duanebeck/Allegro-Lite/README.md

# Allegro-Lite
Information about Mark Drela's sailplane designs
