duanebeck/Allegro-Lite/Photos/README.md

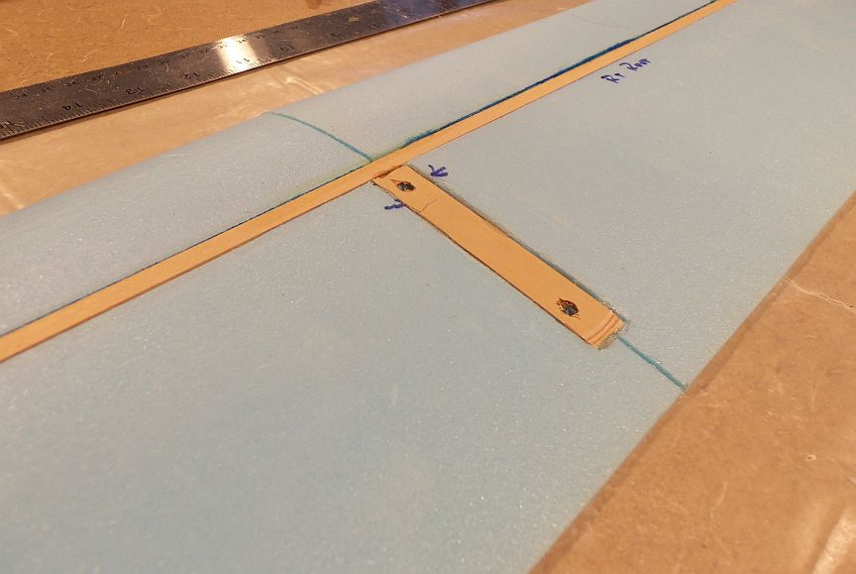
[picture p1: Photos/CENTER+HOLD+DOWN.jpg]
CENTER HOLD DOWN

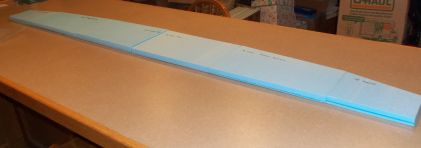
[picture p2: Photos/2MCORES.jpg]
2MCORES

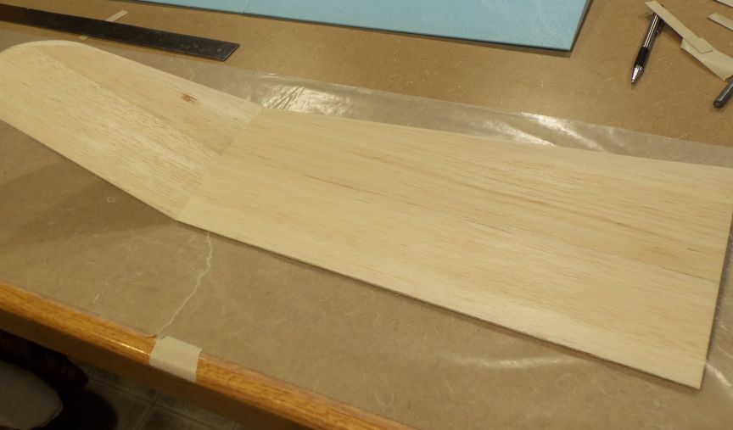
[picture p3: Photos/LEFT+MID+AND+TIP+FINISHED.jpg]
LEFT MID AND TIP FINISHED

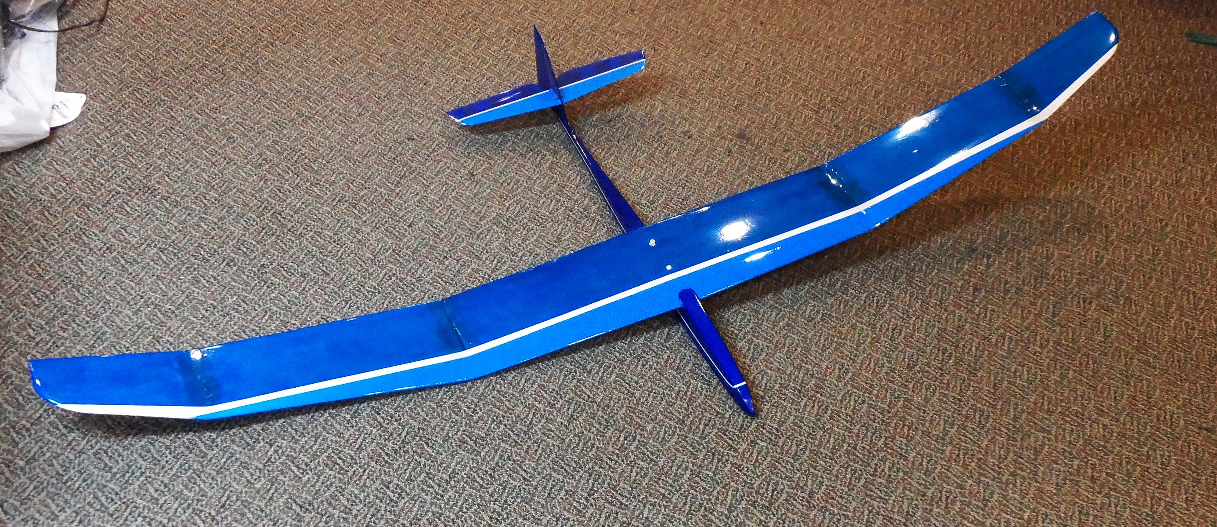
[picture p4: Photos/FINISHED+ON+AIRFRAME.jpg]
FINISHED ON AIRFRAME

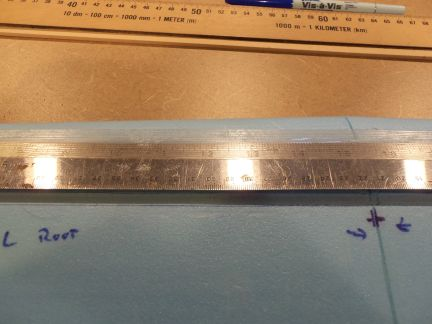
[picture p5: Photos/SPAR+SANDING+GUIDE.jpg]
SPAR SANDING GUIDE

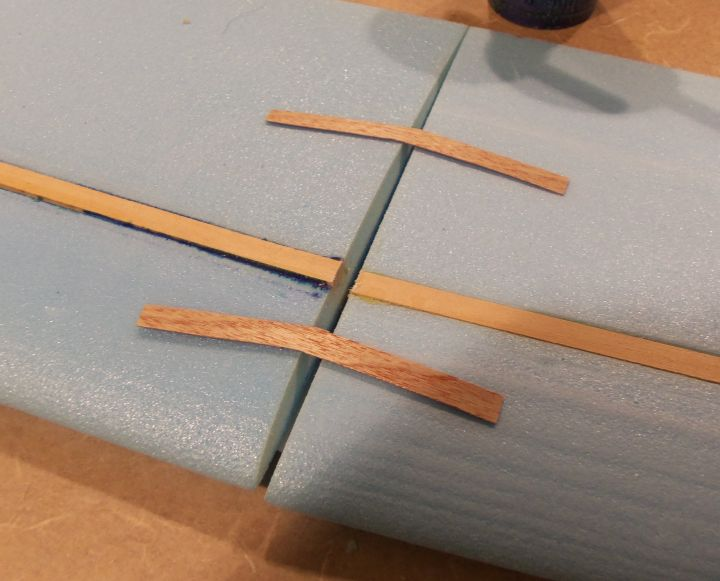
[picture p6: Photos/DIHED+BRACES.jpg]
DIHED BRACES

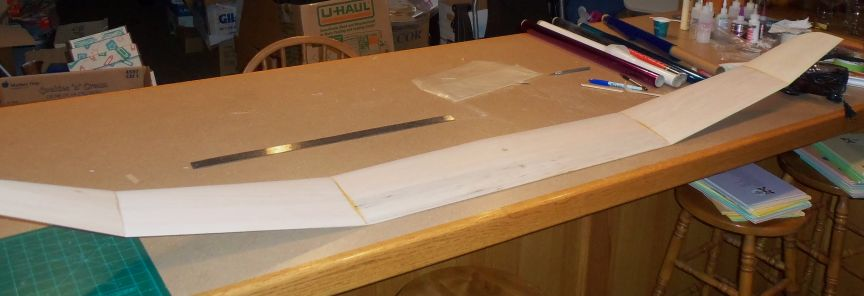
[picture p7: Photos/READY+TO+COVER.jpg]
READY TO COVER

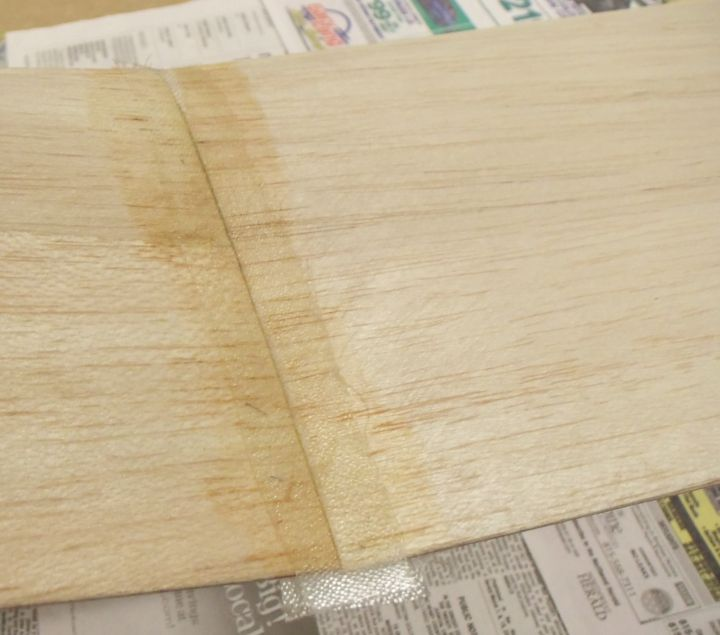
[picture p8: Photos/GLASSED+JOINT.jpg]
GLASSED JOINT

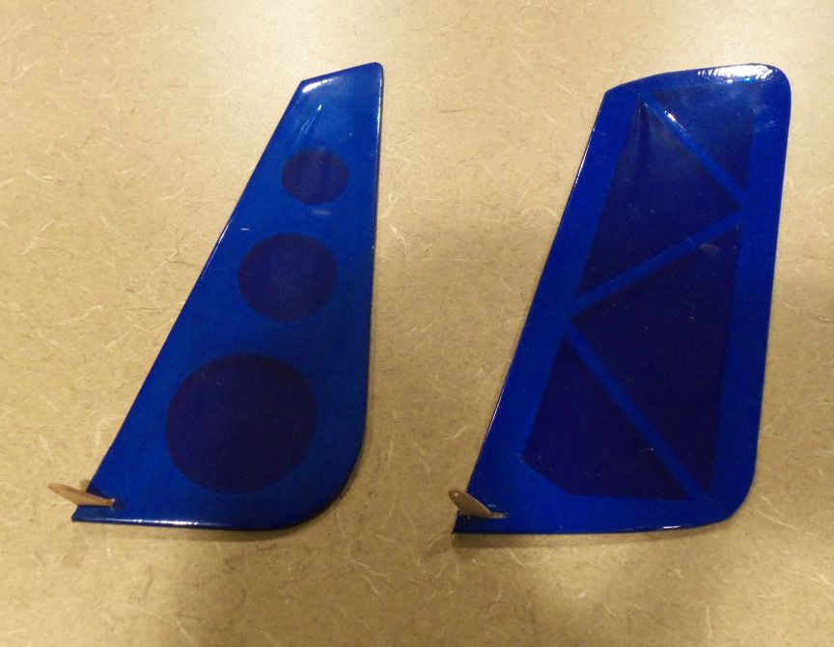
[picture p9: Photos/OLD+AND+NEW+RUDDER.jpg]
OLD AND NEW RUDDER

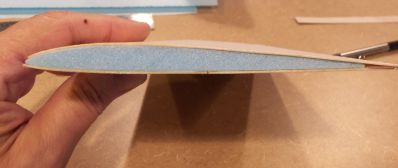
[picture p10: Photos/RT+TIP+SIDE+VIEW.jpg]
RT TIP SIDE VIEW

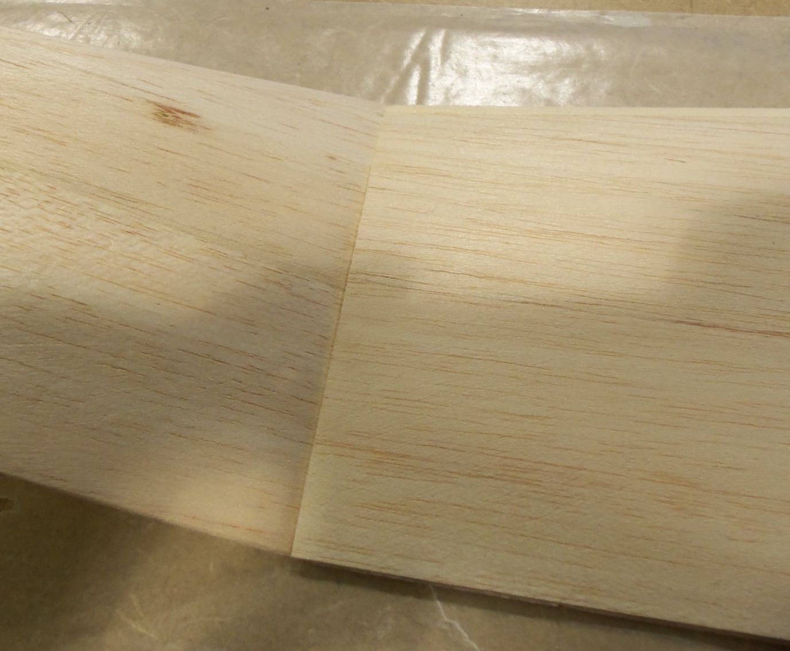
[picture p11: Photos/SANDING+DETAIL.jpg]
SANDING DETAIL

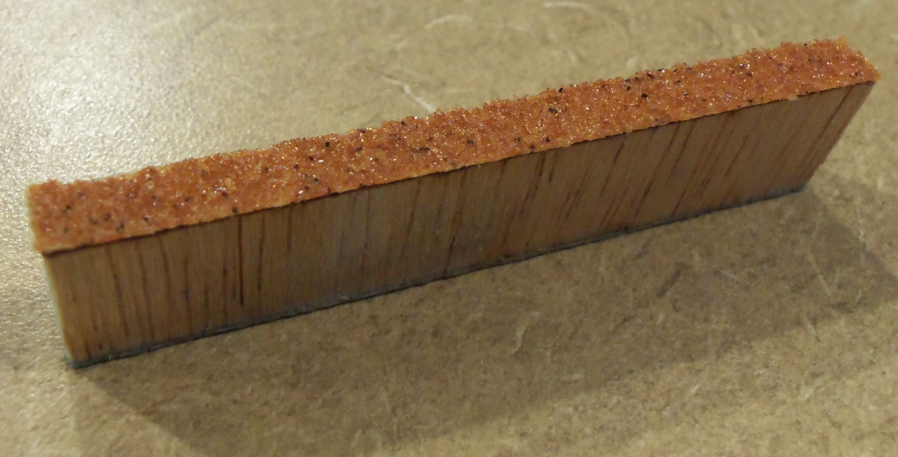
[picture p12: Photos/SLOT+SANDER.jpg]
SLOT SANDER

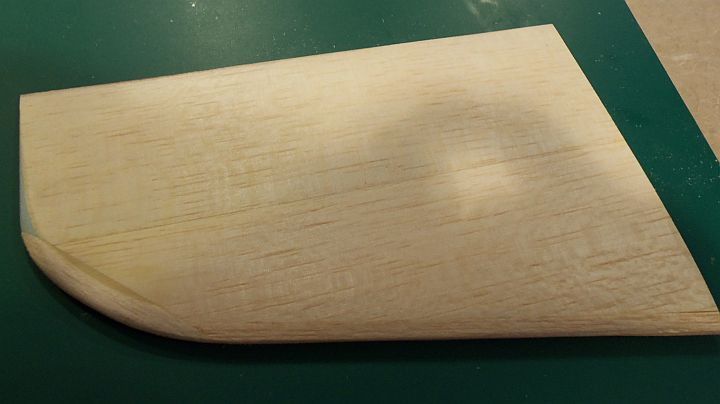
[picture p13: Photos/FINISHED+TIP.jpg]
FINISHED TIP

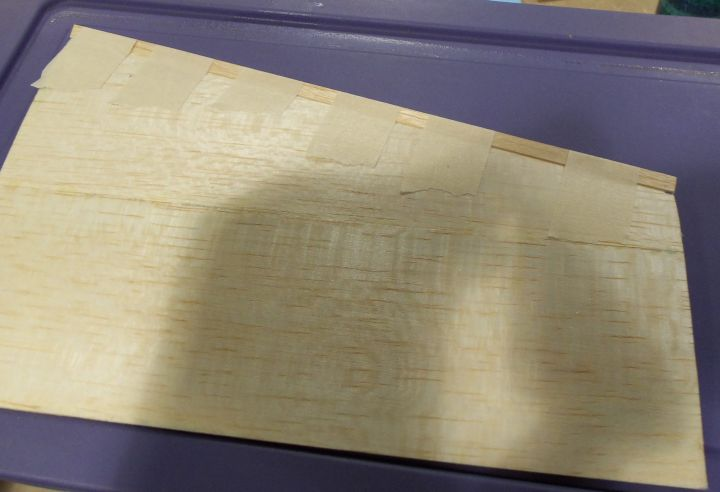
[picture p14: Photos/TIP+WITH+LE+ATTACHED.jpg]
TIP WITH LE ATTACHED

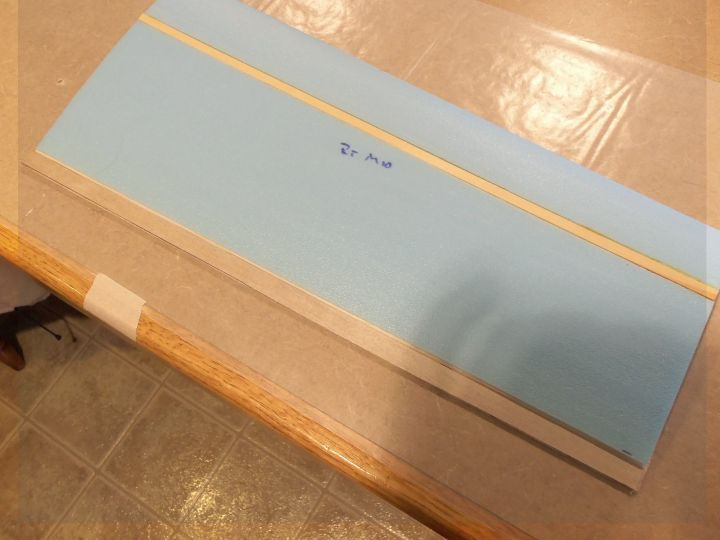
[picture p15: Photos/SPAR+AND+PLY+TE.jpg]
SPAR AND PLY TE

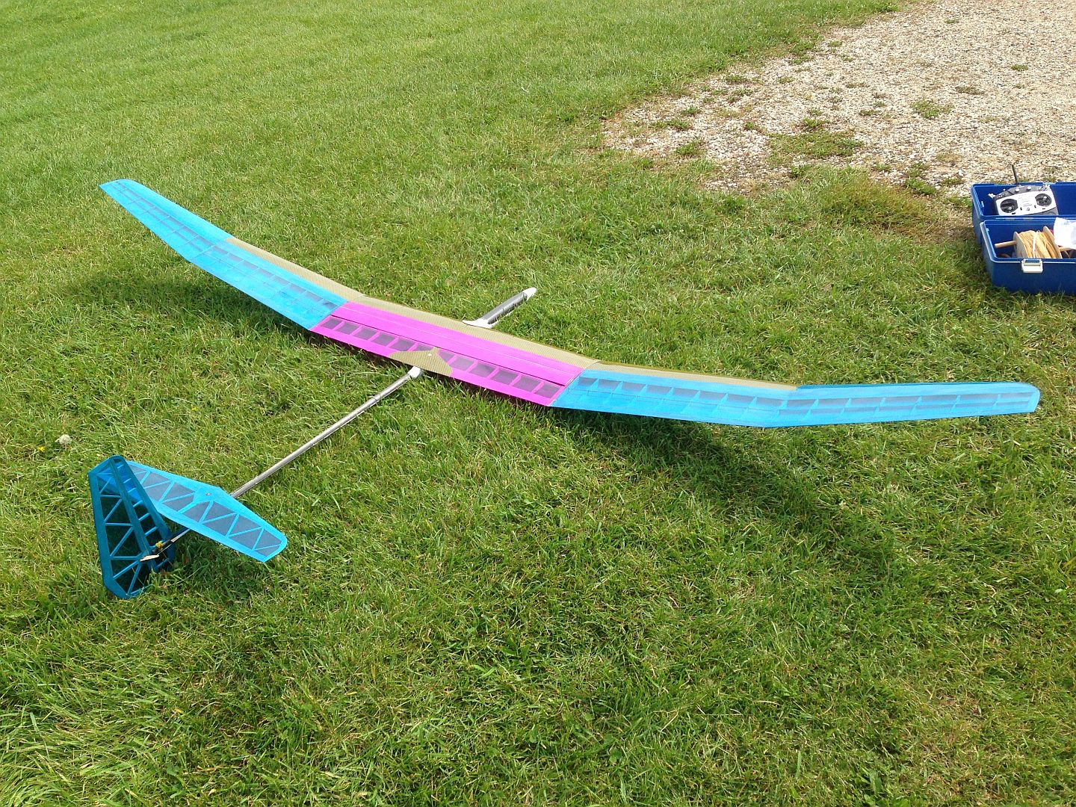
[picture p16: Photos/Bubble+Dancer.jpg]
Bubble Dancer

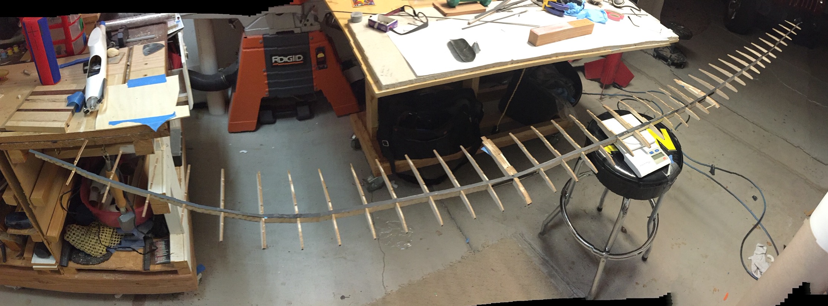
[picture p17: Photos/FullSizeRender.jpg]
FullSizeRender

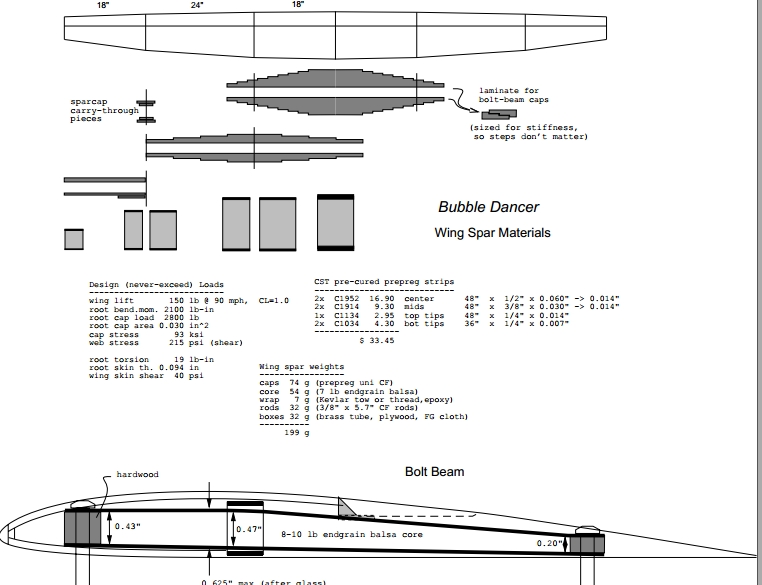
[picture p18: Photos/spars.jpg]
spars

Bubble Dancer (1)
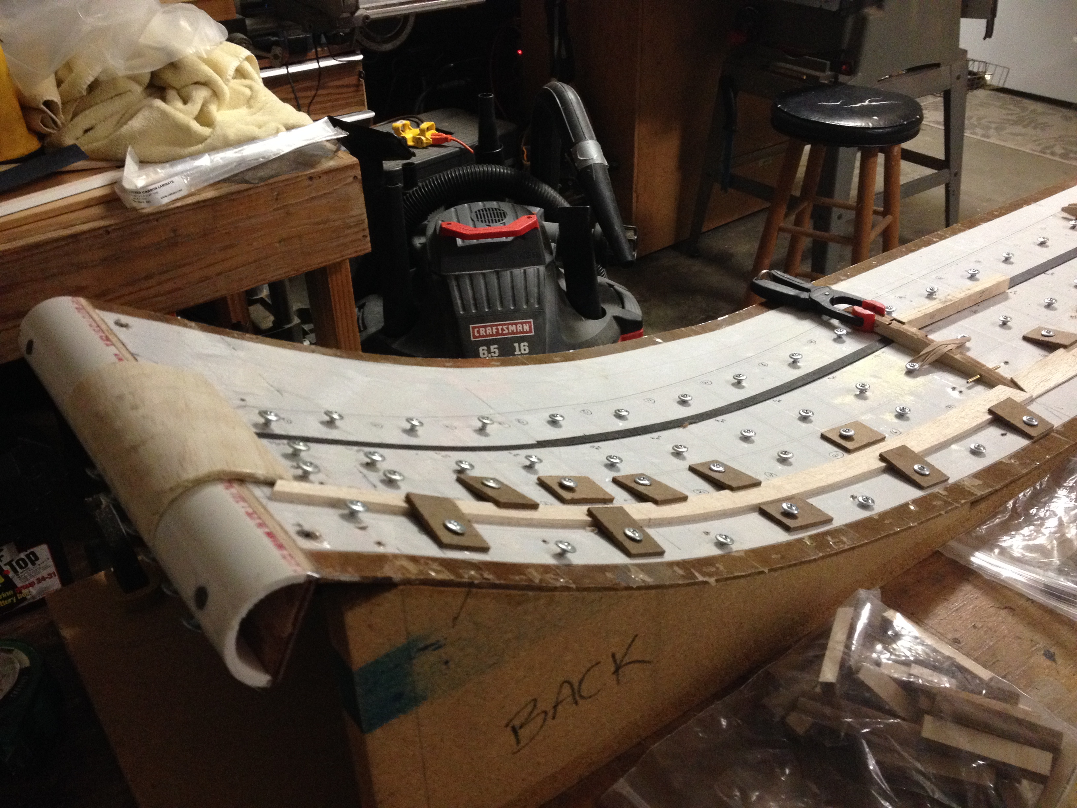
[picture p19: Photos/IMG_0997.jpg]

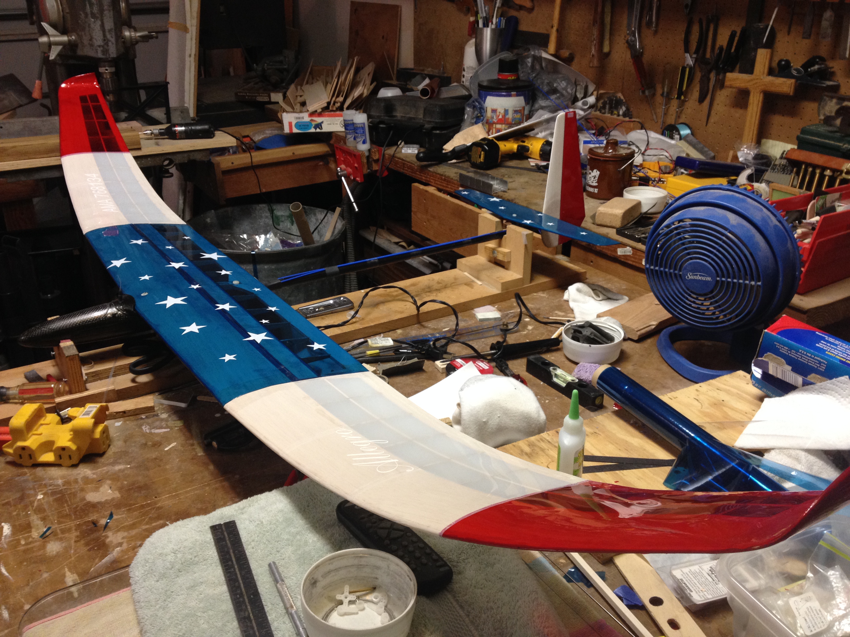
[picture p20: Photos/IMG_1051.jpg]

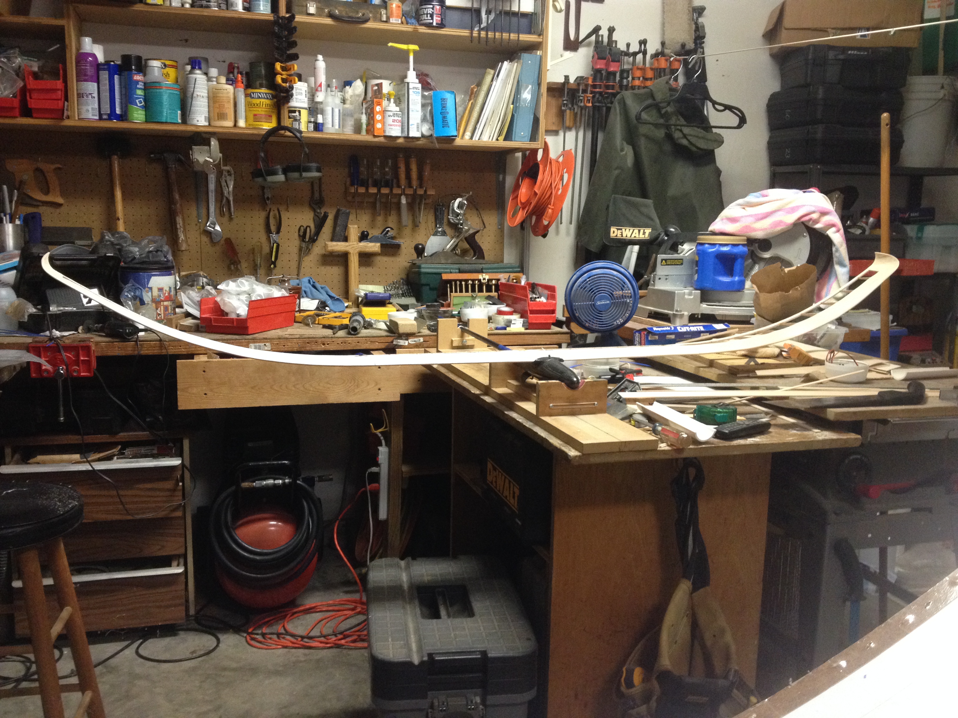
[picture p21: Photos/IMG_1042.jpg]

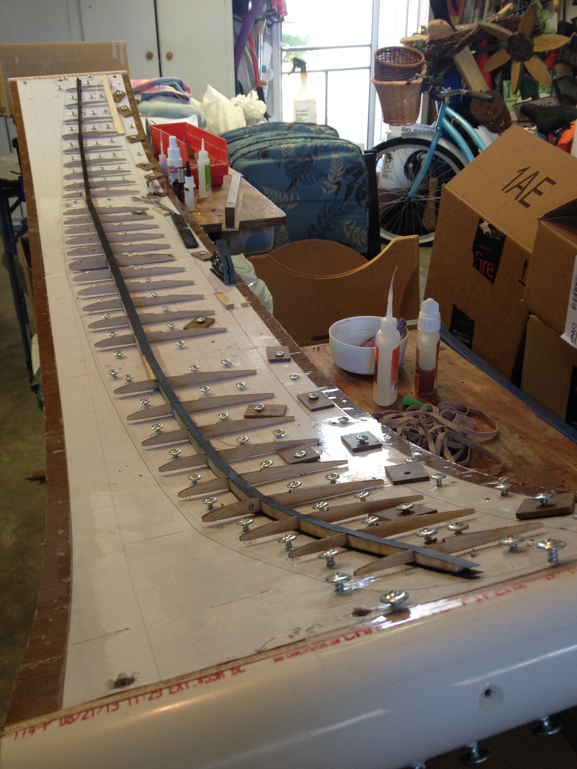
[picture p22: Photos/IMG_1009.jpg]


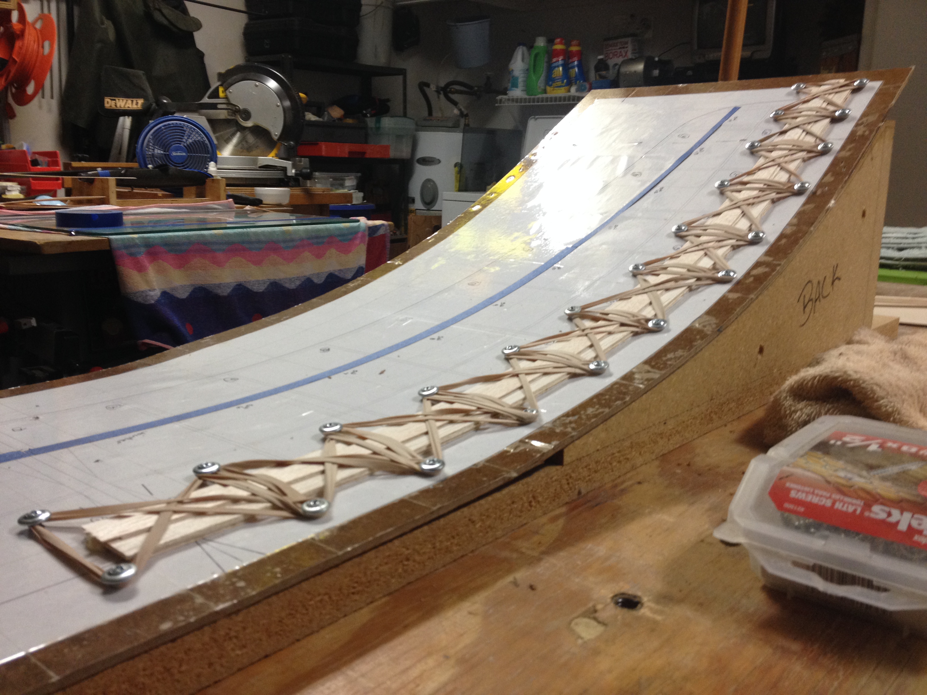
[picture p23: Photos/IMG_0994.jpg]

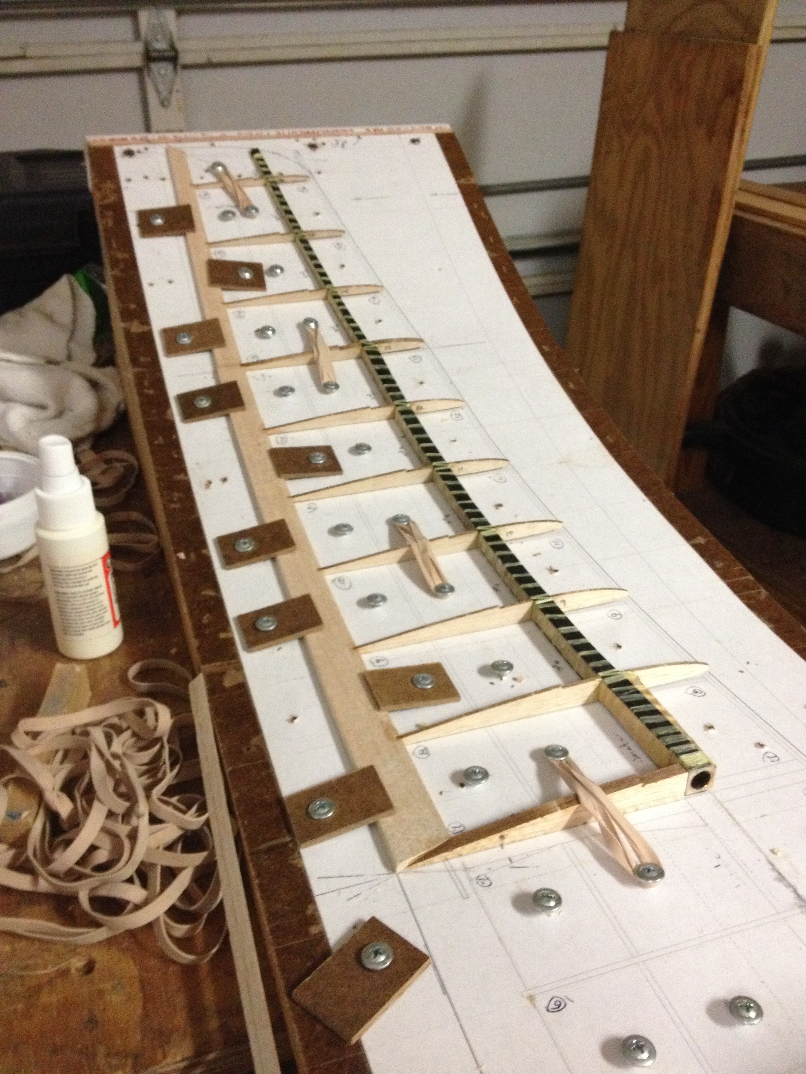
[picture p24: Photos/IMG_1021.jpg]


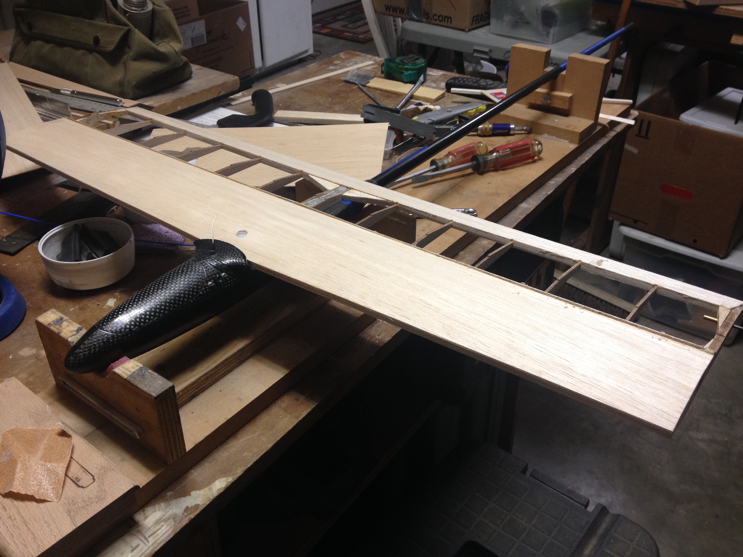
[picture p25: Photos/IMG_1037.jpg]

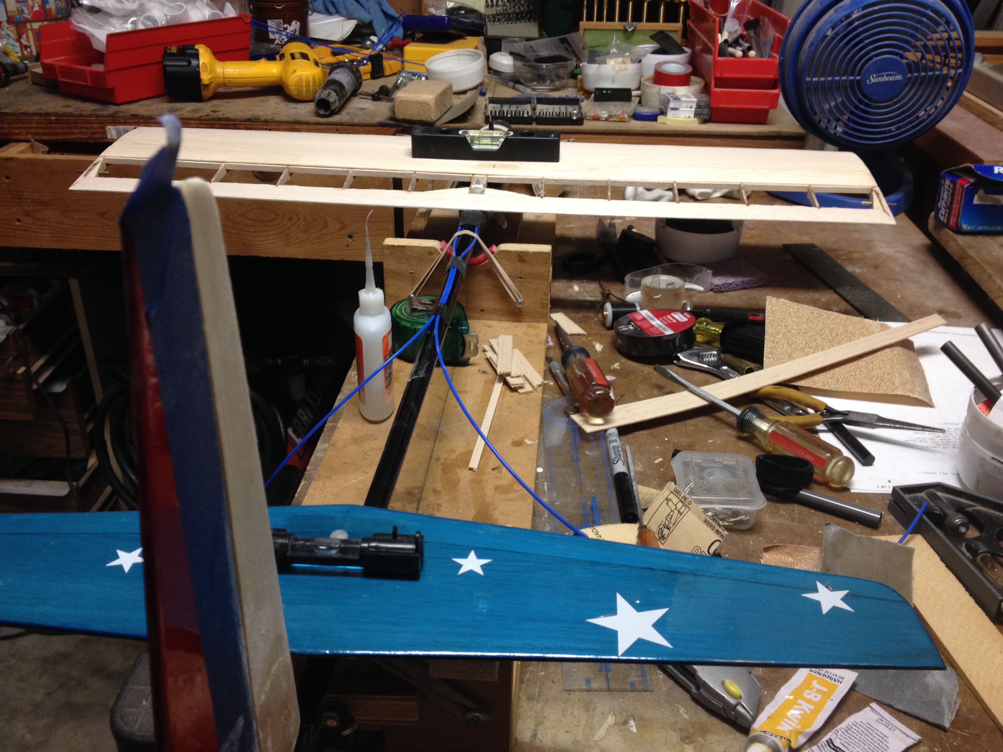
[picture p26: Photos/IMG_1045.jpg]

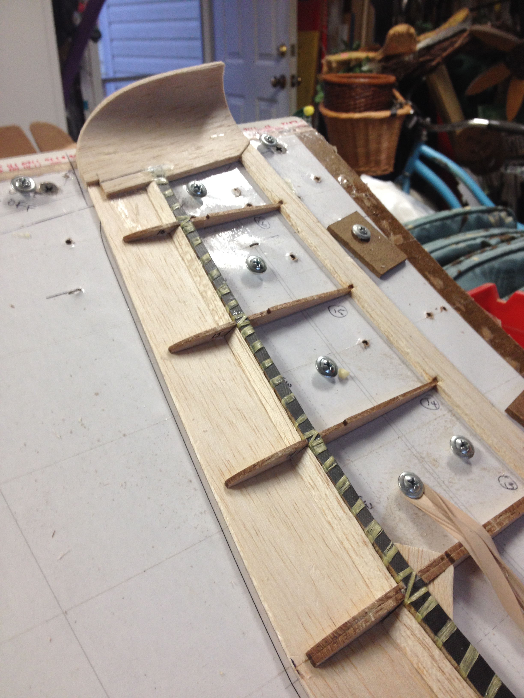
[picture p27: Photos/IMG_1035.jpg]

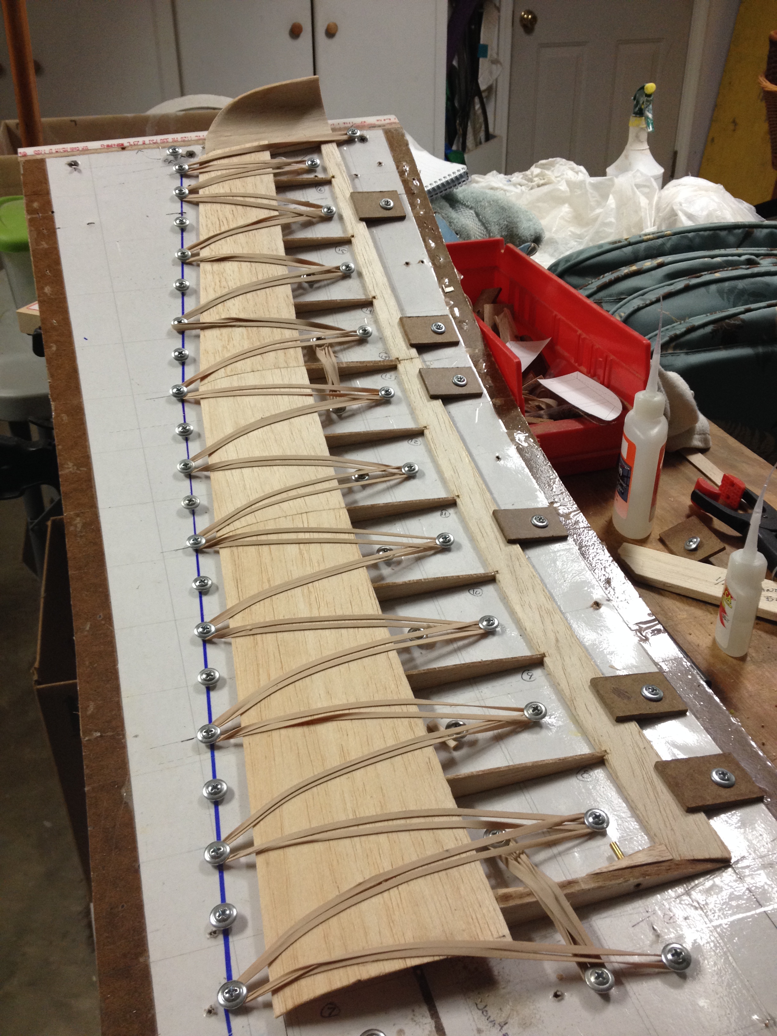
[picture p28: Photos/IMG_1036.jpg]

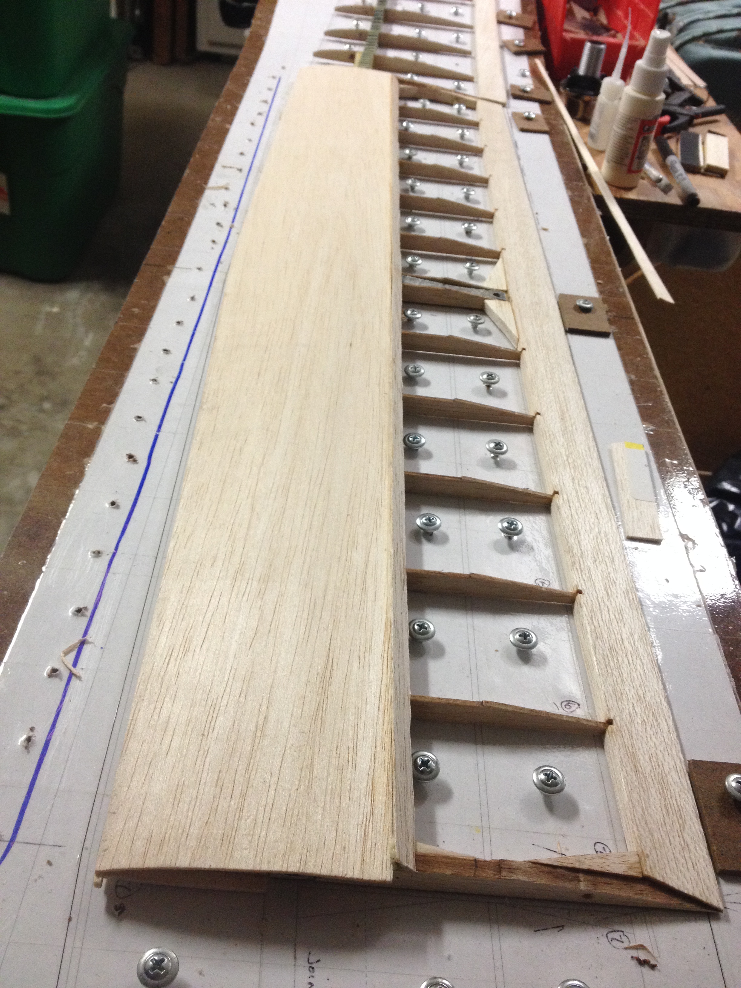
[picture p29: Photos/IMG_1018.jpg]

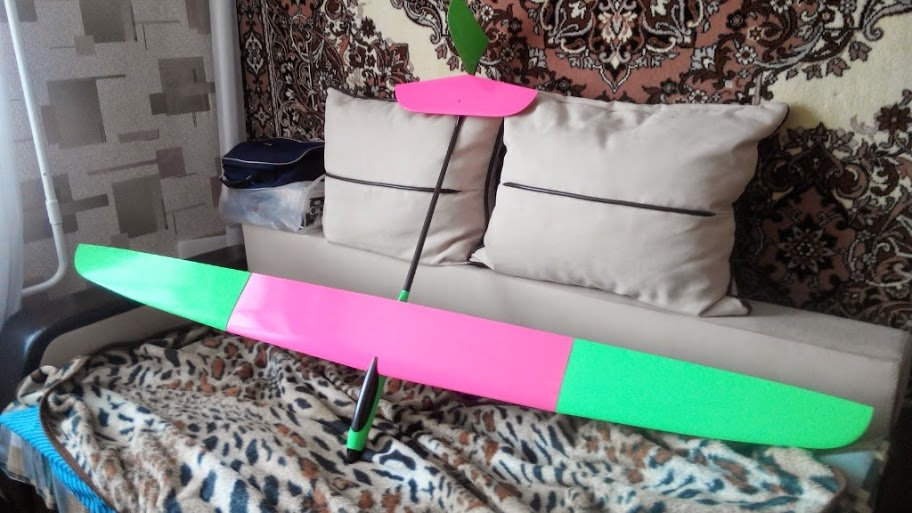
[picture p30: Photos/allegra-1.jpg]
allegra-1

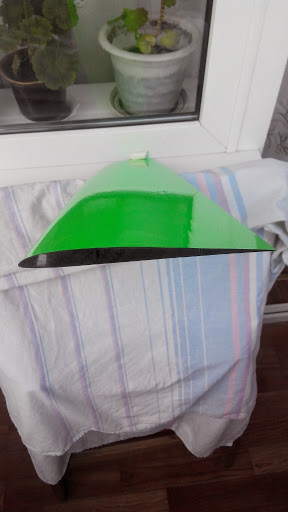
[picture p31: Photos/allegra-1+prof+ag+-41.jpg]
allegra-1 prof ag -41


DSCN2304
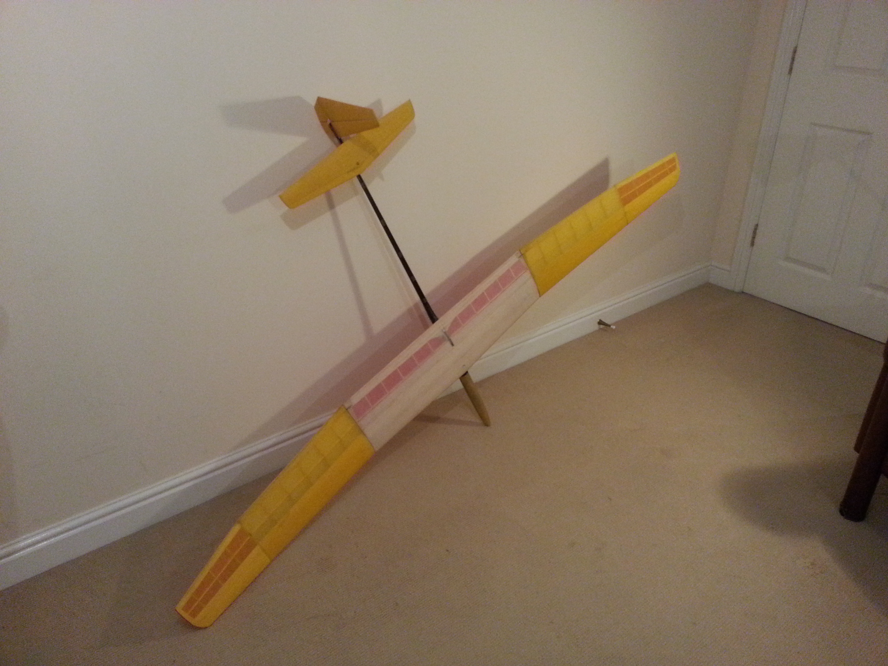
[picture p32: Photos/20140928_210820.jpg]

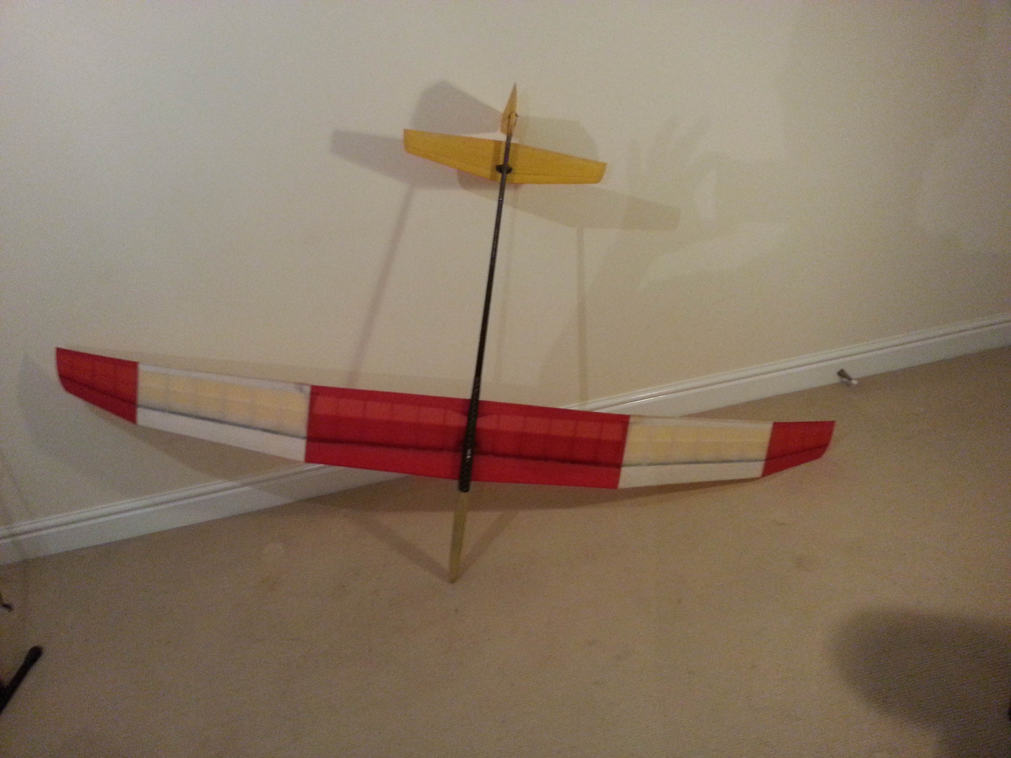
[picture p33: Photos/20140928_210901.jpg]

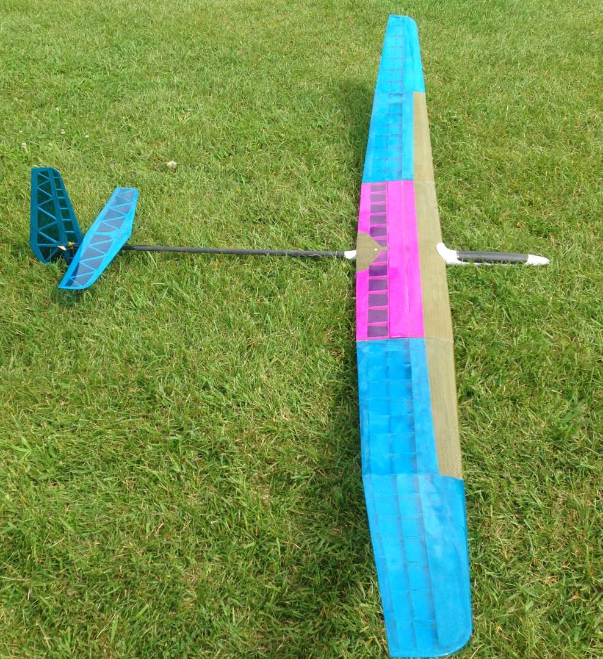
[picture p34: Photos/bd2.jpg]
bd2

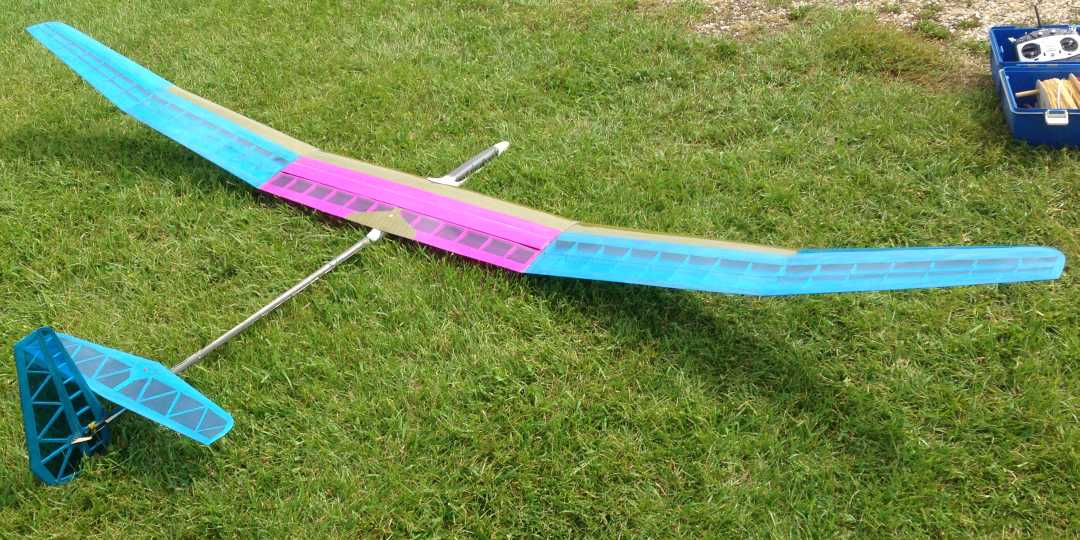
[picture p35: Photos/bd3.jpg]
bd3

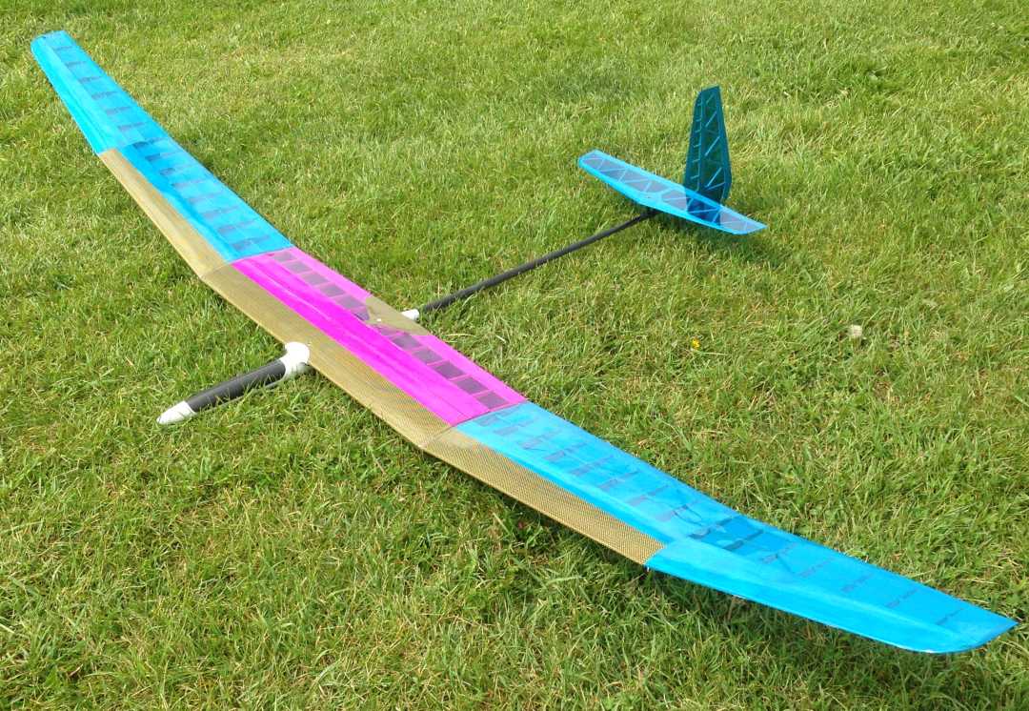
[picture p36: Photos/bd5.jpg]
bd5

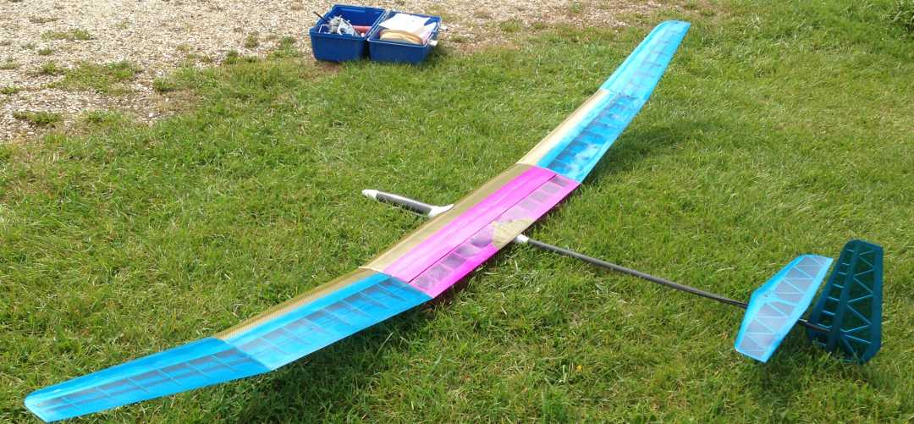
[picture p37: Photos/bd4.jpg]
bd4

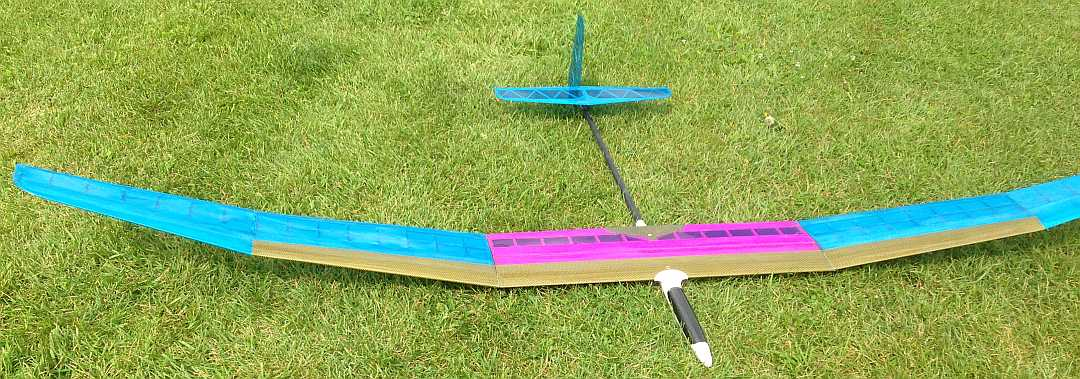
[picture p38: Photos/bd1.jpg]
bd1

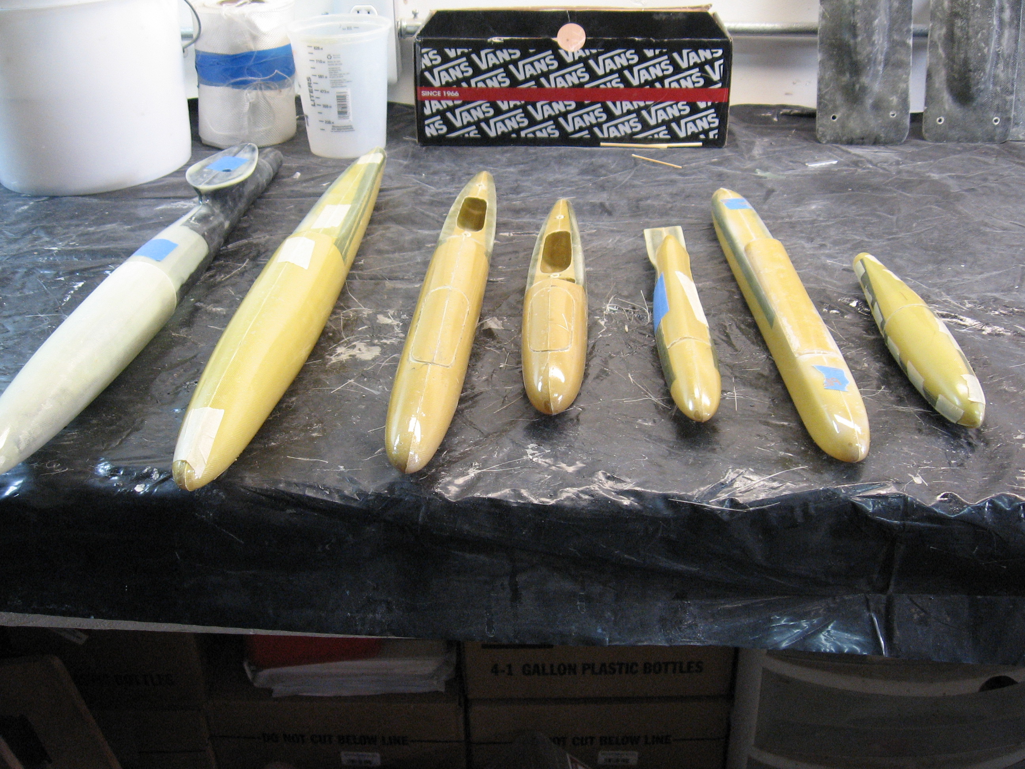
[picture p39: Photos/glider+pods+072+(2).jpg]
glider pods 072 (2)

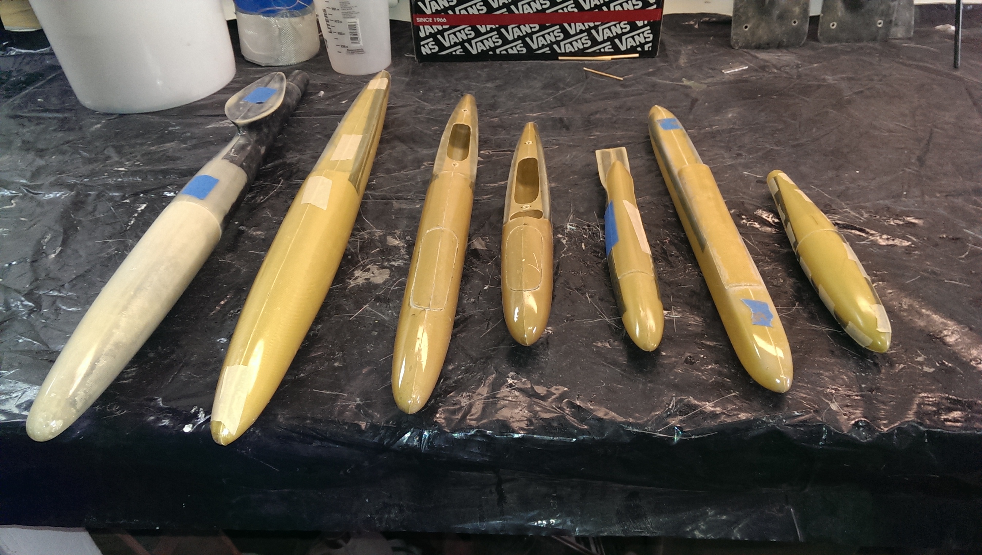
[picture p40: Photos/unknown.jpg]
unknown

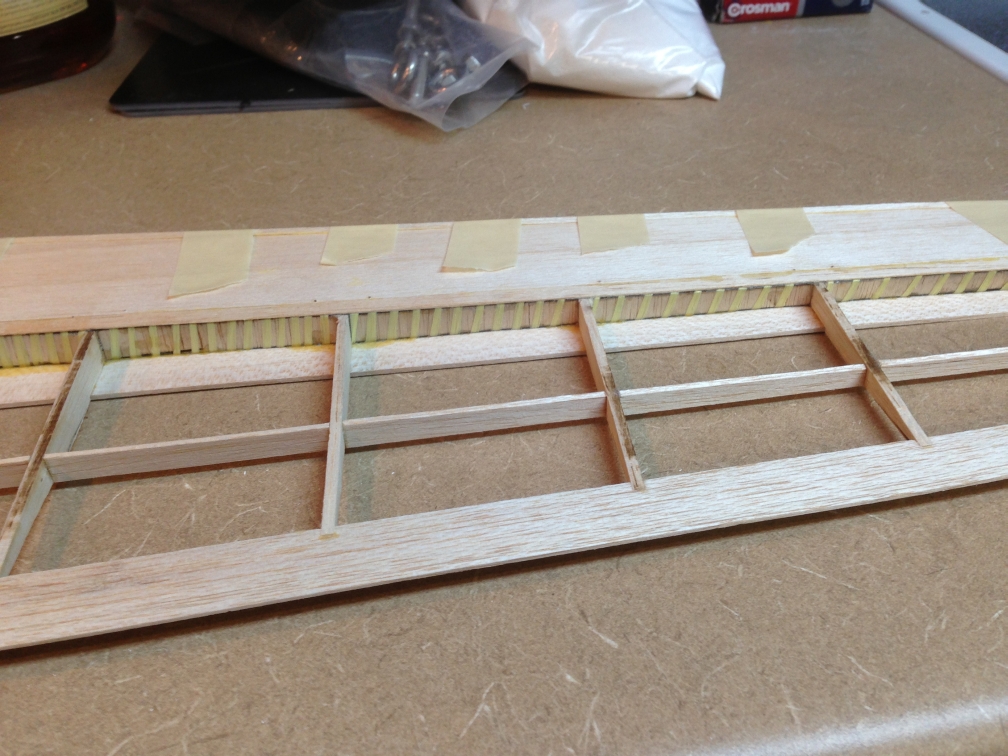
[picture p41: Photos/BD+TIP+FIN+UNDERSIDE.jpg]
BD TIP FIN UNDERSIDE

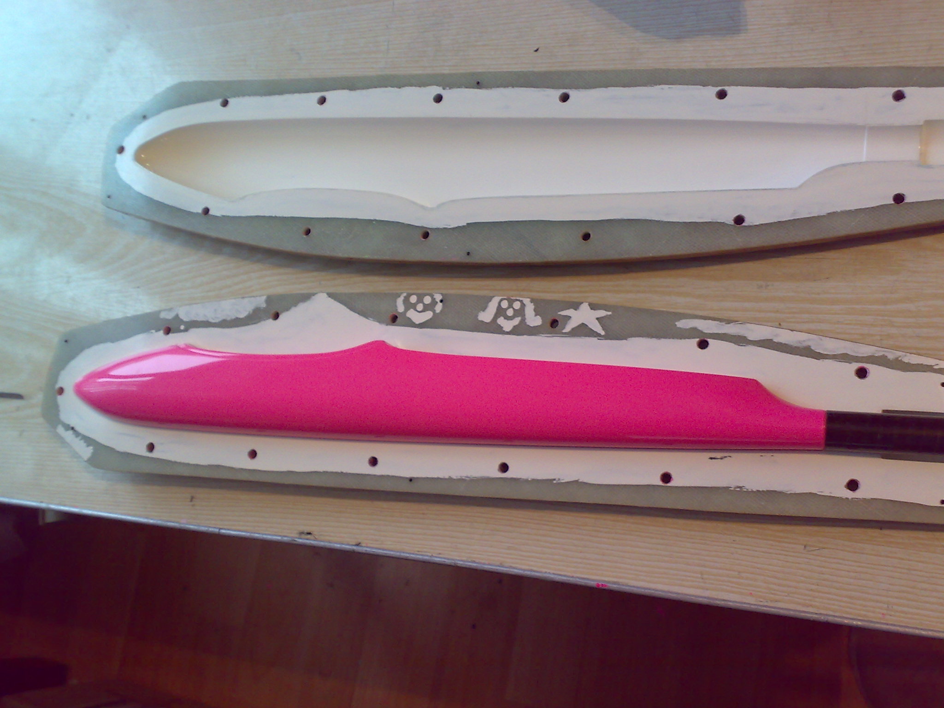
[picture p42: Photos/301220131392.jpg]

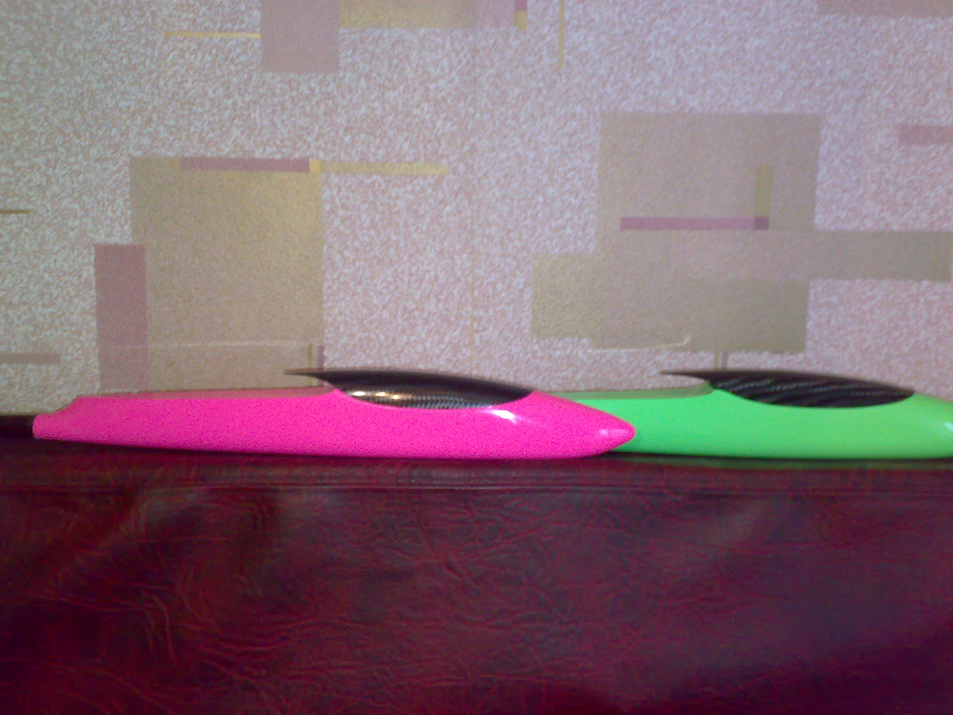
[picture p43: Photos/301220131389.jpg]

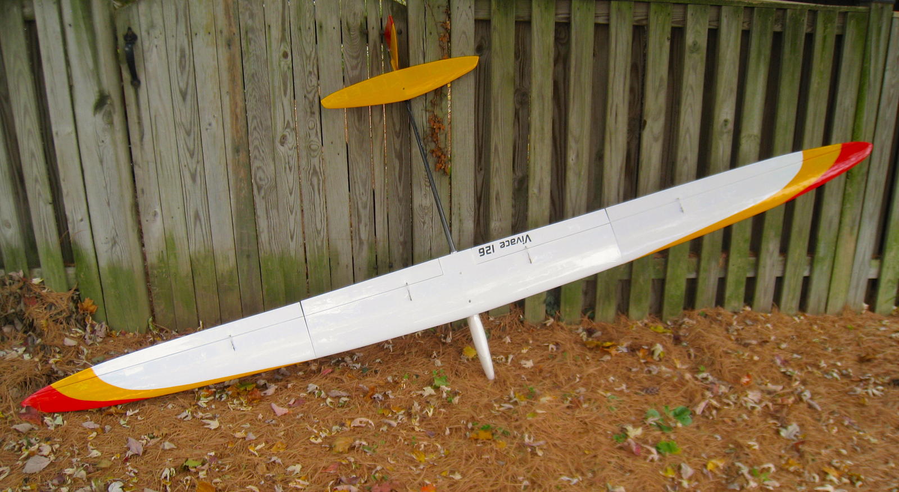
[picture p44: Photos/a6264289-44-a6261991-101-IMG_3870.jpg]
a6264289-44-a6261991-101-IMG_3870

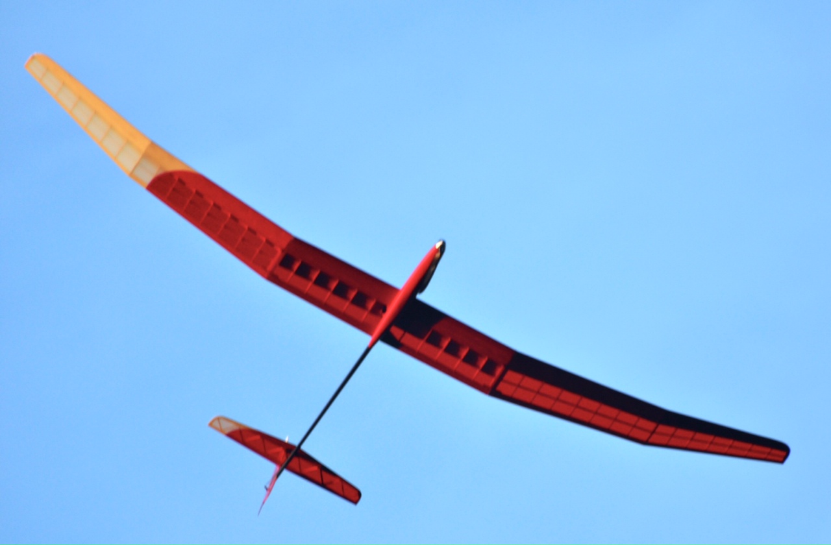
[picture p45: Photos/photo.jpg]

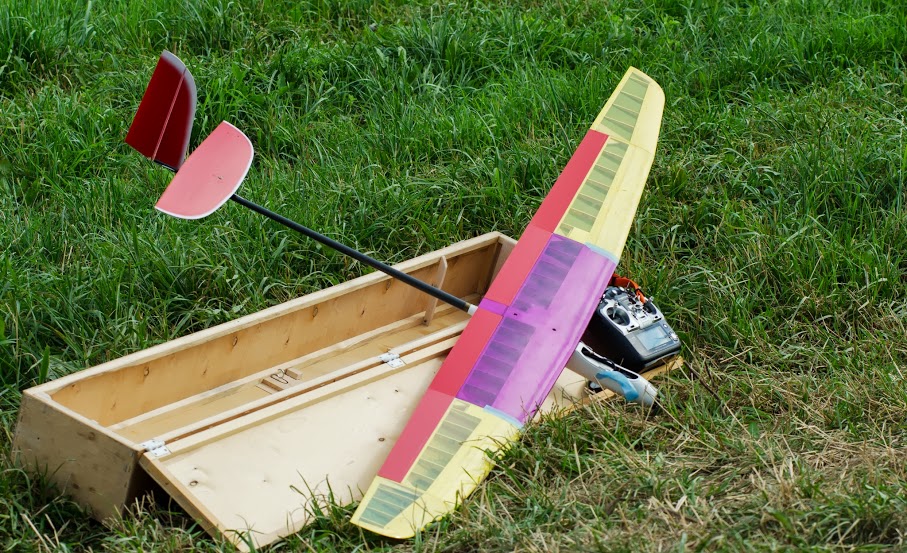
[picture p46: Photos/ART_2615.jpg]
ART_2615

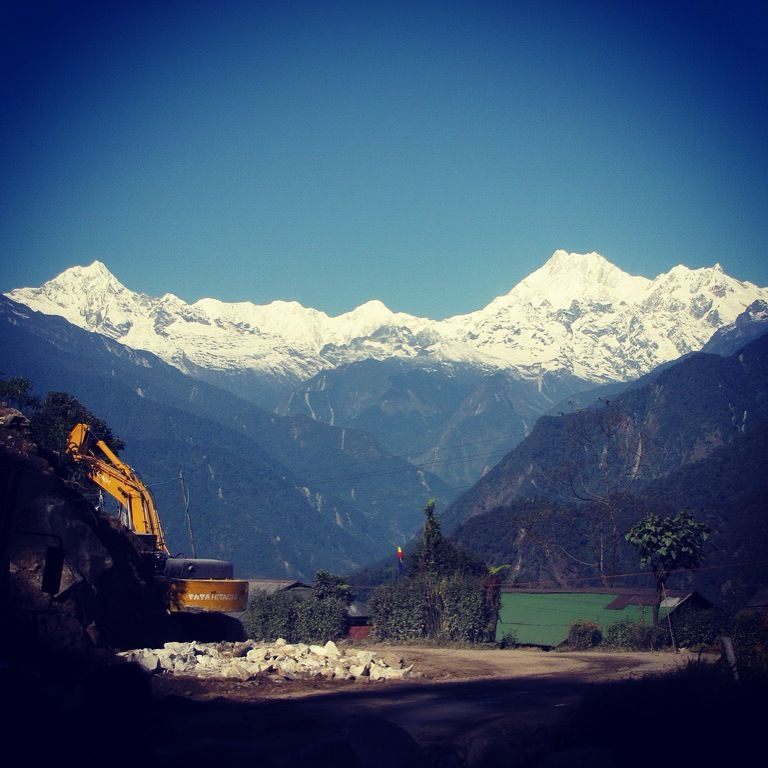
[picture p47: Photos/K3+IMG_0061.jpg]
K3 IMG_0061

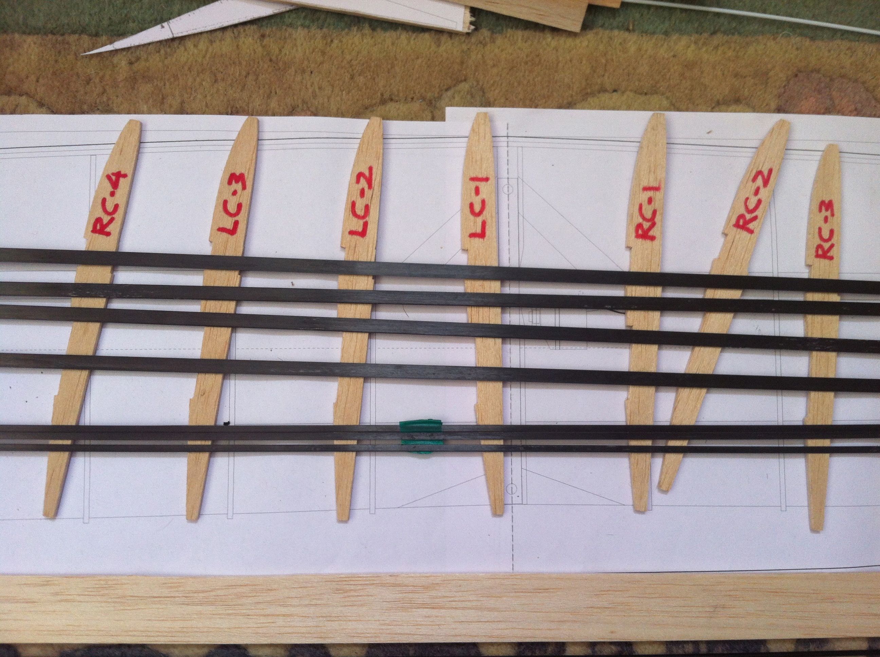
[picture p48: Photos/IMG_0073.jpg]

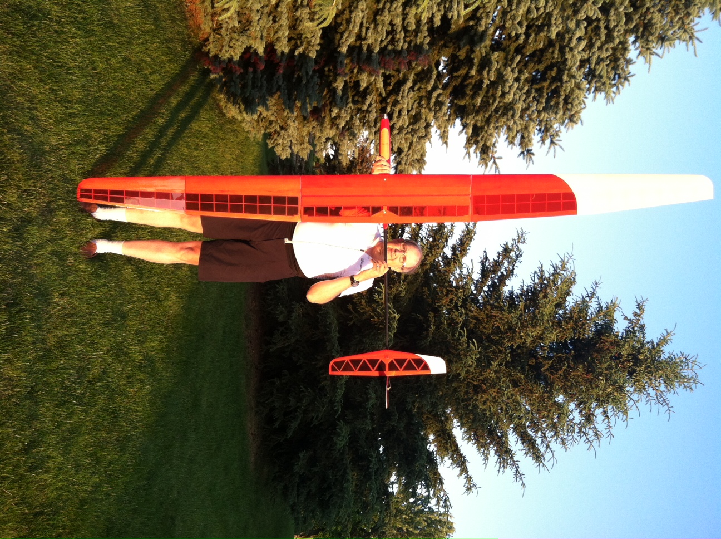
[picture p49: Photos/photo (1).jpg]
photo (1)

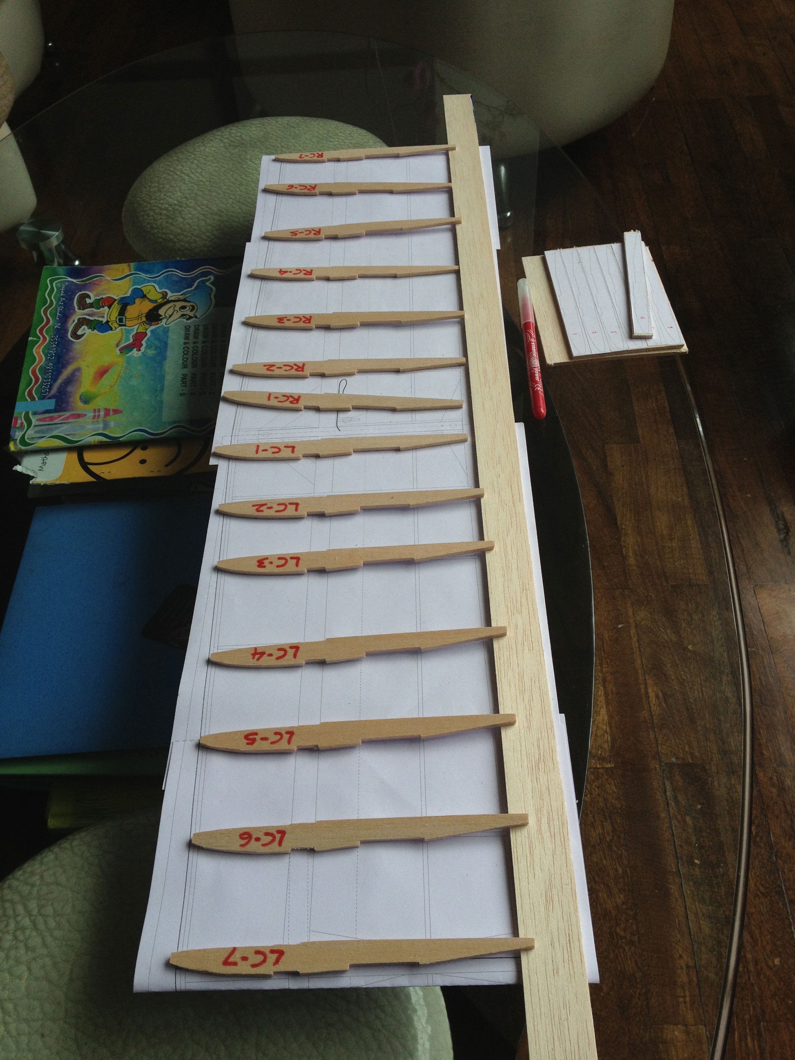
[picture p50: Photos/IMG_1146.jpg]

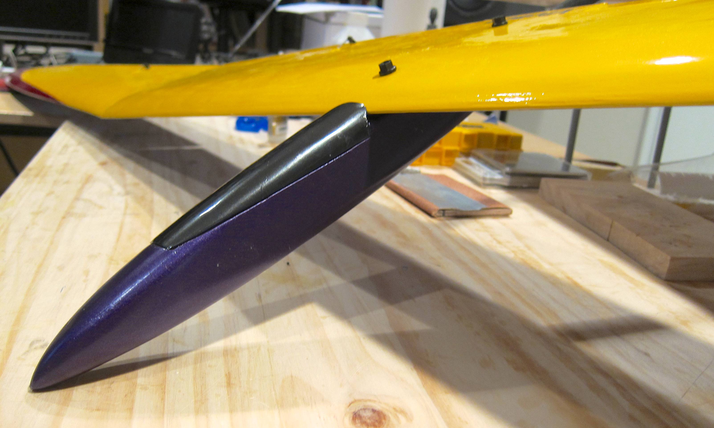
[picture p51: Photos/IMG_2610.jpg]

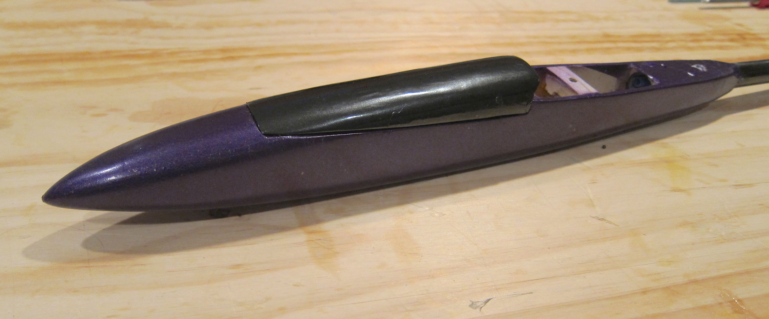
[picture p52: Photos/IMG_2616.jpg]

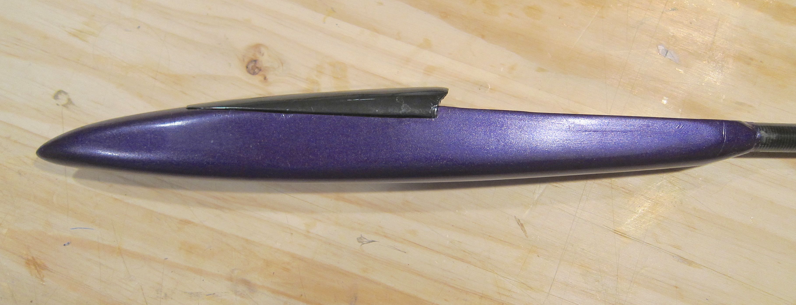
[picture p53: Photos/IMG_2617.jpg]


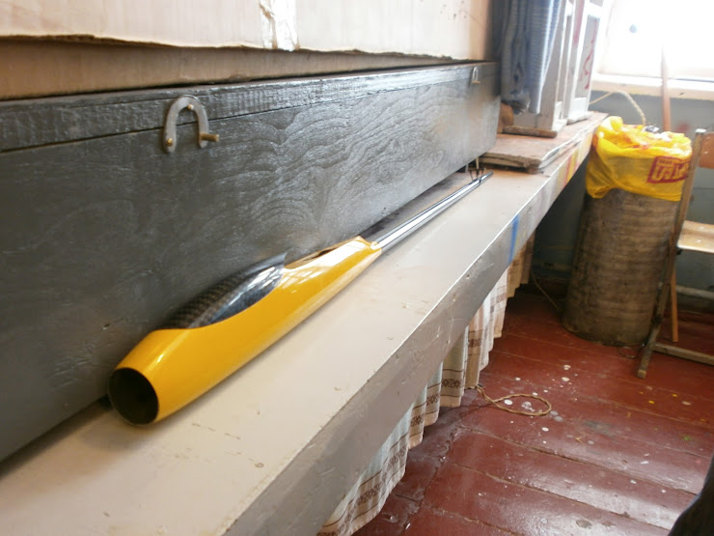
[picture p54: Photos/P2250832.jpg]
P2250832

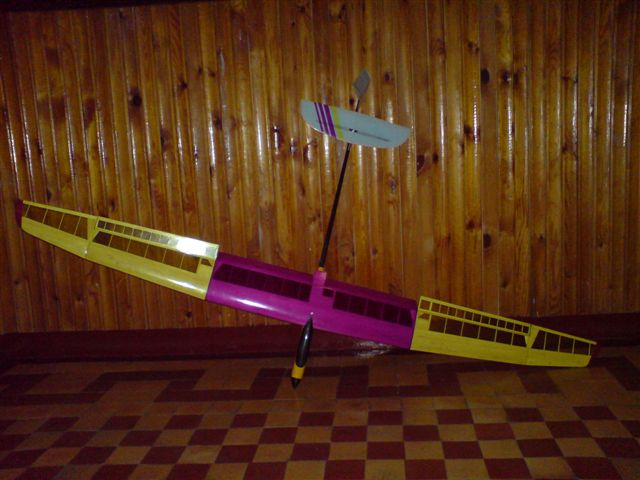
[picture p55: Photos/DSC00961.jpg]

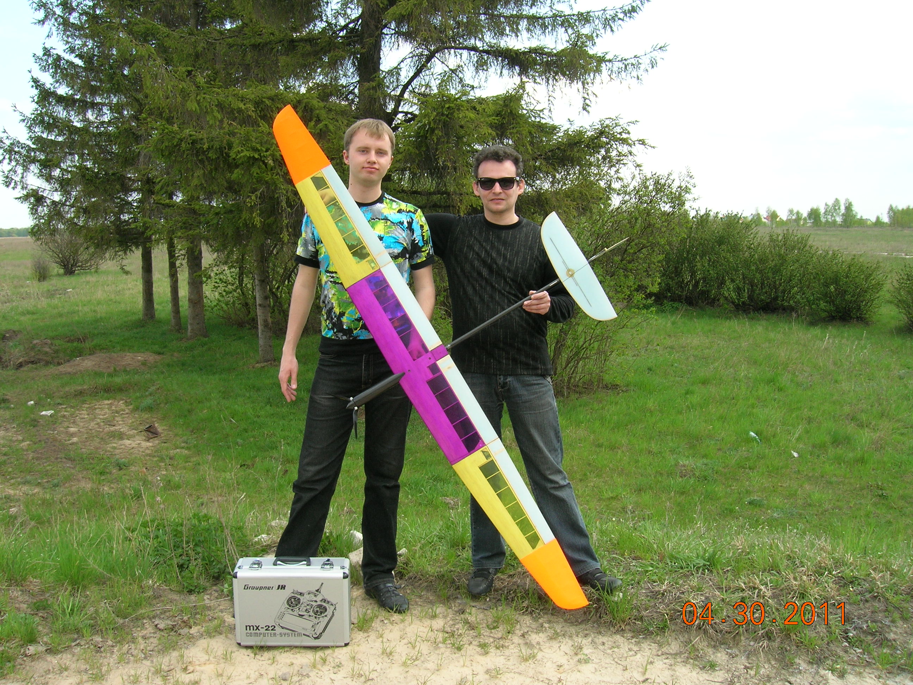
[picture p56: Photos/DSCN4541.jpg]
DSCN4541

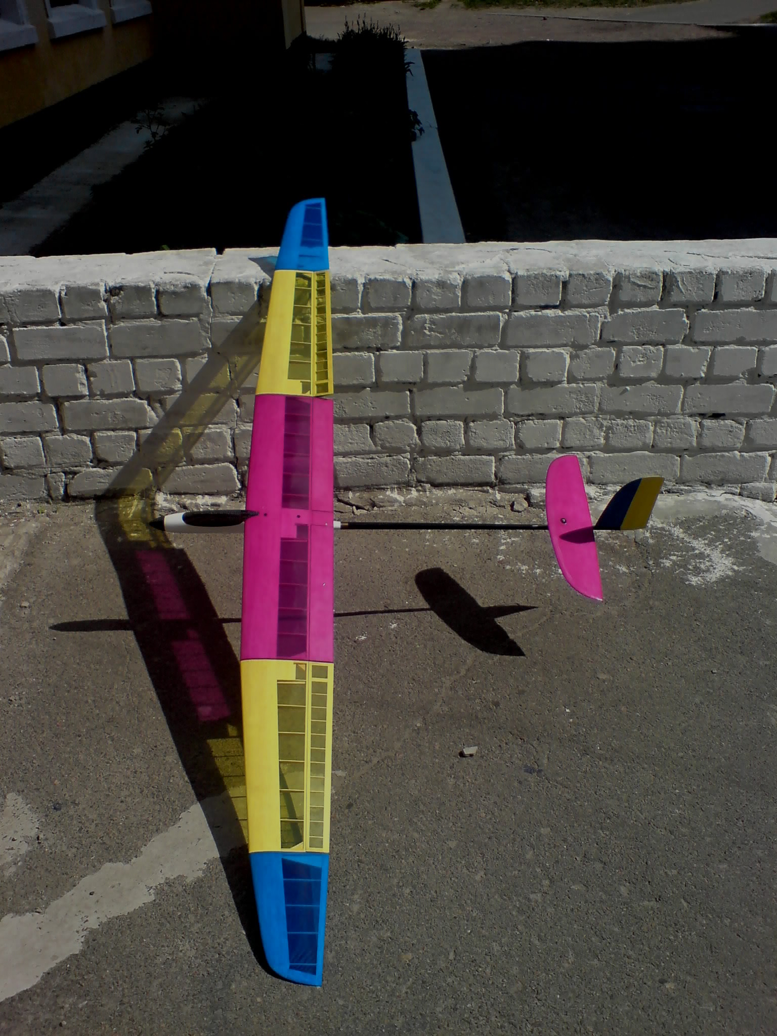
[picture p57: Photos/DSC00795-001.jpg]

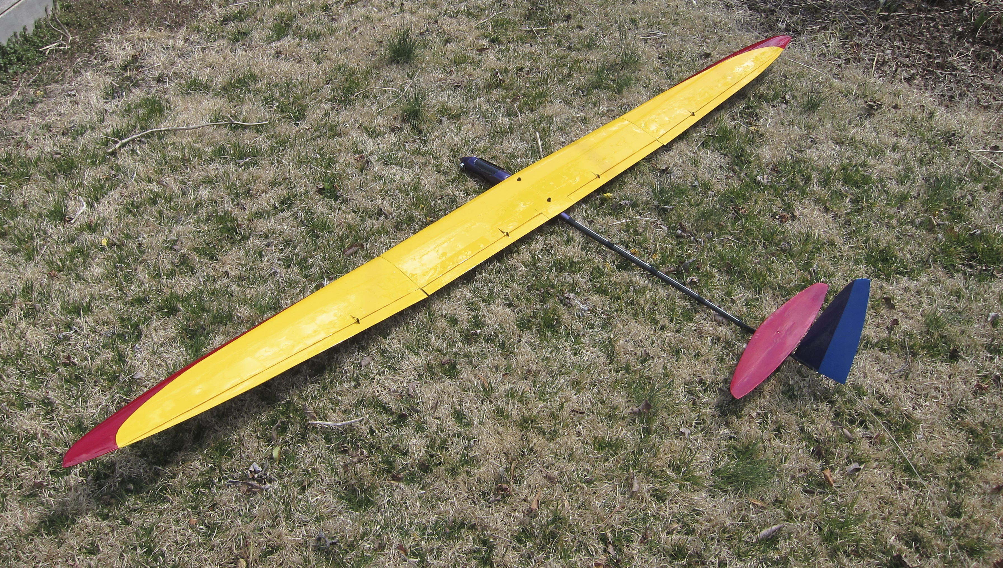
[picture p58: Photos/IMG_2414.jpg]

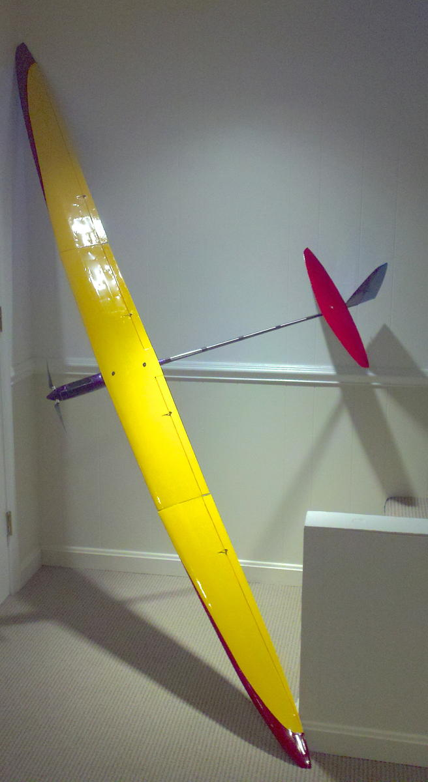
[picture p59: Photos/a5650586-134-2013-03-27_17-54-45_563.jpg]
a5650586-134-2013-03-27_17-54-45_563

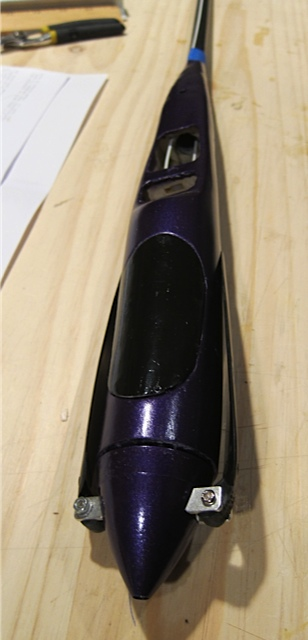
[picture p60: Photos/IMG_2396.jpg]

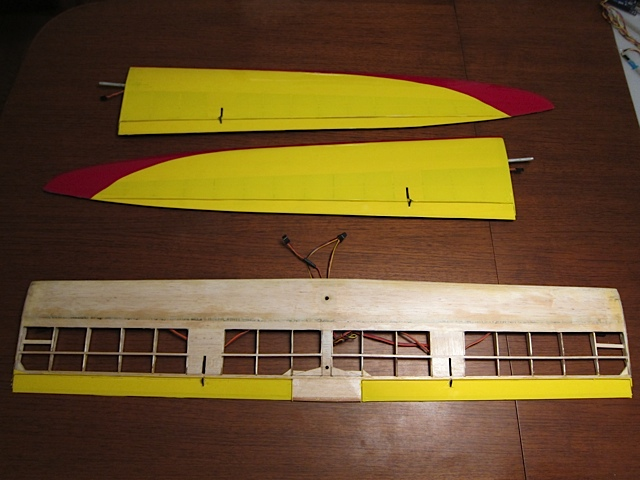
[picture p61: Photos/IMG_2400.jpg]

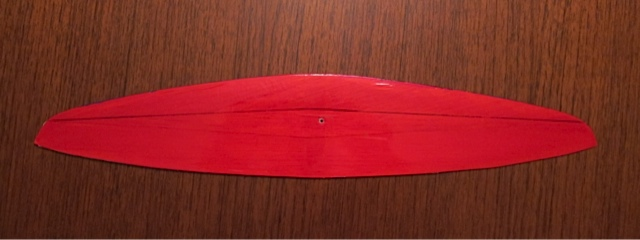
[picture p62: Photos/IMG_2399.jpg]

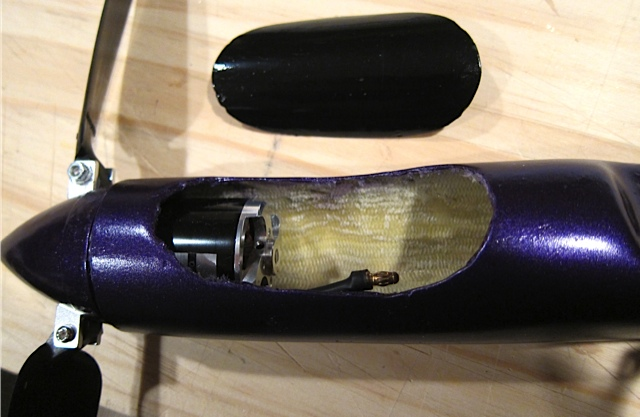
[picture p63: Photos/IMG_2393.jpg]

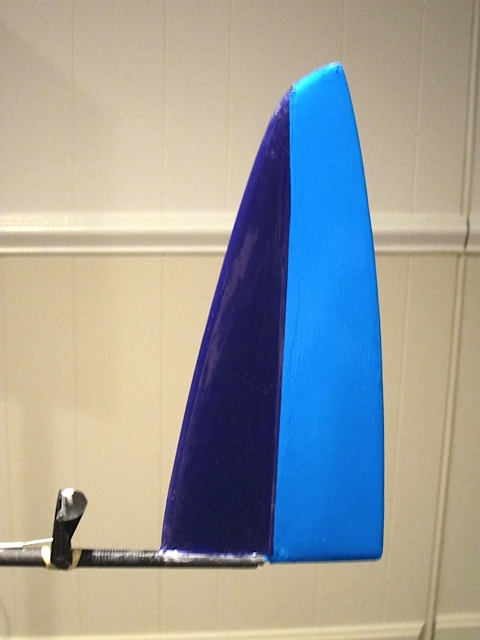
[picture p64: Photos/IMG_2398.jpg]

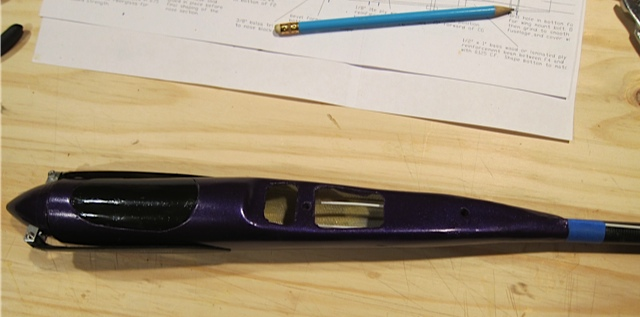
[picture p65: Photos/IMG_2394.jpg]

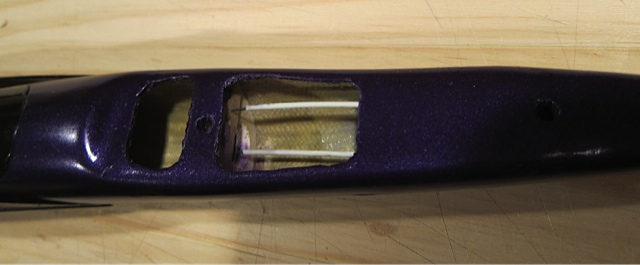
[picture p66: Photos/IMG_2395.jpg]

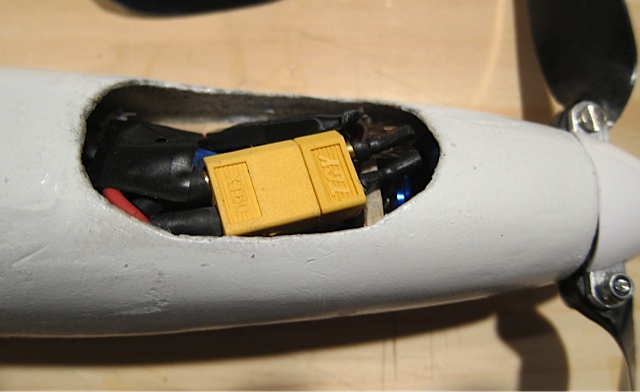
[picture p67: Photos/IMG_2388.jpg]

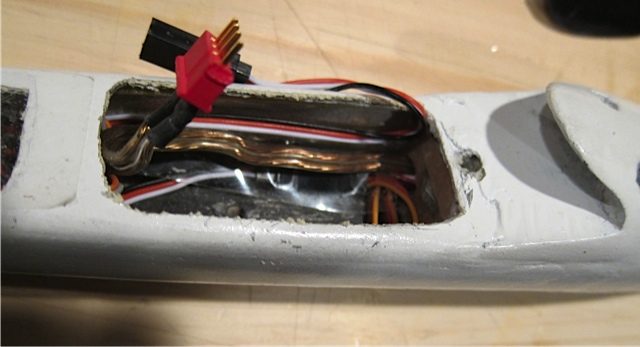
[picture p68: Photos/IMG_2389.jpg]

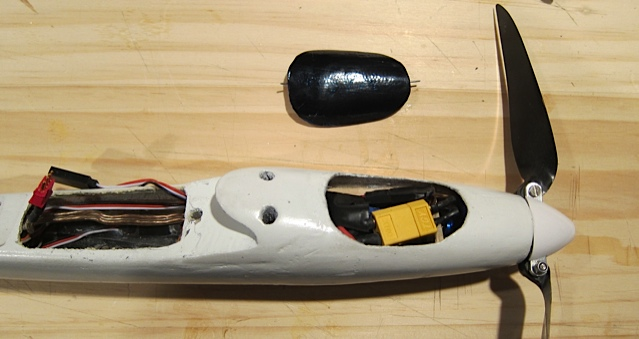
[picture p69: Photos/IMG_2387.jpg]

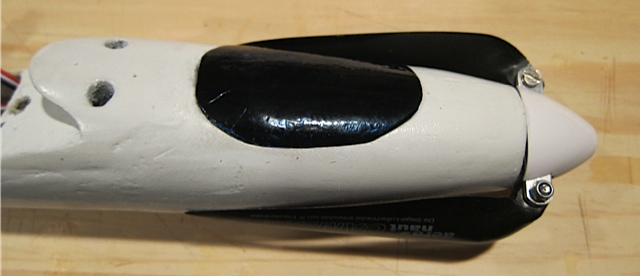
[picture p70: Photos/IMG_2390.jpg]

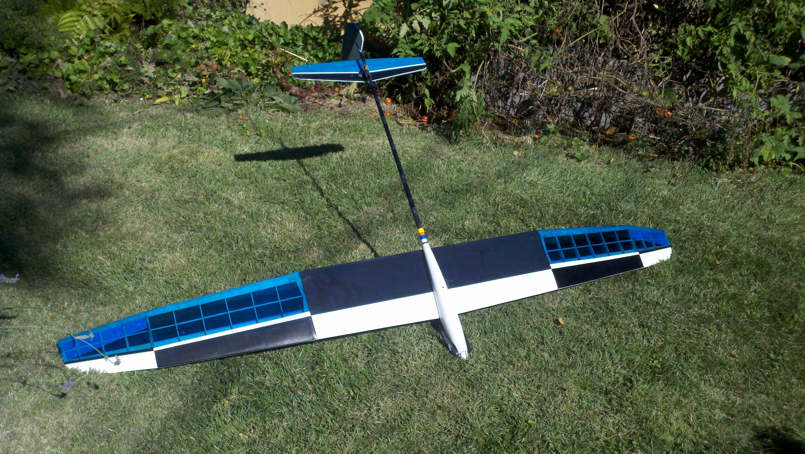
[picture p71: Photos/AL+electric+4.jpg]
AL electric 4

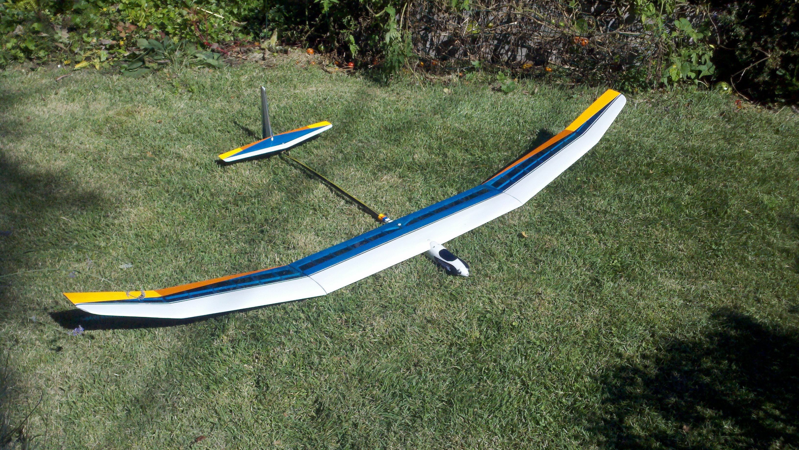
[picture p72: Photos/AL+electric+3.jpg]
AL electric 3

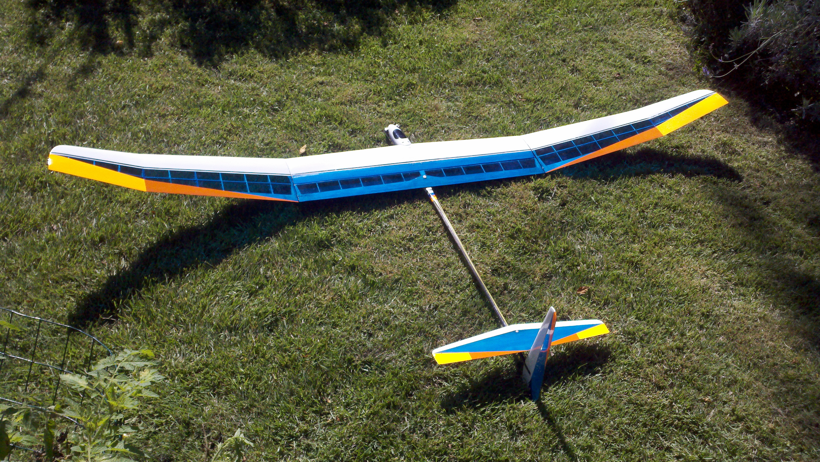
[picture p73: Photos/2012-10-21_12-23-47_495.jpg]

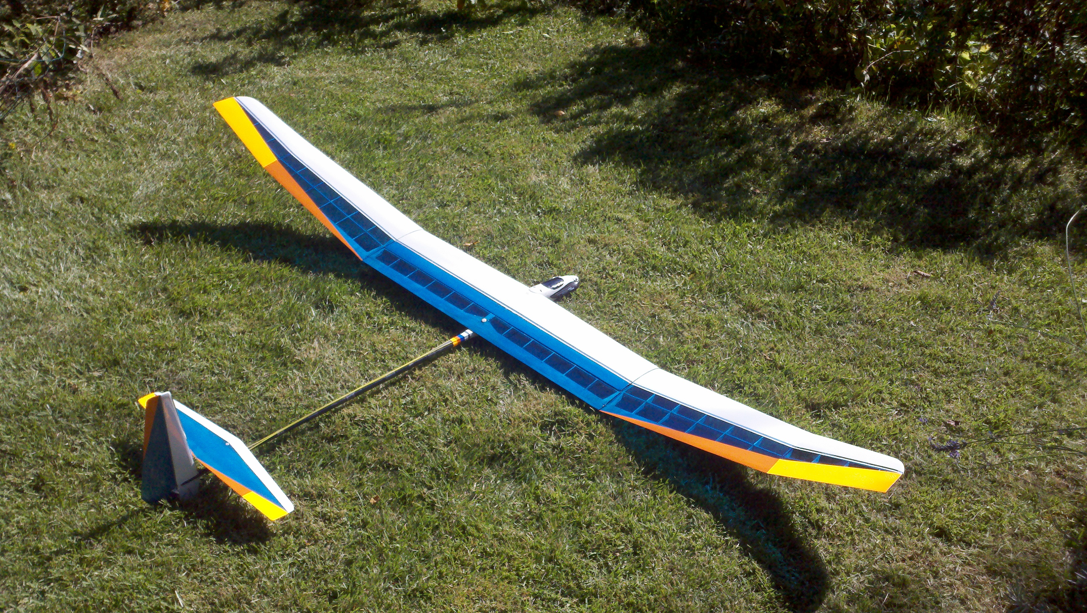
[picture p74: Photos/2012-10-21_12-23-11_956.jpg]

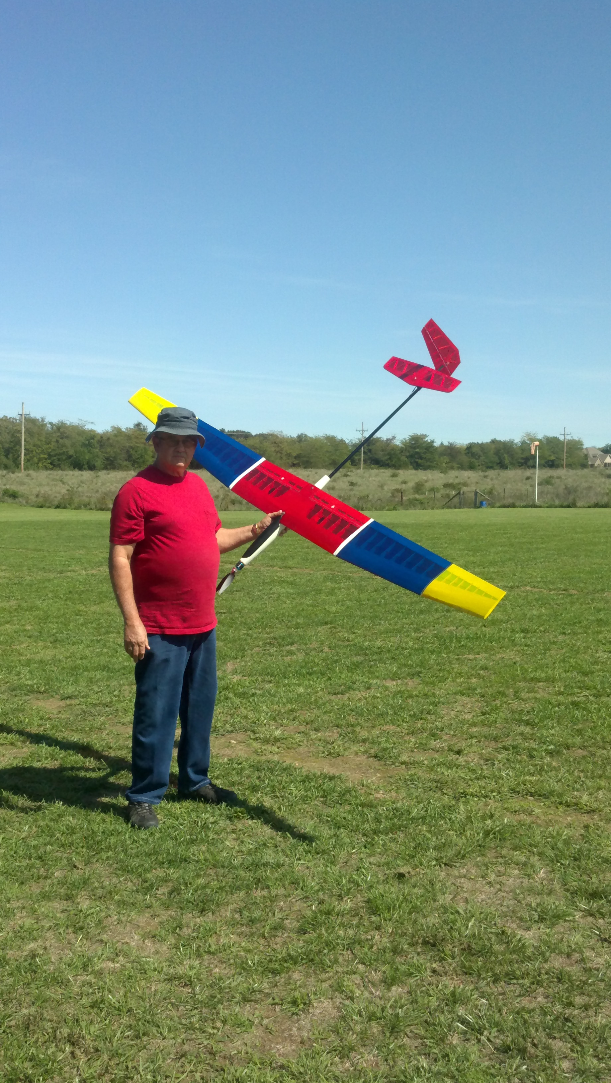
[picture p75: Photos/2012-09-23_12-49-36_630.jpg]

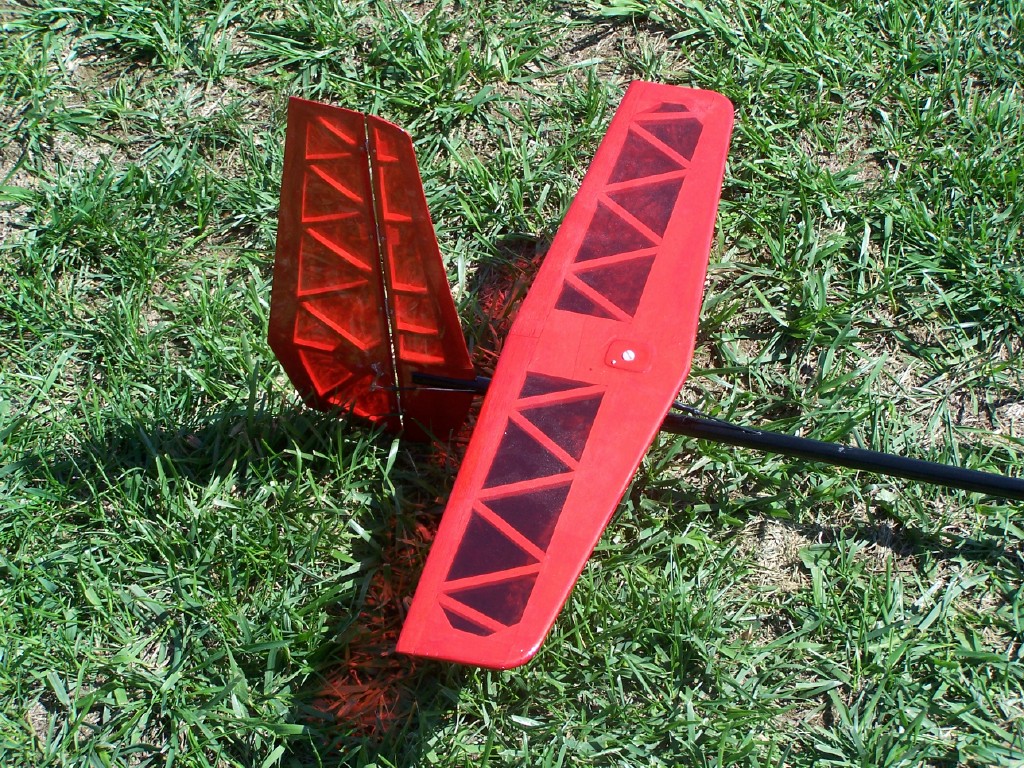
[picture p76: Photos/bubble+dancer+4.jpg]
bubble dancer 4

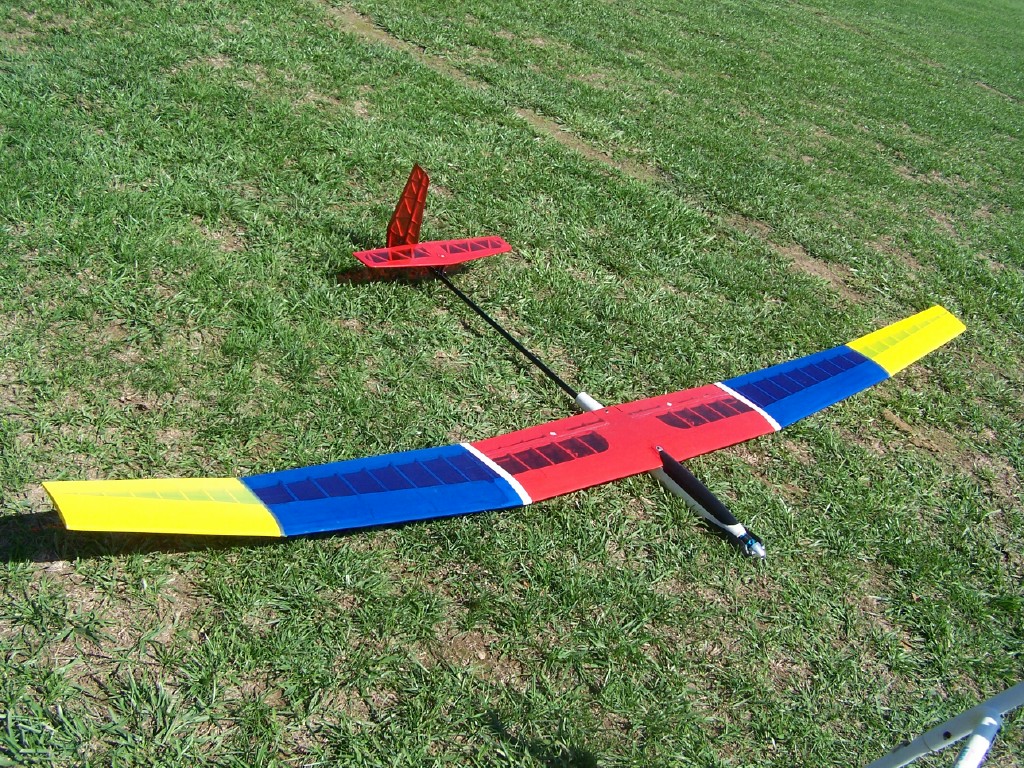
[picture p77: Photos/bubble+dancer+3.jpg]
bubble dancer 3

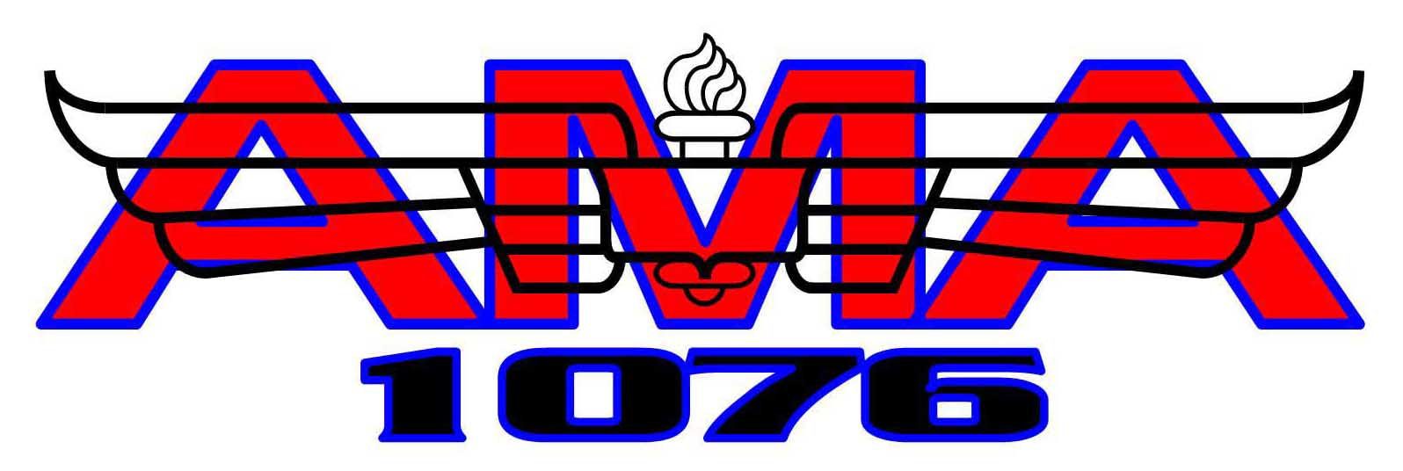
[picture p78: Photos/AMA_red_logo_lo-res.jpg]
AMA_red_logo_lo-res

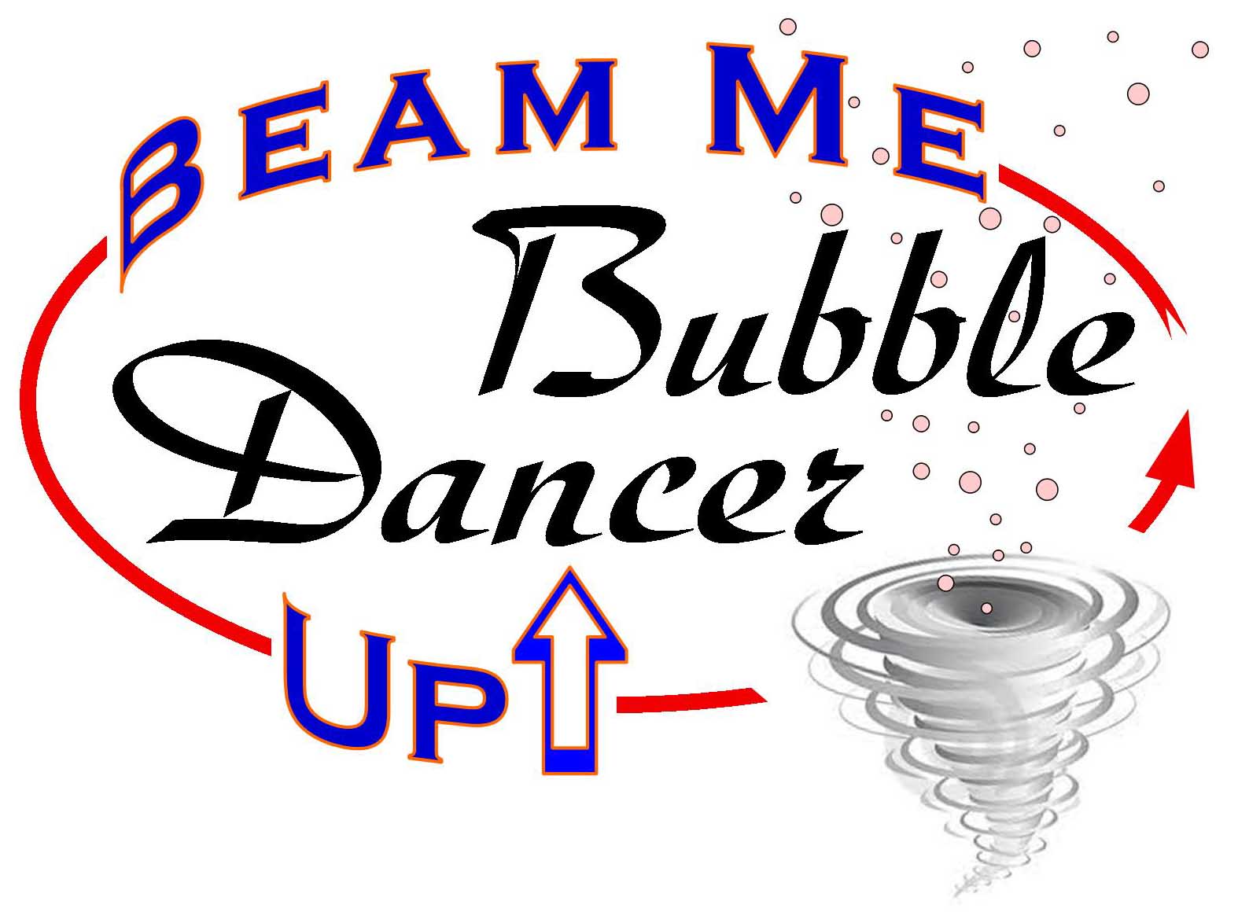
[picture p79: Photos/BD_Logo6_lo-res.jpg]
BD_Logo6_lo-res

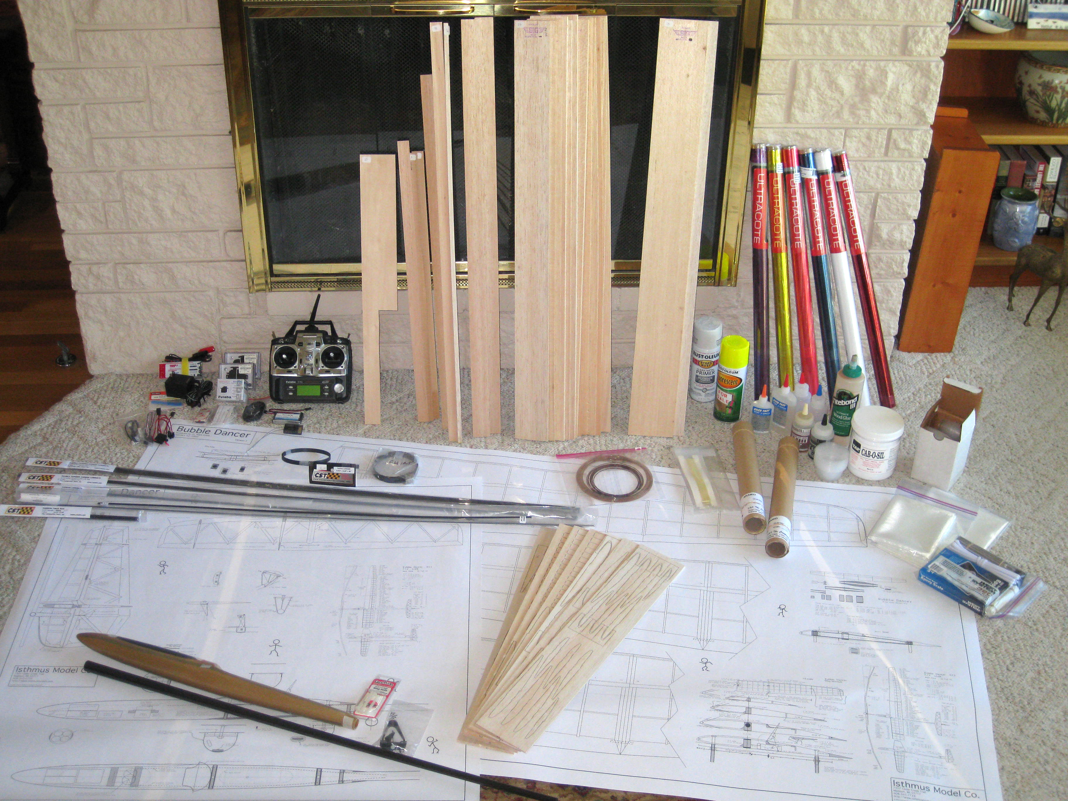
[picture p80: Photos/The_Kit_02.jpg]
The_Kit_02

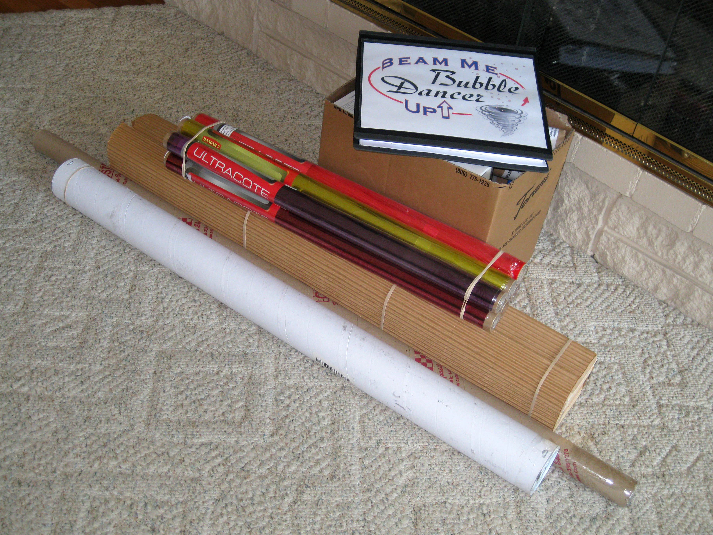
[picture p81: Photos/The_Pile_01.jpg]
The_Pile_01

The_Pile_03
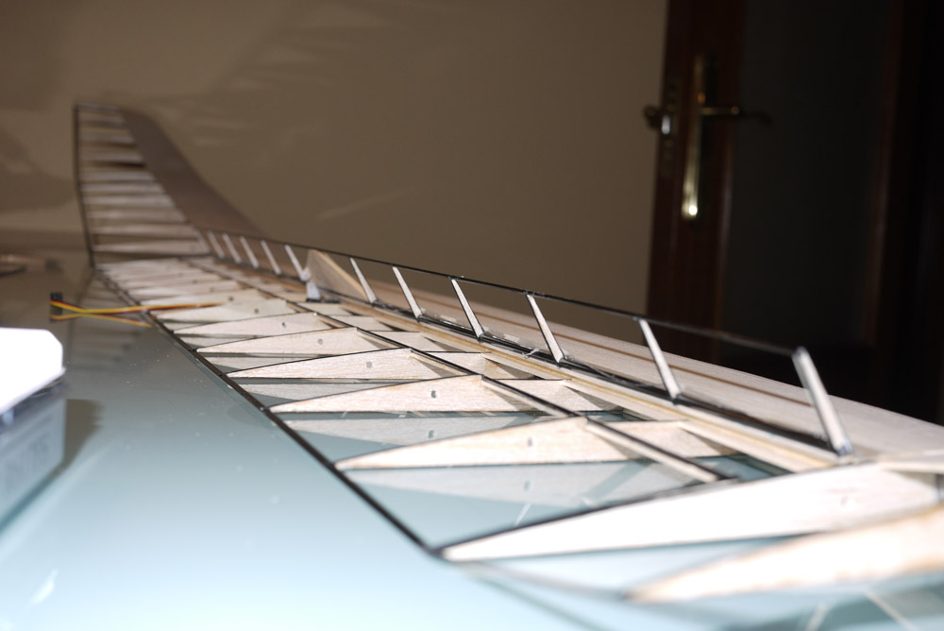
[picture p82: Photos/06.jpg]

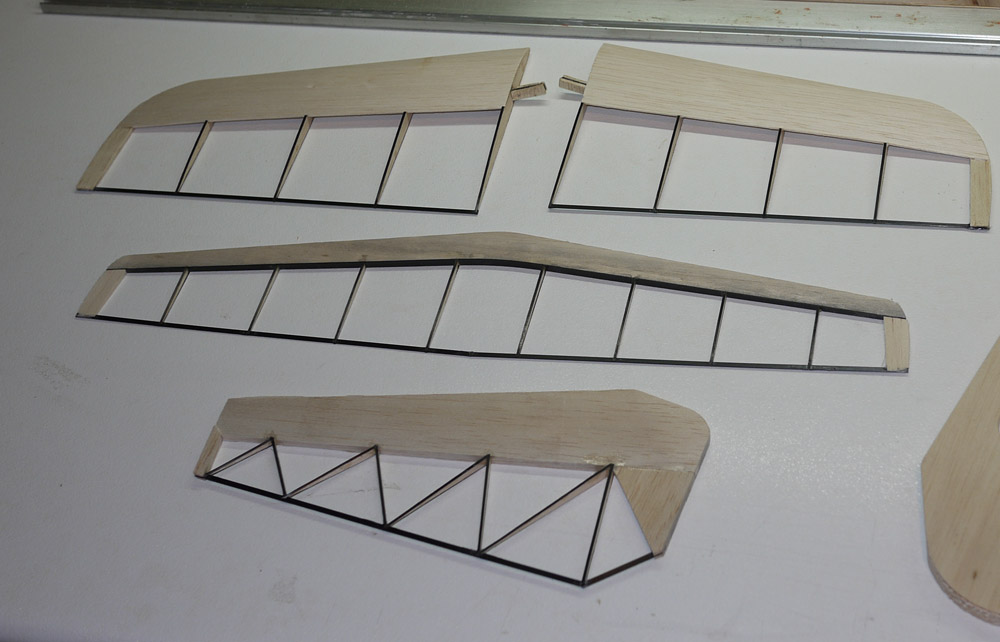
[picture p83: Photos/02.jpg]

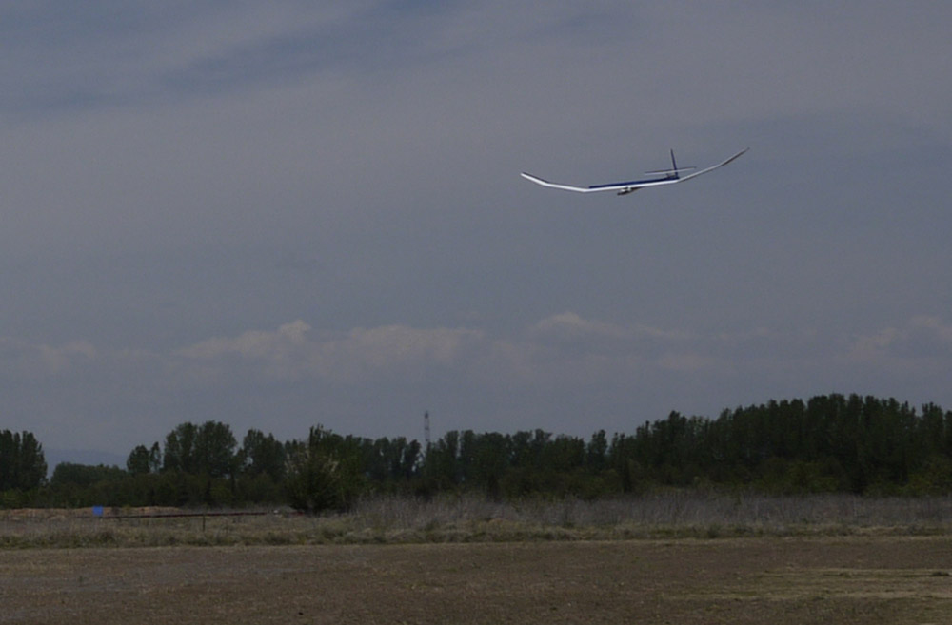
[picture p84: Photos/14.jpg]

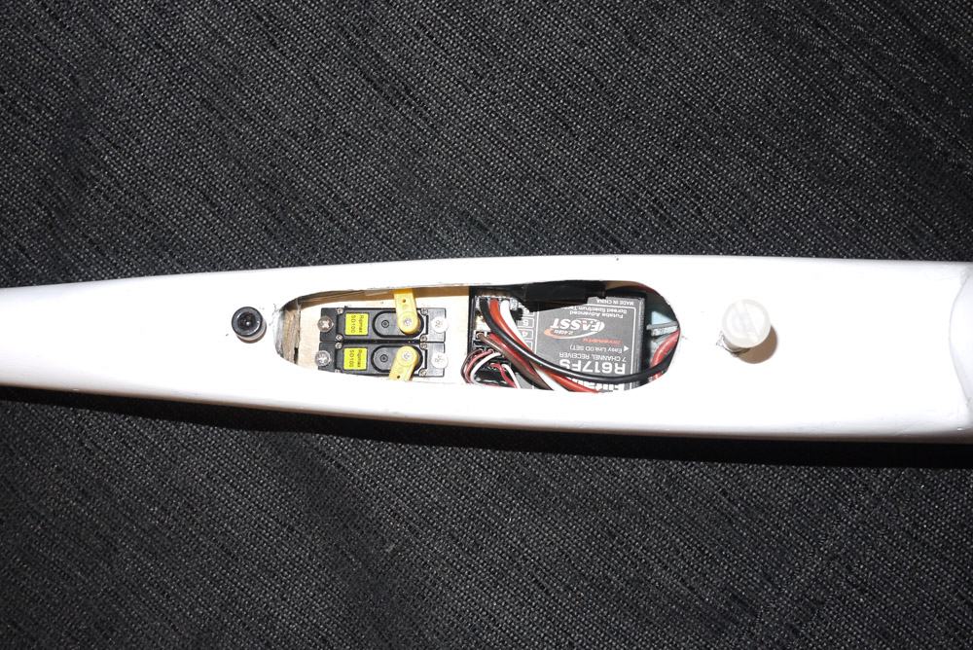
[picture p85: Photos/103.jpg]

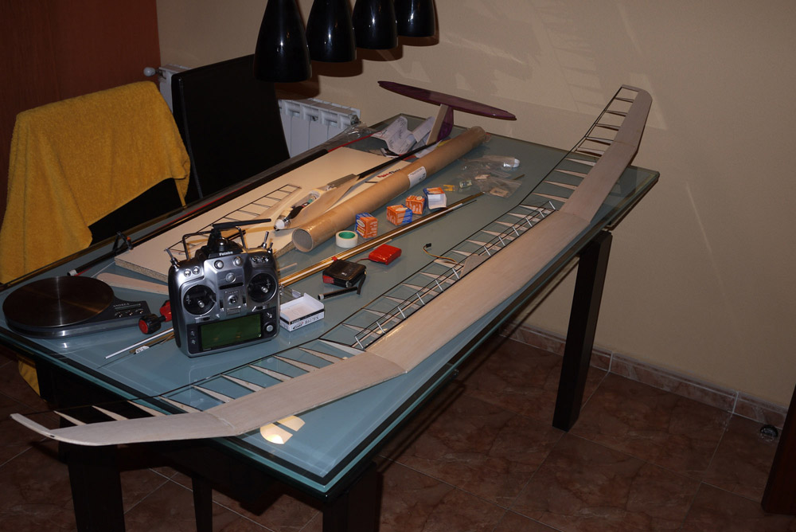
[picture p86: Photos/05.jpg]

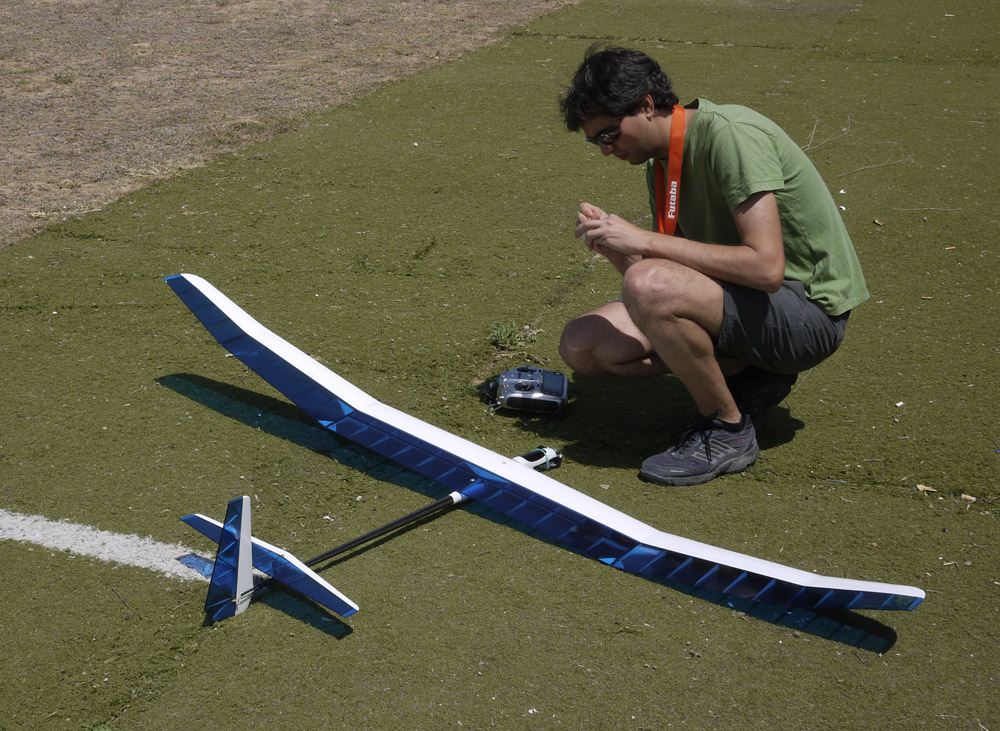
[picture p87: Photos/12.jpg]

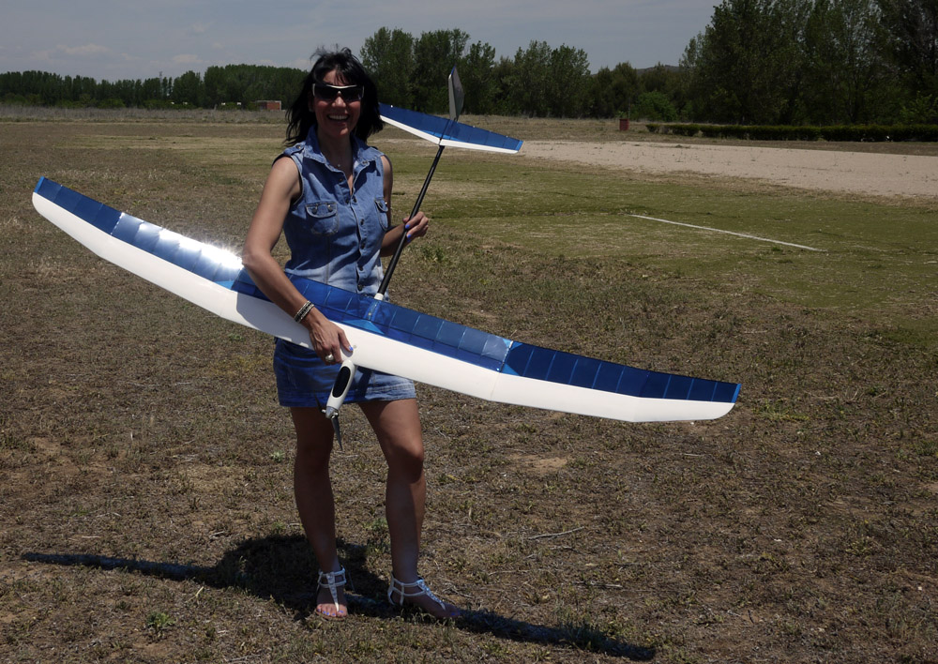
[picture p88: Photos/13.jpg]

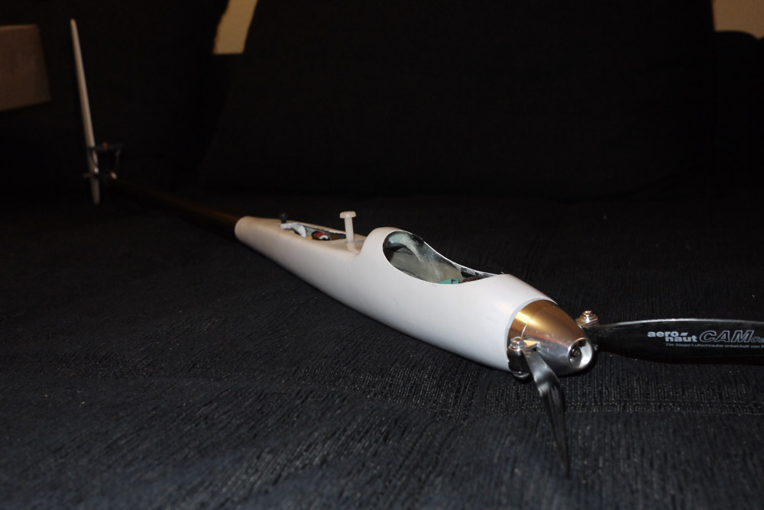
[picture p89: Photos/101.jpg]

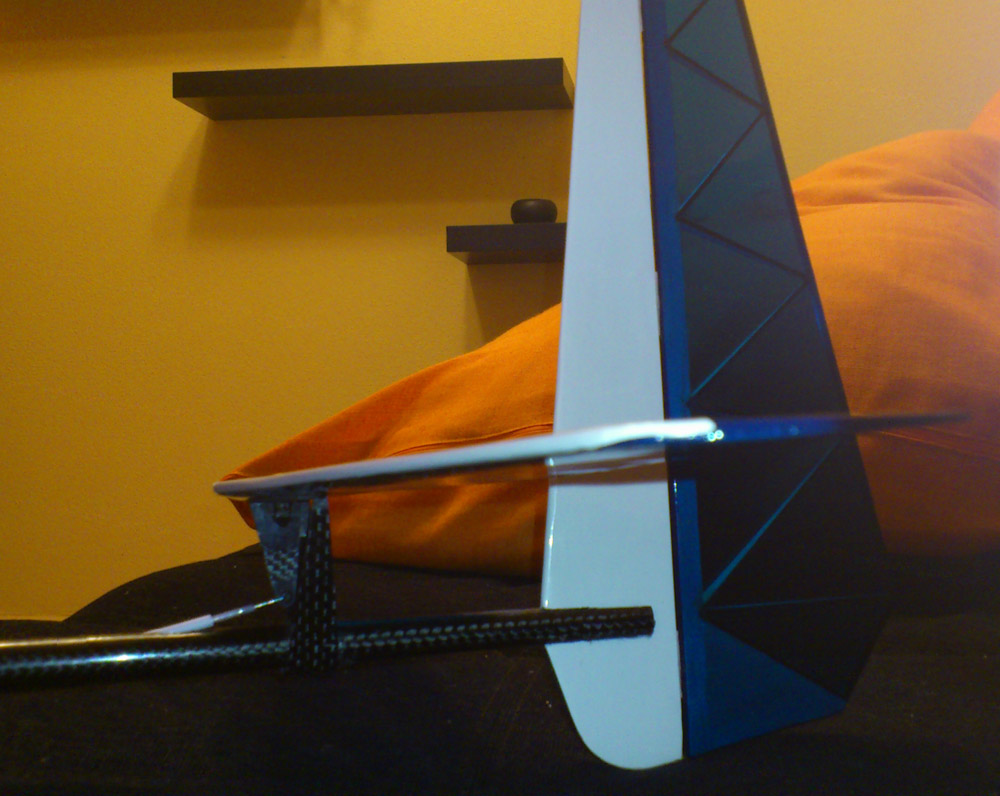
[picture p90: Photos/11.jpg]

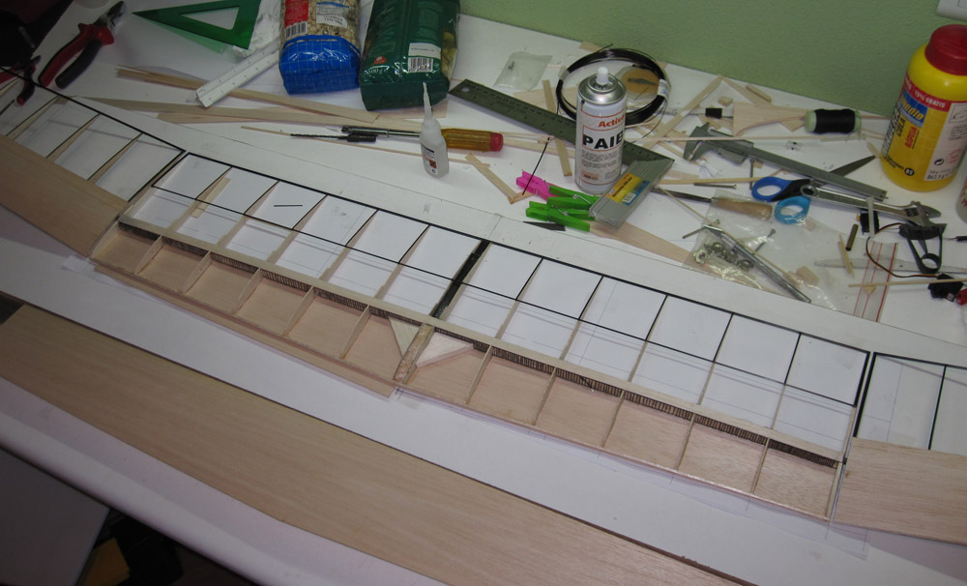
[picture p91: Photos/03.jpg]

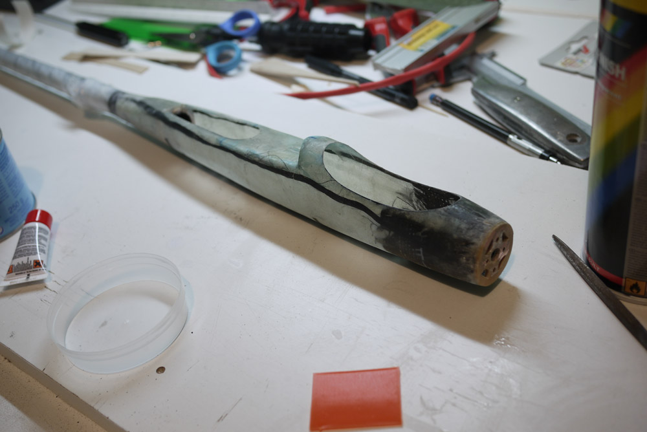
[picture p92: Photos/10.jpg]

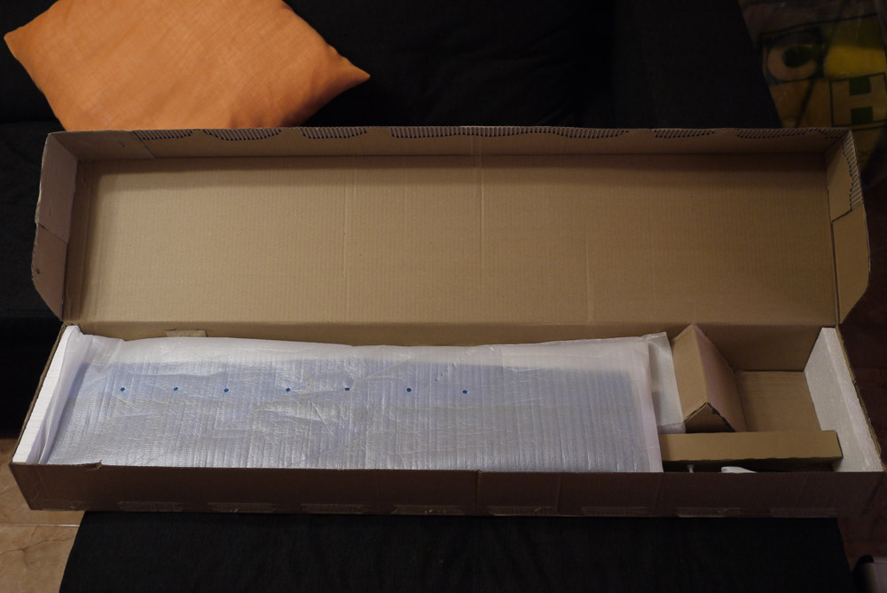
[picture p93: Photos/105.jpg]

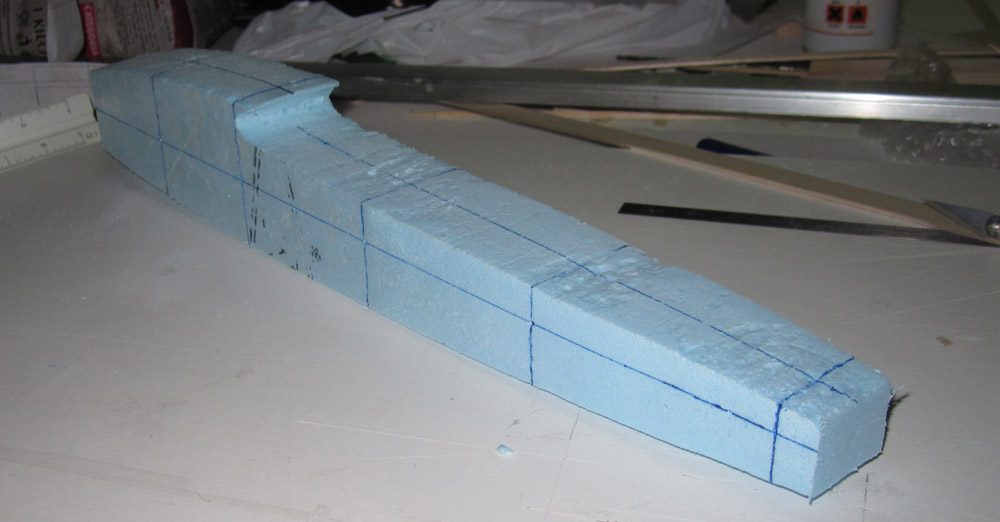
[picture p94: Photos/07.jpg]

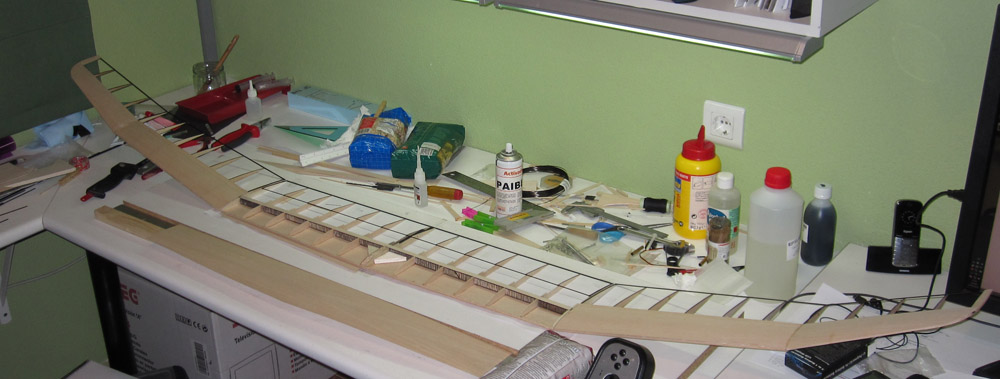
[picture p95: Photos/04.jpg]

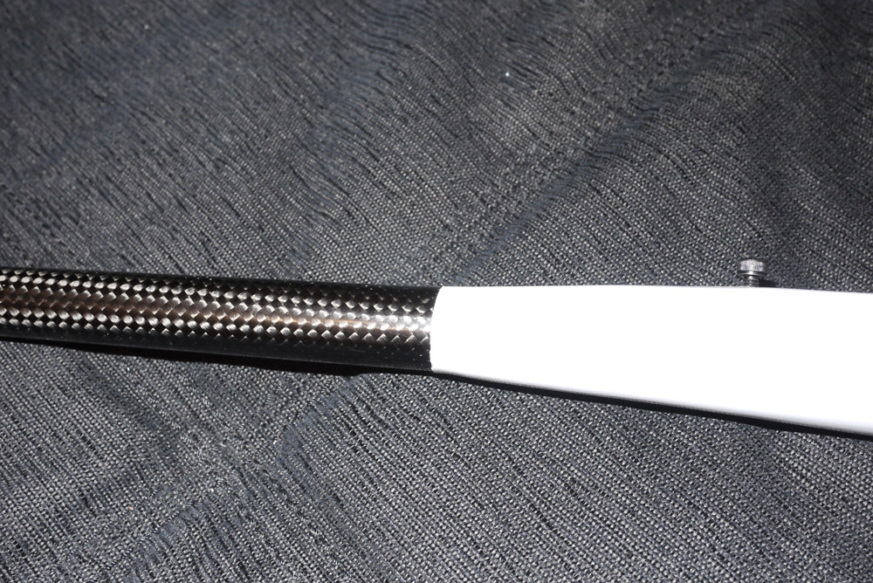
[picture p96: Photos/104.jpg]

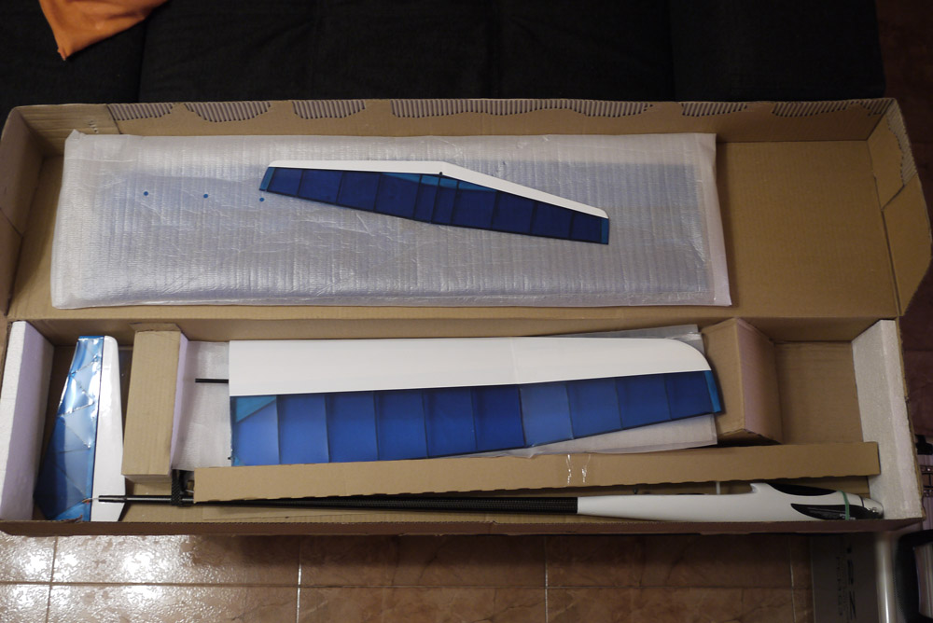
[picture p97: Photos/106.jpg]

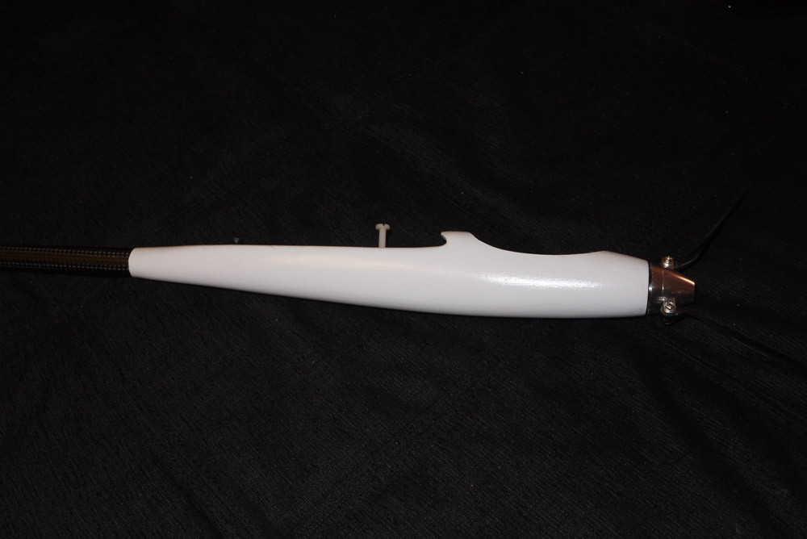
[picture p98: Photos/102.jpg]

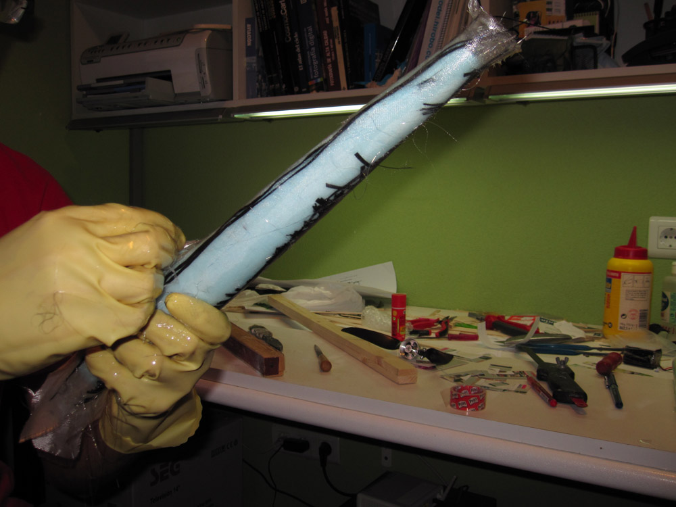
[picture p99: Photos/09.jpg]

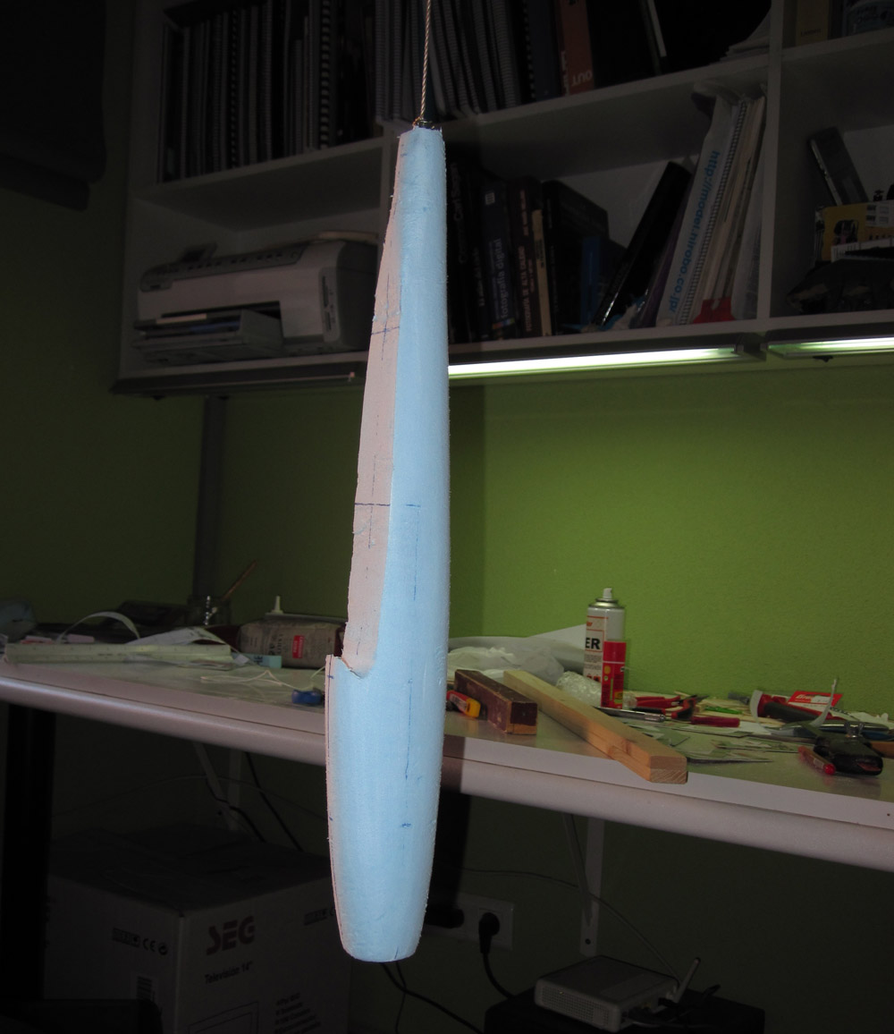
[picture p100: Photos/08.jpg]

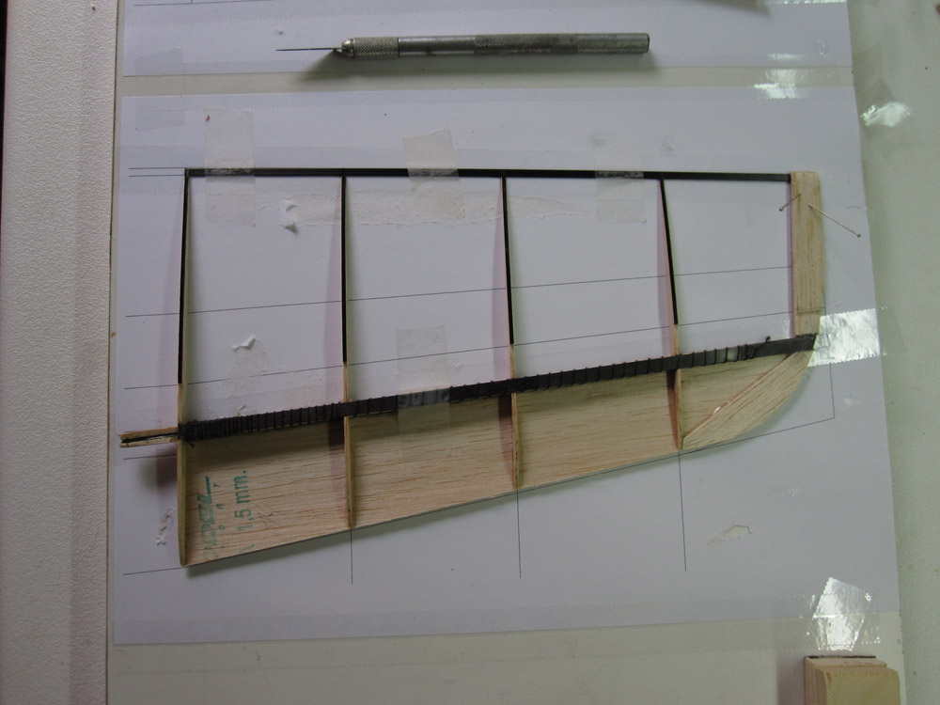
[picture p101: Photos/01.jpg]

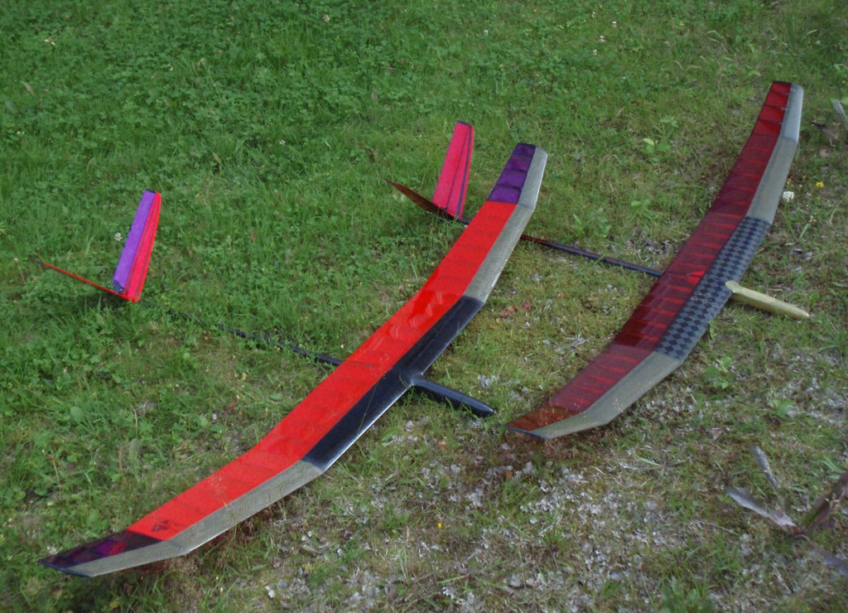
[picture p102: Photos/Allegrot-web.jpg]
Allegrot-web

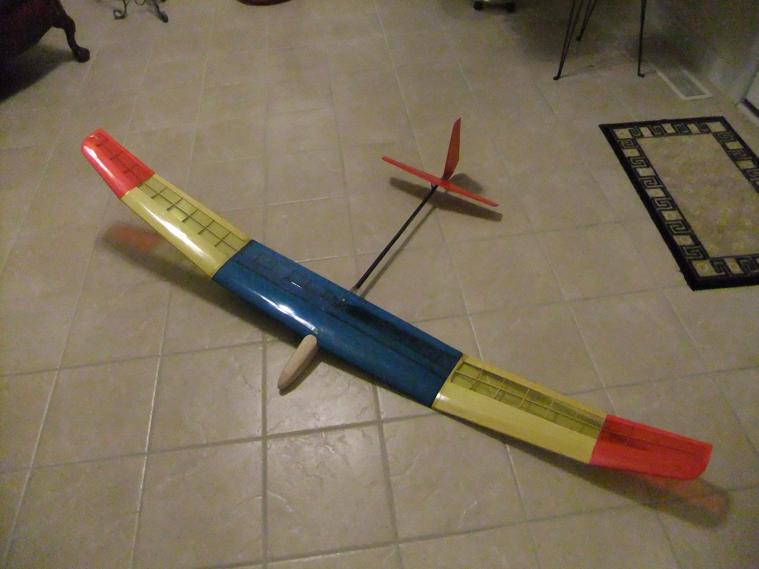
[picture p103: Photos/DSCF0277.jpg]
DSCF0277








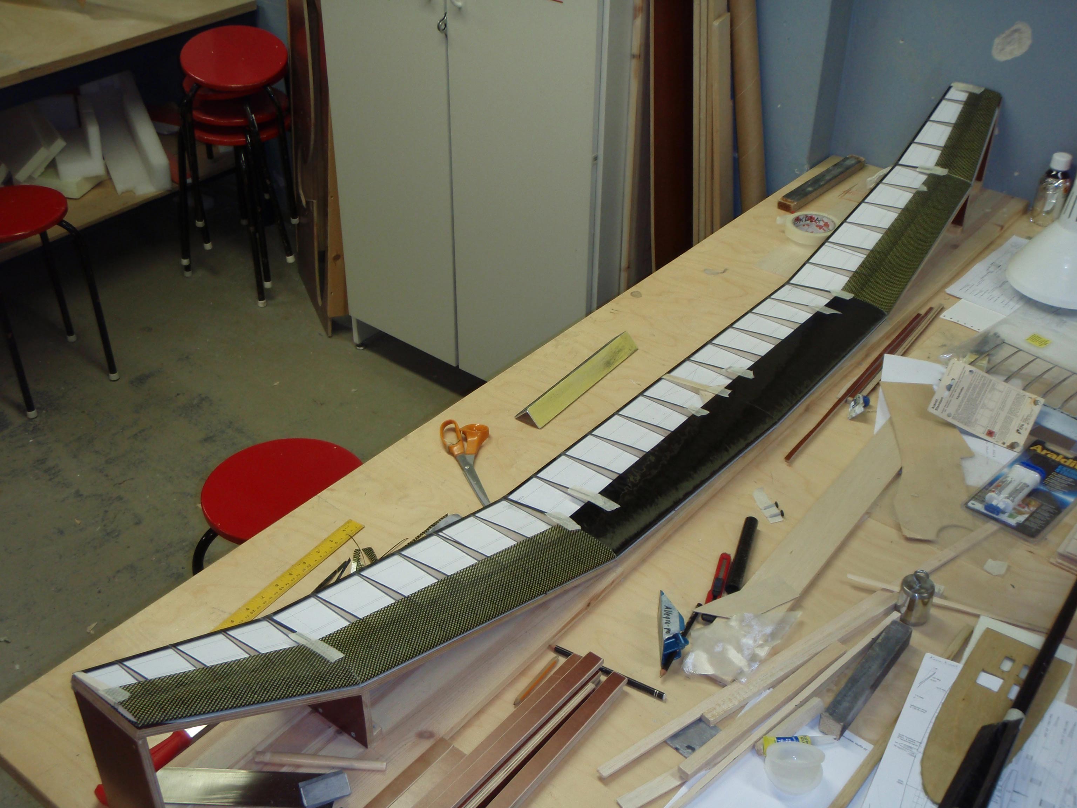
[picture p104: Photos/Dryfitting_cells.jpg]
Dryfitting_cells

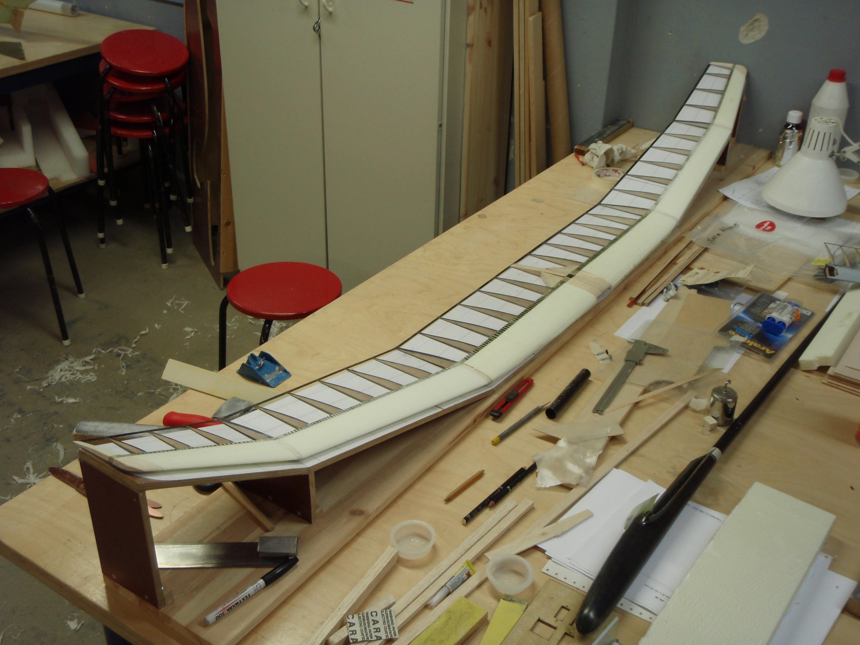
[picture p105: Photos/D-box_foam.jpg]
D-box_foam

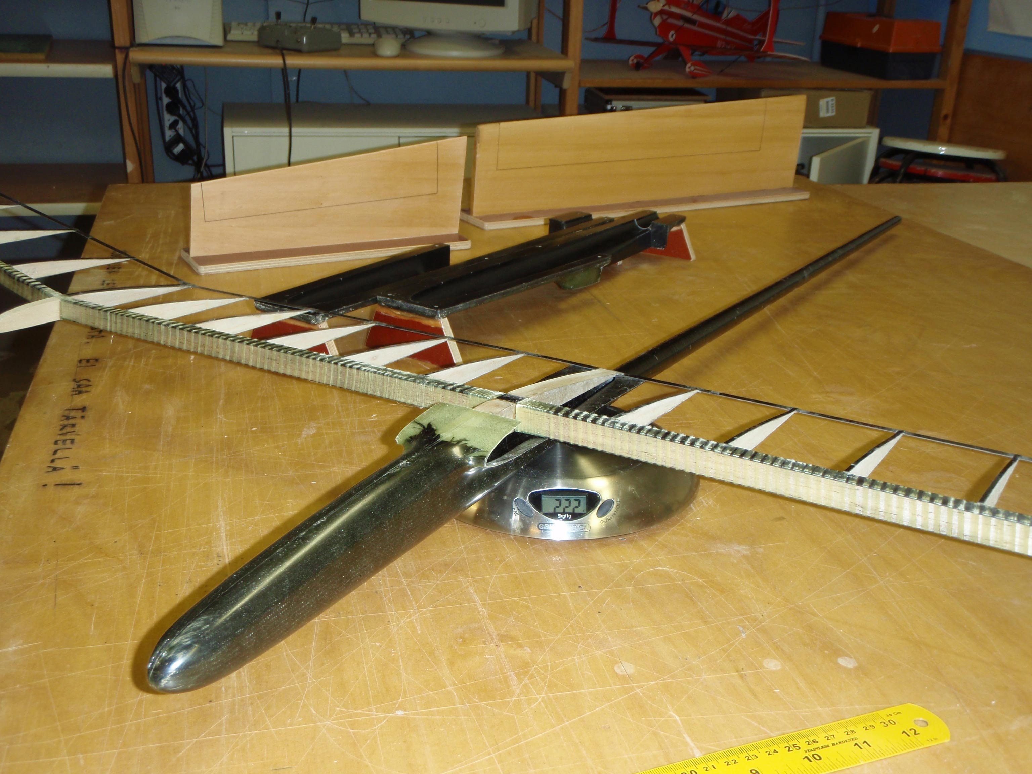
[picture p106: Photos/Skeleton.jpg]
Skeleton

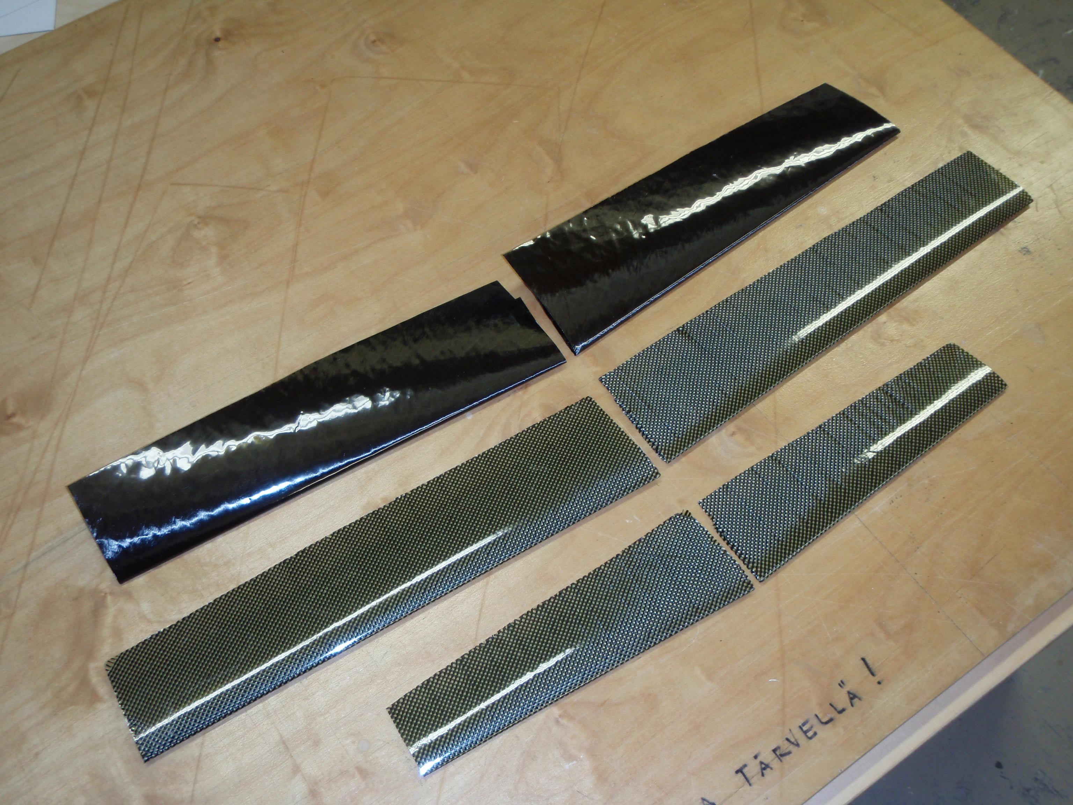
[picture p107: Photos/Shells.jpg]
Shells

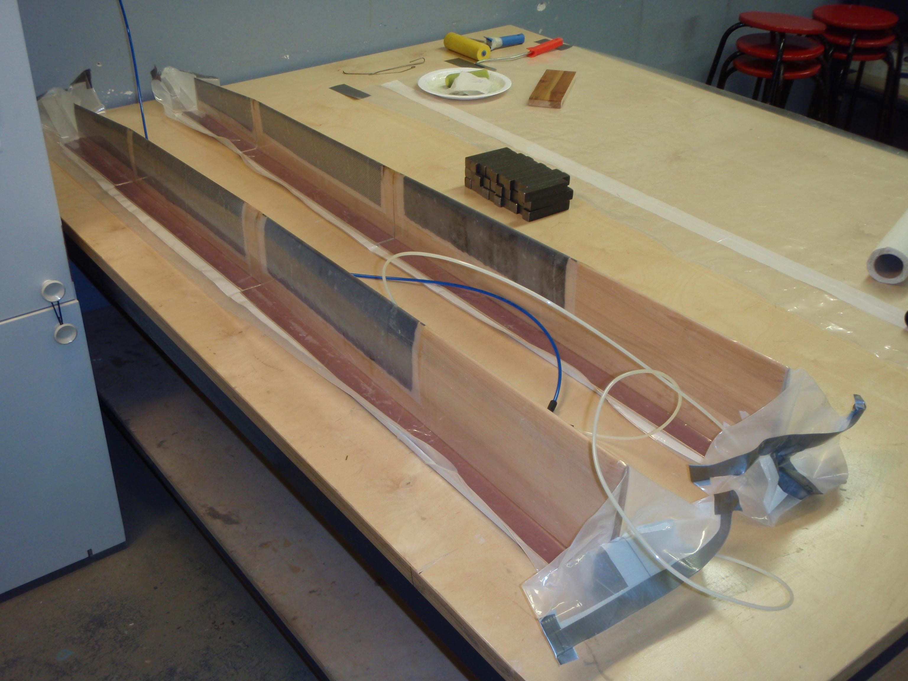
[picture p108: Photos/D-box_shells.jpg]
D-box_shells

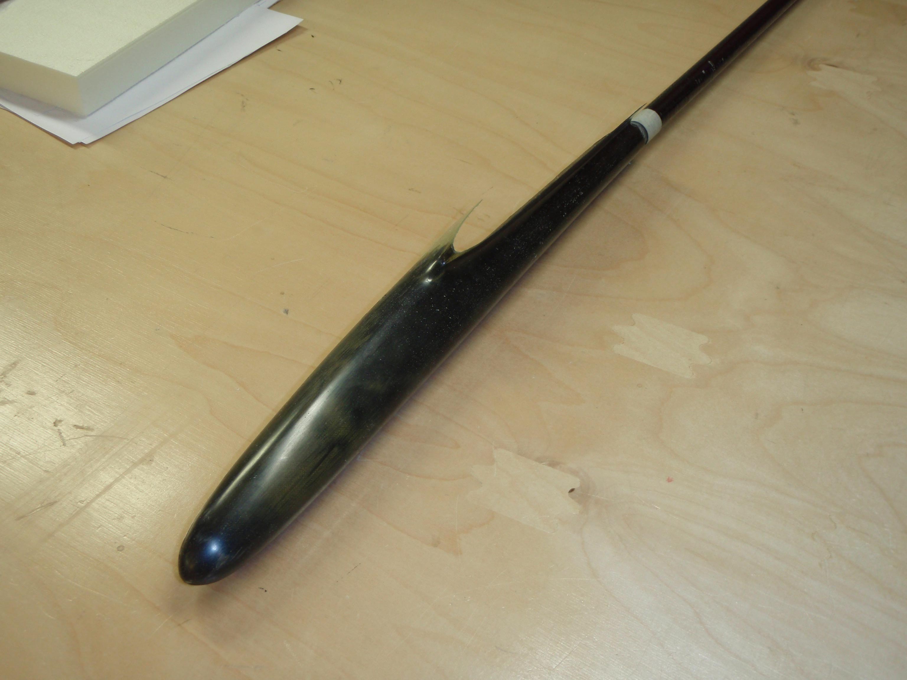
[picture p109: Photos/Pod&boom.jpg]
Pod&boom

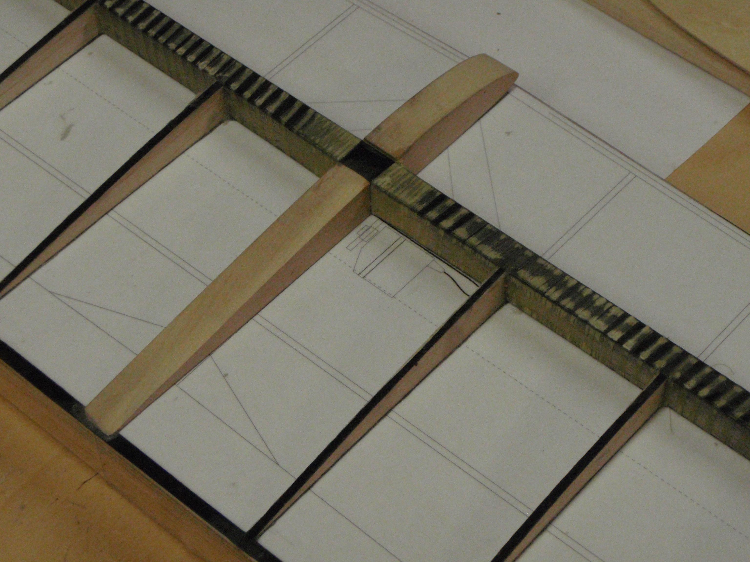
[picture p110: Photos/Spar&ribs.jpg]
Spar&ribs

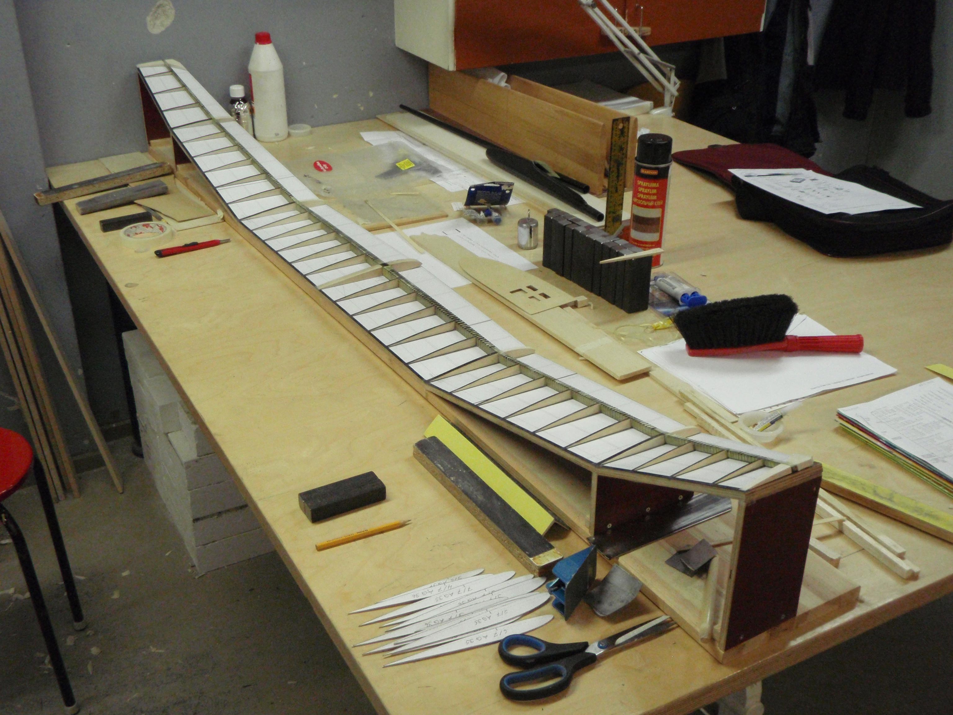
[picture p111: Photos/Wing_jig.jpg]
Wing_jig

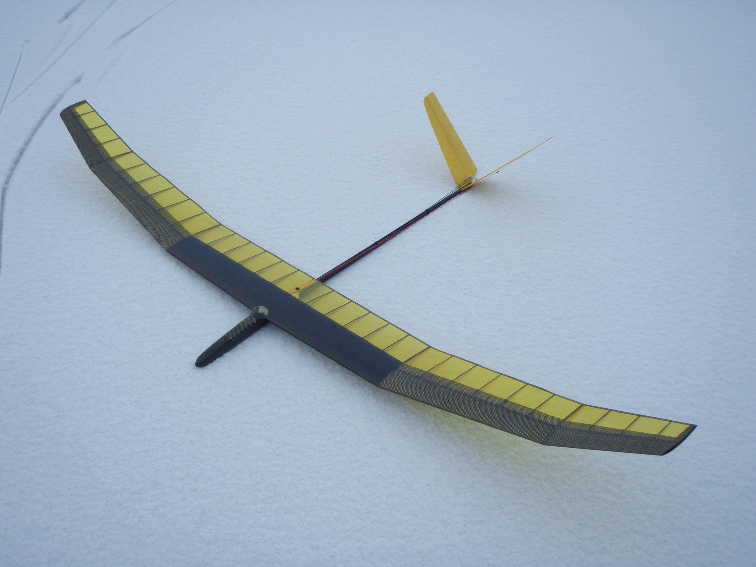
[picture p112: Photos/Allegro_Lite_Comp_V.jpg]
Allegro_Lite_Comp_V









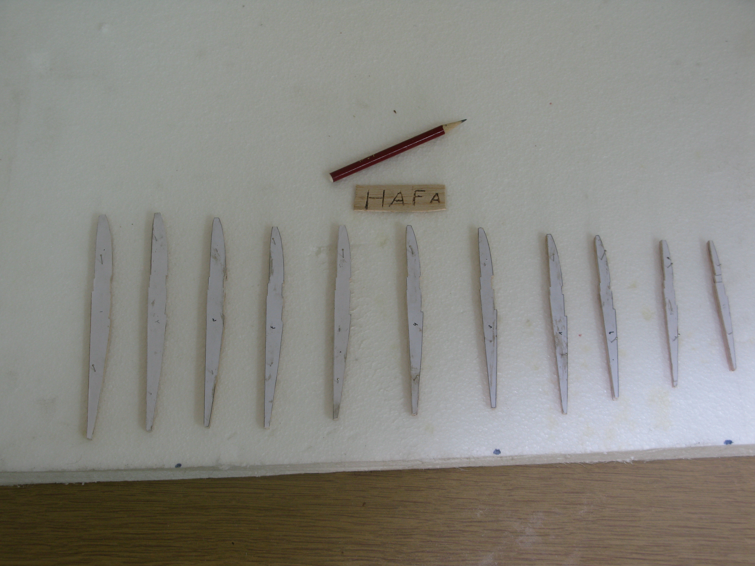
[picture p113: Photos/IMG_4427.jpg]


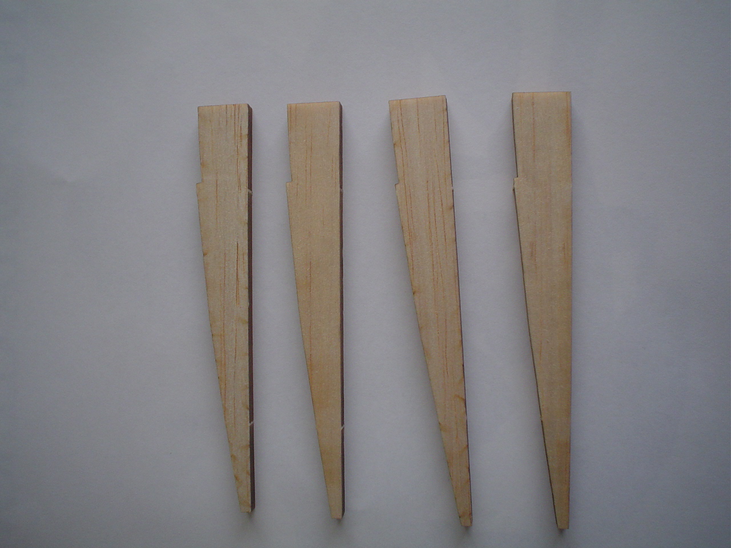
[picture p114: Photos/bill+rib.jpg]
bill rib

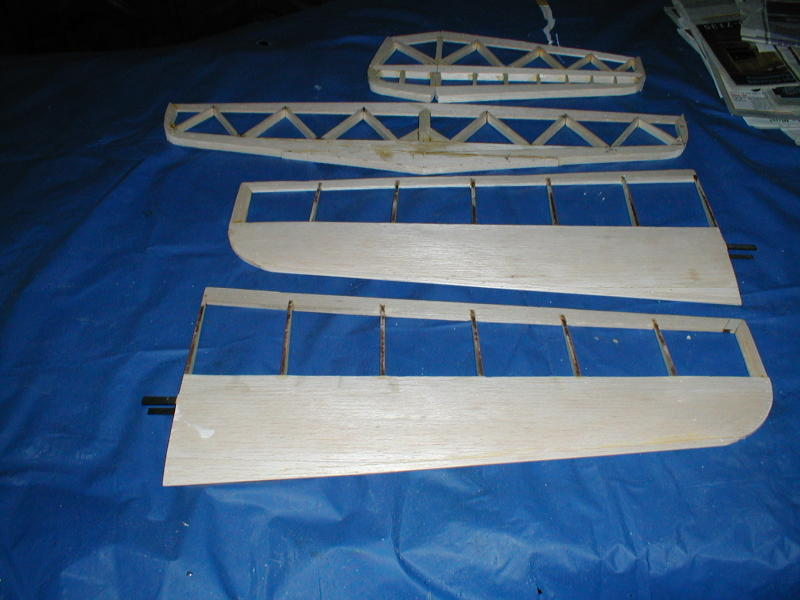
[picture p115: Photos/BD completed wingtips & tails.jpg]
BD completed wingtips & tails

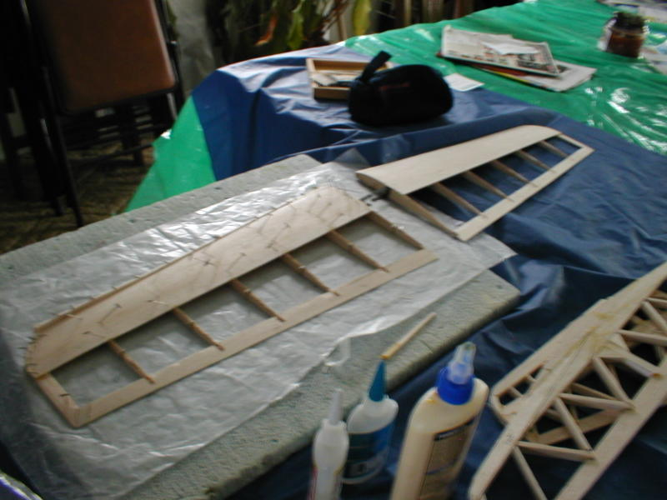
[picture p116: Photos/B D completed wingtips.jpg]
B D completed wingtips

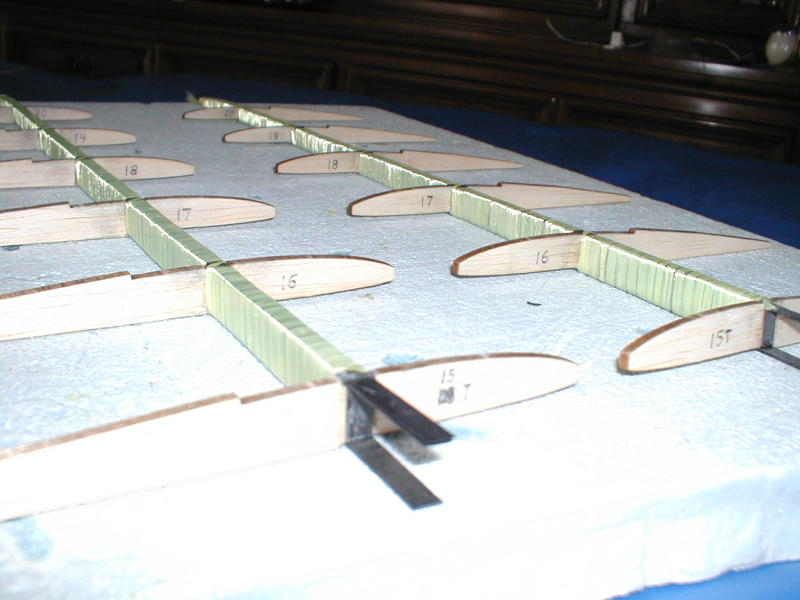
[picture p117: Photos/B D wingtip spar wrap.jpg]
B D wingtip spar wrap # 2

B D wingtip spar wrap
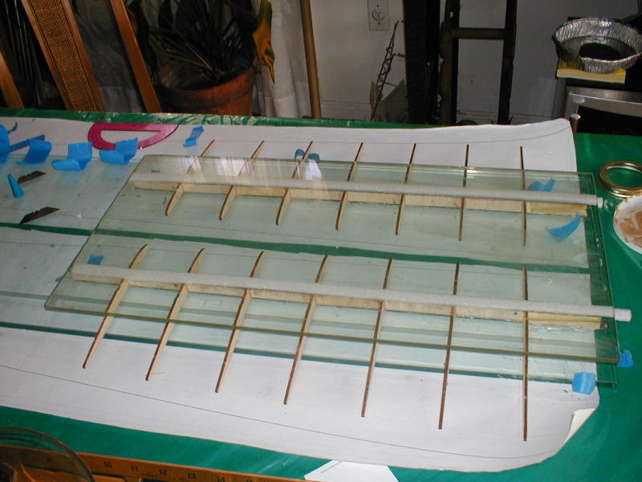
[picture p118: Photos/B D mid panels under glass.jpg]
B D mid panels under glass

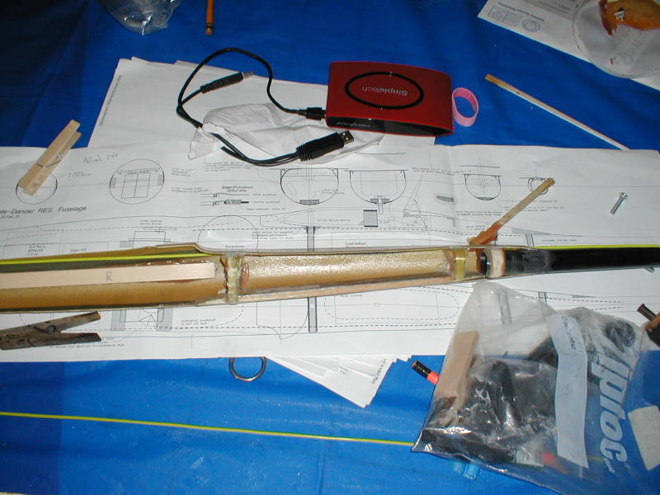
[picture p119: Photos/B D fuse assembly.jpg]
B D fuse assembly

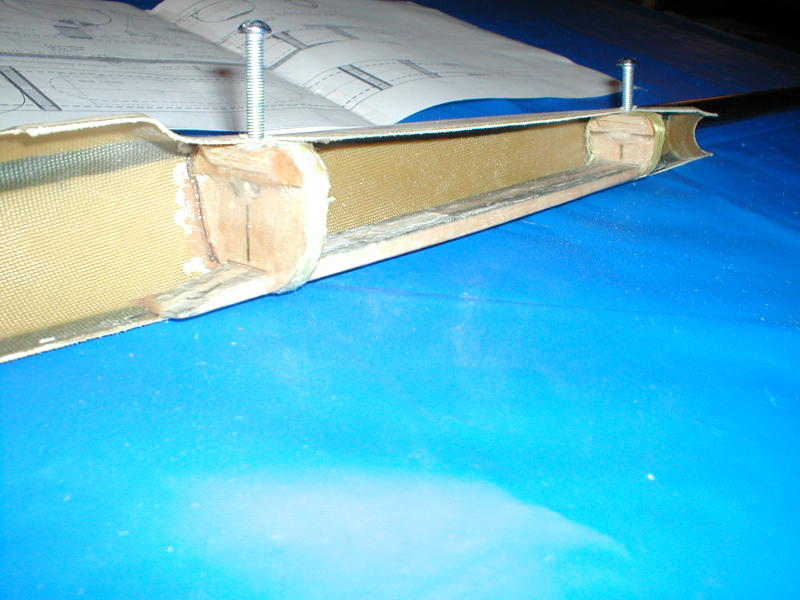
[picture p120: Photos/B D fuse construction.jpg]
B D fuse construction

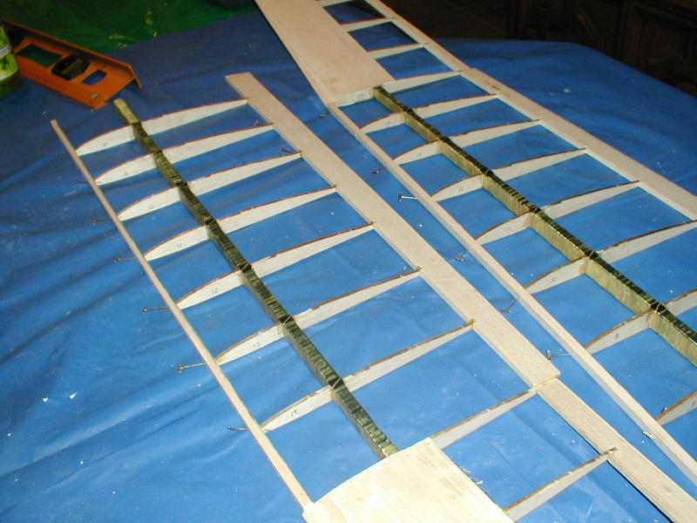
[picture p121: Photos/B D mid panels.jpg]
B D mid panels

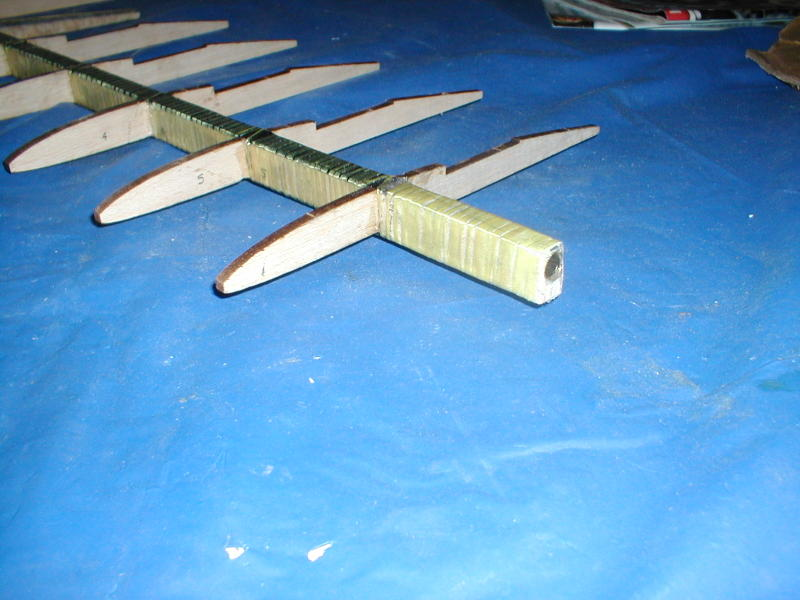
[picture p122: Photos/B D center panel spar wrap.jpg]
B D center panel spar wrap

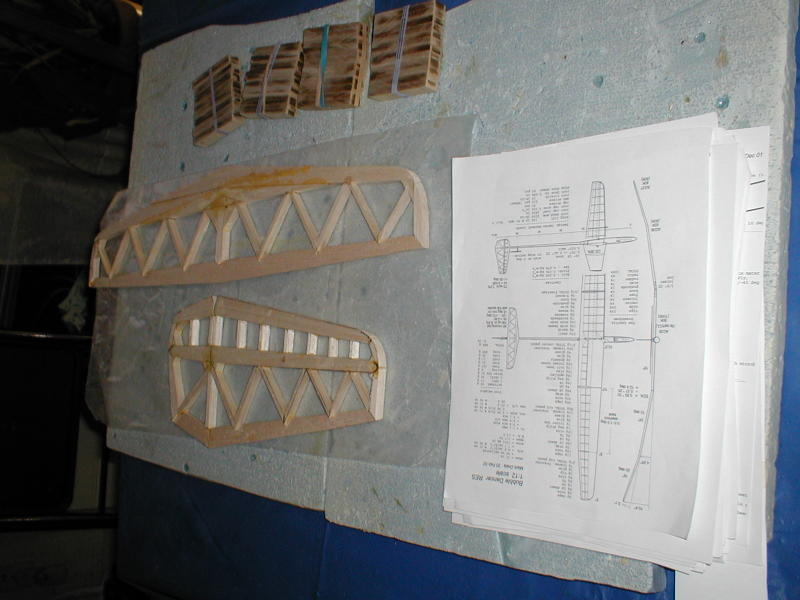
[picture p123: Photos/Bubble Dancer Tail Jan 08 002.jpg]
Bubble Dancer Tail Jan 08 002

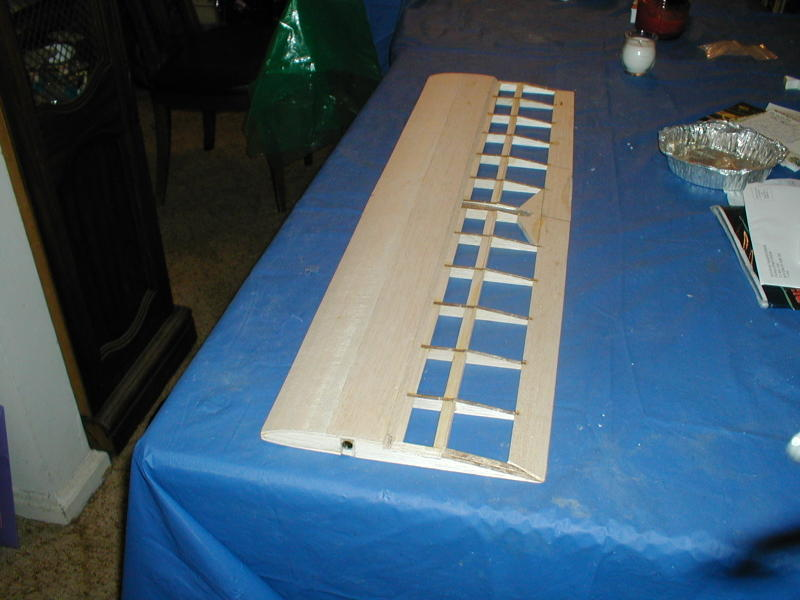
[picture p124: Photos/B D wing center panel nearly finished.jpg]
B D wing center panel nearly finished

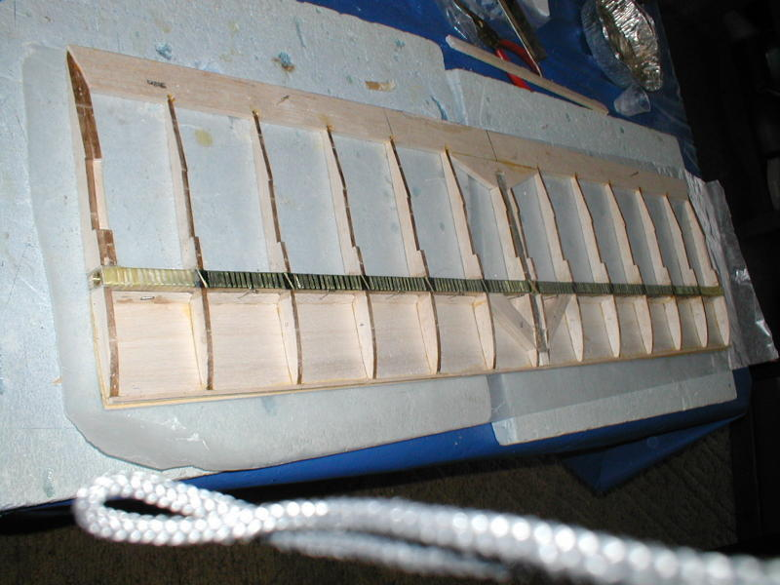
[picture p125: Photos/B D wing center panel.jpg]
B D wing center panel

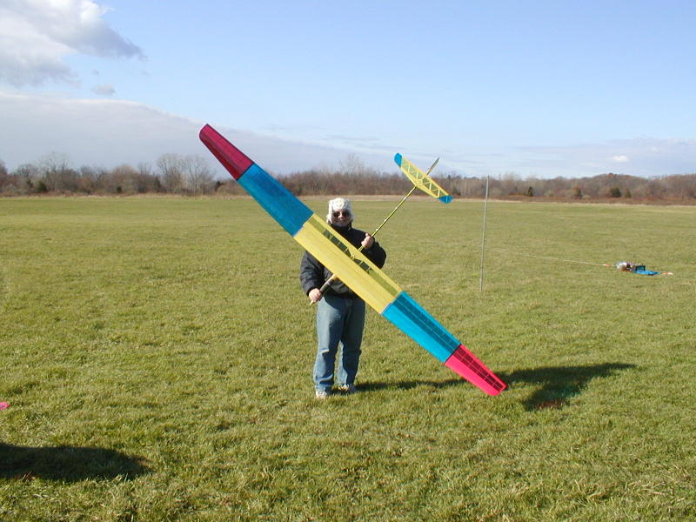
[picture p126: Photos/B D first day out 11 08.jpg]
B D first day out 11 08

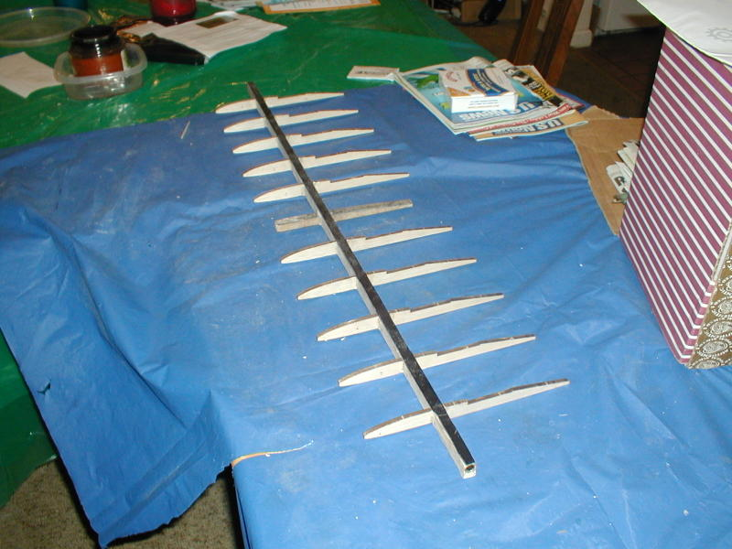
[picture p127: Photos/B D Mid & Center Panels 4 08 011.jpg]
B D Mid & Center Panels 4 08 011

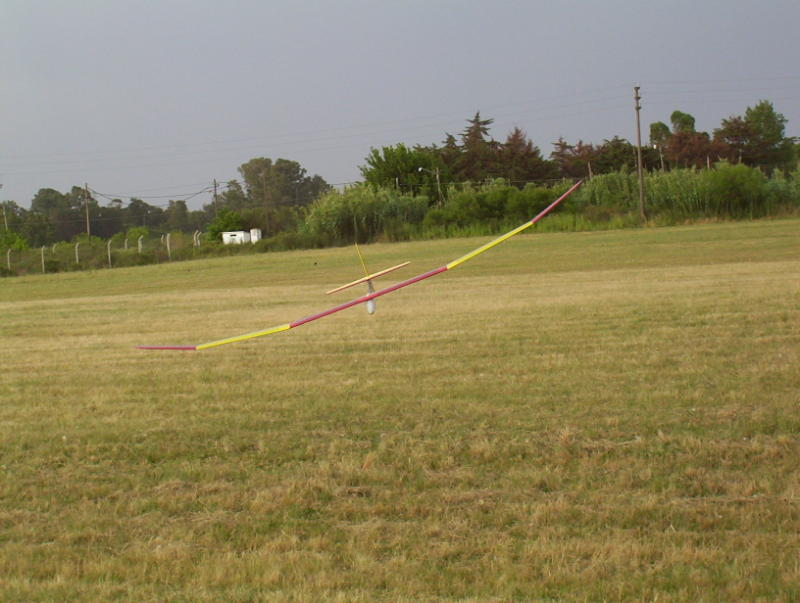
[picture p128: Photos/100_5777.jpg]

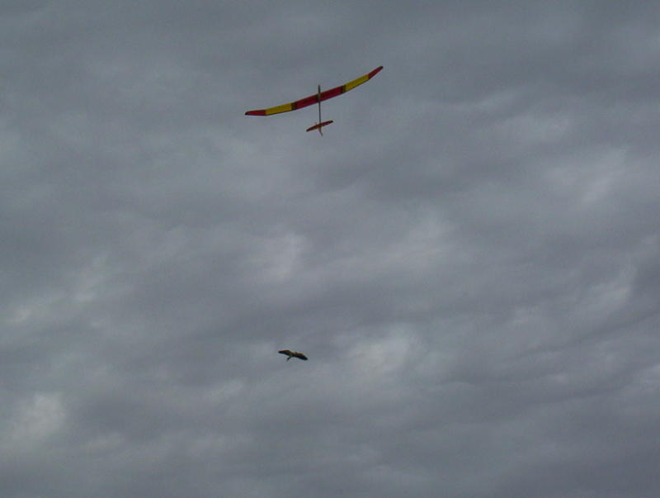
[picture p129: Photos/volando con compania.jpg]
volando con compania

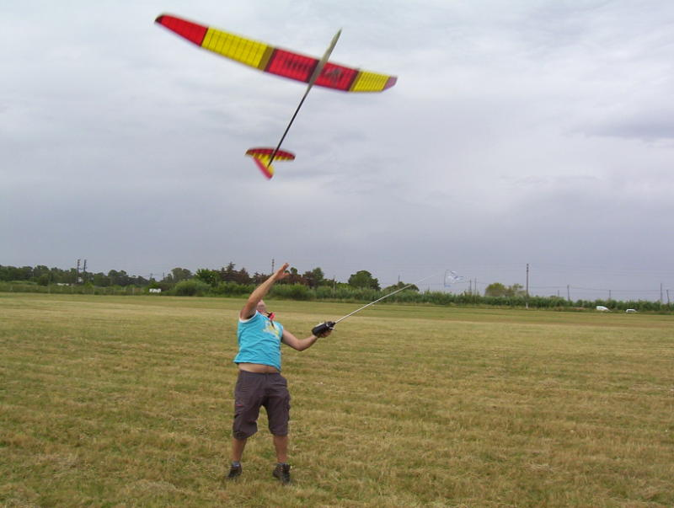
[picture p130: Photos/uno de los muchos lanzamientos.jpg]
uno de los muchos lanzamientos

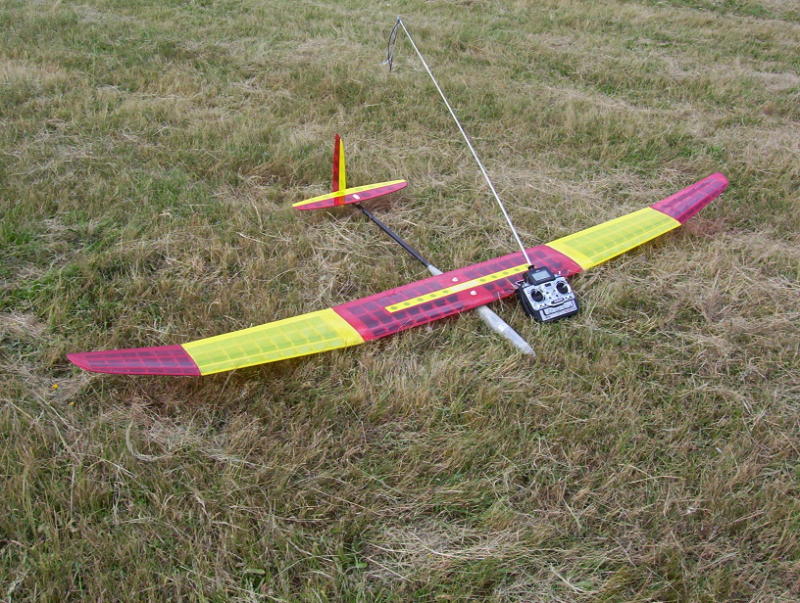
[picture p131: Photos/modelo y radio.jpg]
modelo y radio

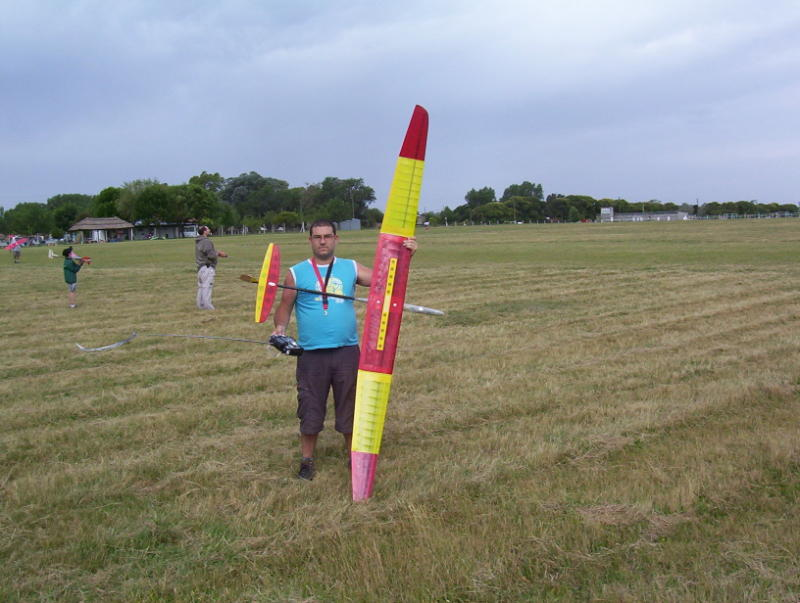
[picture p132: Photos/costructor y modelo.jpg]
costructor y modelo

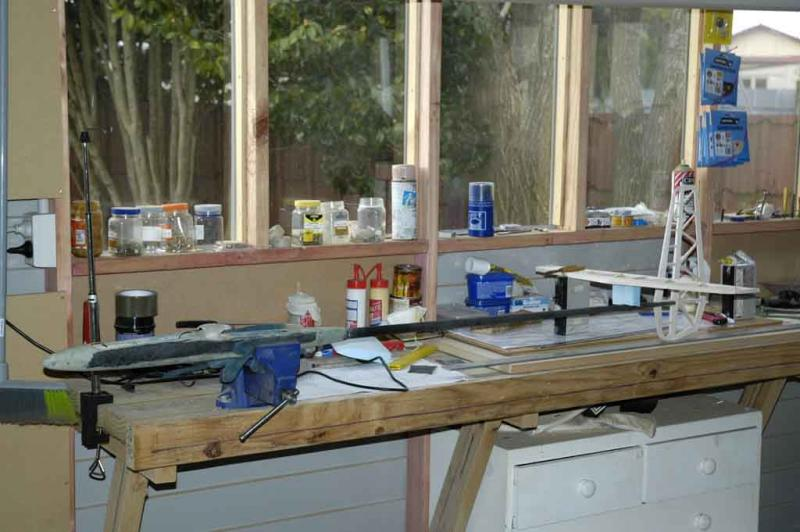
[picture p133: Photos/fuse completed.jpg]
fuse completed

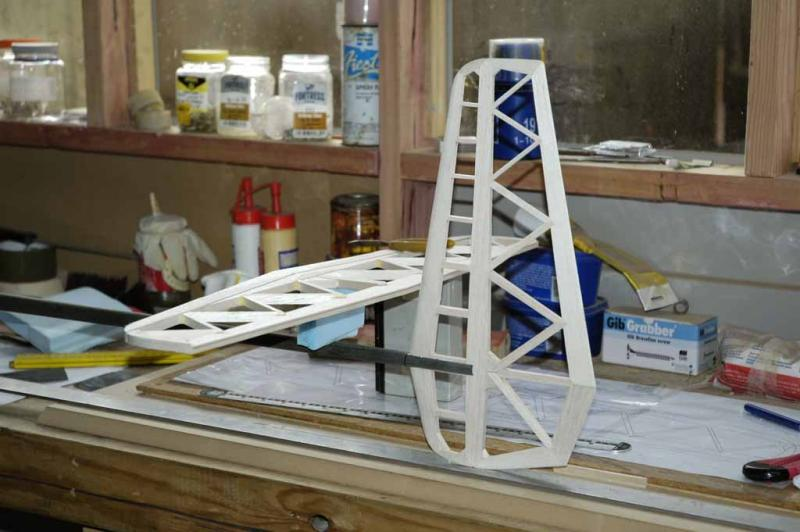
[picture p134: Photos/tail 2.jpg]
tail 2

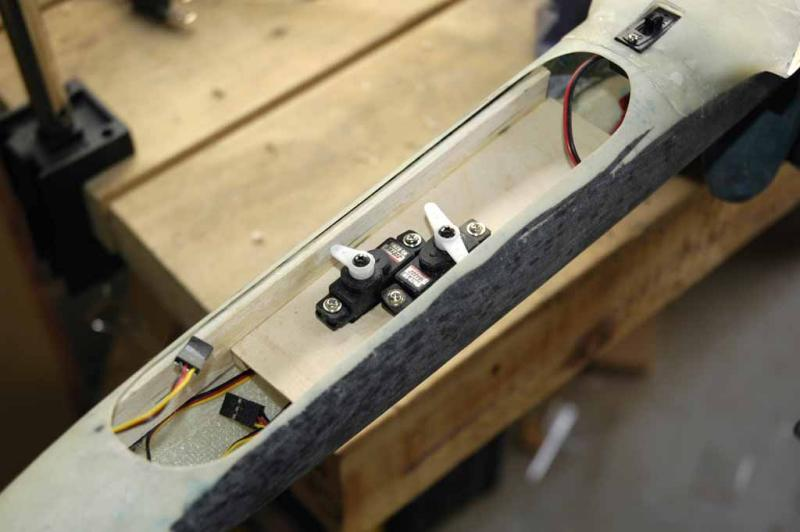
[picture p135: Photos/basic installation.jpg]
basic installation

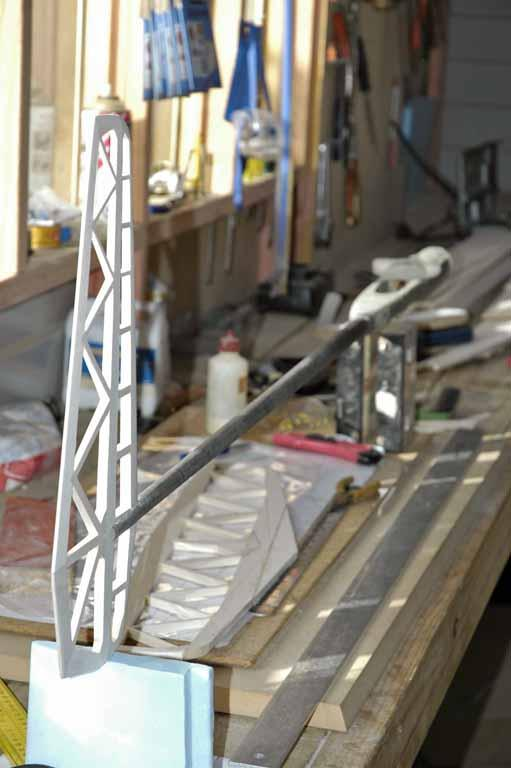
[picture p136: Photos/tail.jpg]
tail

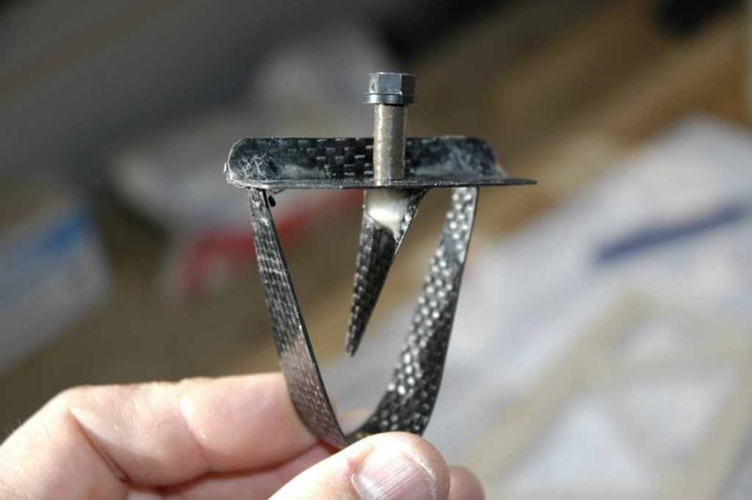
[picture p137: Photos/the completed V strut.jpg]
the completed V strut

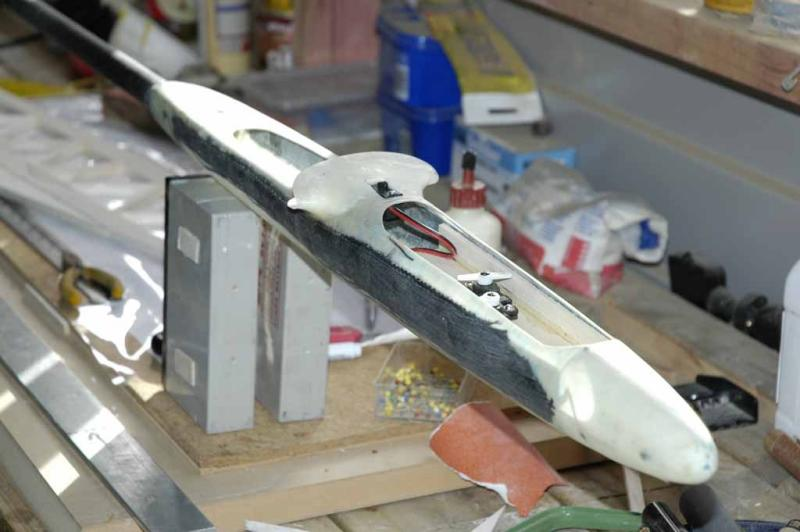
[picture p138: Photos/BD glass pod.jpg]
BD glass pod

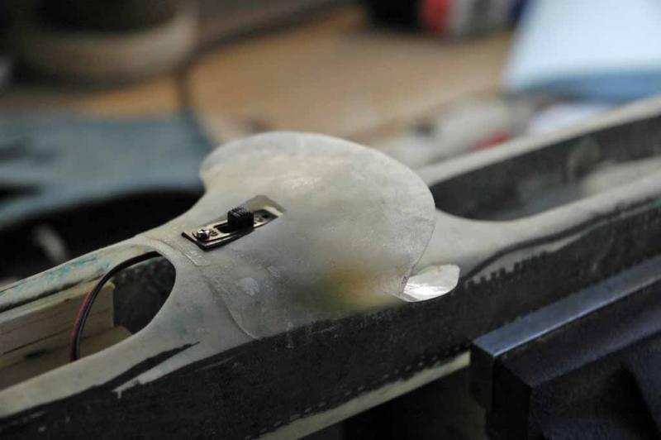
[picture p139: Photos/BD LE faring.jpg]
BD LE faring

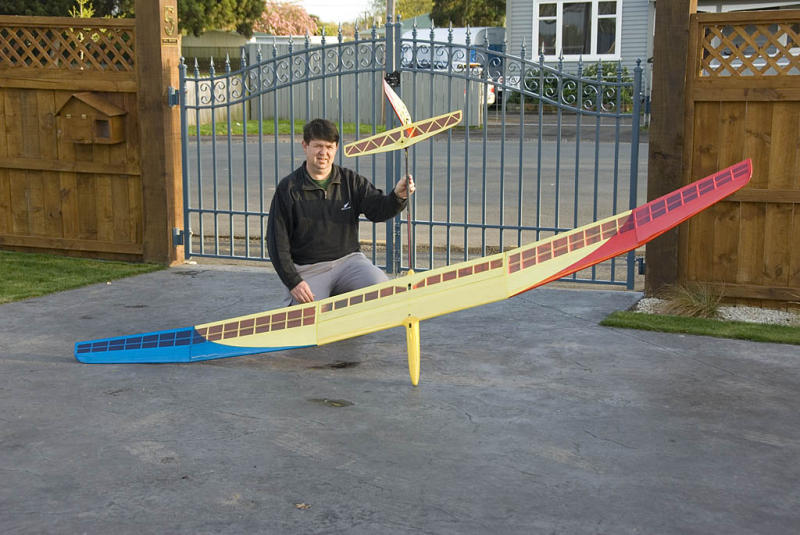
[picture p140: Photos/Bubble Dancer 3.jpg]
Bubble Dancer 3

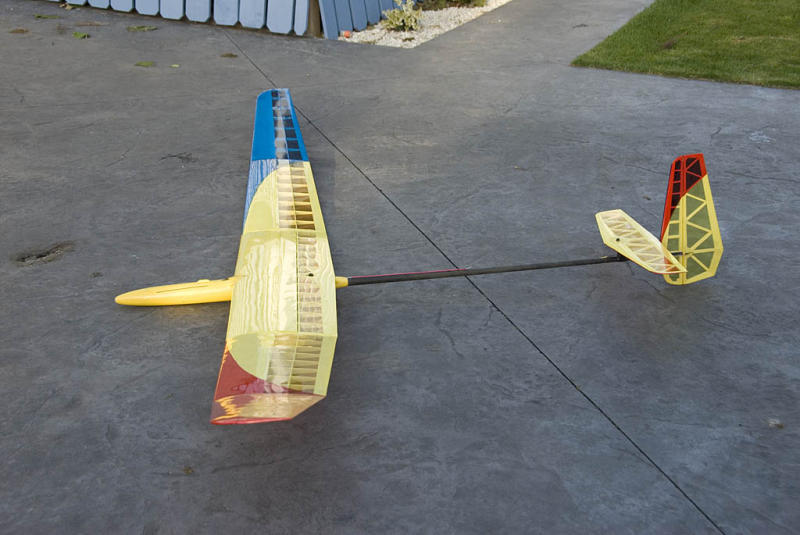
[picture p141: Photos/Bubble Dancer 2.jpg]
Bubble Dancer 2

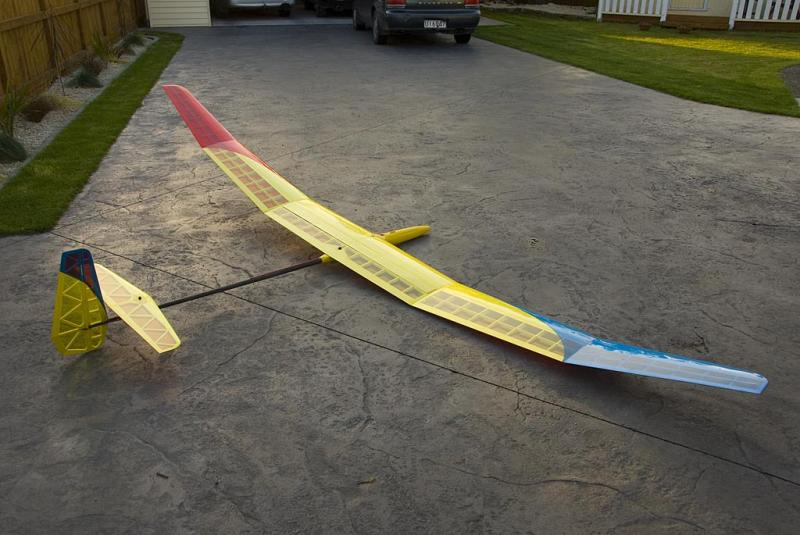
[picture p142: Photos/Bubble Dancer 1.jpg]
Bubble Dancer 1

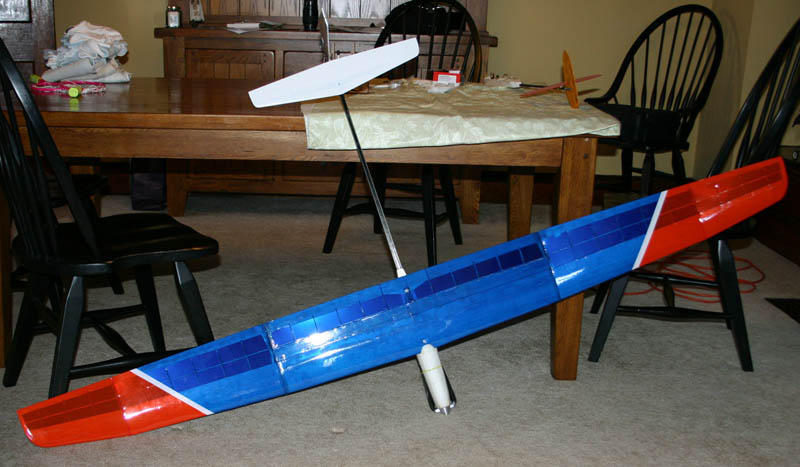
[picture p143: Photos/Allegro E-Lite.jpg]
Allegro E-Lite

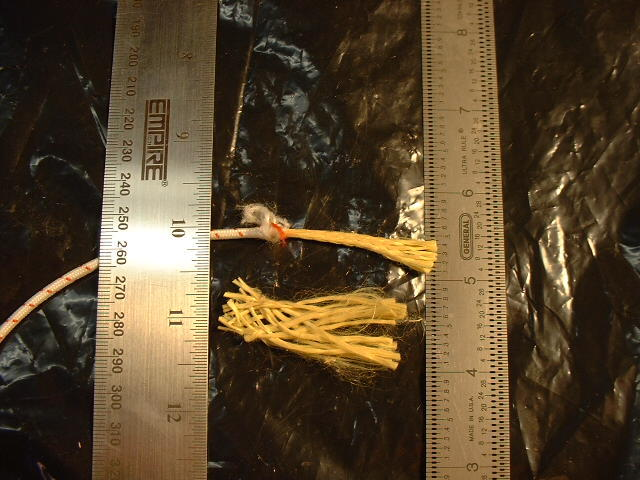
[picture p144: Photos/Kevlar 3-16in line striped down 004.jpg]
Kevlar 3-16in line striped down 004

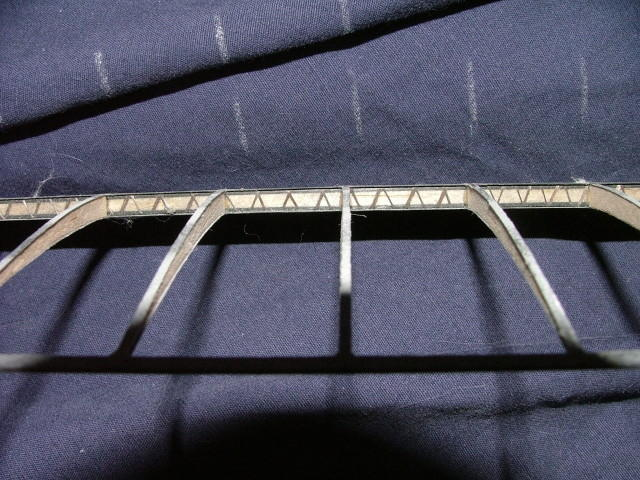
[picture p145: Photos/alto 018.jpg]
alto 018

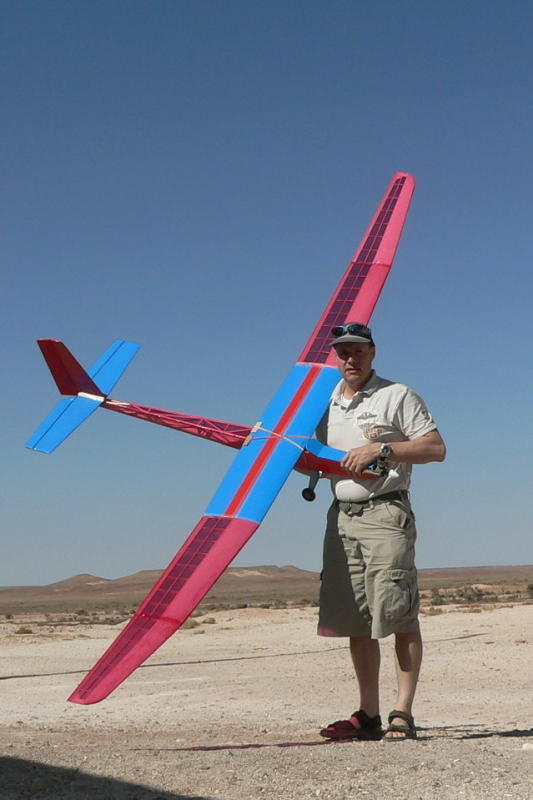
[picture p146: Photos/P1080160.jpg]
P1080160

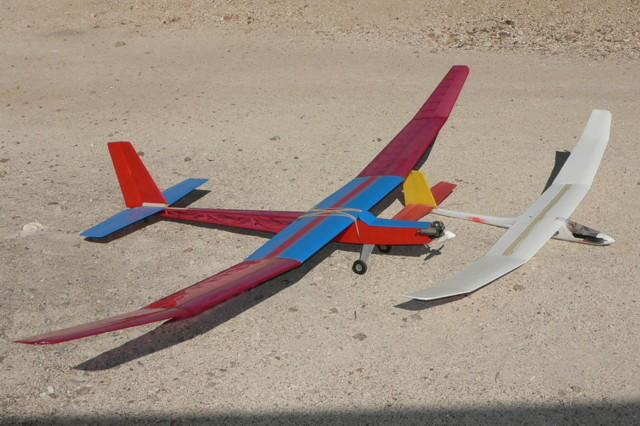
[picture p147: Photos/Alegro lite and Bubble dancer.jpg]
Alegro lite and Bubble dancer

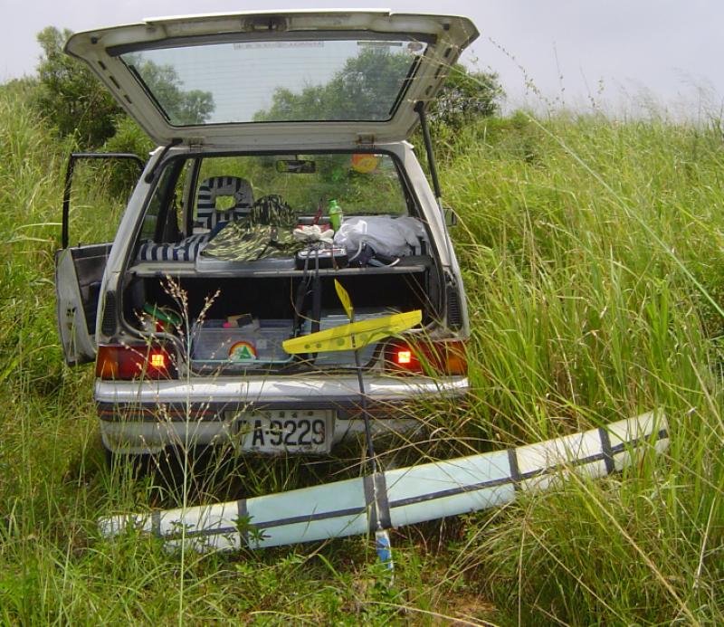
[picture p148: Photos/On the slope.jpg]
On the slope

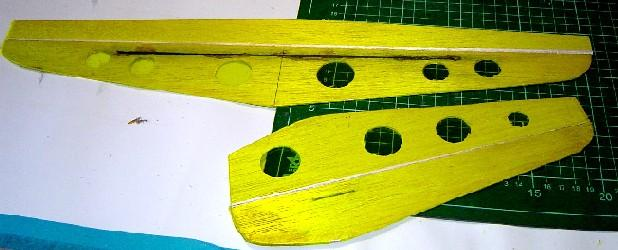
[picture p149: Photos/Tail & Elev.jpg]
Tail & Elev

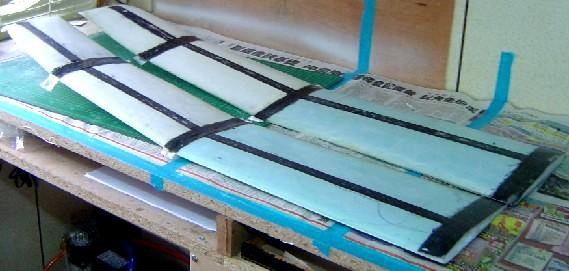
[picture p150: Photos/Wing after Vac.jpg]
Wing after Vac

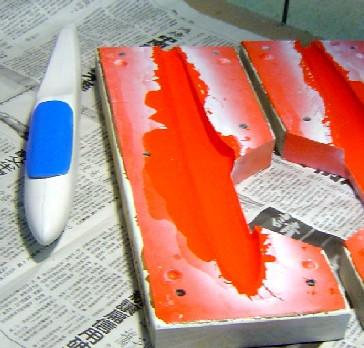
[picture p151: Photos/Fuse mold.jpg]
Fuse mold

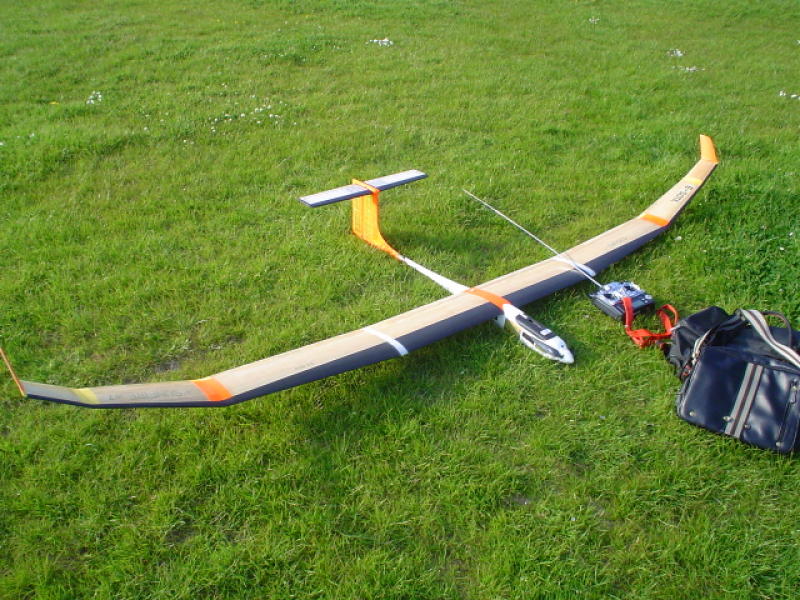
[picture p152: Photos/E-Sona.jpg]
E-Sona

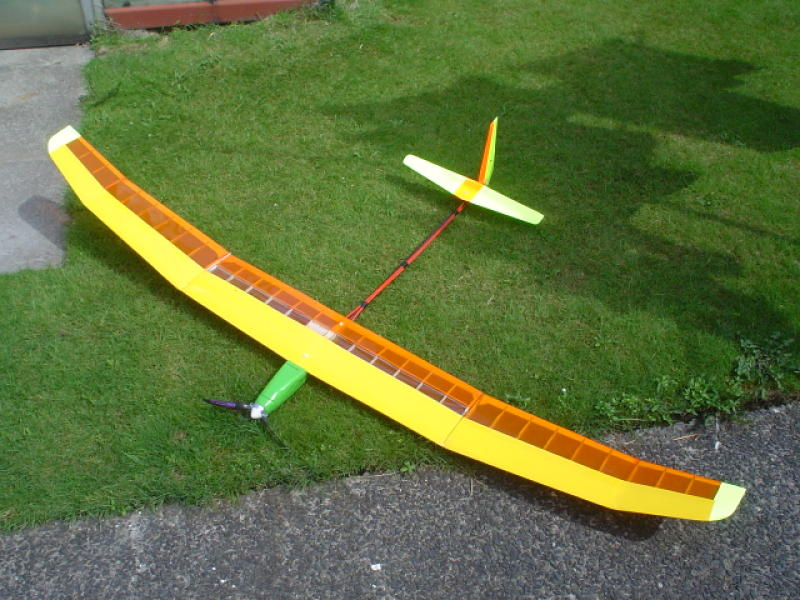
[picture p153: Photos/E-allegro.jpg]
E-allegro

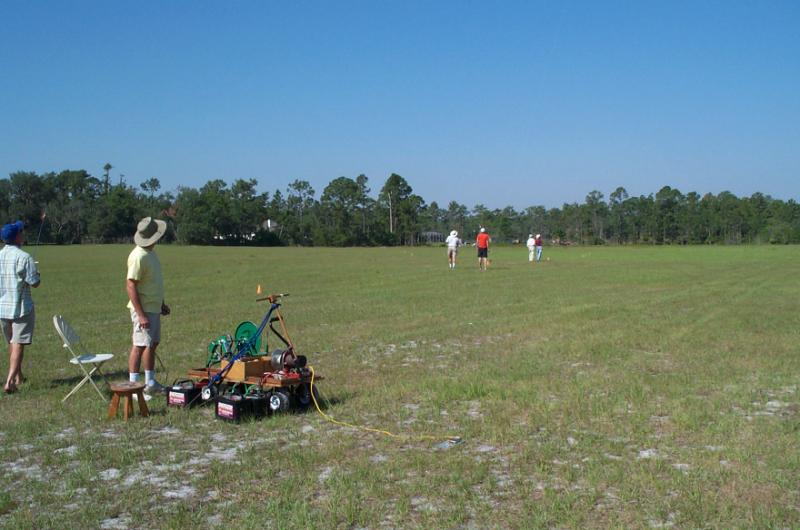
[picture p154: Photos/Gentle Lady Plus 2006 009.jpg]
Gentle Lady Plus 2006 009

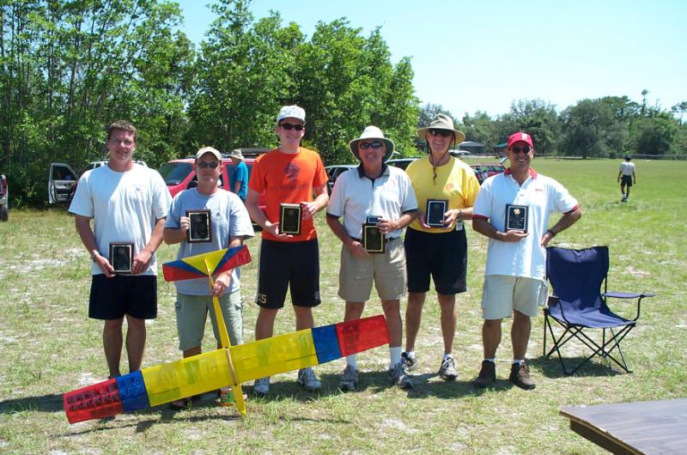
[picture p155: Photos/Gentle Lady Plus 2006 023.jpg]
Gentle Lady Plus 2006 023

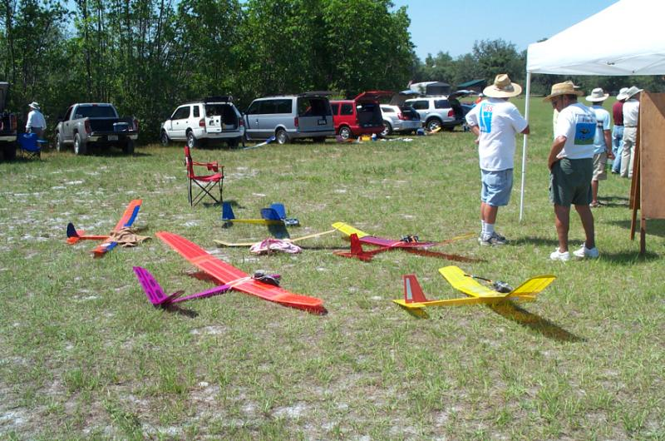
[picture p156: Photos/Gentle Lady Plus 2006 021.jpg]
Gentle Lady Plus 2006 021

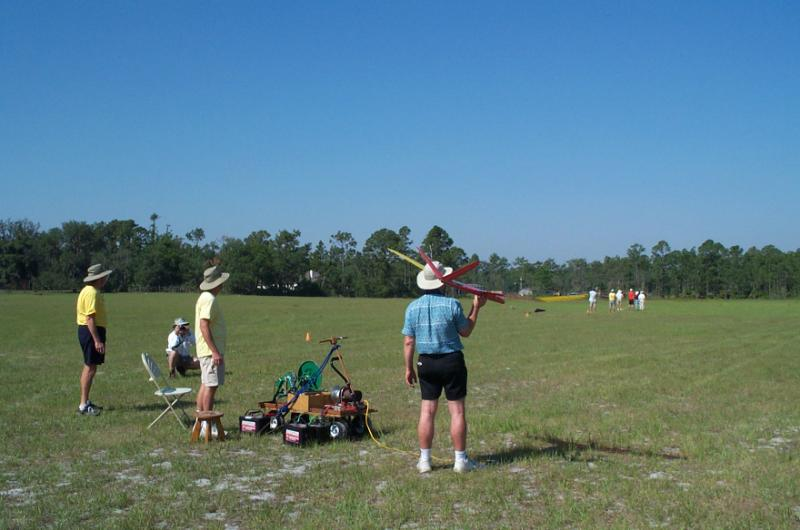
[picture p157: Photos/Gentle Lady Plus 2006 011.jpg]
Gentle Lady Plus 2006 011

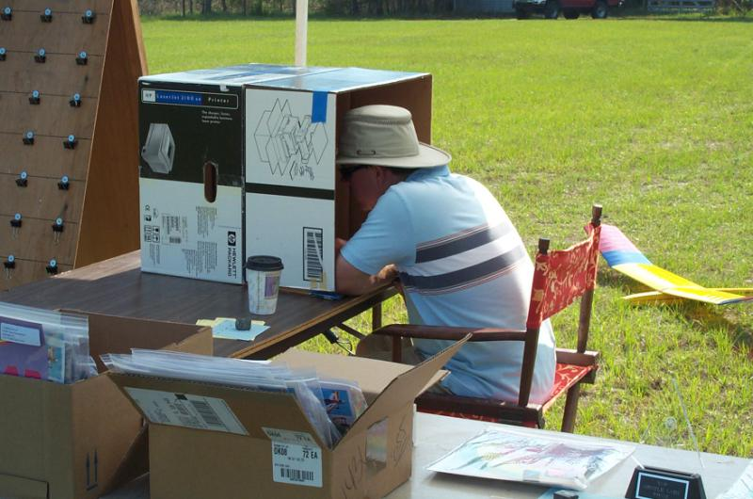
[picture p158: Photos/Score keeper in the box.jpg]
Score keeper in the box

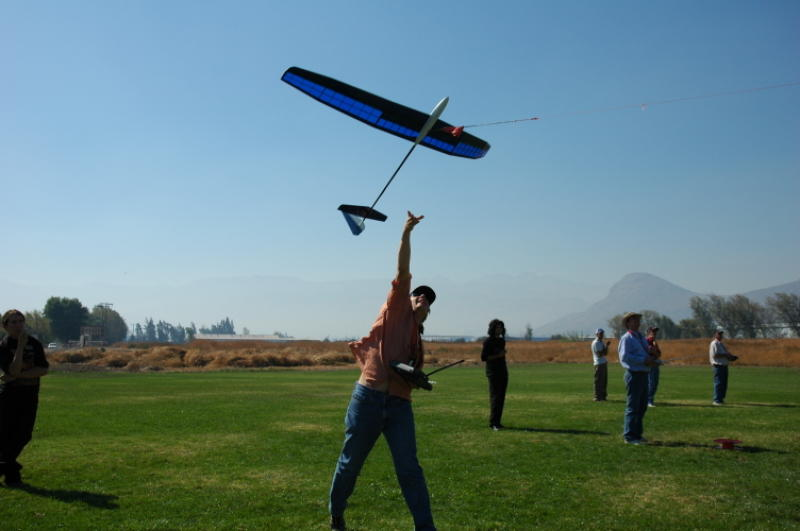
[picture p159: Photos/Me and my Allegro.jpg]
Me and my Allegro

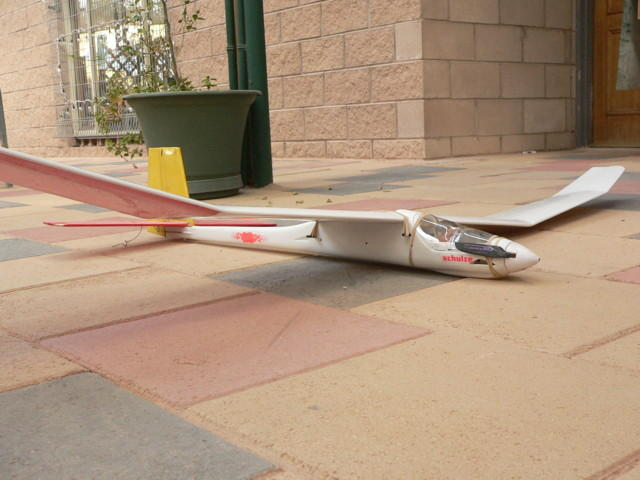
[picture p160: Photos/P1050283.jpg]
P1050283

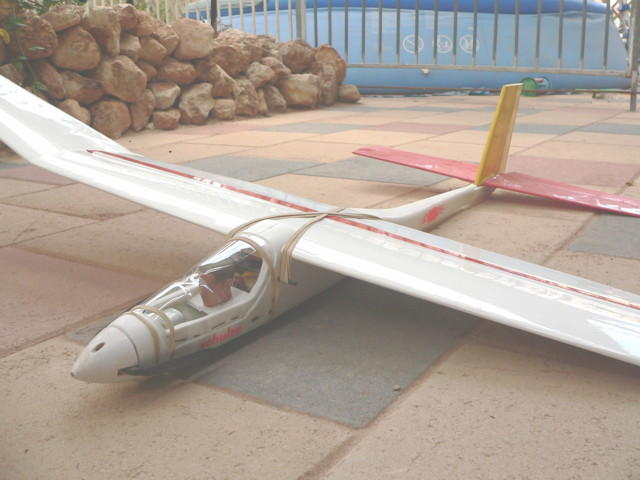
[picture p161: Photos/P1050287.jpg]
P1050287

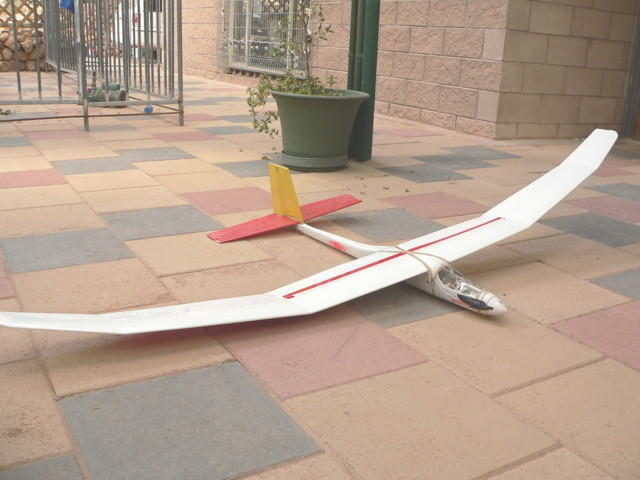
[picture p162: Photos/Allegro.jpg]
Allegro

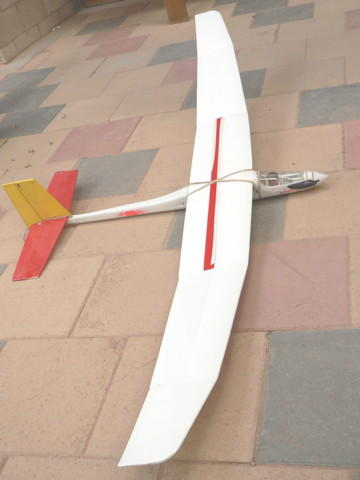
[picture p163: Photos/P1050284.jpg]
P1050284

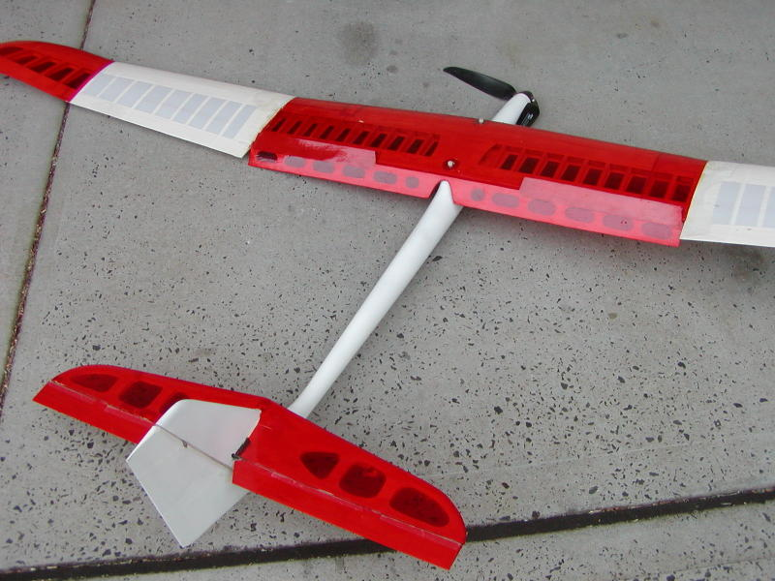
[picture p164: Photos/Mandrella Flap.jpg]
Mandrella Flap

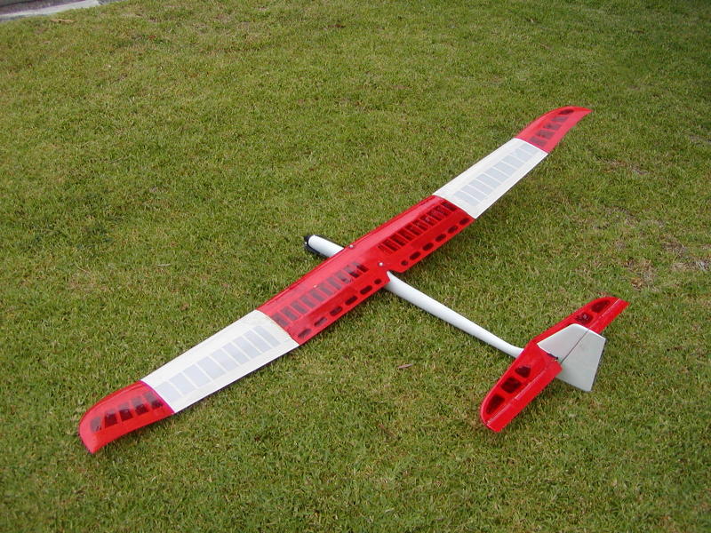
[picture p165: Photos/Mandrella2.jpg]
Mandrella2

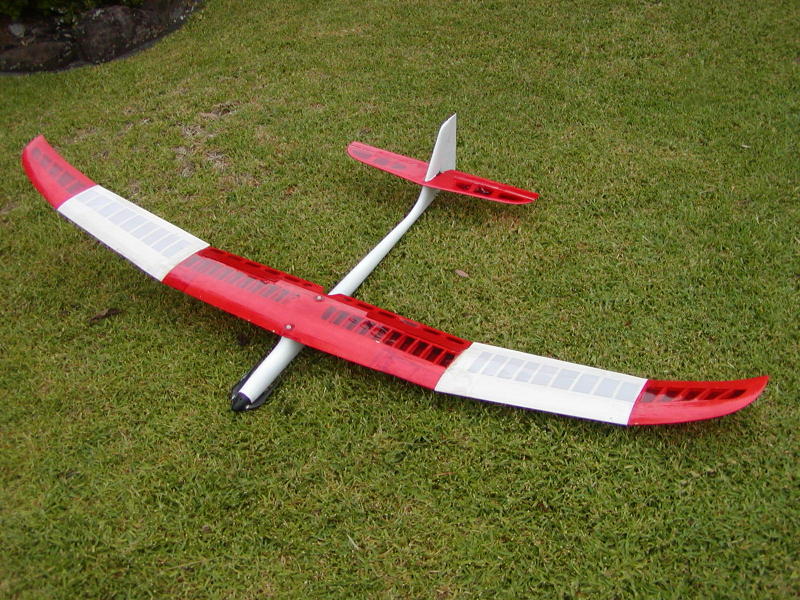
[picture p166: Photos/Mandrella1.jpg]
Mandrella1

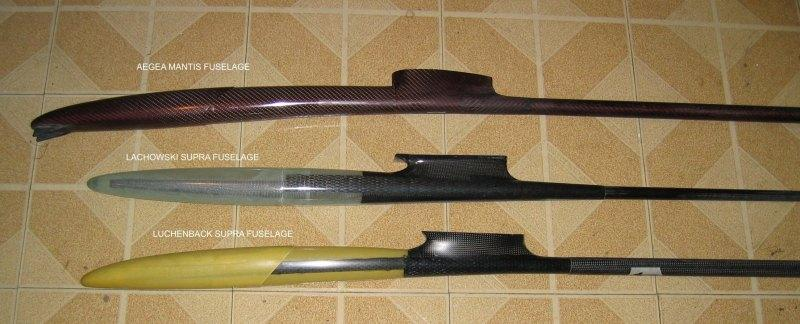
[picture p167: Photos/Fuselages.jpg]
Fuselages

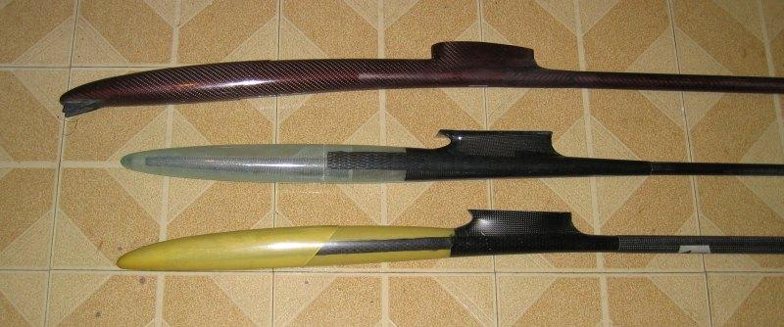
[picture p168: Photos/pod shapes.jpg]
pod shapes

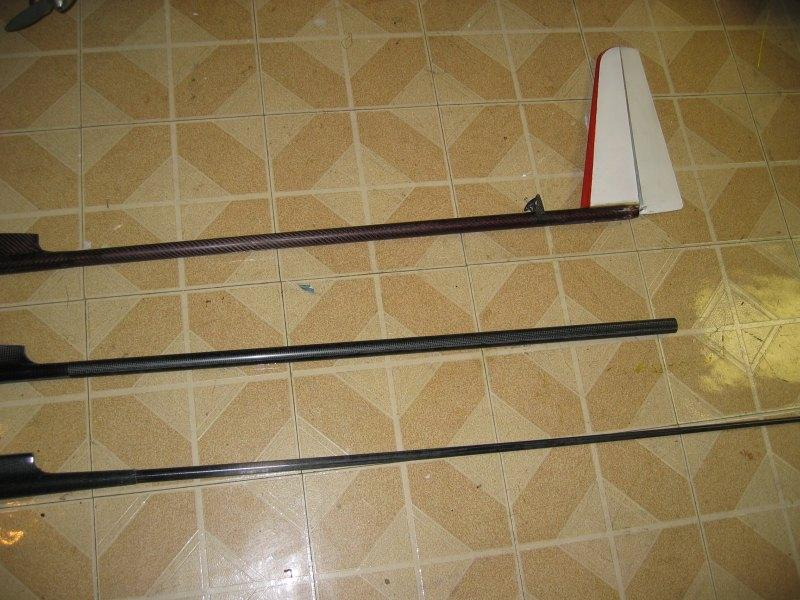
[picture p169: Photos/Tail booms.jpg]
Tail booms

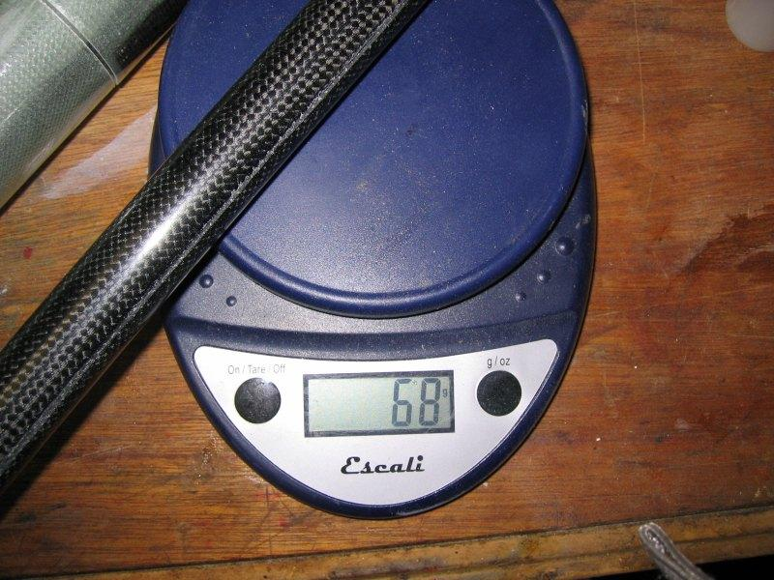
[picture p170: Photos/Terry's boom.jpg]
Terry's boom

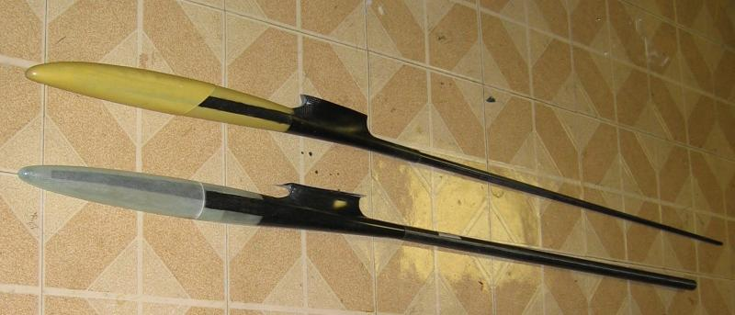
[picture p171: Photos/Fuselage mixmatch.jpg]
Fuselage mixmatch

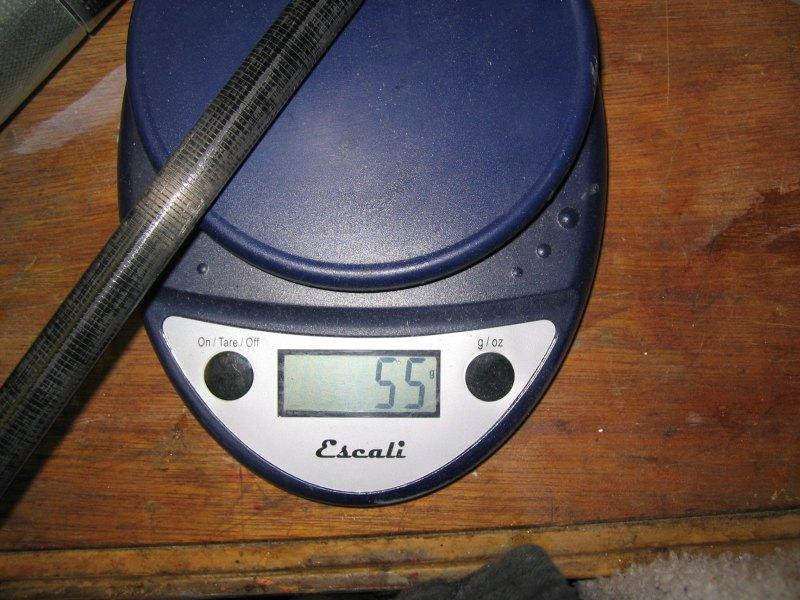
[picture p172: Photos/Rick's Bubble-Dancer Boom.jpg]
Rick's Bubble-Dancer Boom

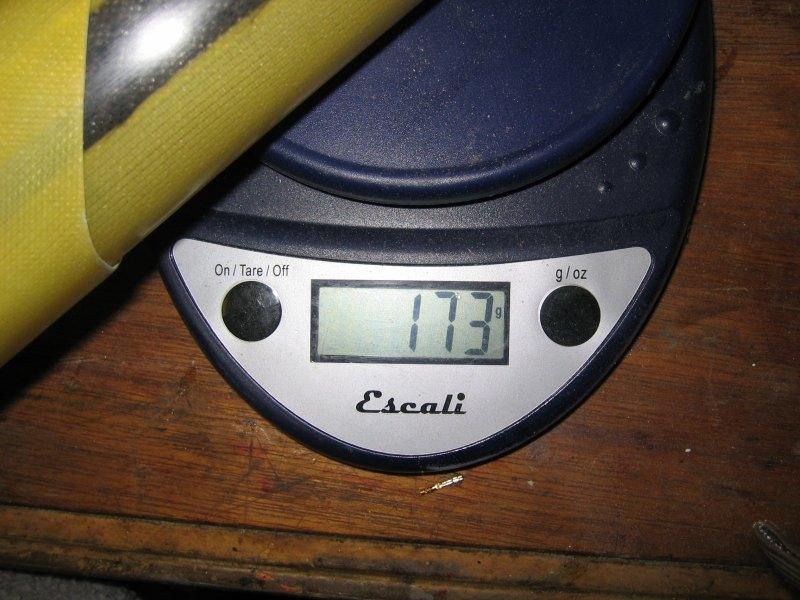
[picture p173: Photos/Terry's pod.jpg]
Terry's pod

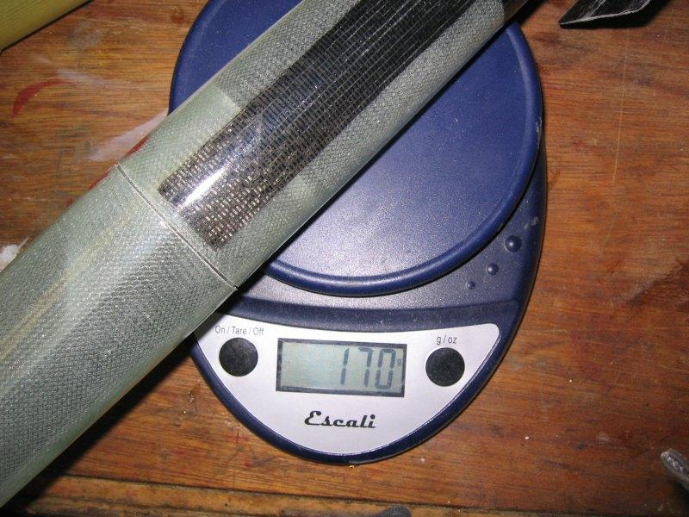
[picture p174: Photos/Mike's Pod.jpg]
Mike's Pod

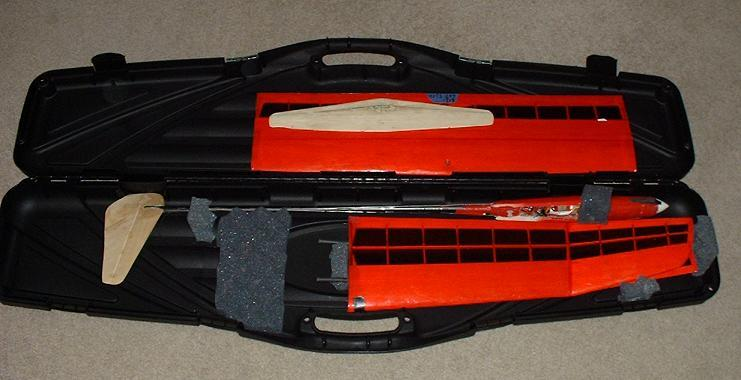
[picture p175: Photos/Rifle Case 1.jpg]
Rifle Case 1

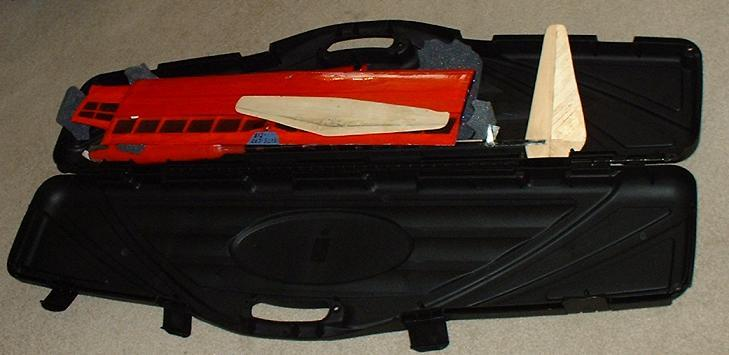
[picture p176: Photos/Rifle Case 2.jpg]
Rifle Case 2

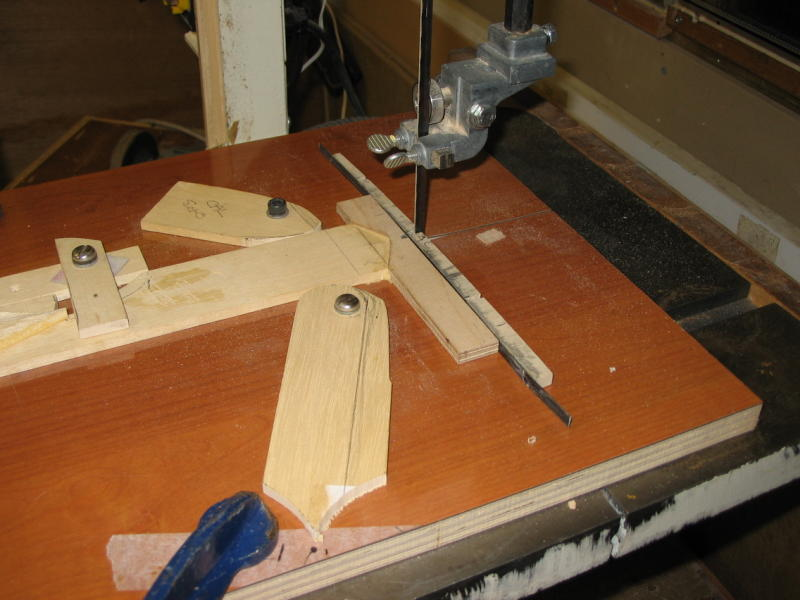
[picture p177: Photos/spar slotting jig.jpg]
spar slotting jig

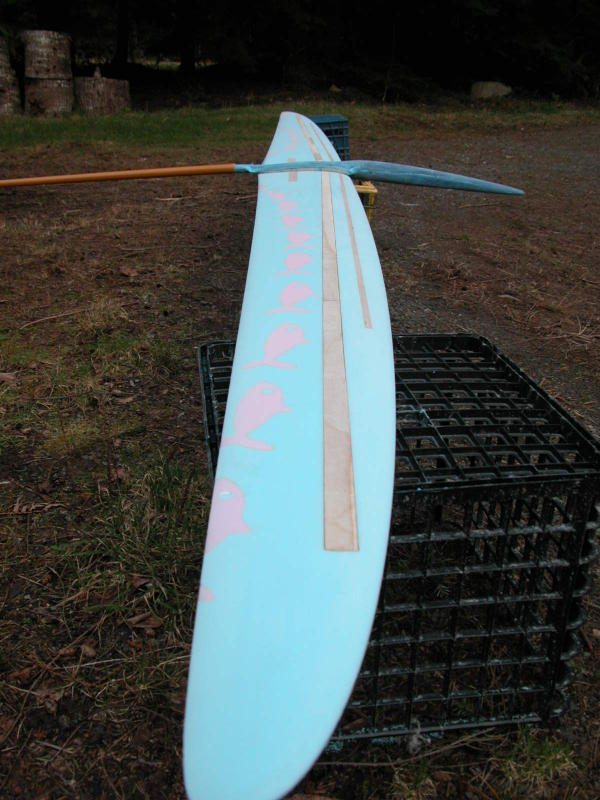
[picture p178: Photos/Quick component check.jpg]
Quick component check

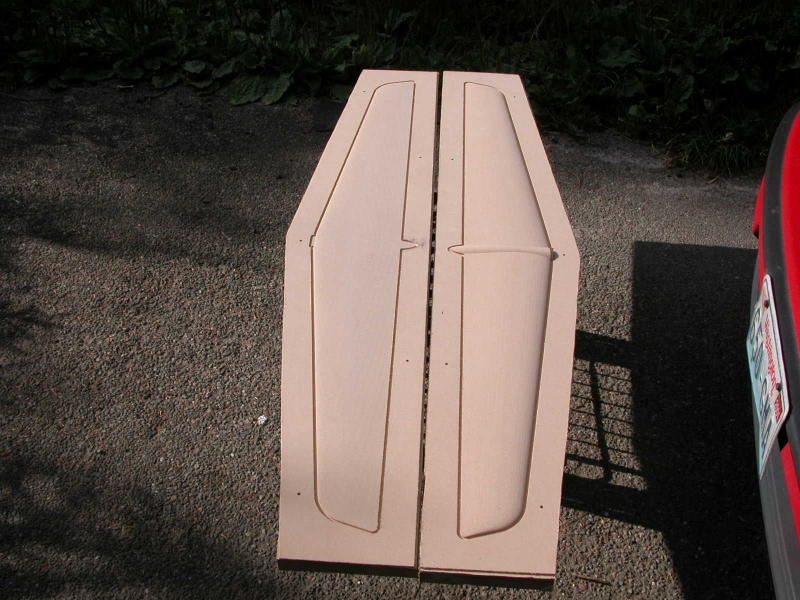
[picture p179: Photos/Plugs for high speed electric racer.jpg]
Plugs for high speed electric racer

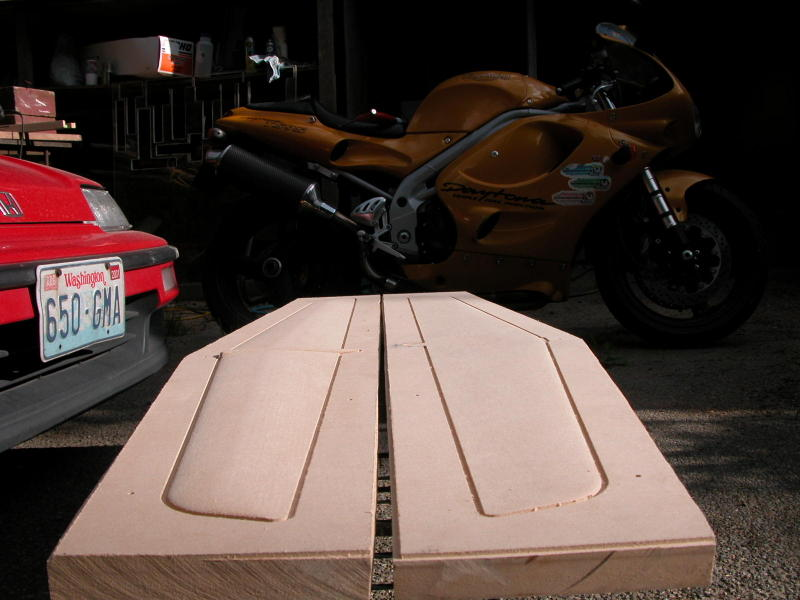
[picture p180: Photos/Exotic part line.jpg]
Exotic part line

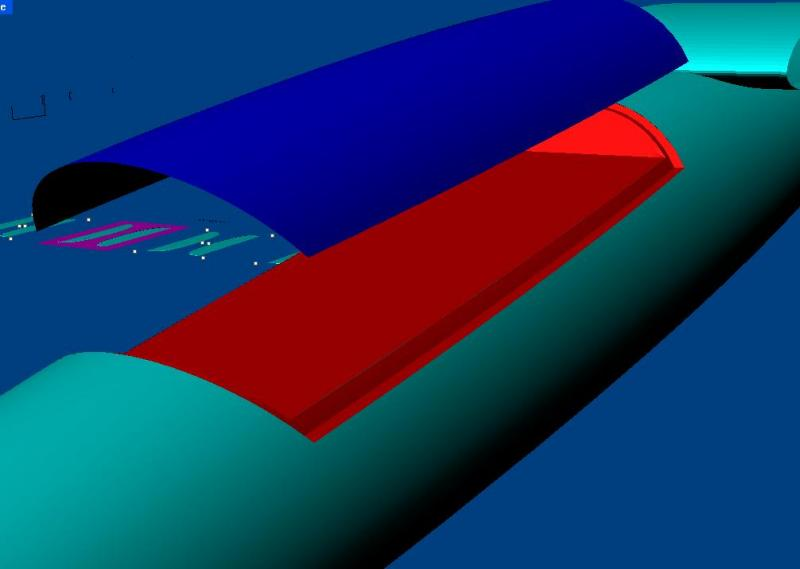
[picture p181: Photos/Canopy Rest.jpg]
Canopy Rest

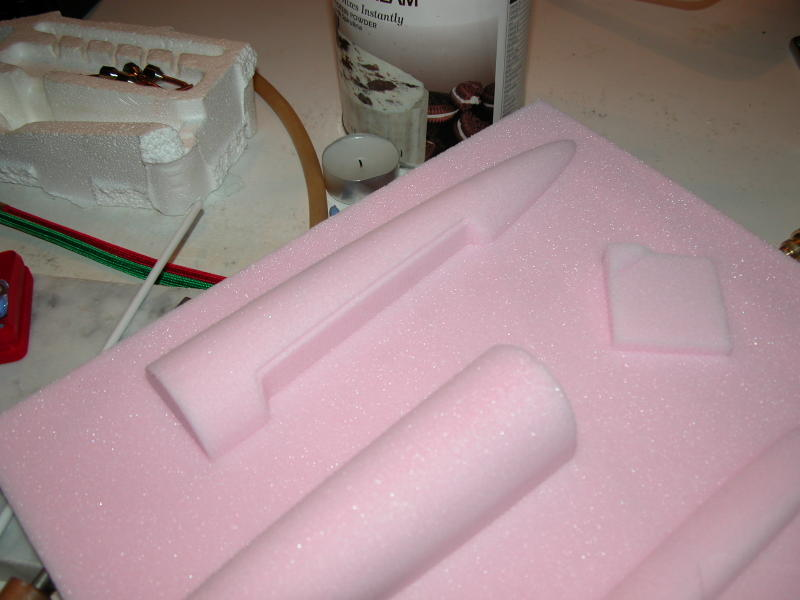
[picture p182: Photos/Pre-carve proof piece.jpg]
Pre-carve proof piece

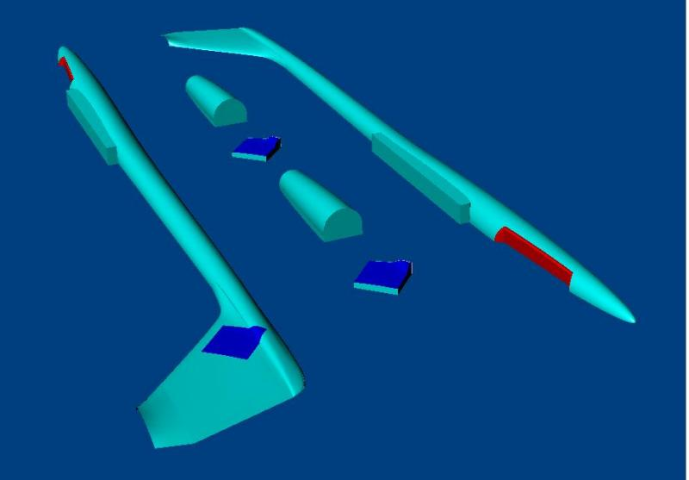
[picture p183: Photos/Ready to carve.jpg]
Ready to carve

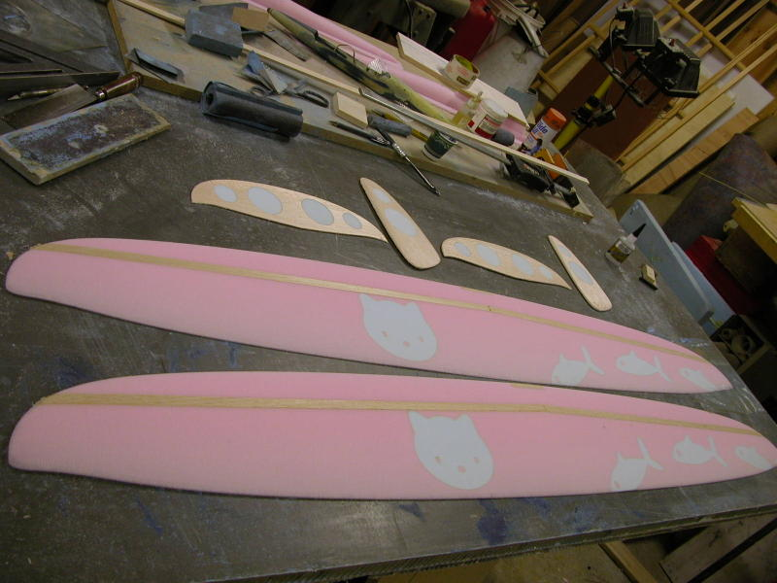
[picture p184: Photos/SunToucher HLG.jpg]
SunToucher HLG

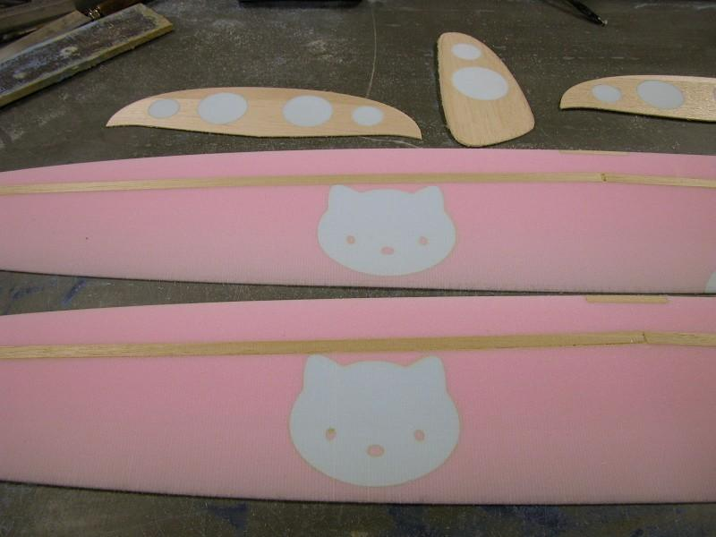
[picture p185: Photos/SunToucher HLG wing Detail.jpg]
SunToucher HLG wing Detail

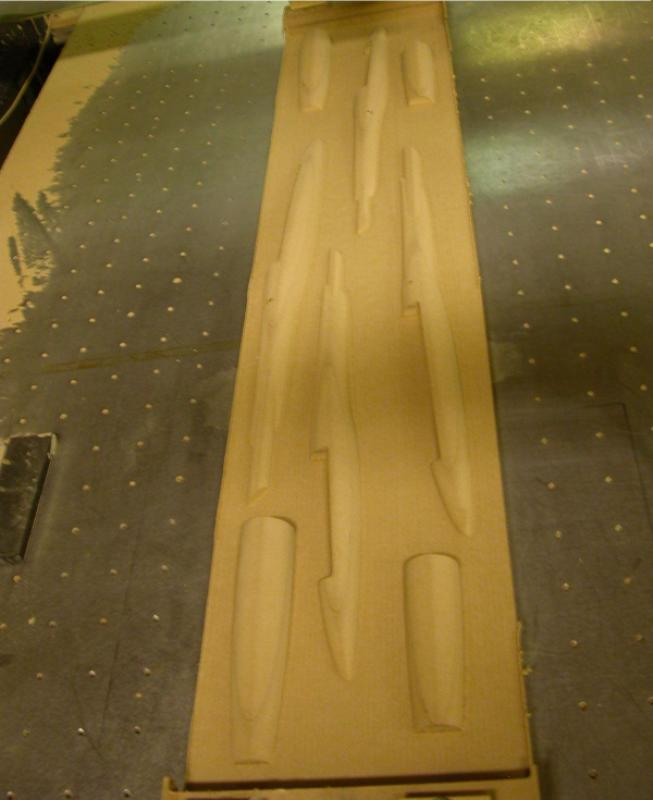
[picture p186: Photos/MDF Pod Molds.jpg]
MDF Pod Molds

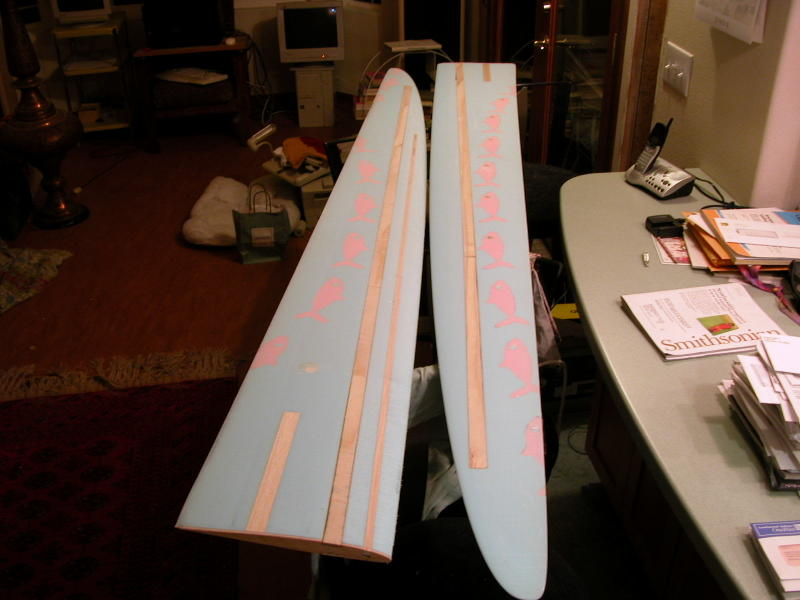
[picture p187: Photos/Grand Imperial wings.jpg]
Grand Imperial wings

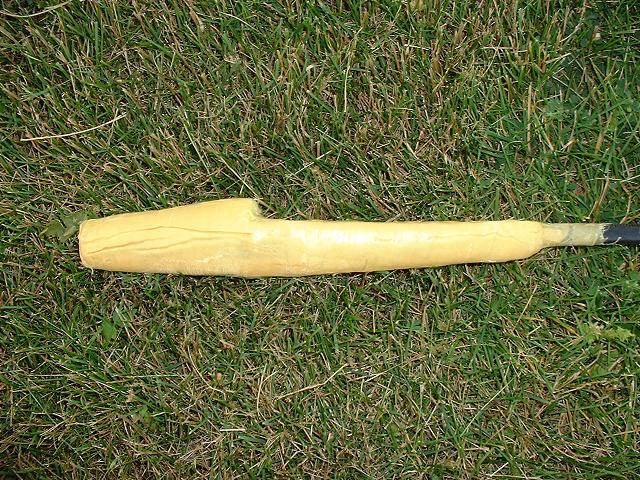
[picture p188: Photos/AllegroPod post layup.jpg]
AllegroPod post layup

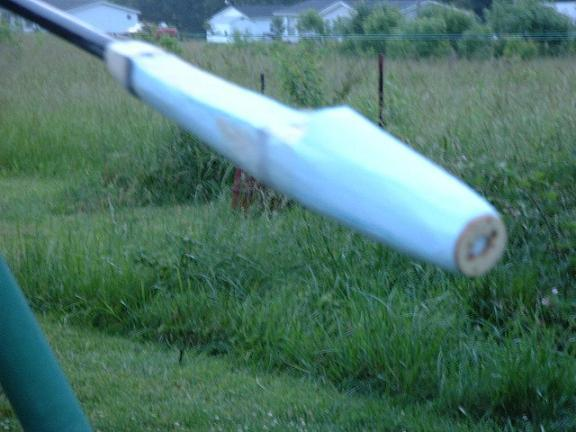
[picture p189: Photos/Allegro Pod ready for layup.jpg]
Allegro Pod ready for layup

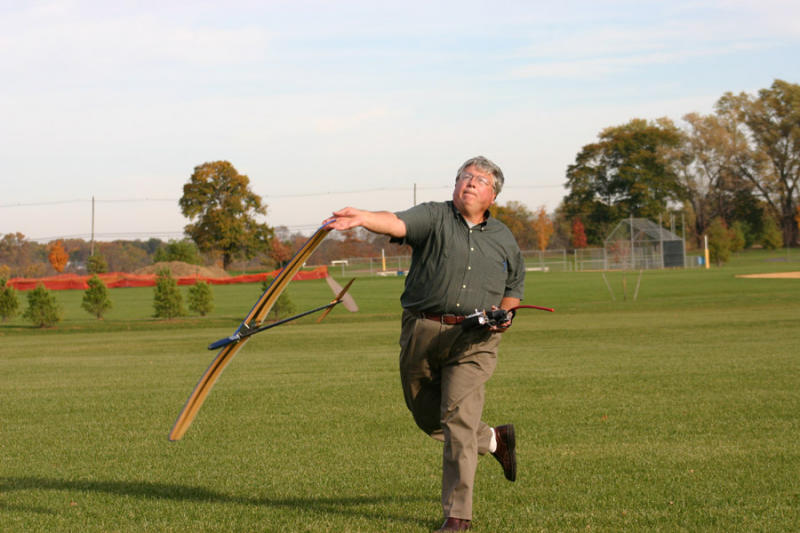
[picture p190: Photos/Flex.jpg]
Flex

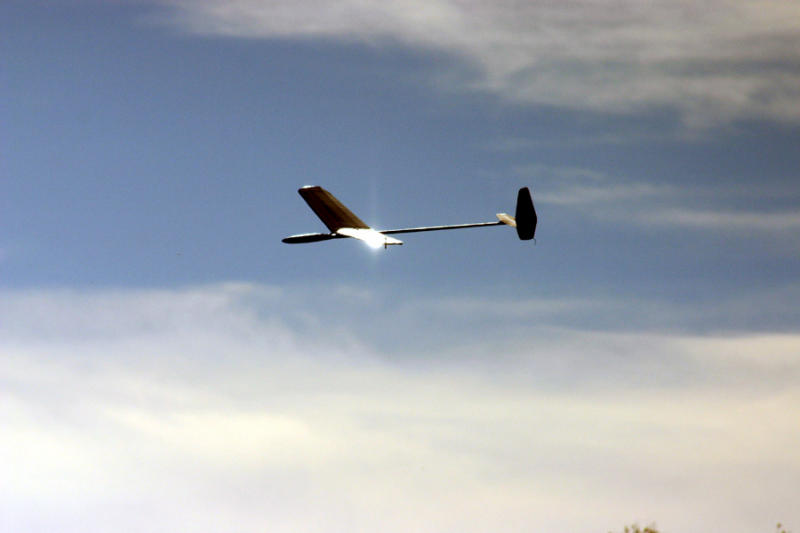
[picture p191: Photos/shine.jpg]
shine

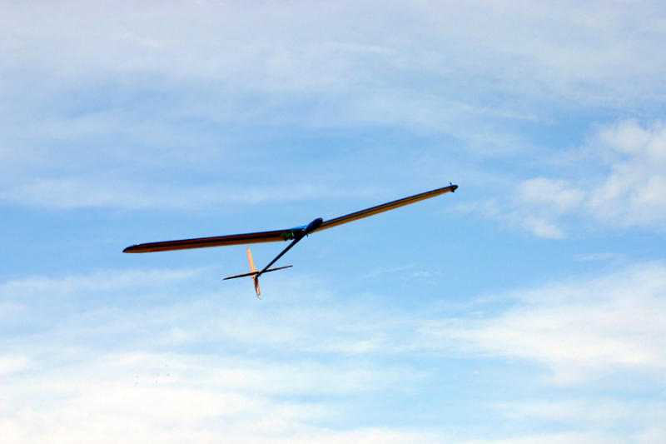
[picture p192: Photos/Flight3.jpg]
Flight3

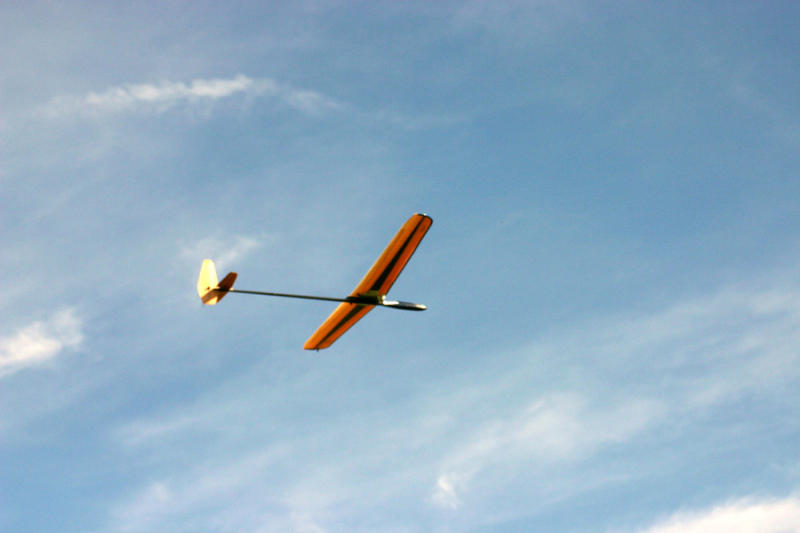
[picture p193: Photos/Flight2.jpg]
Flight2

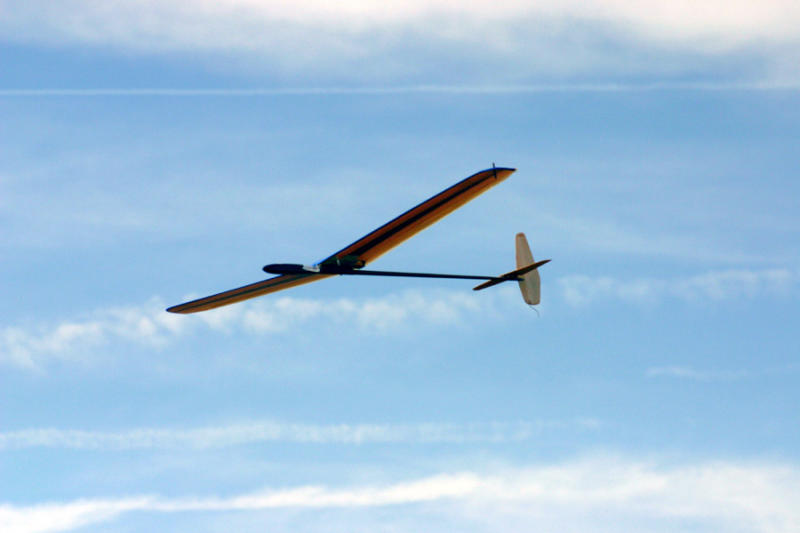
[picture p194: Photos/flight.jpg]
flight

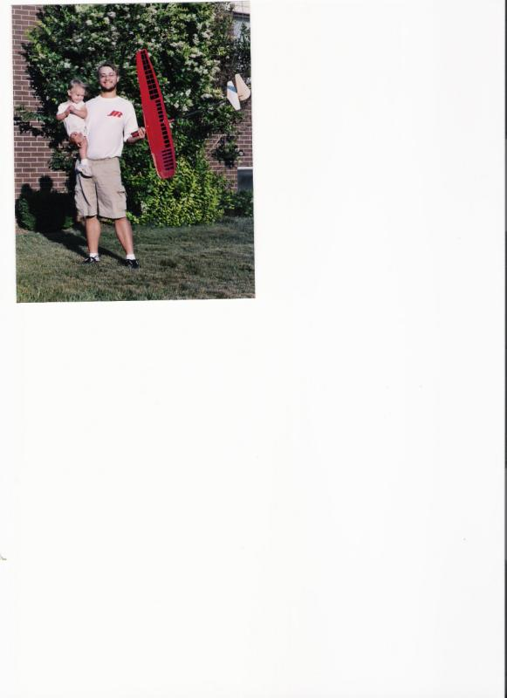
[picture p195: Photos/My daughter wanted in this pic.jpg]
My daughter wanted in this pic

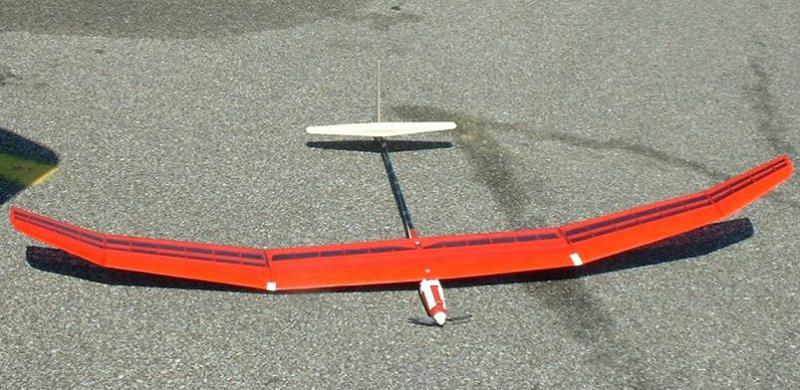
[picture p196: Photos/eAllegro4.small.jpg]
eAllegro4.small

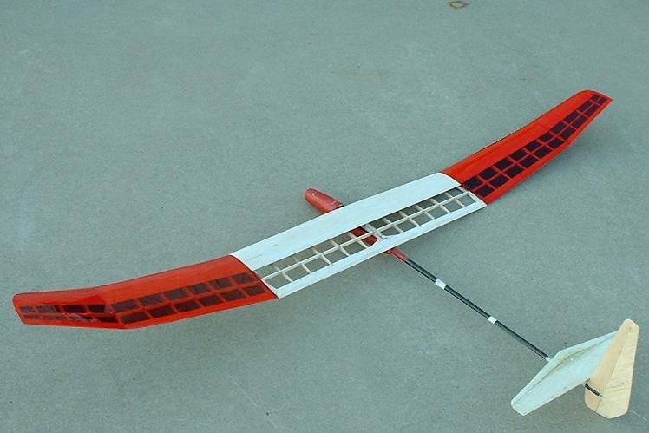
[picture p197: Photos/Allegro Mock up8.jpg]
Allegro Mock up8

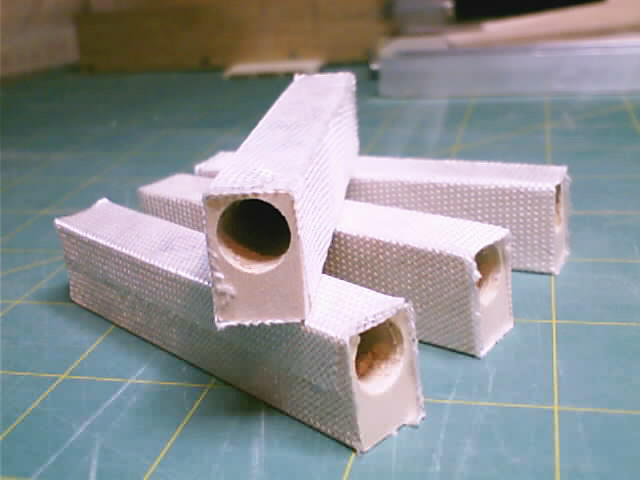
[picture p198: Photos/wing joiner blocks.jpg]
wing joiner blocks

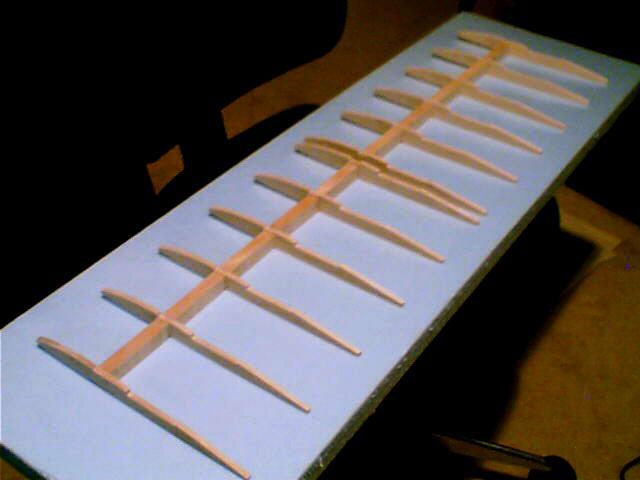
[picture p199: Photos/center panel mock up.jpg]
center panel mock up

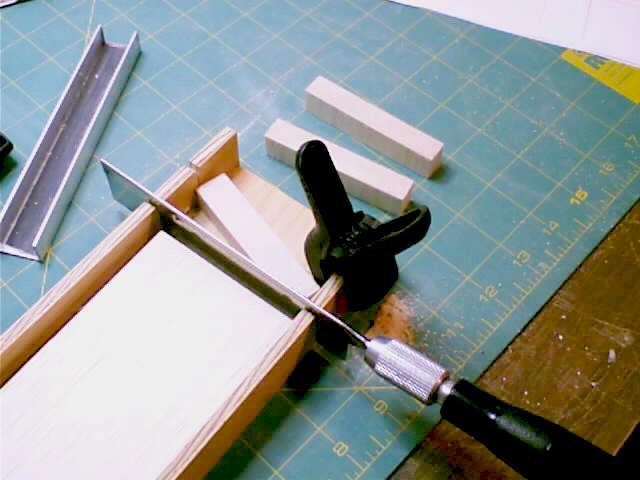
[picture p200: Photos/miter box for web cutting.jpg]
miter box for web cutting

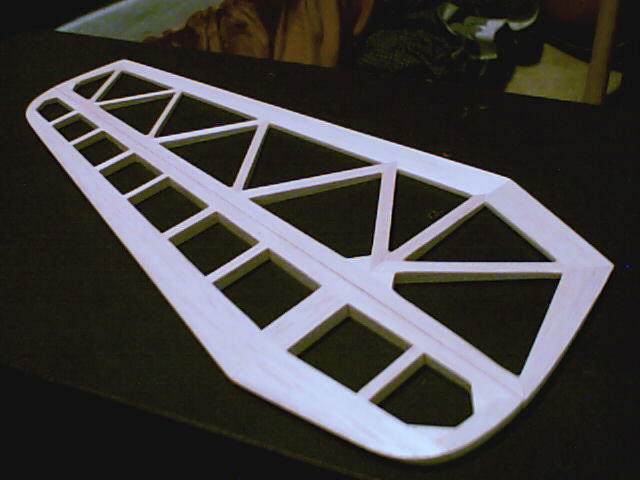
[picture p201: Photos/rudder.jpg]
rudder

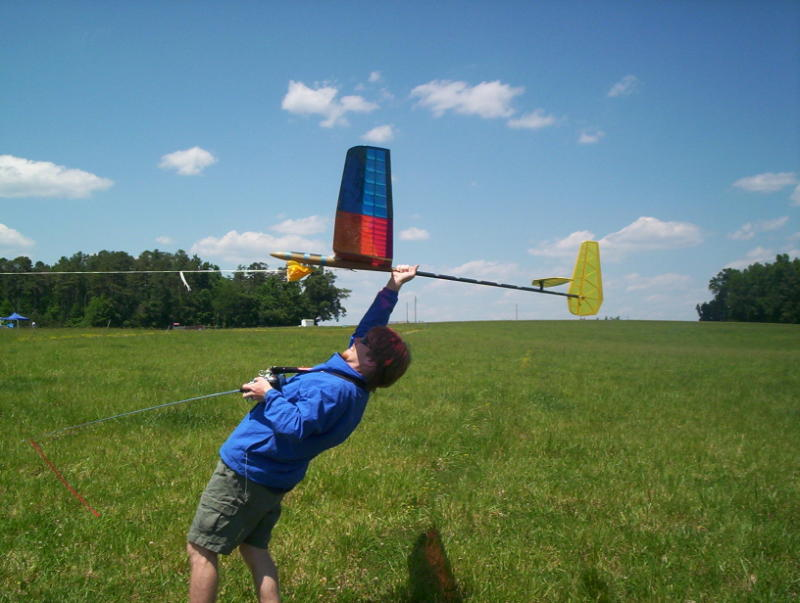
[picture p202: Photos/Dan's BD -- About to launch.jpg]
Dan's BD -- About to launch

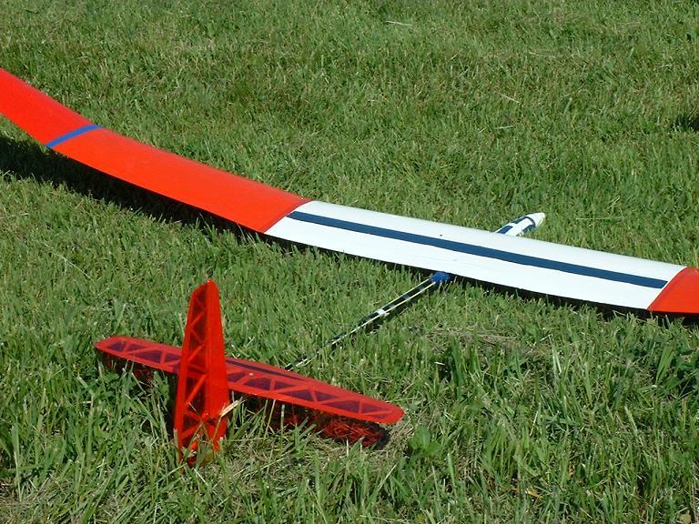
[picture p203: Photos/BubbleDancer1.small.jpg]
BubbleDancer1.small

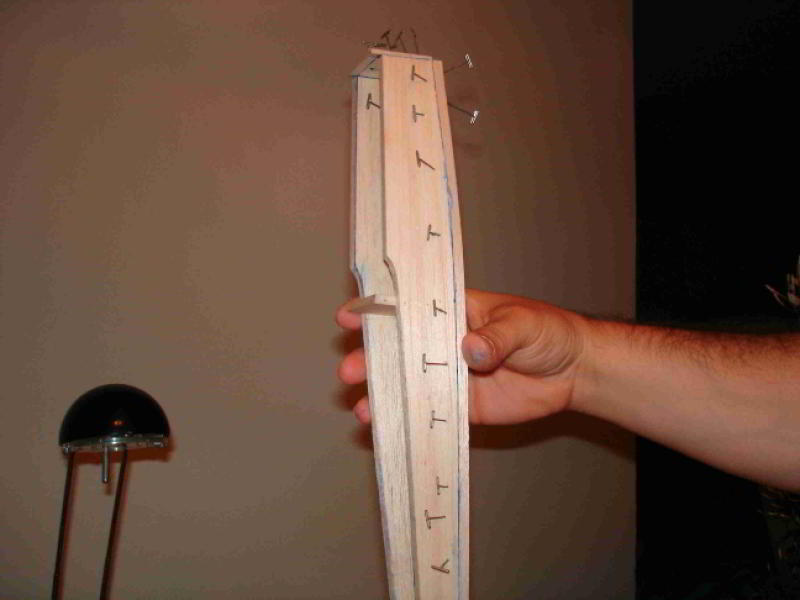
[picture p204: Photos/Fuse Bottom & Sides Joined.jpg]
Fuse Bottom & Sides Joined

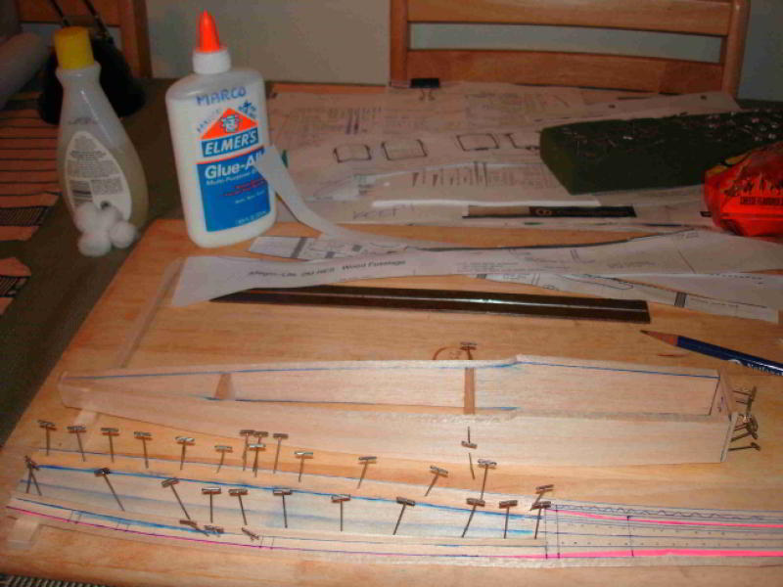
[picture p205: Photos/Fuselage Build2.jpg]
Fuselage Build2

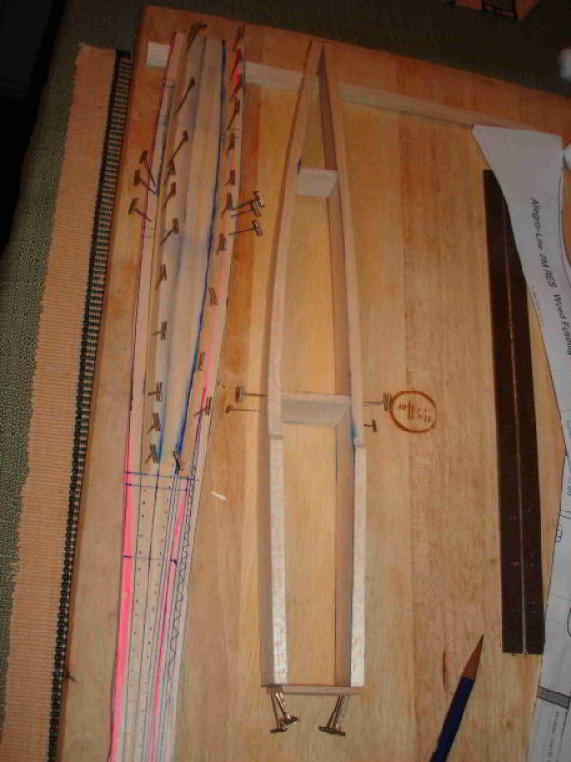
[picture p206: Photos/Fuselage Build1.jpg]
Fuselage Build1

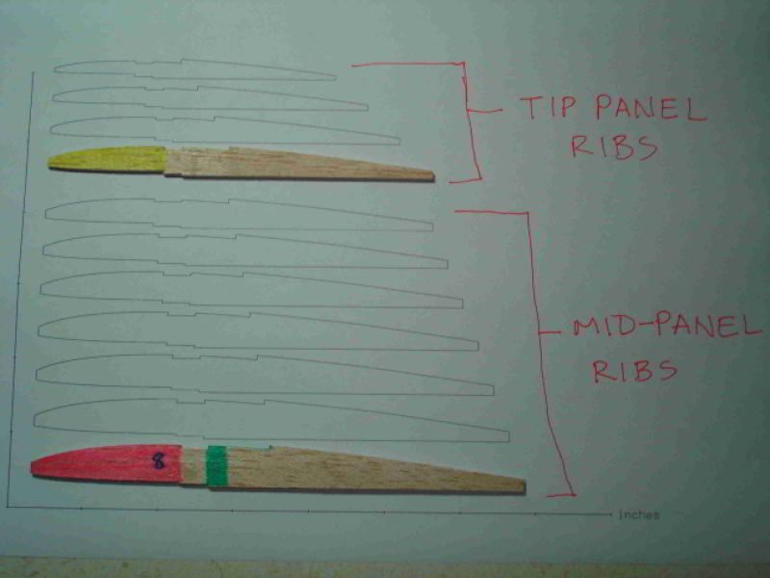
[picture p207: Photos/AllegroRibs7.jpg]
AllegroRibs7

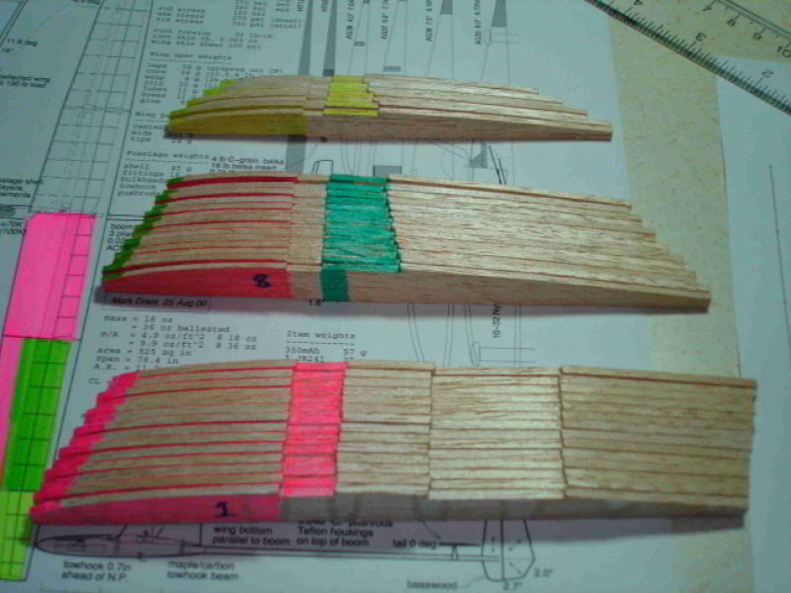
[picture p208: Photos/AllegroRibs5.jpg]
AllegroRibs5

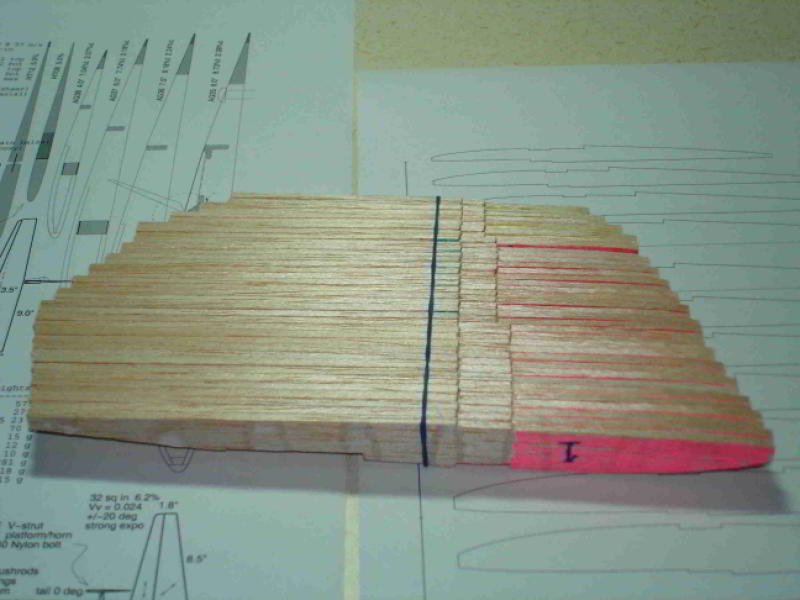
[picture p209: Photos/Rib Stack - Upside Down.jpg]
Rib Stack - Upside Down

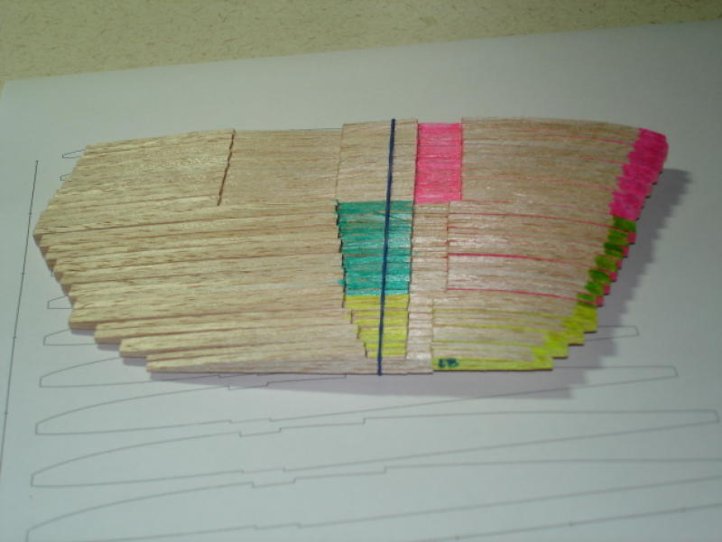
[picture p210: Photos/Tip Panel View of All Ribs.jpg]
Tip Panel View of All Ribs

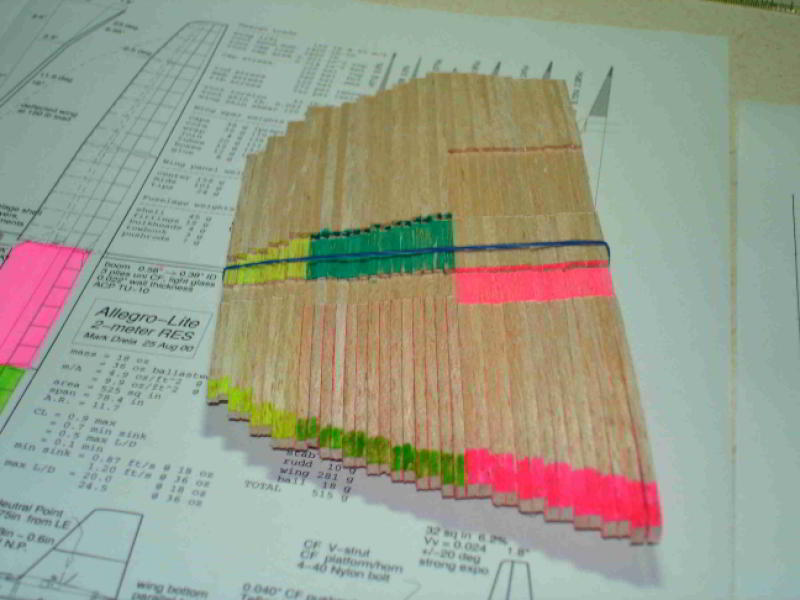
[picture p211: Photos/All Ribs - Leading Edge View.jpg]
All Ribs - Leading Edge View

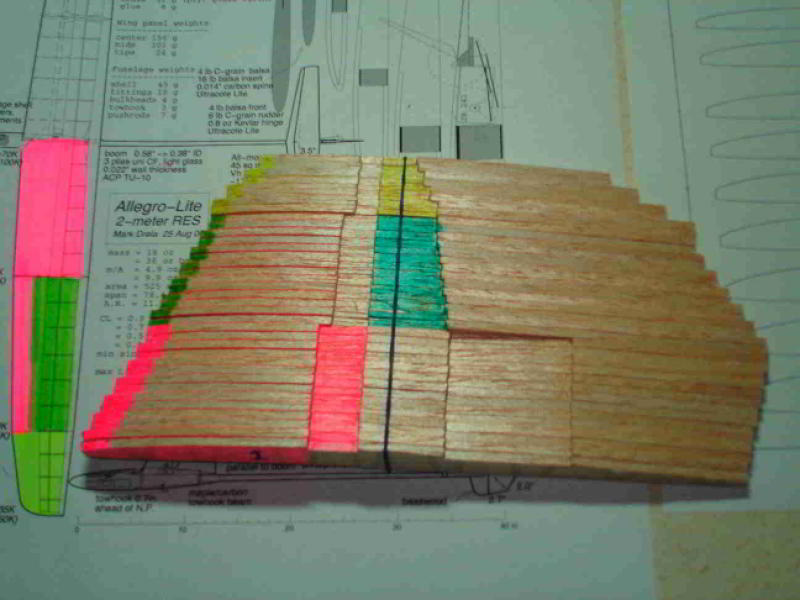
[picture p212: Photos/Stack of All Ribs.jpg]
Stack of All Ribs

n_a - 2019-11-24T231514.068
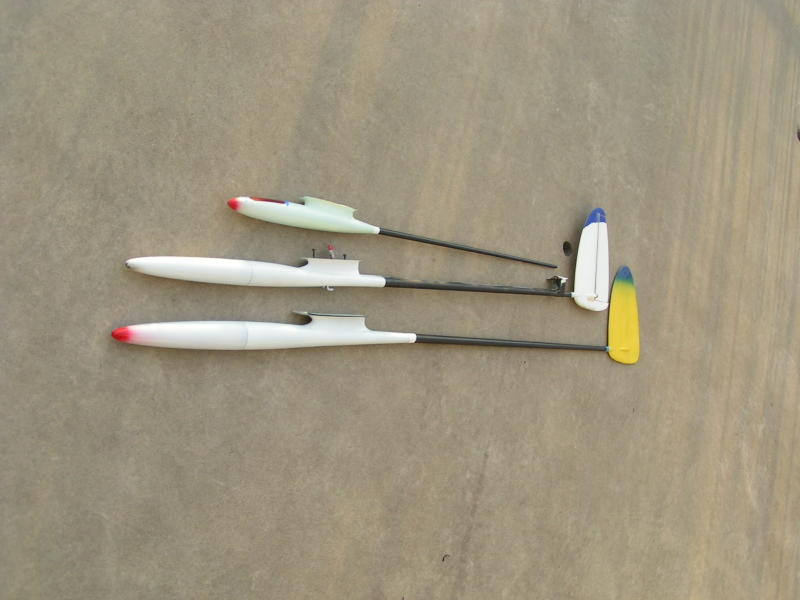
[picture p213: Photos/Mikes Fuselages.jpg]
Mikes Fuselages

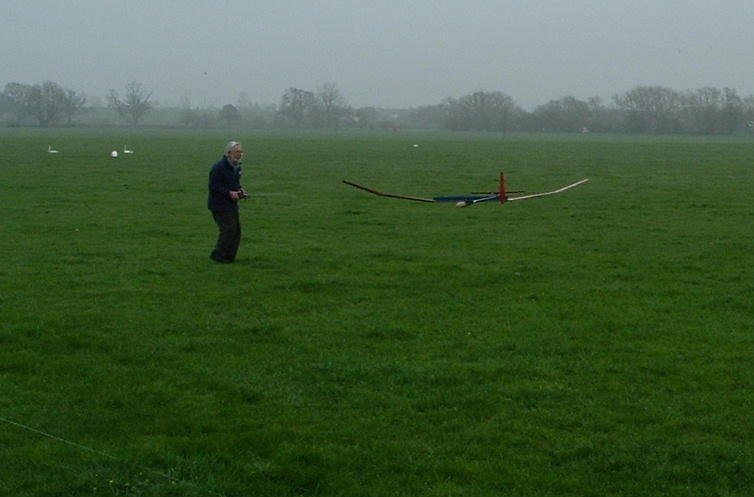
[picture p214: Photos/Malcolm White Fish Meadow UK.jpg]
Malcolm White Fish Meadow UK

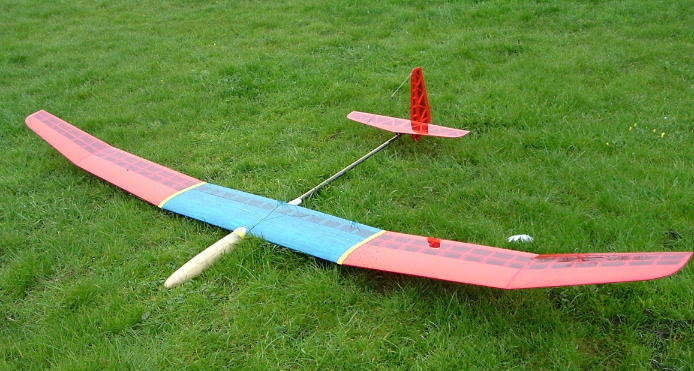
[picture p215: Photos/Malcolm White Malvern uk.jpg]
Malcolm White Malvern uk

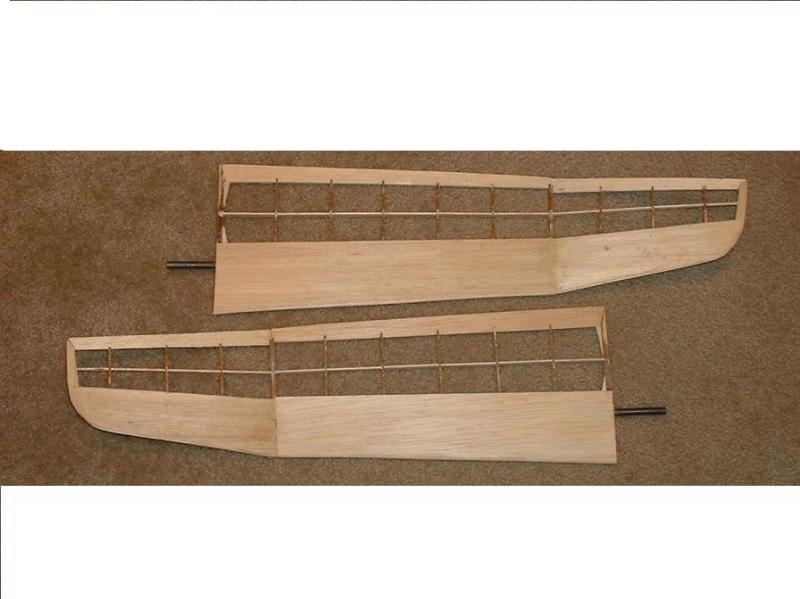
[picture p216: Photos/needs some sanding.jpg]
needs some sanding

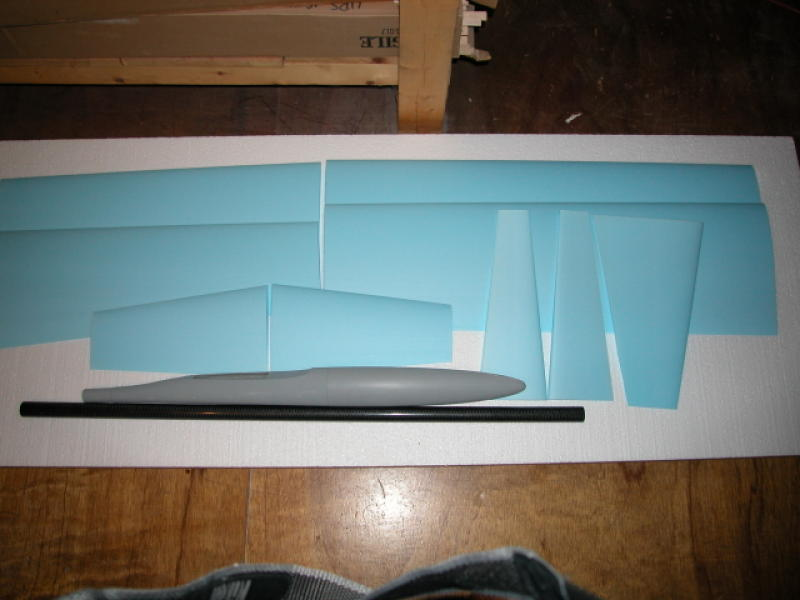
[picture p217: Photos/DSCN0226.jpg]
DSCN0226

Stretch Aegea #2
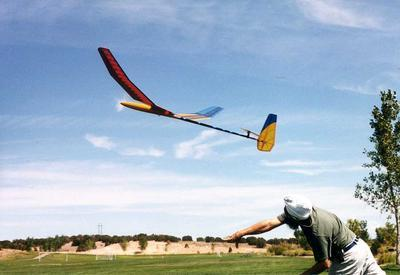
[picture p218: Photos/Hand Launch 3.jpg]
Hand Launch 3

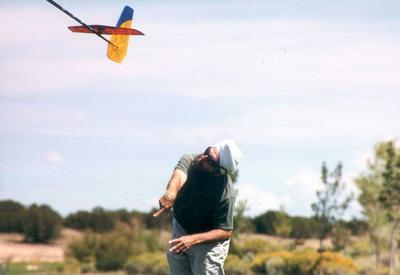
[picture p219: Photos/Hand Launch 2.jpg]
Hand Launch 2

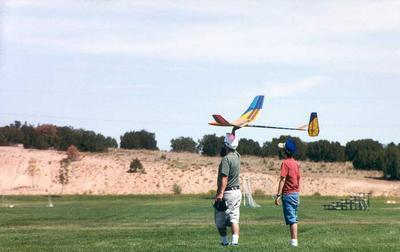
[picture p220: Photos/Hand Launch 1.jpg]
Hand Launch 1

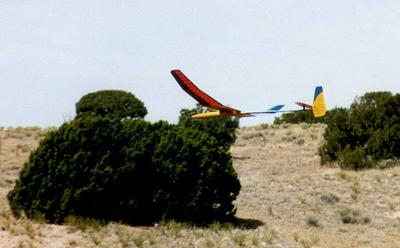
[picture p221: Photos/On Final.jpg]
On Final

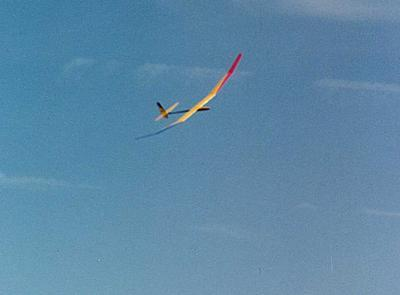
[picture p222: Photos/BD07.jpg]
BD07

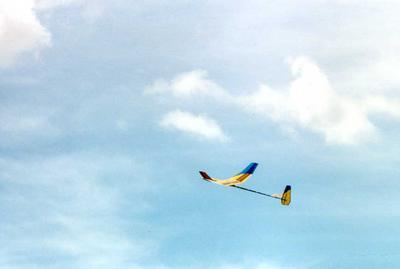
[picture p223: Photos/BD15.jpg]
BD15

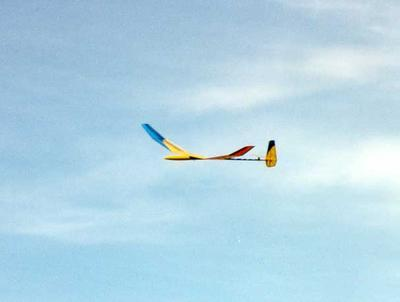
[picture p224: Photos/BD14.jpg]
BD14

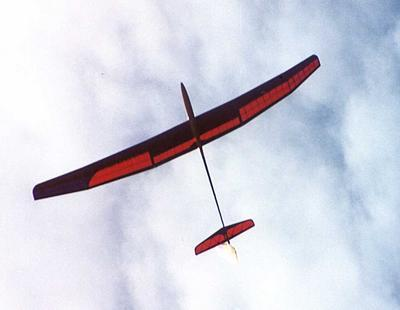
[picture p225: Photos/Contrast Against Sky.jpg]
Contrast Against Sky

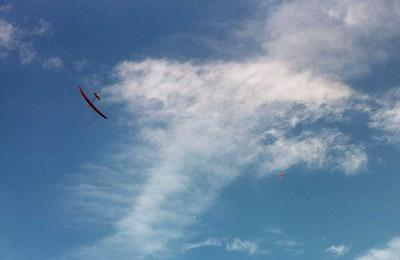
[picture p226: Photos/Off the Hi-Start.jpg]
Off the Hi-Start

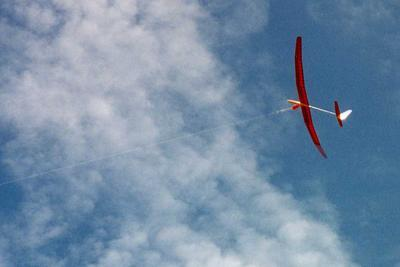
[picture p227: Photos/Up the Hi-Start.jpg]
Up the Hi-Start

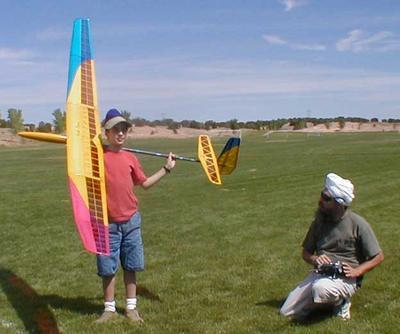
[picture p228: Photos/Bubble Dancer Father and Son.jpg]
Bubble Dancer Father and Son

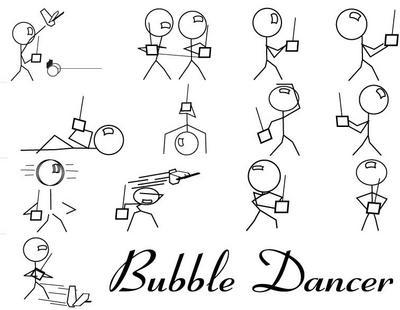
[picture p229: Photos/Illustrator-based Graphics.jpg]
Illustrator-based Graphics

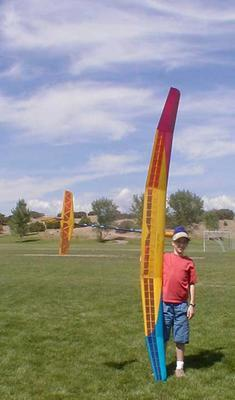
[picture p230: Photos/A five footer and a ten.jpg]
A five footer and a ten

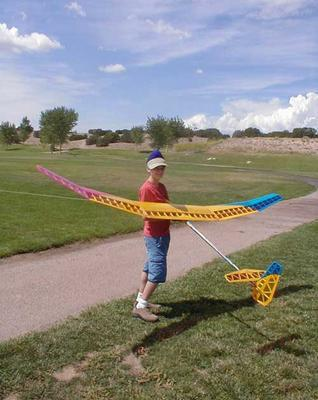
[picture p231: Photos/On the High Start.jpg]
On the High Start

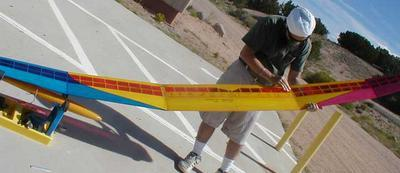
[picture p232: Photos/Wing Assembly.jpg]
Wing Assembly

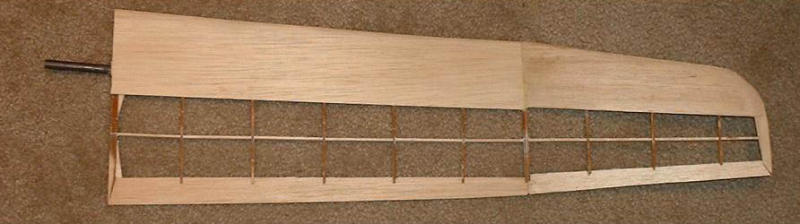
[picture p233: Photos/Allegro Right outer.jpg]
Allegro Right outer

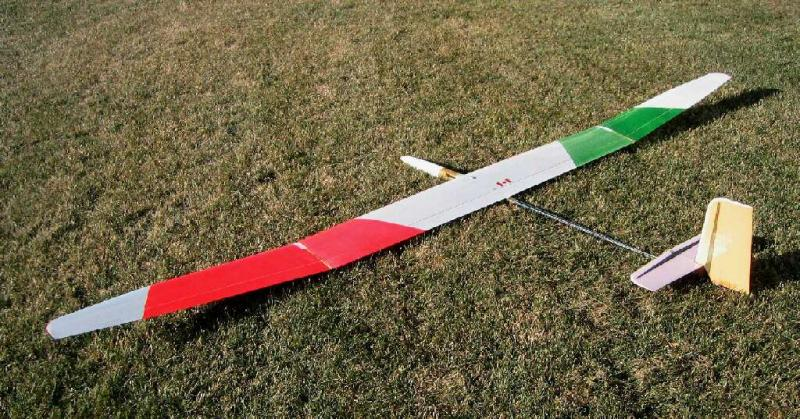
[picture p234: Photos/Supra 53 oz.jpg]
Supra 53 oz

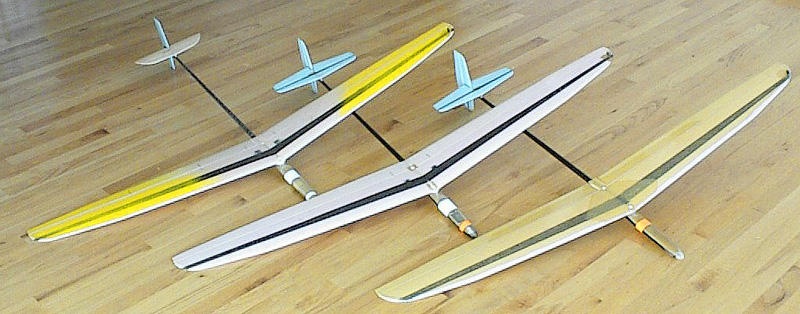
[picture p235: Photos/3 Supergees.jpg]
3 Supergees

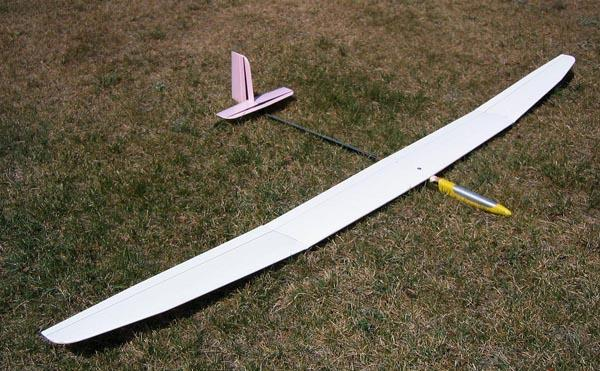
[picture p236: Photos/Barnes Aegea 66 oz.jpg]
Barnes Aegea 66 oz

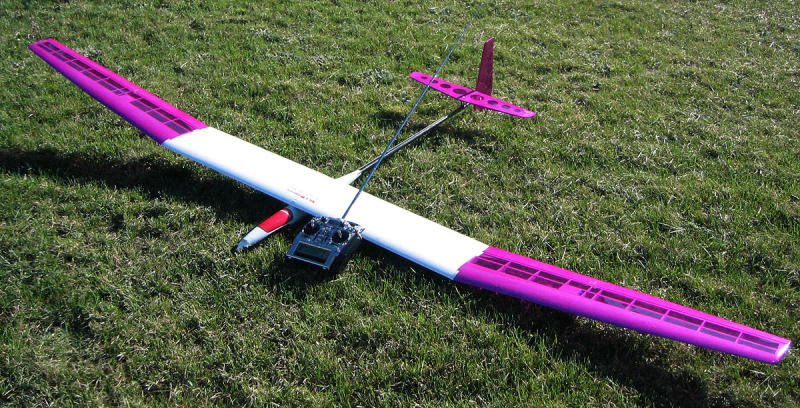
[picture p237: Photos/Polecat Skydancer 66 oz.jpg]
Polecat Skydancer 66 oz

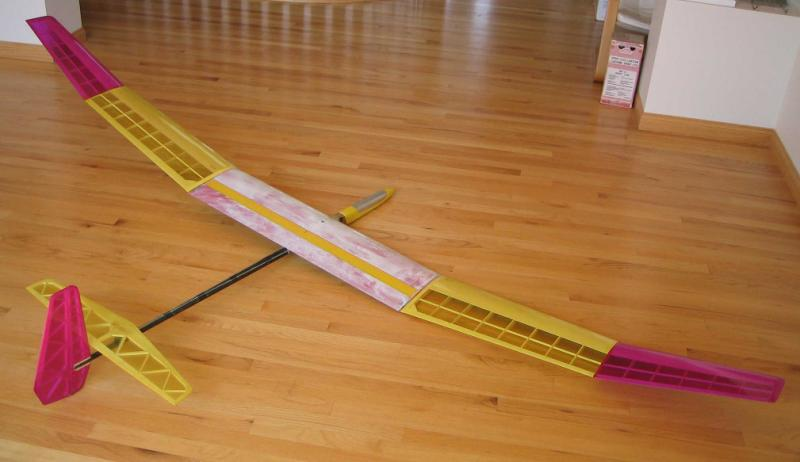
[picture p238: Photos/BD www.badger.rchomepage.com.jpg]
BD www.badger.rchomepage.com

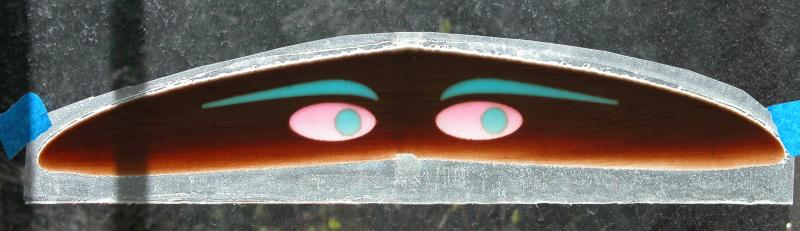
[picture p239: Photos/EyeStab.jpg]
EyeStab

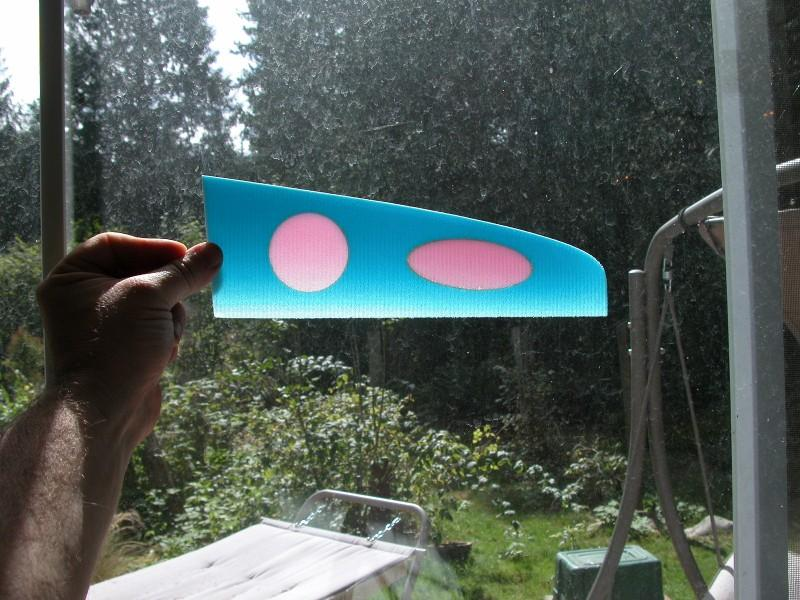
[picture p240: Photos/mixed foam2.jpg]
mixed foam2

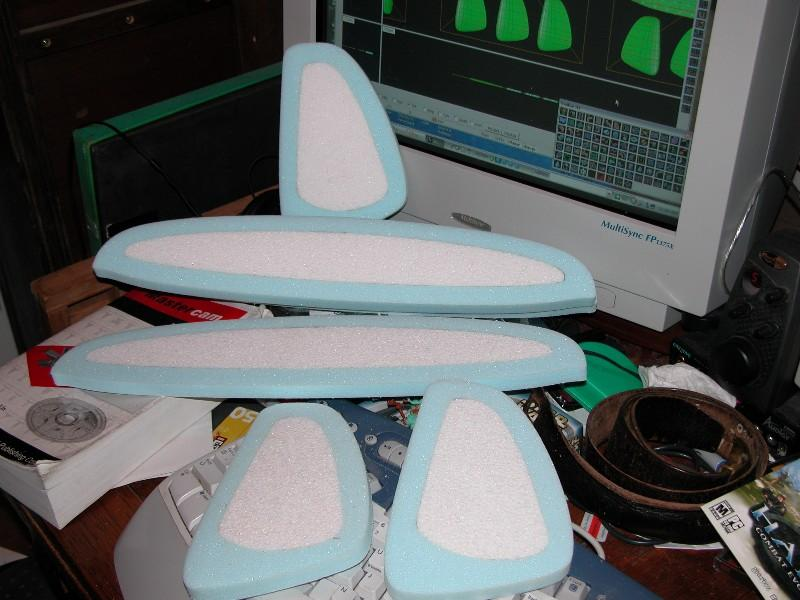
[picture p241: Photos/Mixed foam1.jpg]
Mixed foam1

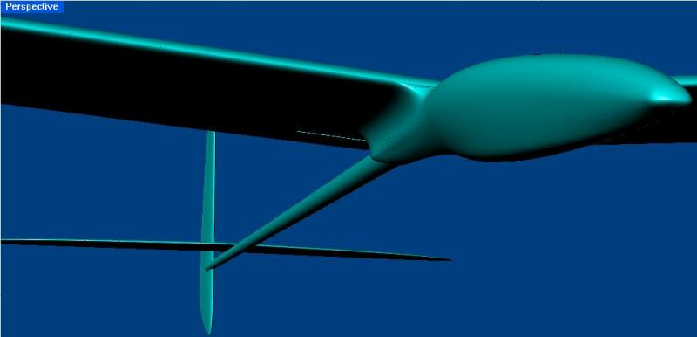
[picture p242: Photos/microglider3.jpg]
microglider3

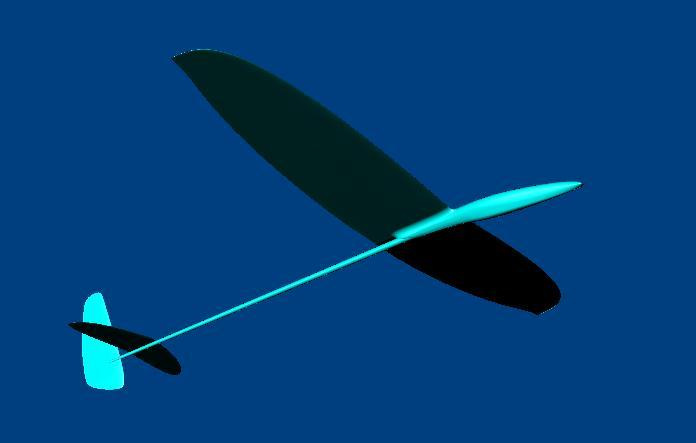
[picture p243: Photos/Microglider2.jpg]
Microglider2

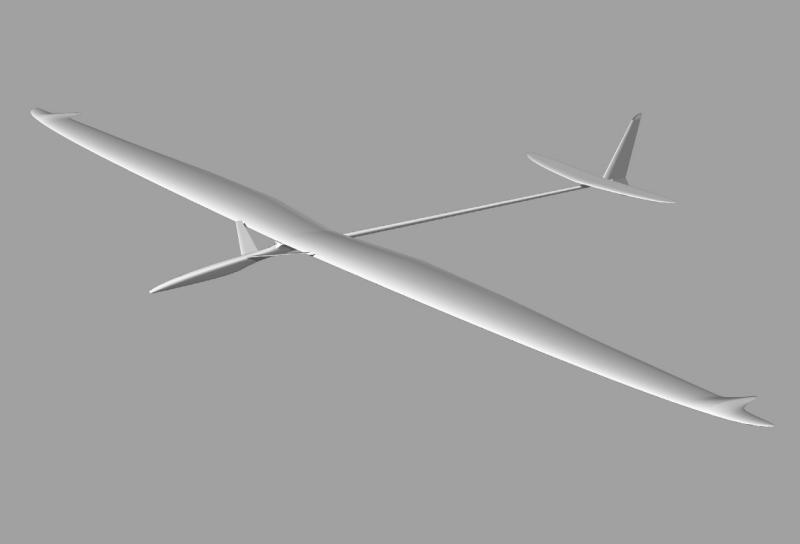
[picture p244: Photos/The Grand Imperial at 5 meters.jpg]
The Grand Imperial at 5 meters

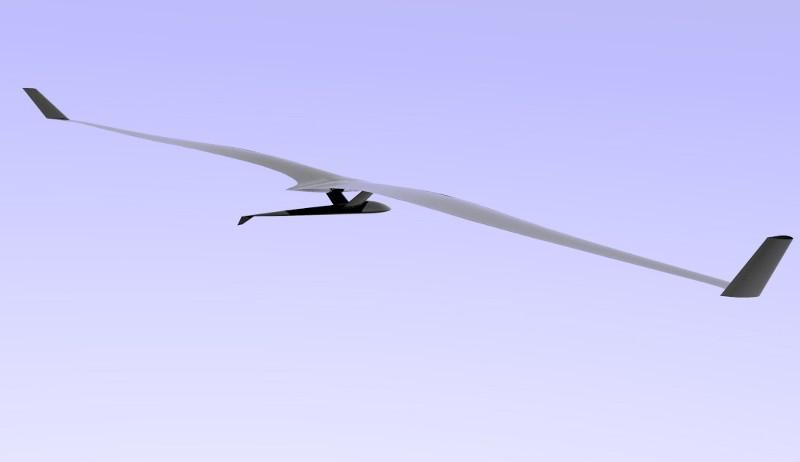
[picture p245: Photos/The AltoStratocaster.jpg]
The AltoStratocaster

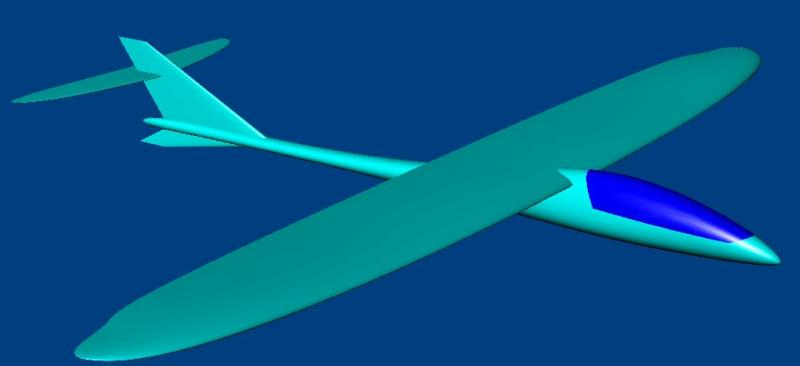
[picture p246: Photos/Discovery Swallow.jpg]
Discovery Swallow

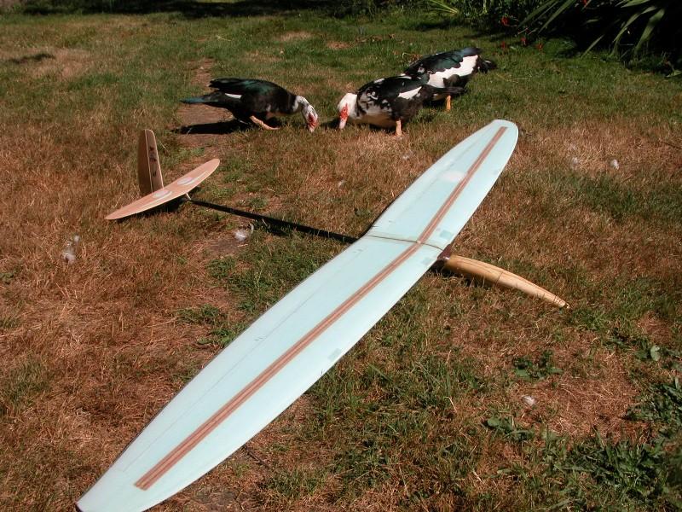
[picture p247: Photos/All CG built 2 meter.jpg]
All CG built 2 meter

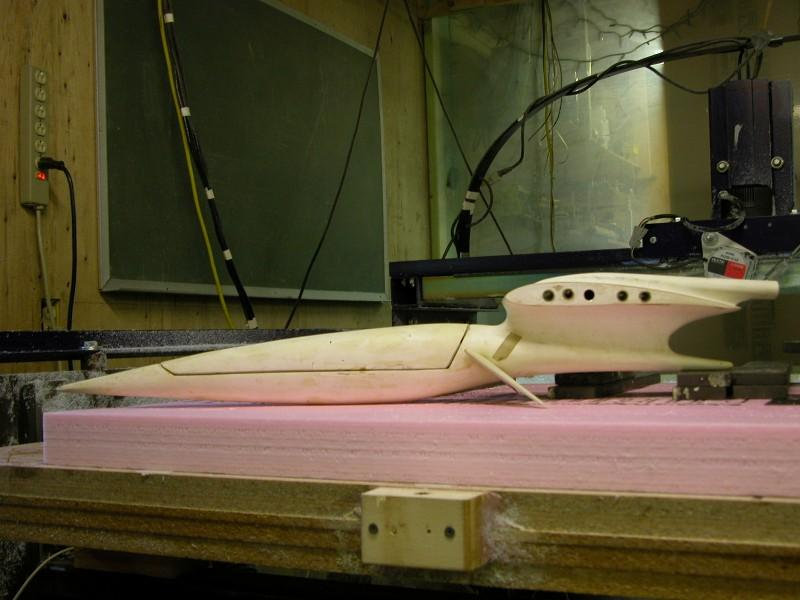
[picture p248: Photos/Dorsal fin experiment.jpg]
Dorsal fin experiment

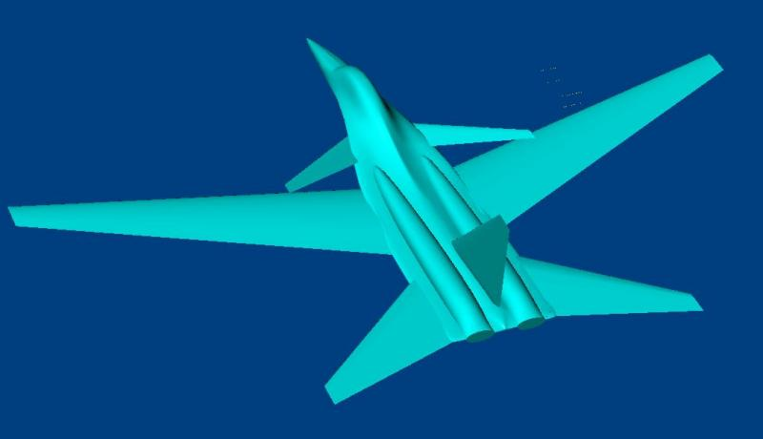
[picture p249: Photos/The SlopeJet.jpg]
The SlopeJet

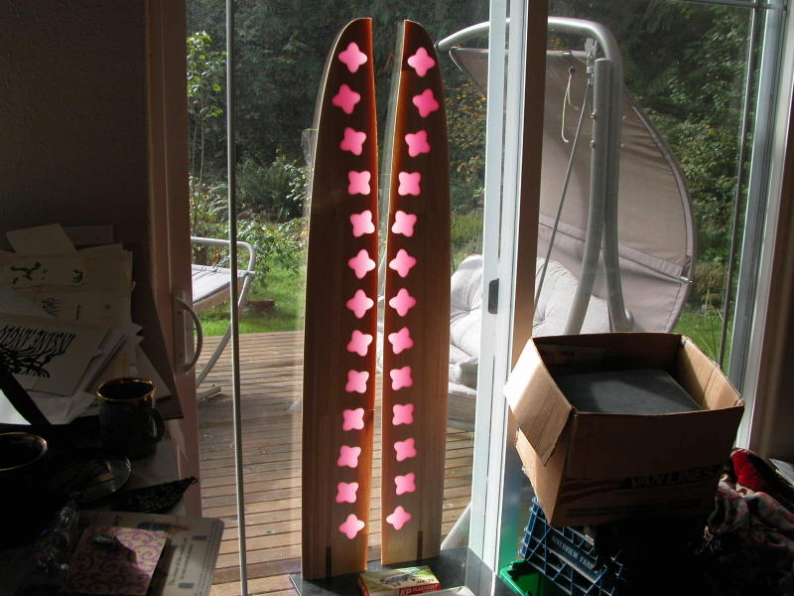
[picture p250: Photos/CG built solid balsa wings.jpg]
CG built solid balsa wings

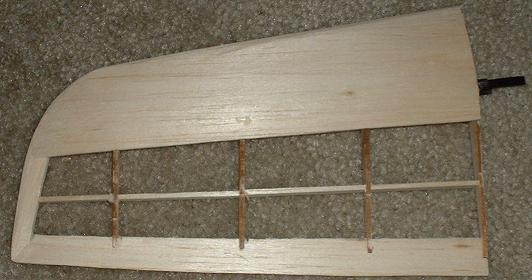
[picture p251: Photos/Almost cplte alleg tip. 10.5g.jpg]
Almost cplte alleg tip. 10.5g

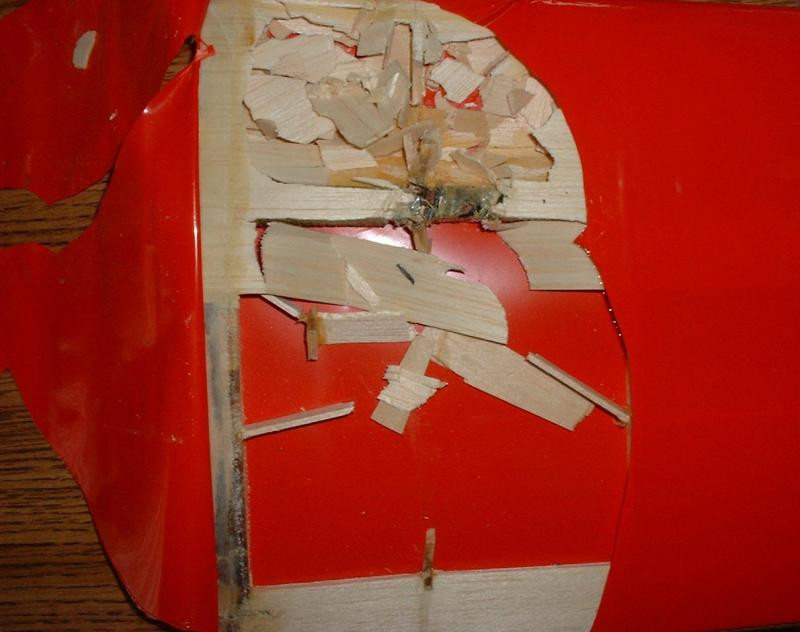
[picture p252: Photos/Wing failure.jpg]
Wing failure

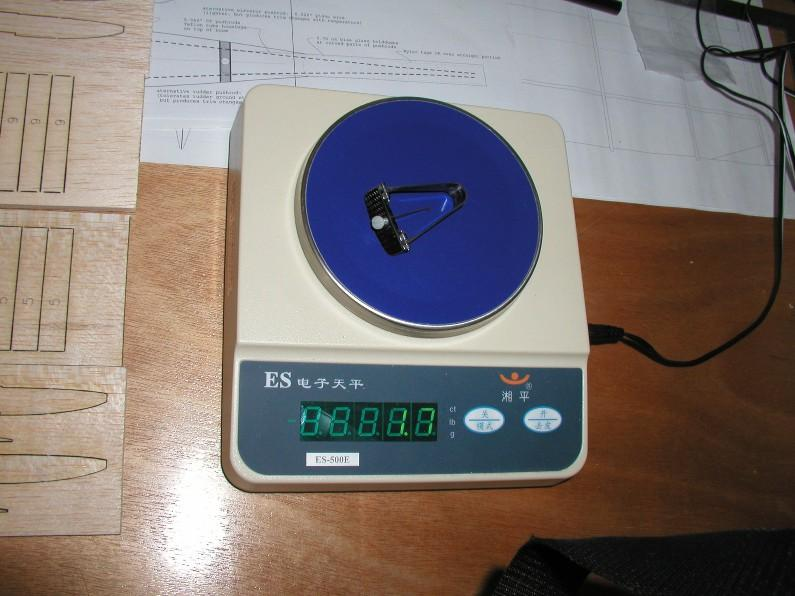
[picture p253: Photos/V-mount from Bud Elder.jpg]
V-mount from Bud Elder

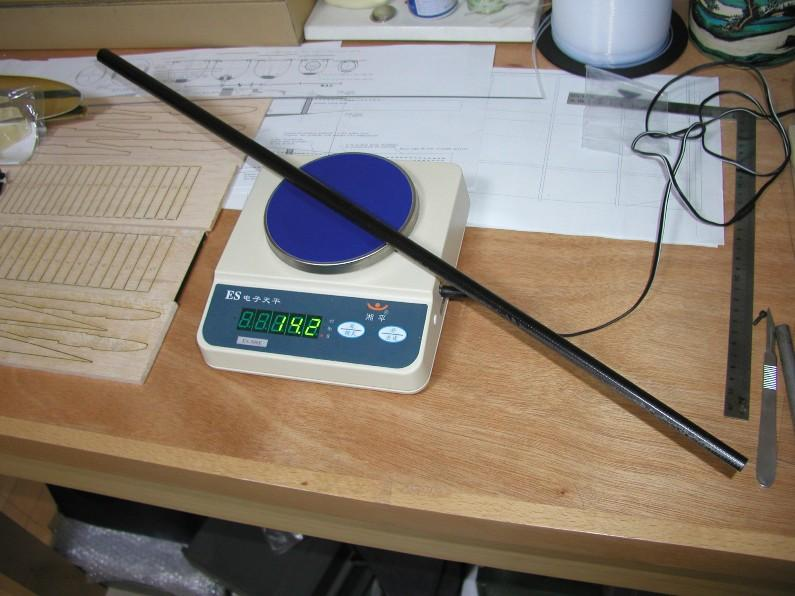
[picture p254: Photos/Tail boom from tailboom.com.jpg]
Tail boom from tailboom.com

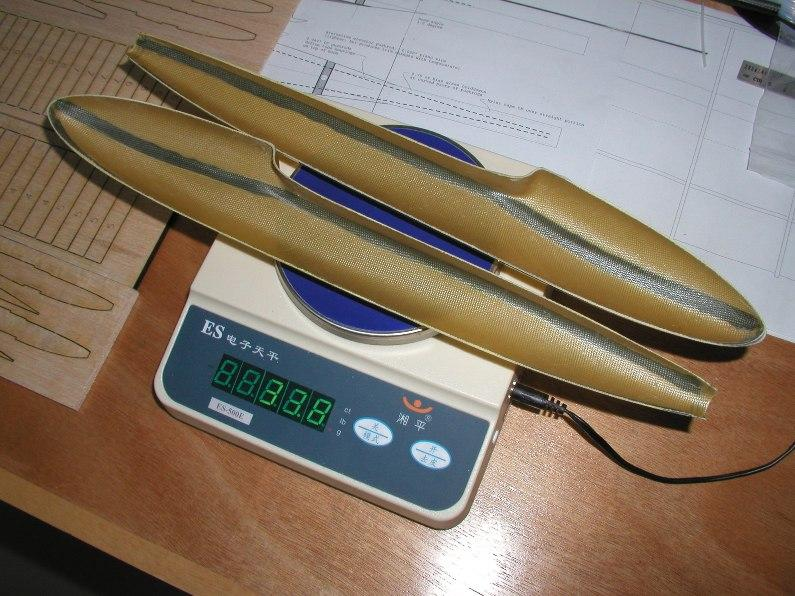
[picture p255: Photos/Pod from Bud Elder.jpg]
Pod from Bud Elder

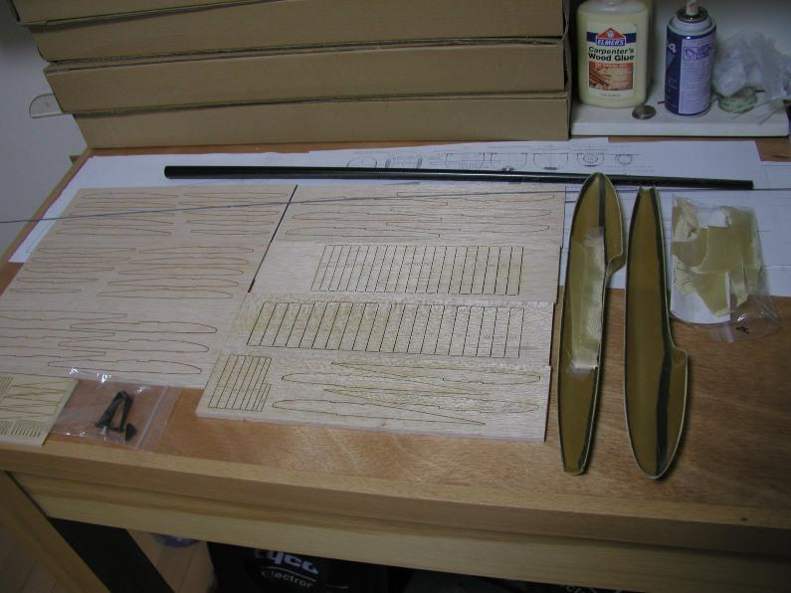
[picture p256: Photos/Wood kit from Laser Art.jpg]
Wood kit from Laser Art

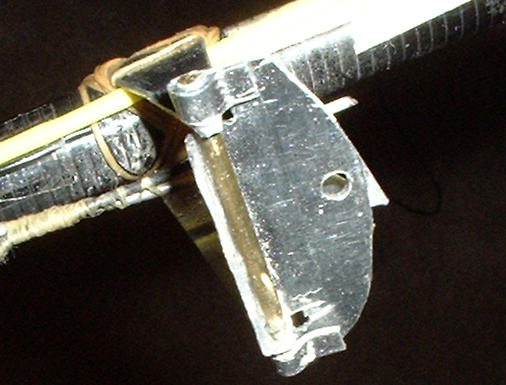
[picture p257: Photos/vmount2.jpg]
vmount2

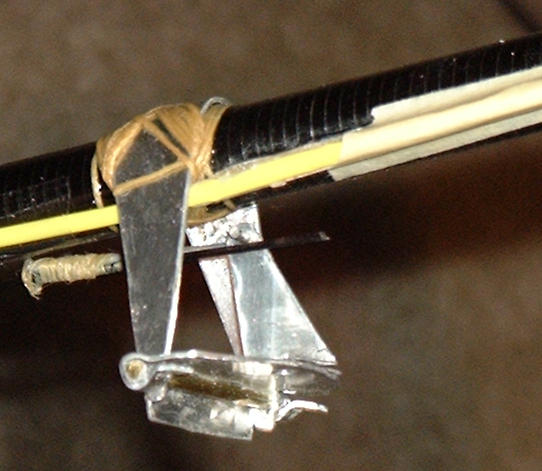
[picture p258: Photos/vmount1.jpg]
vmount1

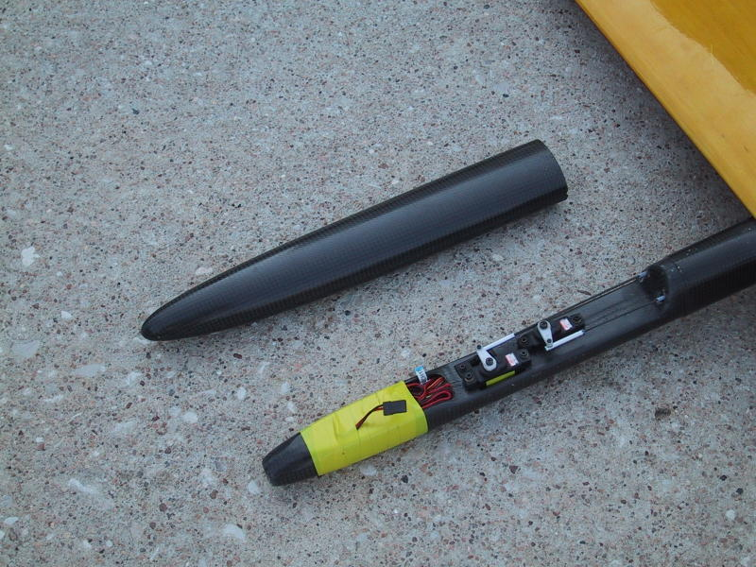
[picture p259: Photos/BD-1 Radio Installation.jpg]
BD-1 Radio Installation

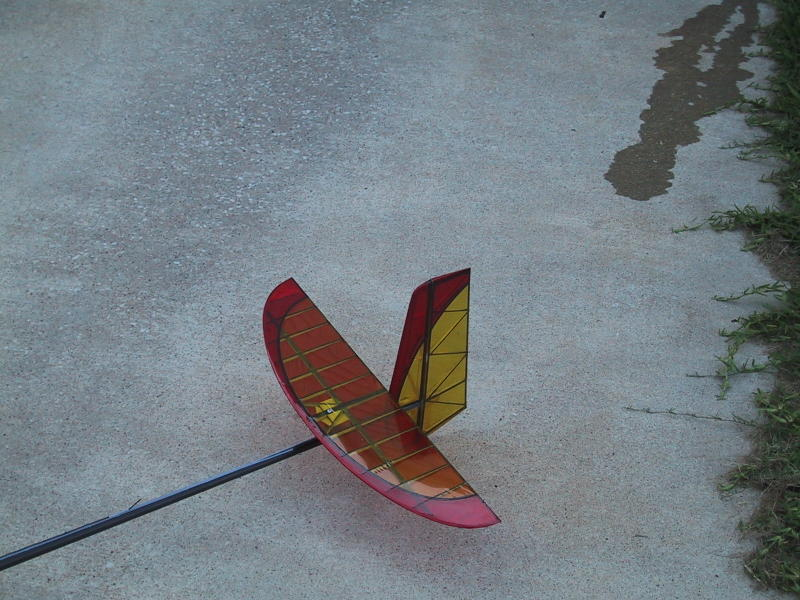
[picture p260: Photos/BD-1 Tail Assembly.jpg]
BD-1 Tail Assembly

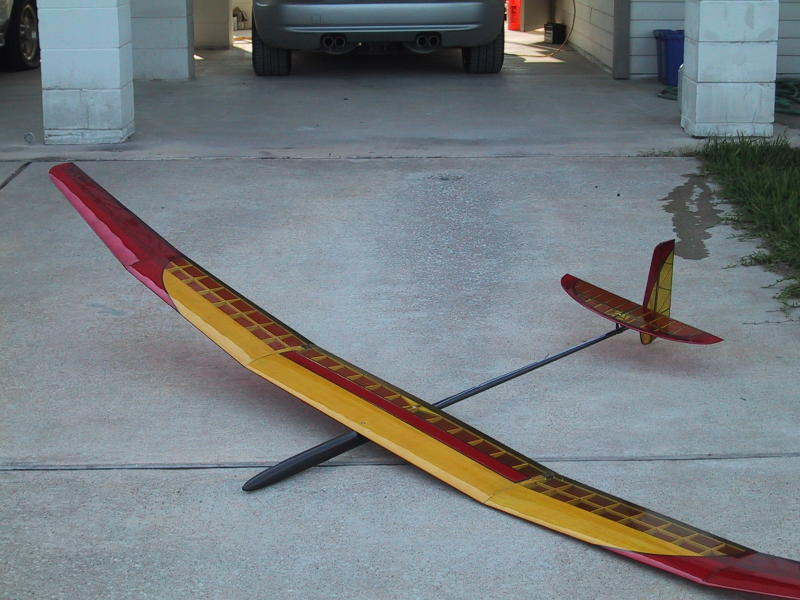
[picture p261: Photos/BD-1.jpg]
BD-1

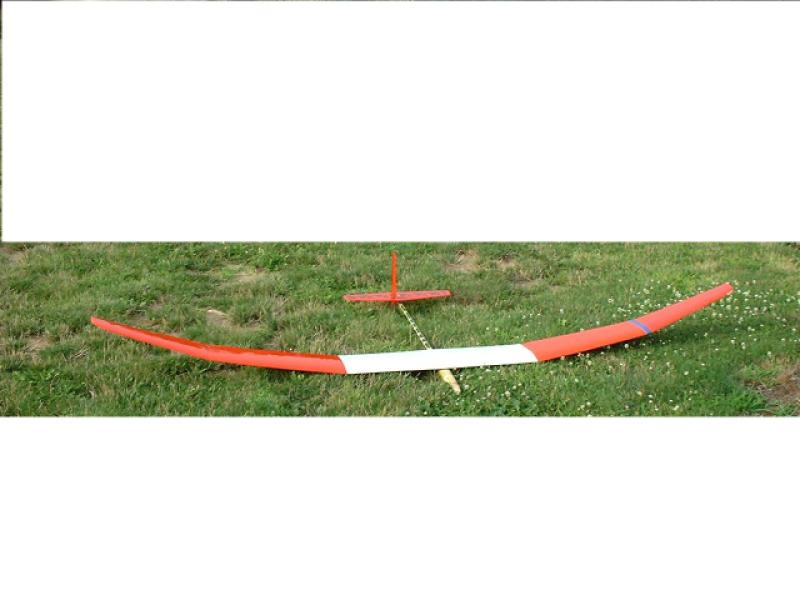
[picture p262: Photos/Bubble Dancer ready for flight.jpg]
Bubble Dancer ready for flight

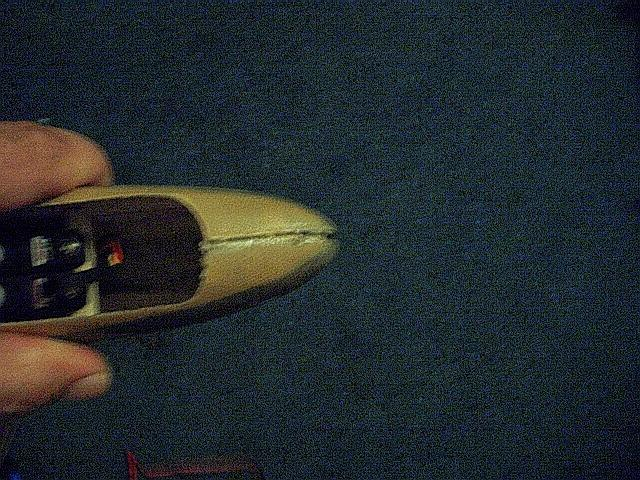
[picture p263: Photos/pod split.jpg]
pod split

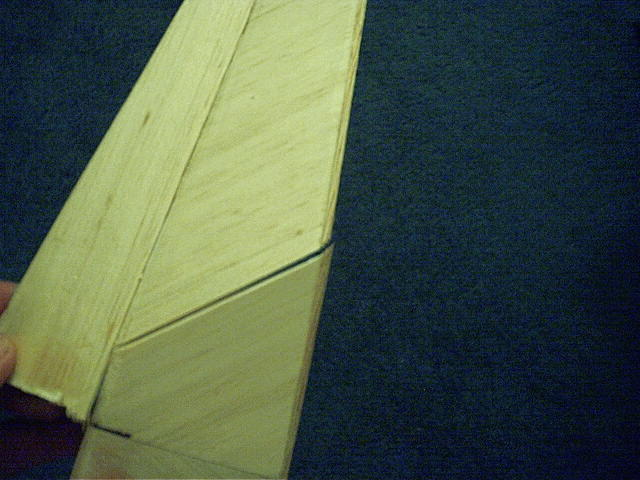
[picture p264: Photos/rudder break2.jpg]
rudder break2

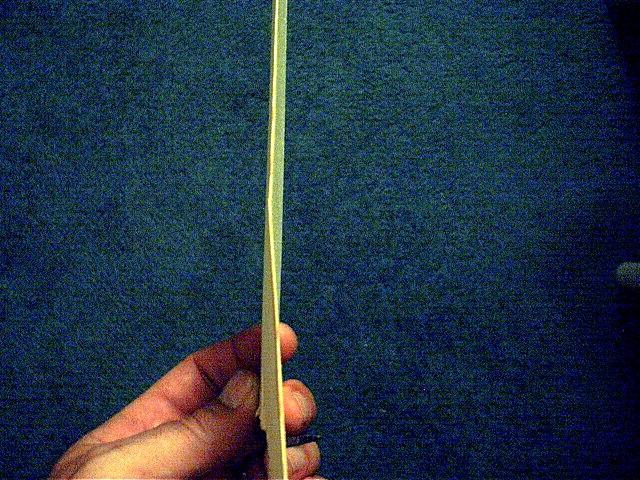
[picture p265: Photos/rudder break1.jpg]
rudder break1

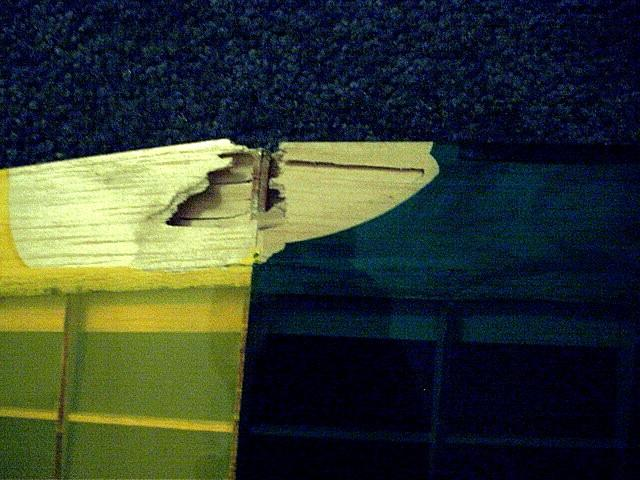
[picture p266: Photos/wing top surface---1.jpg]
wing top surface---1

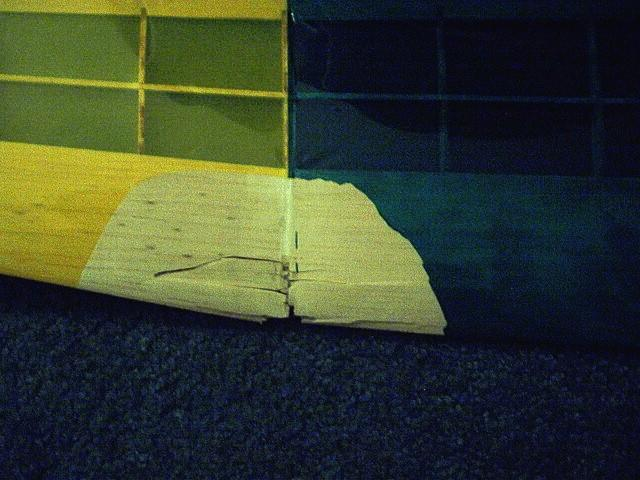
[picture p267: Photos/wing top surface.jpg]
wing top surface

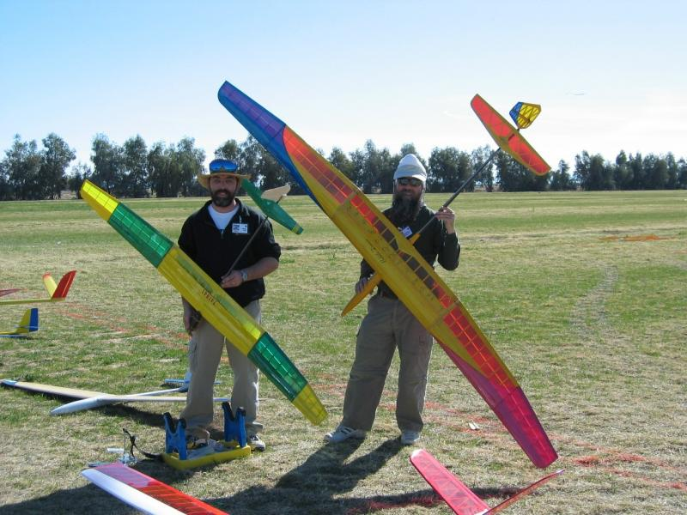
[picture p268: Photos/AllegroLite and BubbleDancer.jpg]
AllegroLite and BubbleDancer

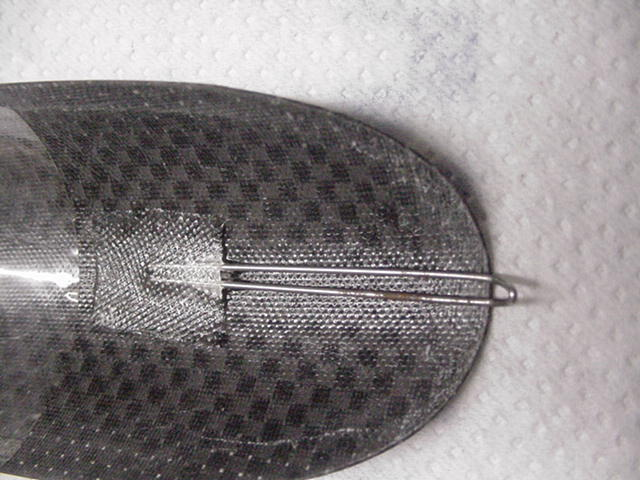
[picture p269: Photos/Wire retainer.jpg]
Wire retainer

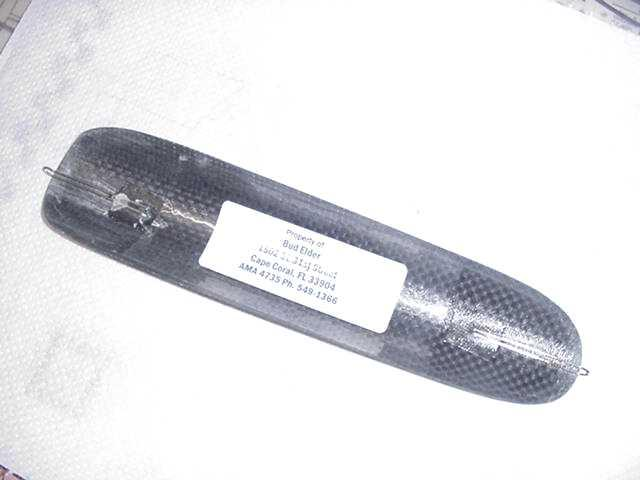
[picture p270: Photos/Canopy hold down.jpg]
Canopy hold down

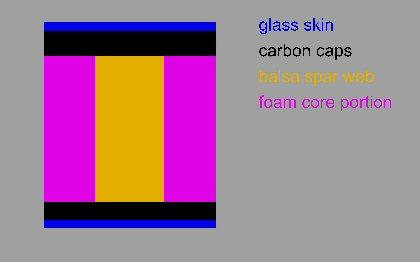
[picture p271: Photos/spar 1.jpg]
spar 1

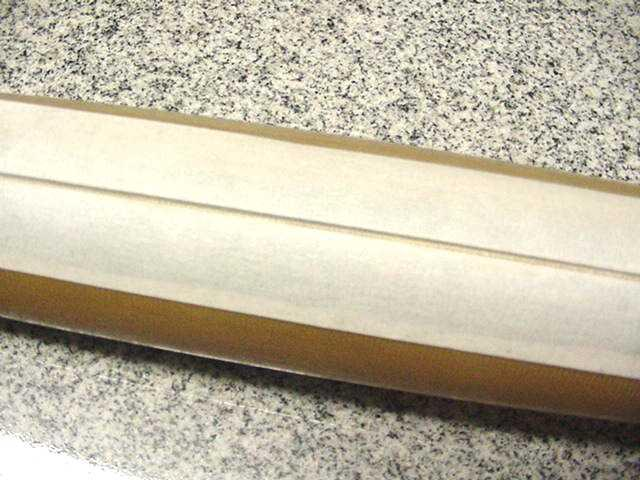
[picture p272: Photos/Taping halves for joining.jpg]
Taping halves for joining

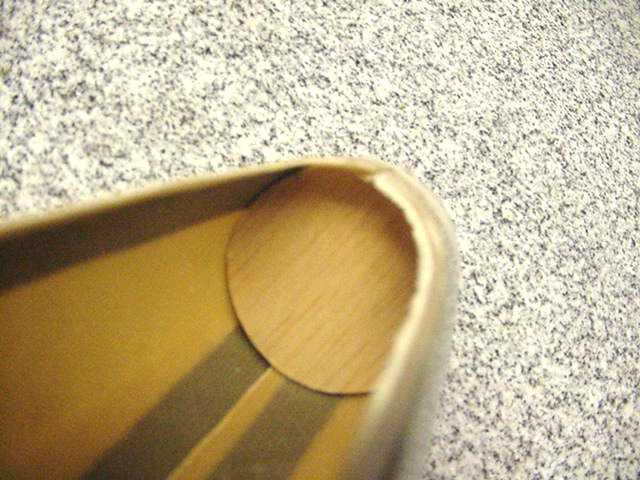
[picture p273: Photos/Temp bulkhead in place.jpg]
Temp bulkhead in place

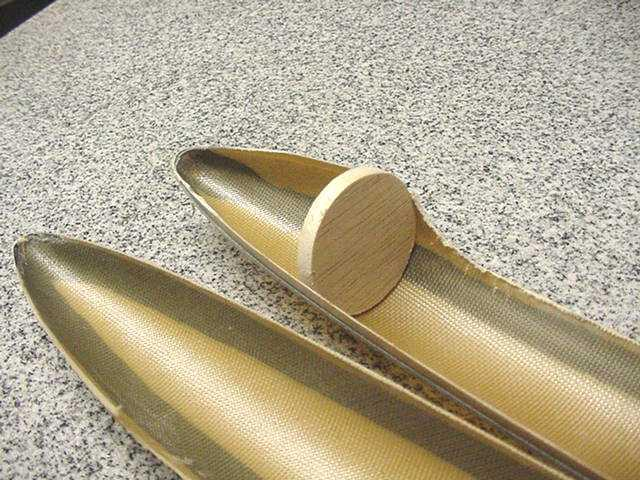
[picture p274: Photos/Temp. Bulkhead.jpg]
Temp. Bulkhead

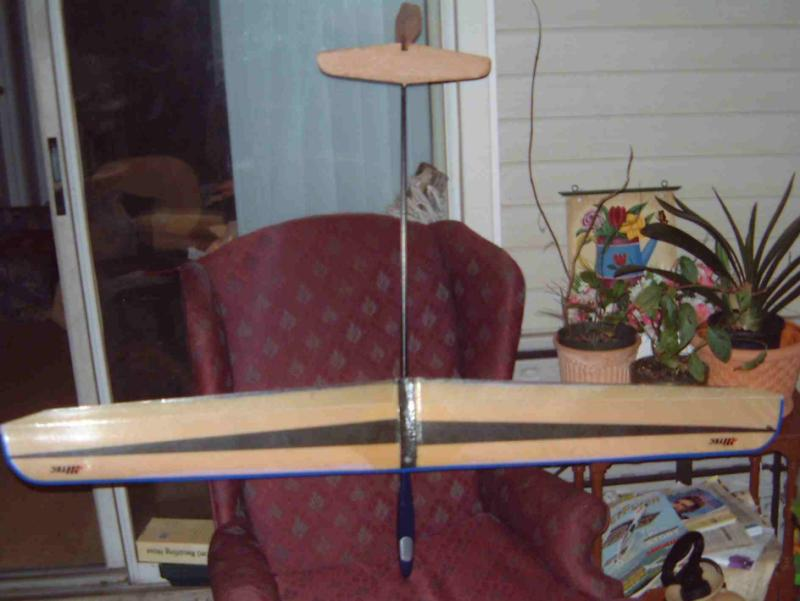
[picture p275: Photos/sg2.jpg]
sg2

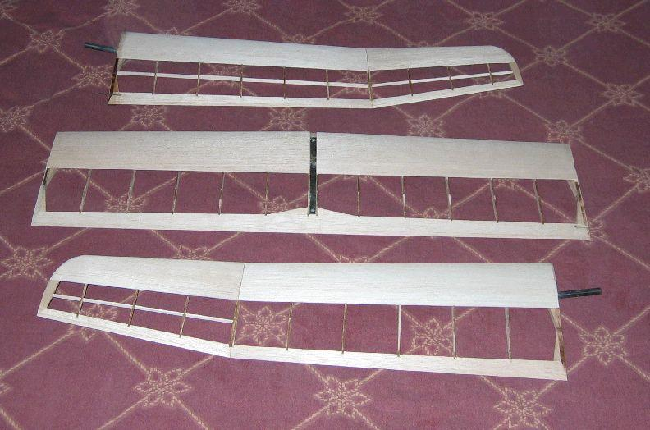
[picture p276: Photos/wing_panels.jpg]
wing_panels

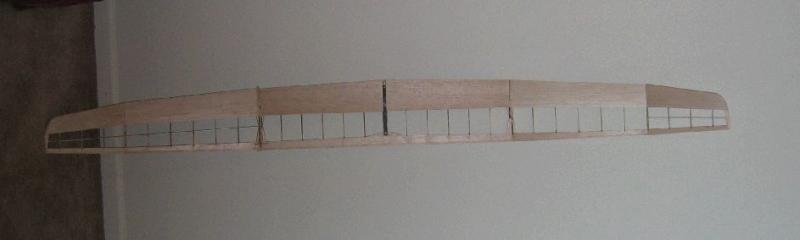
[picture p277: Photos/wing1.jpg]
wing1

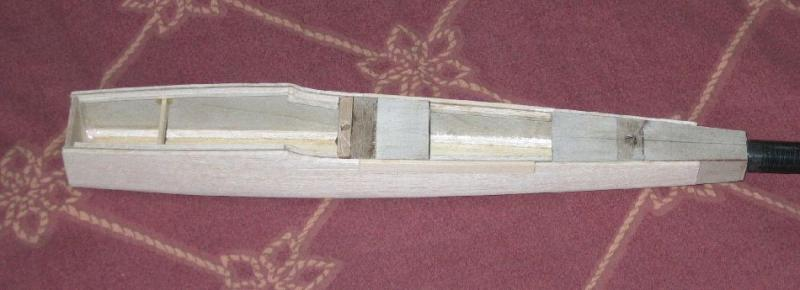
[picture p278: Photos/pod_close1.jpg]
pod_close1

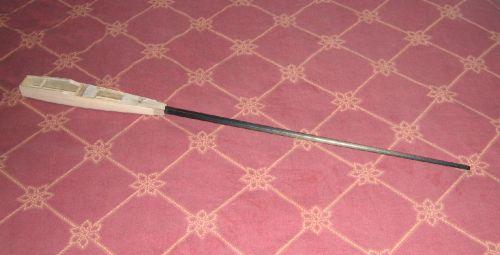
[picture p279: Photos/pod_boom.jpg]
pod_boom

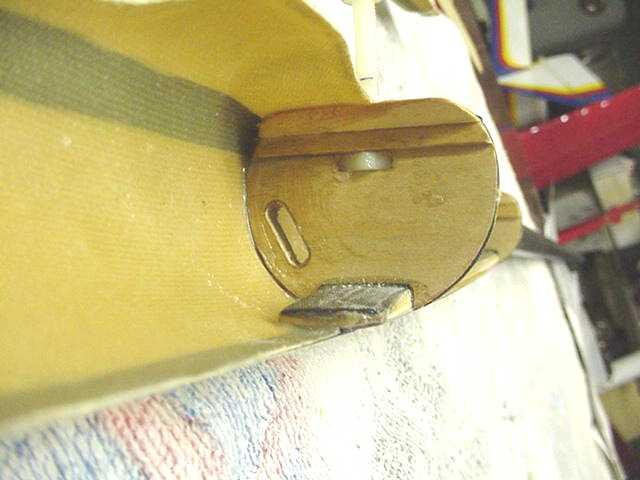
[picture p280: Photos/Nose view.jpg]
Nose view

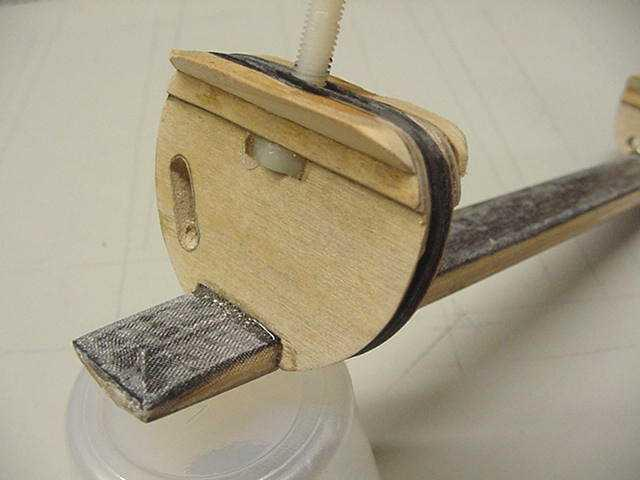
[picture p281: Photos/Front bulkhead & crutch.jpg]
Front bulkhead & crutch

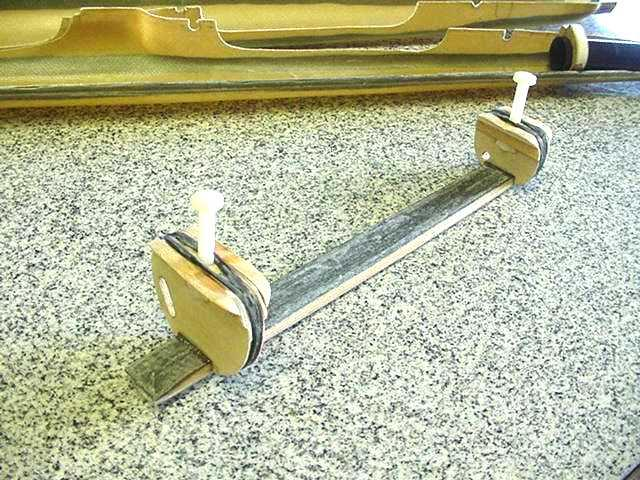
[picture p282: Photos/Bulkhead & crutch.jpg]
Bulkhead & crutch

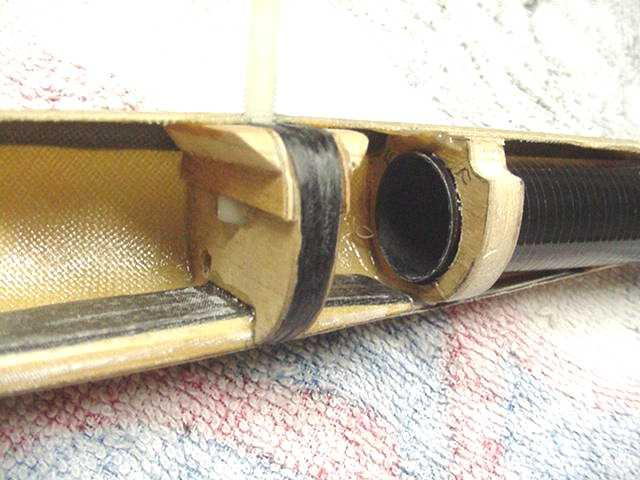
[picture p283: Photos/Rear bulk.view.jpg]
Rear bulk.view

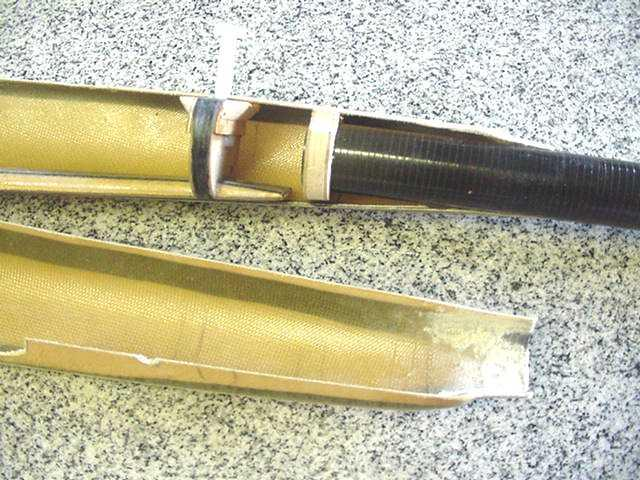
[picture p284: Photos/Rear of pod & boom.jpg]
Rear of pod & boom

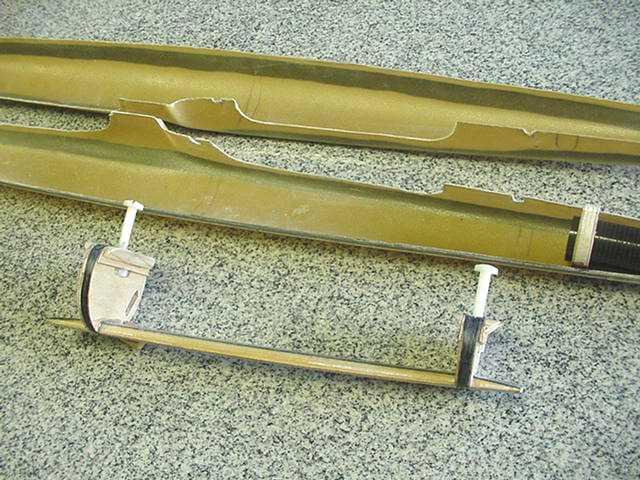
[picture p285: Photos/Fuse & crutch.jpg]
Fuse & crutch

Crutch in pod half #2
Crutch in podhalf #1
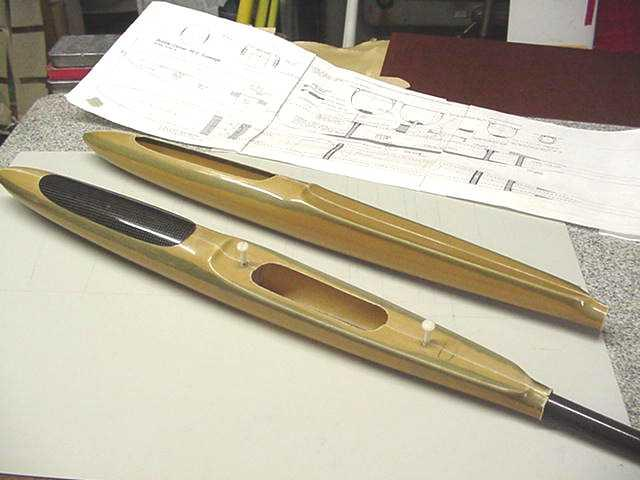
[picture p286: Photos/Two pods & plans.jpg]
Two pods & plans

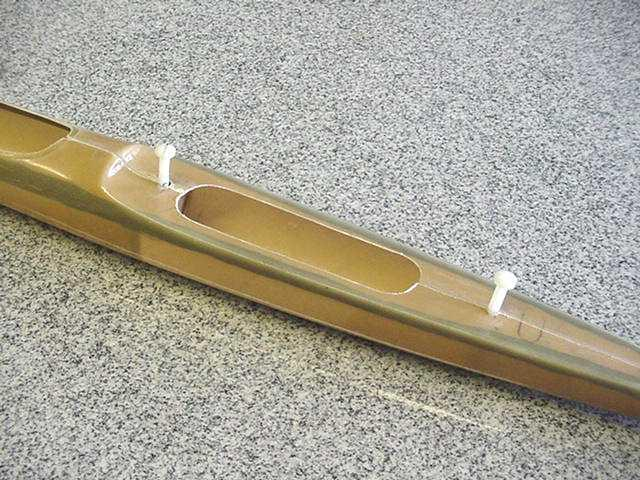
[picture p287: Photos/Pod Assem.jpg]
Pod Assem

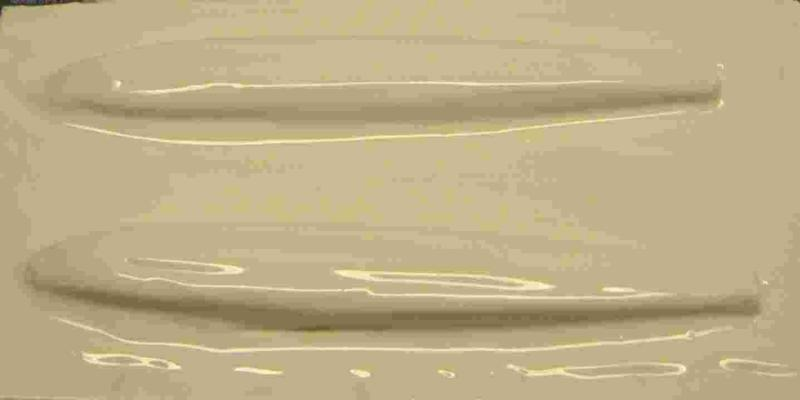
[picture p288: Photos/tooling gel.jpg]
tooling gel

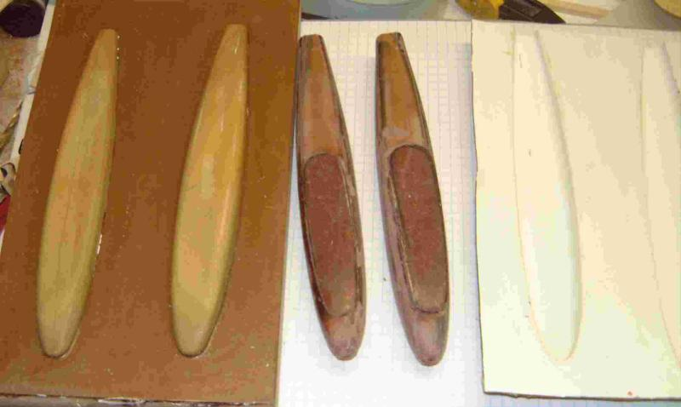
[picture p289: Photos/plufusemold.jpg]
plufusemold

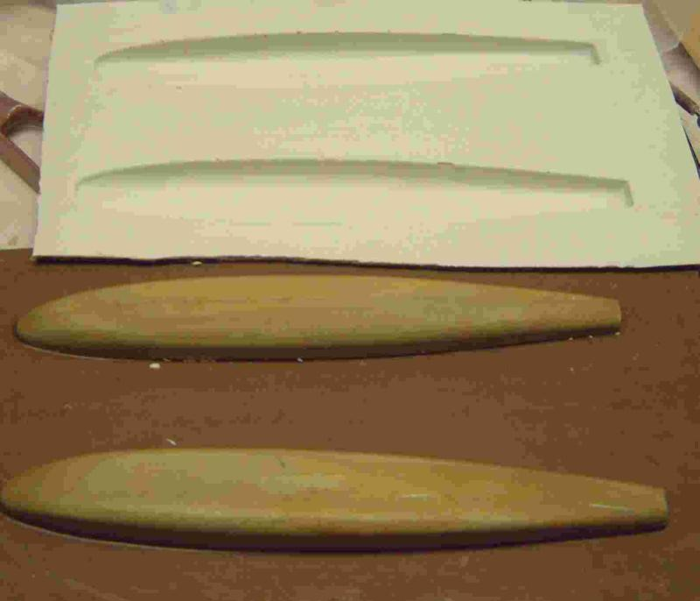
[picture p290: Photos/moldplug.jpg]
moldplug

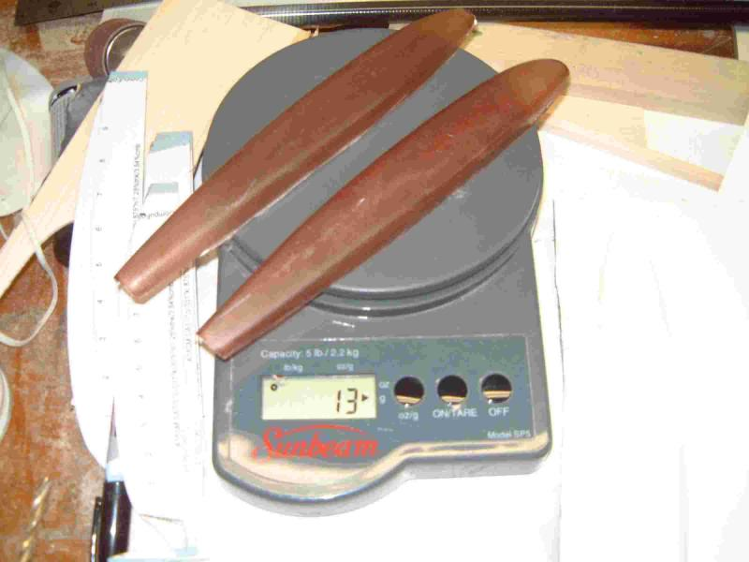
[picture p291: Photos/glassweighed.jpg]
glassweighed

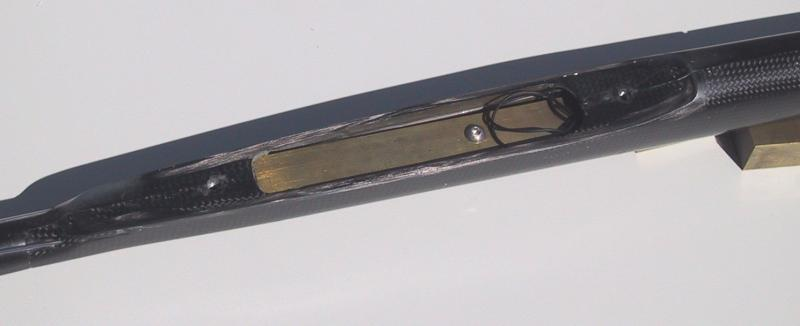
[picture p292: Photos/BD-11.jpg]
BD-11

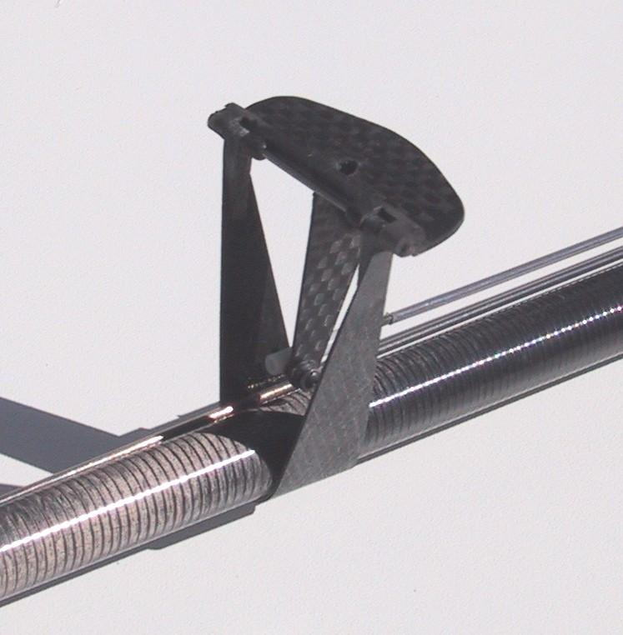
[picture p293: Photos/BD-10.jpg]
BD-10

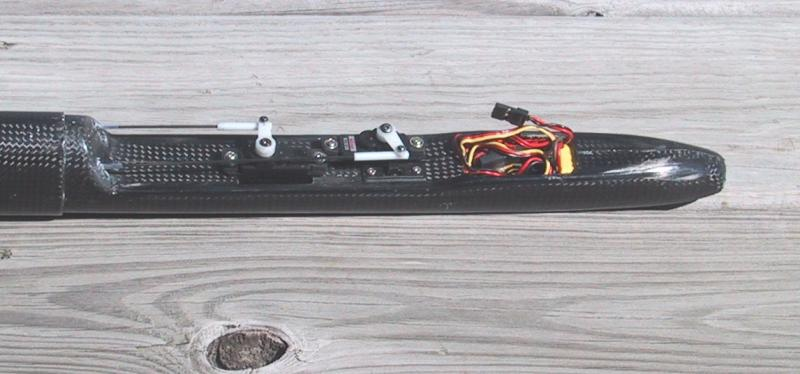
[picture p294: Photos/BD-7.jpg]
BD-7

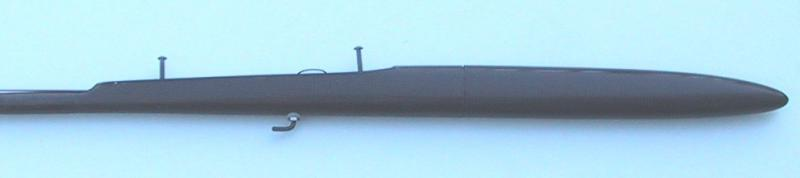
[picture p295: Photos/BD-5.jpg]
BD-5

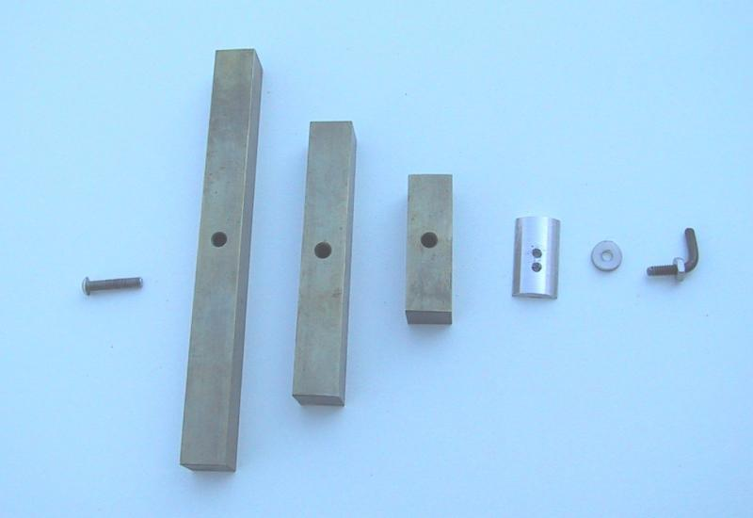
[picture p296: Photos/BD-4.jpg]
BD-4

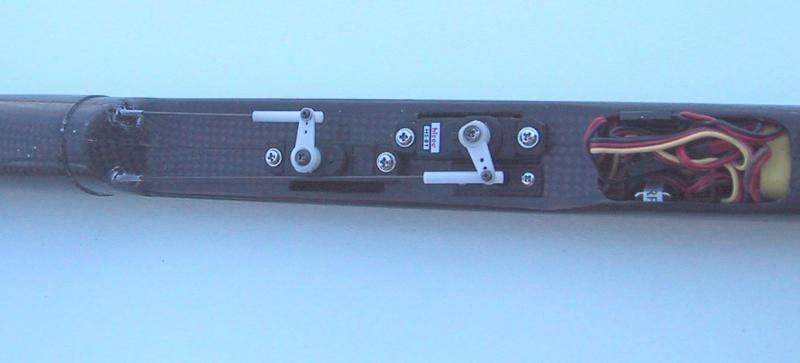
[picture p297: Photos/BD-1 (2).jpg]
BD-1 (2)

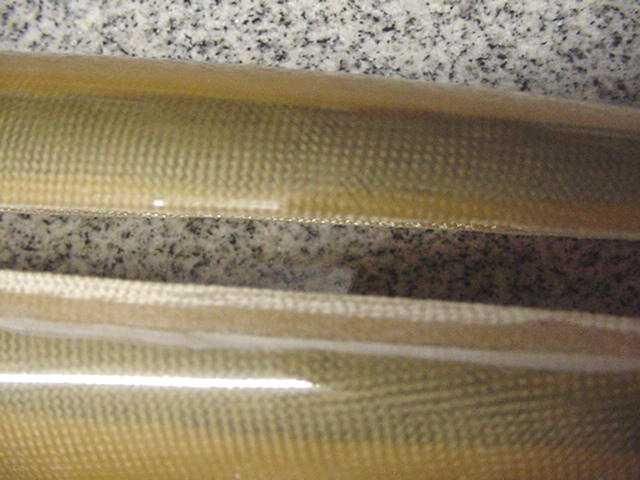
[picture p298: Photos/Lap Joining.jpg]
Lap Joining

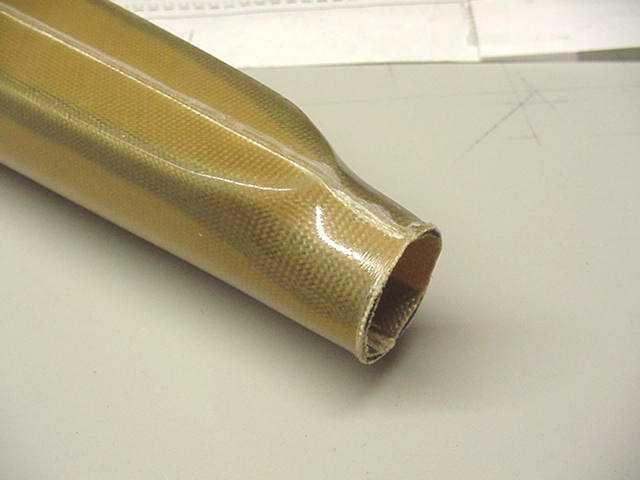
[picture p299: Photos/Rear of pod.jpg]
Rear of pod

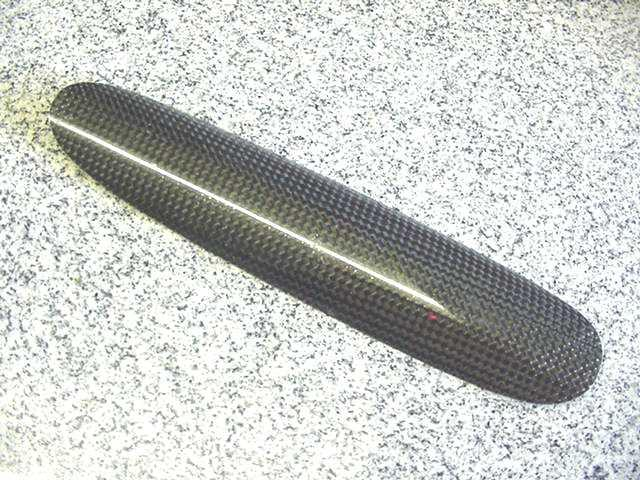
[picture p300: Photos/Canopy.jpg]
Canopy

Canopy on pod
Radio comp. & canopy
Radio comp
Pod half on plans
Pod half's
Full view of pod
1redtail
1allegro wing
Wanngee going flaps
Wannagee coming flaps
eLite flyby
Tail close up
Allegro-lite
Kevlar SuperGee WIng
Kevlar SuperGee Wing (2)
SG and larger wingset
Finished Wings
Poly wingset 95 grams
Aileron version
CNC with TV
Set fresh from bag
2 sets Ready for Bagging
Current Poly Version
Side View BD---1
Thermic And BD view
Thermic View #1
bd_parking
BD_launch2
BD_launch1
bd_launching
bd_landing
Ready to cover
rudder (2)
odd shaped stab
Plane standing on nose
P4210008
Nose cone spyder wrap
gear in short nose
top panel
look down spar
bubble dancer
panel 1 with spoiler and spar
bottom of BD with spar
2M 29-Jun-03
One piece wing
Tail (2)
Fuse
sanded nose
bottom seam
12 mold pod cone
11 wrapping stages
10 vacuuming excess out
8 epoxy puddle in drawn frame
7 glass added
6 glass cut
5 material cutting
4 glass template
3 glass template
1 wing cutout
2 pods
V-M # 3
V-M #2
V-M #1
V Mount
Wing Tip Damage
Tail Feathers
Full Vu
WingCenterPanelRdyForBagging
WingEndPanelsRdyForBagging
WingEndPanelEndView
WingCenterPanelEndView
SetUpForCuttingCarbonJoinerPlates
PartiallyBuiltWoodFuselage2
SandingLdgEdgAfterBagging
SetUpForCuttingCarbonCaps
MachinedJoinerGluedBtwnCaps
PartiallyBuiltWoodFuselage
LEKevlarBeingApplied
HotBoxHeatTreatingWhileBagging
JoinerBoxAssemblyInOuterSpars
CenterSparWithBoltBeam
GluingVMountToBoom
CenterSparBeforeGluingTopCap
CenterPanelGlassLayup
BalsaSparCoreBeingSanded2
CarbonPlatesForAileronAndFlapHorns
BaggingWingSpars
BalsaSparCoreBeingSanded
BaggingWingJoinersPlates
BaggingPrepForCenterPanel
WingTip
Tail (3)
RudderPushRod
PodBtmVu
FlapServoAndPod
AileronServo
AllegroFA_BtmVu
AllegroFA_Launch
AllegroFA2
AllegroFA1
starting
off ground different angle
just off the ground
E-Allegro_Lite flight shots
stew's allegro-like
bd_tail
bd_spoiler_open
bd_spoiler_closed
bd_nose
DCP_1935
DCP_1933
DCP_1926
DCP_1925
DCP_1923
DCP_1919
DCP_1913
Mylar tape to secure pushrods
