duanebeck/Allegro-Lite/Adding_Carbon_Fiber.pdf

Hard balsa

Epoxy

Straight or tapered
precured CF strips

Stock hardwood sparcaps
used as depth sanding guides

pressure via
weight or vacuum bag
1) Laminate CF onto hard balsa
2) Cut up to make sparcap strips
3) Sand down balsa side of strips
4) Build normally, using wood glue

## Wood wing construction with CF/balsa replacement sparcaps

Use epoxy only on CF/balsa bonds

### M. Drela 14 Aug 05
