duanebeck/Allegro-Lite/joiners2.pdf

# Allegro−Lite

2.0 deg; 11.9 deg; 11.1 deg; 0.007" carry−through CF strips; Permanent outer joint; cut carbon rod with carbide or diamond Dremel cut−off disk (wear dust protection); 9.9 deg +/− 0.1 deg; 1/8" ply (0.115"); trim ply filler after locating with completed outer panel used as jig; bevel to make perpendicular to spar; 4.83 in +/− 0.05 inq; sparcaps go all the way to tip; extend with short lap joints if stock sparcaps are too short (local stresses are very low); endgrain basswood; Spar at tip; last rib; 8mm (0.315") carbon rod; 1.5 deg; 3.0 deg; (50% de−rated wing)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

cap tube to prevent epoxy entry during assembly

# Wing Joiners and Angles

6 layers +/−45 1.8 oz Kevlar, or 0.015" wall Al tube

Make this bond before mid−panel assembly.
