duanebeck/Allegro-Lite/kev_tube.pdf

Rolling Kevlar Joiner Housing Tubes | MD 5 May 02

+/−45 Kevlar; 0/90 0.75 oz glass, 1/2" bigger than Kevlar on all four sides; Cabosil to adhere glass; roll on table; put overlap on bottom as shown; 1/2 mil waxed Mylar around joiner rod, applied with vaseline; (note direction); Spiral wrap tightly with stretchy tape (masking, electrical...) for compaction, or use vacuum bag

Spiral wrap with 1" wide 1 mil polyethylene strip

When cured, slide everything off on vaseline layer, and twist out the mylar (that’s why the wax was used)
