duanebeck/Allegro-Lite/Bubble Dancer/htail_V2.pdf

grain; hard balsa; Bubble Dancer; MD 24 Nov 01; Horizontal Tail; 0.75oz glass; soft balsa (4−6 lb); 33 deg; 1/8" sheet; 1/4" sheet; shaping data

soft balsa (4−6 lb)

C−grain for chordwise stiffness

stab load 7 lb @ 90 mph, CL=0.5

root bend.Ixx 2.15e−3 in^4

6−8 lb balsa throughout,

Design (never−exceed) Loads

root bend.mom. 19 lb−in

root stress 1100 psi

except where noted

16:1 TE wedge taper

LE tangent−slope

use generous glue fillets

for all rib−LE joints

1/16" TE thickness everywhere

C−grain gives stronger

rib−LE joints

taper to 0.15" thick

## inches
