duanebeck/Allegro-Lite/Supra/kevlar_layout.pdf

RCbot; LCtop; LCbot; RCtop; RTbot; LTtop; RTtop; LTbot; 1.7 oz Kevlar 38" x 72"

Supra F3J/TD 3.4m

MD 12 Apr 04

Kevlar Patterns

RTbot; LTtop; RTtop; LTbot; Lfin; Rfin; 1.0 oz Kevlar 39" x 32"

10 | 20 | 30 | 40in | 10 | 20 | 30 | 40in 10 20 30 50 60 70in 40

Kevlar doublers used
in lieu of 2.4 oz CF
