duanebeck/Allegro-Lite/Spreadsheets/Spar Design Program.xls

Sheet: Sheet1
Spar Designer
Step #1 | Describe Wing Panels
 | Wing Description
 |  | Inner Chord | Airfoil Thickness % | End Chord | Airfoil Thickness % | Top Skin Thickness | Bottom Skin Thickness | Allowance For Spar Wrap | Panel Length
 | Inner Panel | 10.5 | 8 | 9.423076923 | 7.72 | 0.001 | 0.001 | 0.03 | 30
 | Panel #2 | 9.423076923 | 7.72 | 6.741538462 | 7 | 0.001 | 0.001 | 0.03 | 28
 | Panel #3 | 6.741538462 | 7 | 4.038461538 | 6.54 | 0.001 | 0.001 | 0.015 | 14
 | Panel #4 | 4.038461538 | 6.54
 | Panel #5 | 0 | 0
 |  |  |  |  | Total Span |  |  |  | 72
Step #2 | Enter Total Winch Load
 | Design Load = |  |  | 250 | Lbs.
Step #3 | Enter Stress Limits
 | Design Top Cap Stress = |  |  | 140000 | Lbs./Sq. In.
 | Design Bottom Cap Stress = |  |  | 250000 | Lbs./Sq. In.
 | Design Shear Stress = |  |  | 12000 | Lbs./Sq. In.
 | Allowed Core Stress = |  |  | 600 | Lbs./Sq. In.
 | Allowable Wing Rod Stress = |  |  | 90000 | Lbs./Sq. In.
Step #4 | Design Top Spar
 | Top Spar Design
 |  | Describe Selected Spar Stock (Use Only Half Spar Length On Double Tapered Spars
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
