duanebeck/Allegro-Lite/Photos/B D wingtip spar wrap # 2.jpg

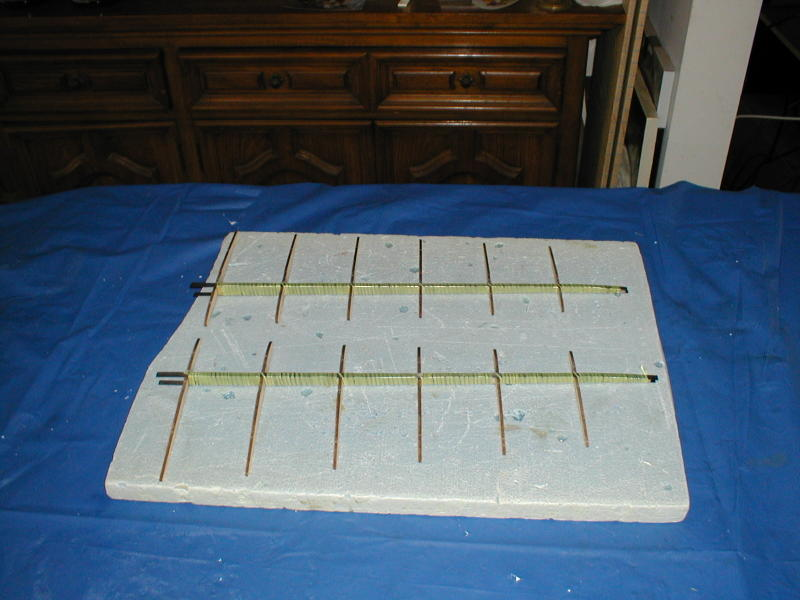
Photos/B D wingtip spar wrap # 2.jpg
