duanebeck/Allegro-Lite/Photos/Stretch Aegea #2.jpg

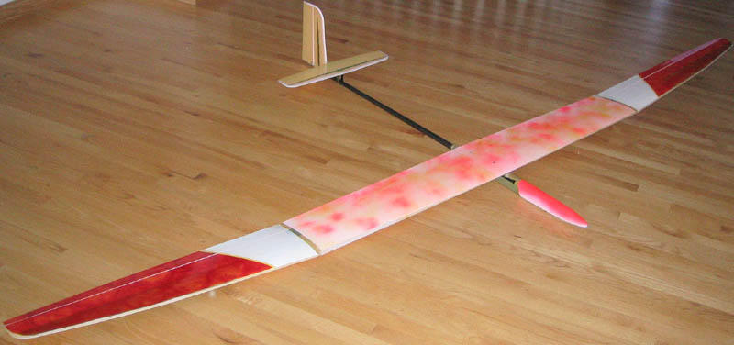
Photos/Stretch Aegea #2.jpg
