duanebeck/Allegro-Lite/Photos/Thermic View #1.jpg

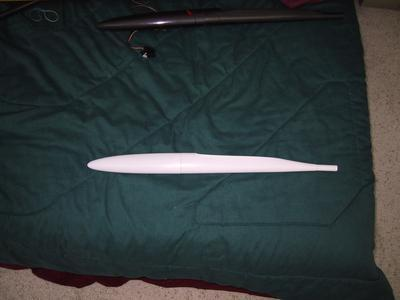
Photos/Thermic View #1.jpg
