duanebeck/Allegro-Lite/Photos/V-M #1.jpg

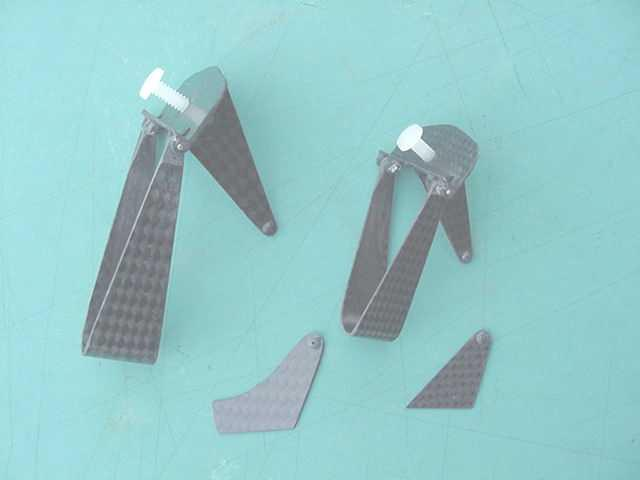
Photos/V-M #1.jpg
