duanebeck/Allegro-Lite/Photos/V-M #2.jpg

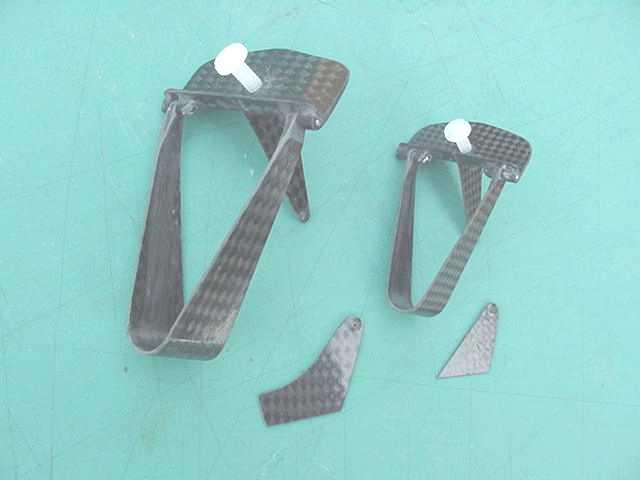
Photos/V-M #2.jpg
