duanebeck/Allegro-Lite/Photos/V-M # 3.jpg

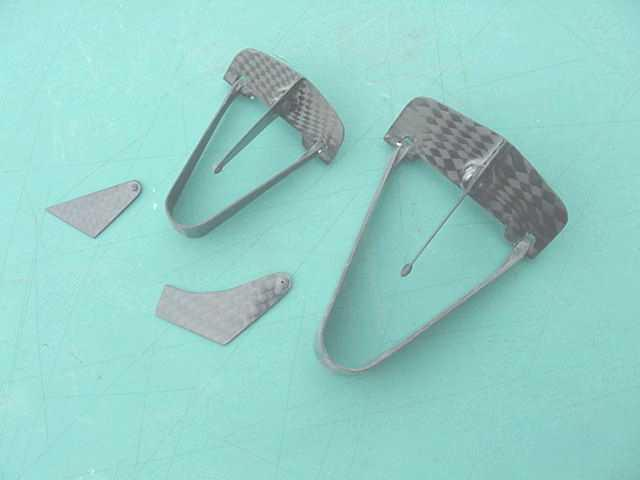
Photos/V-M # 3.jpg
