duanebeck/Allegro-Lite/material_properties.txt

                 rho     sig11  tau12  E11   E22   G12 
                g/in^3   ksi    ksi    ksi   ksi   ksi 
----------
balsa  4lb      1.05     1.0    0.2    200          10
spruce 25lb     6.56     5.0    1.0   1700          90
CF 0           26.22   200.0   10.0  20000  1700   800
CF +/-45       26.22          100.0   6400  6400  5200
GF 0           31.20   200.0   10.0  10000   800   400
GF +/-45       31.20          100.0   3200  3200  2600
Kevlar 0       23.00   200.0   10.0  15000  1200   600
Kevlar +/-45   23.00           50.0   4800  4800  3900  
Monokote 2 mil 20.00                   400   400   150
 (1 mil bare)
