duanebeck/Allegro-Lite/bd_wood_lonestar.xls

BUBBLE DANCER Wood Part Listing |  | Prices as of: 2005/08/22
as ordered from LONE STAR BALSA |  | Compiled by Ben Wilson (ben@thelocust.org)
Item# | Item Description | BD Part | Quantity | Price | Total
1.500 | AAA 4-6 LB. BALSA SHEETS | Spar Cover Filler | 1 | $0.85 | $0.85
 | AAA 4-6 LB. BALSA SHEETS - 2" WIDE | 6-8#, C Grain
 | 1/32" X 2" X 36"
1.503 | AAA 4-6 LB. BALSA SHEETS | Rear Support Strips | 1 | $1.03 | $1.03
 | AAA 4-6 LB. BALSA SHEETS - 2" WIDE | 5-7#
 | 3/32" X 2" X 36"
1.504 | AAA 4-6 LB. BALSA SHEETS | Tail TE's | 1 | $1.25 | $1.25
 | AAA 4-6 LB. BALSA SHEETS - 2" WIDE | 6-8#, C Grain
 | 1/8" X 2" X 36"
1.506 | AAA 4-6 LB. BALSA SHEETS | Spoiler | 1 | $1.73 | $1.73
 | AAA 4-6 LB. BALSA SHEETS - 2" WIDE | 6-8#, C Grain
 | 1/4" X 2" X 36"
1.507 | AAA 4-6 LB. BALSA SHEETS | Tail Main Structure | 1 | $2.05 | $2.05
 | AAA 4-6 LB. BALSA SHEETS - 2" WIDE | 6-8#
 | 3/8" X 2" X 36"
33 | AAA 4-6 LB. BALSA SHEETS | Tip and Mid Sheeting | 4 | $2.41 | $9.64
 | AAA 4-6 LB. BALSA SHEETS - 4" WIDE | 2 shts 4-5#, B or C
 | 1/16" X 4" X 48" | 2 shts 6-8#, B or C
104 | AAA BALSA SHEETS | Center Sheeting | 2 | $0.95 | $1.90
 | AAA BALSA SHEETS - 4" WIDE | 10-12#, B or C grain
 | 3/32" X 4" X 36"
319 | AAA BALSA SPECIAL SHAPES | Sheeting Gussets | 1 | $0.34 | $0.34
 | AAA BALSA TRIANGLES
 | 1/4" X 36"
341 | AAA BALSA SPECIAL SHAPES | Tip TE's | 1 | $0.67 | $0.67
 | AAA BALSA TAPERED AILERON AND ELEVATOR | 5-6#, C Grain
 | 1/4" X 1" X 36"
346 | AAA BALSA SPECIAL SHAPES | Center TE's | 1 | $0.87 | $0.87
 | AAA BALSA TAPERED AILERON AND ELEVATOR | 6-8#, C Grain
 | 5/16" X 1-1/2" X 36"
354 | AAA BALSA SPECIAL SHAPES | Mid-Panel TE's | 1 | $1.07 | $1.07
 | AAA BALSA TAPERED AILERON AND ELEVATOR | 5-6#, C Grain
 | 1/4" X 1-1/4" X 48"
390 | PLYWOOD | Bulkhead Faces | 1 | $1.00 | $1.00
 | 3 PLY BIRCH PLYWOOD - 6" WIDE
 | 1/32" X 6" X 12"
551 | BASSWOOD | Pod Siderails / | 1 | $0.85 | $0.85
 | BASSWOOD STICKS - 48" LONG | Servo Rails
 | 1/4" X 1/2"
552 | BASSWOOD | Bolt Beam Core | 1 | $1.08 | $1.08
 | BASSWOOD STICKS - 48" LONG
 | 1/4" X 3/4"
709.38 | NYLON, FIBERGLASS AND CARBON FIBER | Joiner Rods | 1 | $8.50 | $8.50
 | CARBON FIBER ROD
 | .375x48"
552 | BASSWOOD | Joiner Boxes | 1 | $3.09 | $3.09
 | BASSWOOD SHEETS - 3" WIDE x 24" LONG | see joiner_build.pdf
 | 3/4" x 3" | in the "FILES" folder
 |  |  |  | S&H | 8.5
 |  |  |  | TOTAL | $44.42
Notes: Please note that I ordered "over" what I thought I might need. For instance, the plans only call for 24" of 1/4x1/2 basswood, and I ordered 48"
Also, it might do you well to "double up" on some pieces, like the sheeting, to be able to be "choosy" about that wood
during your build.
