duanebeck/Allegro-Lite/Bubble Dancer/vtail_V2.dxf

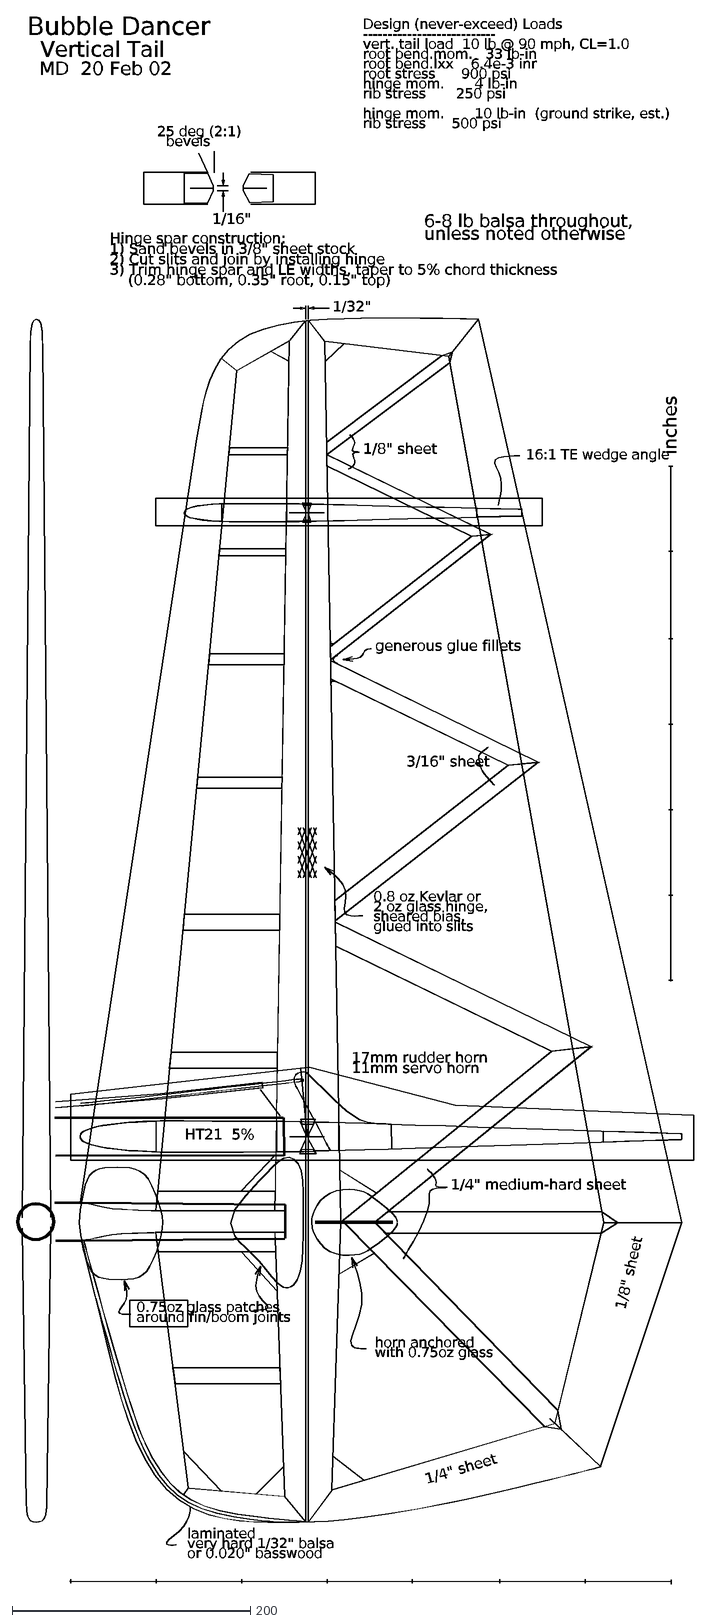
[picture p307: CAD file, 2019-11-18]
Bubble Dancer/vtail_V2.dxf
1/8" sheet
inches
6-8 lb balsa throughout,
unless noted otherwise
16:1 TE wedge angle
generous glue fillets
1/4" sheet
3/16" sheet
Design (never-exceed) Loads
---------------------------
vert. tail load 10 lb @ 90 mph, CL=1.0
root bend.mom. 33 lb-in
root bend.Ixx 6.4e-3 inr
root stress 900 psi
hinge mom. 4 lb-in
rib stress 250 psi
hinge mom. 10 lb-in (ground strike, est.)
rib stress 500 psi
1/4" medium-hard sheet
Bubble Dancer
Vertical Tail
25 deg (2:1)
bevels
1/16"
1/32"
laminated
very hard 1/32" balsa
or 0.020" basswood
0.8 oz Kevlar or
2 oz glass hinge,
sheared bias,
glued into slits
Hinge spar construction:
1) Sand bevels in 3/8" sheet stock
2) Cut slits and join by installing hinge
3) Trim hinge spar and LE widths, taper to 5% chord thickness
(0.28" bottom, 0.35" root, 0.15" top)
17mm rudder horn
11mm servo horn
HT21 5%
MD 20 Feb 02
horn anchored
with 0.75oz glass
0.75oz glass patches
around fin/boom joints
