duanebeck/Allegro-Lite/(list of files, cad)

Other CAD files:
AllegroL.dwg
Bubble Dancer/Autocad laser files/tip_web.dwg
Bubble Dancer/big_wing_plan.dxf
Bubble Dancer/Autocad laser files/mid_web.dwg
Bubble Dancer/fusepod.dxf
Bubble Dancer/Autocad laser files/break_rib.dwg
Bubble Dancer/Autocad laser files/cen_web.dwg
Bubble Dancer/htail_V2.dxf
Bubble Dancer/Autocad laser files/cen_rib.dwg
Bubble Dancer/Autocad laser files/mid_rib.dwg
Bubble Dancer/Autocad laser files/tip_rib.dwg
