duanebeck/Allegro-Lite/Supra/sparbuild.pdf

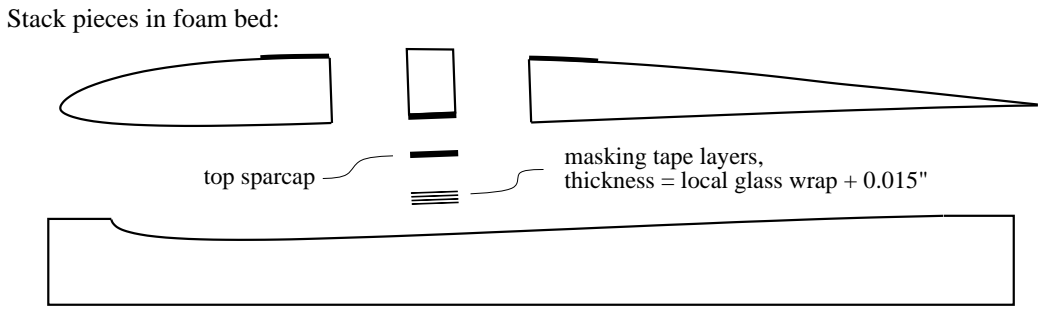
[picture p356: figure]
top sparcap; Stack pieces in foam bed:; masking tape layers, thickness = local glass wrap + 0.015"

Sand spar core and joiners flush with top of wing core

Glue on top sparcap | Round off cap edges | Wrap spar with glass, wet out & bag
Wrapped−Spar Construction with Bagged Wings | MD 12 July 04

Glue foam cutout to bottom sparcap,
including prefabbed joiner boxes.
Bond with foam is not critical (sparse 5 min epoxy OK).
Bond with joiner boxes is critical (gap−free slow epoxy essential).

Joiner bottoms must
be precisely shaped
beforehand

cut out piece must be very slightly wider than local sparcap (account for saw kerfs!)

(can be done beforehand)

Sand servo wire channel

Tack−glue cores onto spar (bond quality not critical)

on bottom of spar (ensures no spar bump)

Fill corner voids with Micro−fill, sand foam and fill flush with spar

Cut and prepare for integral hinge (optional).

Bag wing as usual.

Glue on medium A−grain 1/32" balsa strip, sand flush (very little will be left)

Slight sanding into glass on sparcaps is tolerable (assuming cap edges are well rounded)

This step can be done first, to reduce risk of spar work loss due to bad hinge cut.
