duanebeck/Allegro-Lite/Allegro Photos #13/Final picture before install.jpg

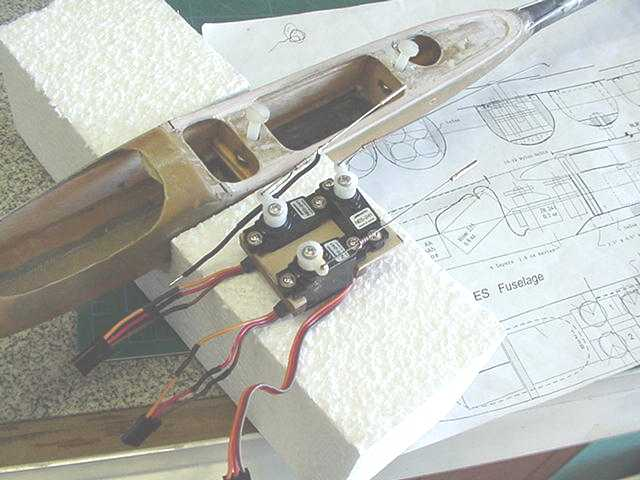
Allegro Photos #13/Final picture before install.jpg
