duanebeck/Allegro-Lite/Allegro photos/Assembled composite Allegro E 20 ounces all up.jpg

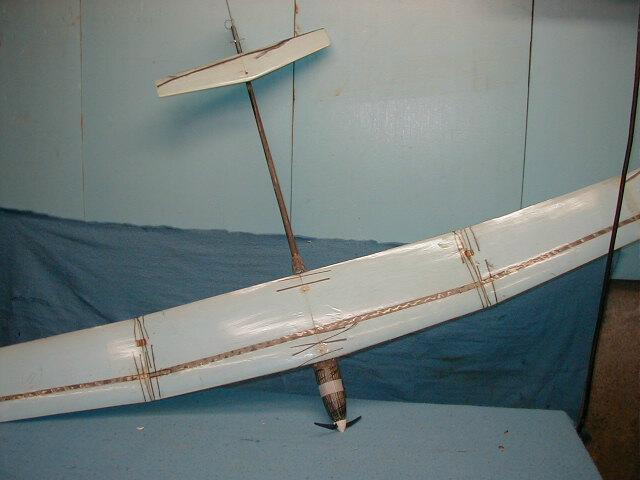
Allegro photos/Assembled composite Allegro E 20 ounces all up.jpg
