duanebeck/Allegro-Lite/Allegro photos/Assembled tail surfaces.jpg

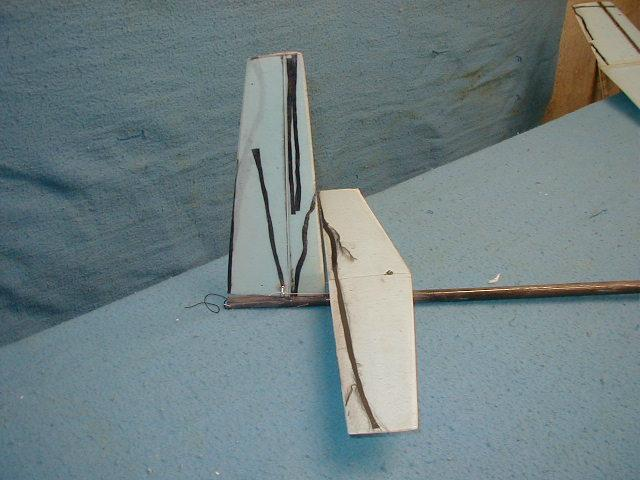
Allegro photos/Assembled tail surfaces.jpg
