duanebeck/Allegro-Lite/EZ Dancer Design Specifications.pdf

## MSR

# EZ Dancer©

The EZ Dancer is an RES design intended to be competitive with European CF reinforced planes and suited for construction by reasonably competent builders. CF reinforced construction i.e. CF rib caps and TE’s is not difficult if the plane is properly designed. All parts of the EZ Dancer have been designed and will come pre-shaped either as laser cut parts, molded parts, or machine cut parts. Wing Spars are CF capped, balsa core and machine wrapped Kevlar with CF joiner rods, designed in the Drela mode – they will come complete and ready use. All construction is self jigging. In keeping with the current trends in RES planes, the four objectives which are emphasized in this design are aerodynamics, weight, strength and the ability to build a very straight plane. The attached drawings show the layout and overall specifications for the plane. Rather than using a fully molded pod, the EZ Dancer utilizes a sort of “Tinkertoy” approach to design, using a prefabricated boom, a CF transition piece and pod parts which attach to the transition and are preshaped from vacuum bagged balsa and uni-directional and bias CF fabrics. This design was selected to reduce manufacturing costs, and to allow easy modification to accommodate other wings, booms and nose lengths. I have other fully molded pods available if this design is not esthetically pleasing to the builder.

I am currently constructing tooling to allow easy construction of the wing spar assemblies, fuselage transition, fuselage parts and controls. If there is interest, I will manufacture and sell kits – anticipated price is around $300. This will include all parts required for construction except covering and adhesives. Spars will come fully fabricated including joiner assemblies and machine wrapped Kevlar reinforcement, D-tube skins will be pre-fabricated, fuselage parts will be laminated and machined to shape, all CF materials will be furnished and all ribs and other parts will be furnished laser cut.

I anticipate completion of tooling in about 6 weeks. Before kits go on sale, I am looking for five good builders in various parts of the country who are interested in constructing “beta” versions of the kit to ensure that the design is sound from a simple construction perspective and that performance is up to snuff. I have nearly completed the design of all the laser cut parts and will be getting quotes on those in about 3 weeks. If there is interest I would furnish the “beta” versions at my cost of materials (excluding tooling costs). While I am guessing right now, I think that will be between $100 and $150.

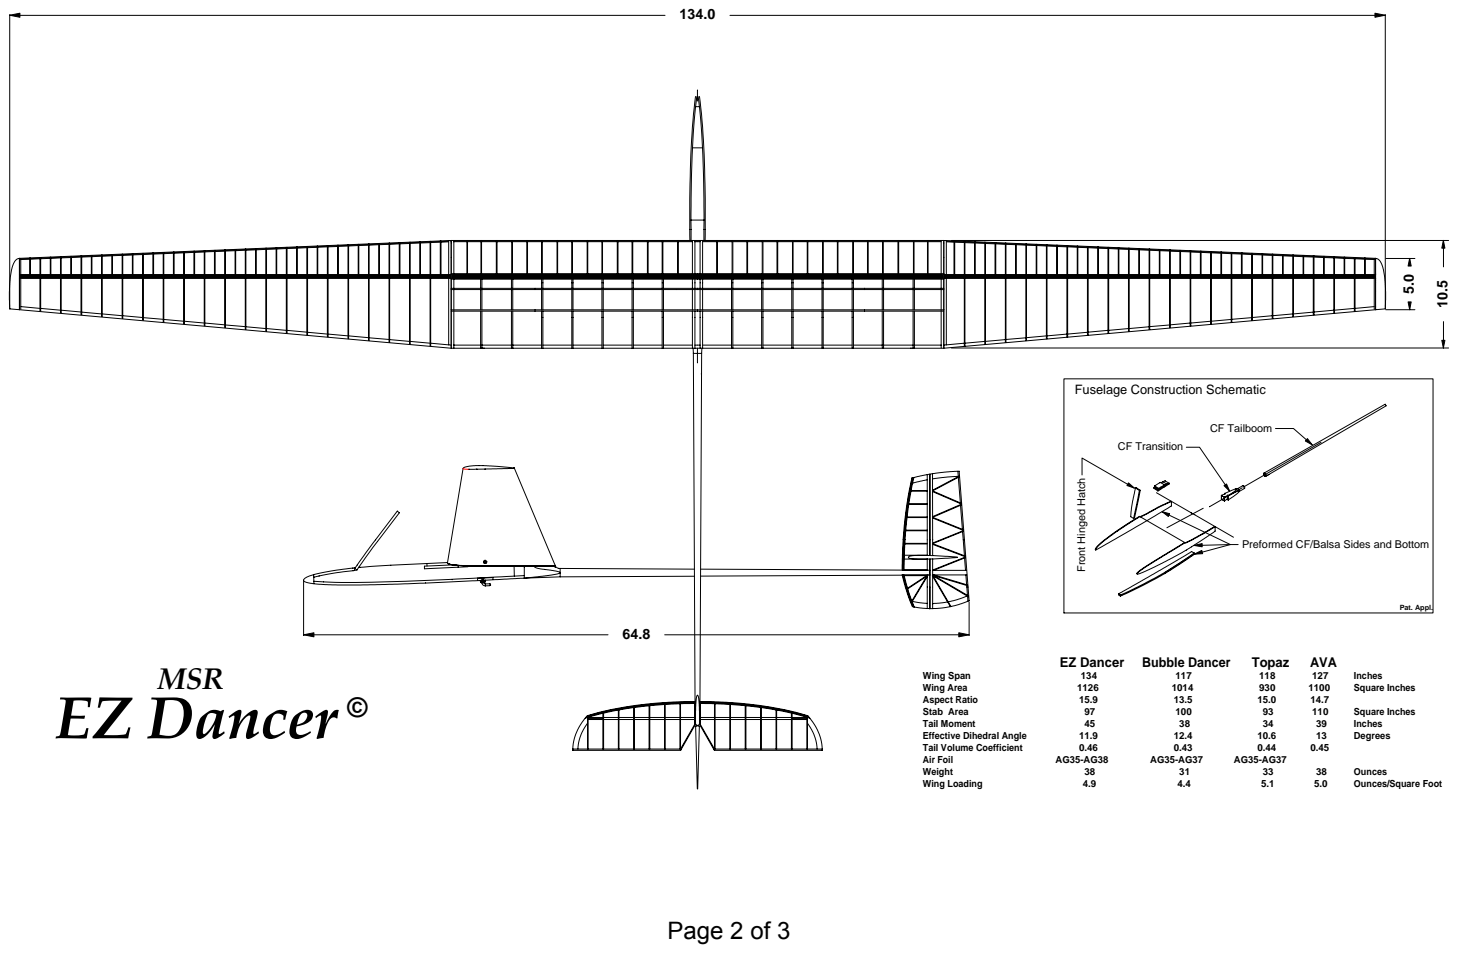
[picture p360: page 2]
EZ Dancer Bubble Dancer; Topaz; AVA; Wing Span; Inches; Wing Area; Square Inches; Aspect Ratio; Stab Area; Tail Moment; Effective Dihedral Angle; Degrees; Tail Volume Coefficient; Air Foil; Weight; Ounces; Wing Loading; Ounces/Square Foot; EZ Dancer; MSR; Pat. Appl.; CF Tailboom; CF Transition

Fuselage Construction Schematic

Preformed CF/Balsa Sides and Bottom

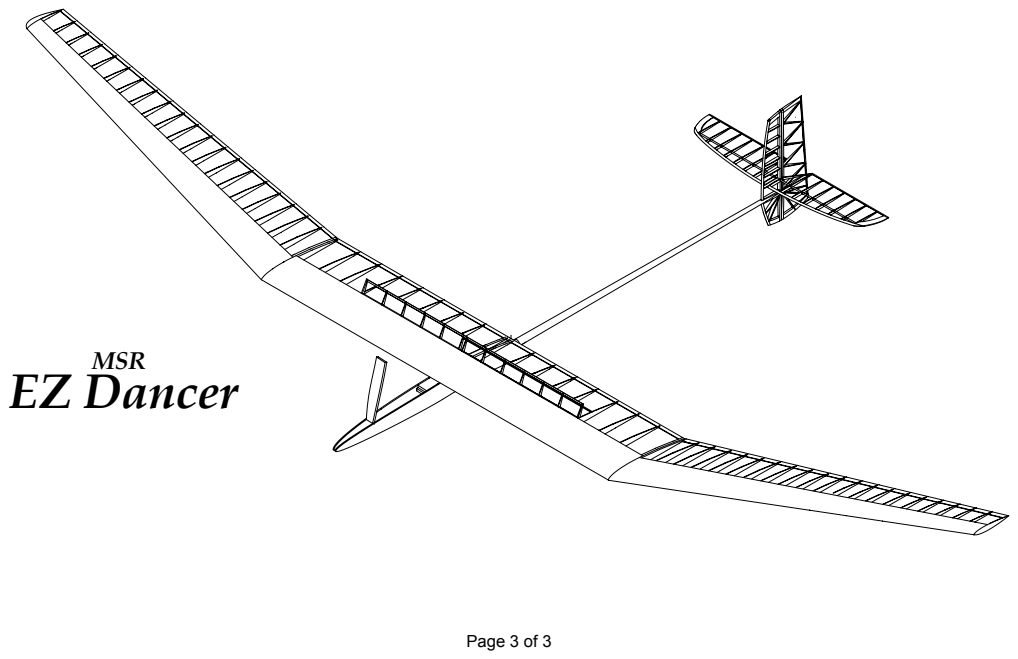
[picture p361: page 3]
EZ Dancer; MSR
