duanebeck/Allegro-Lite/alt_fuseE1.pdf

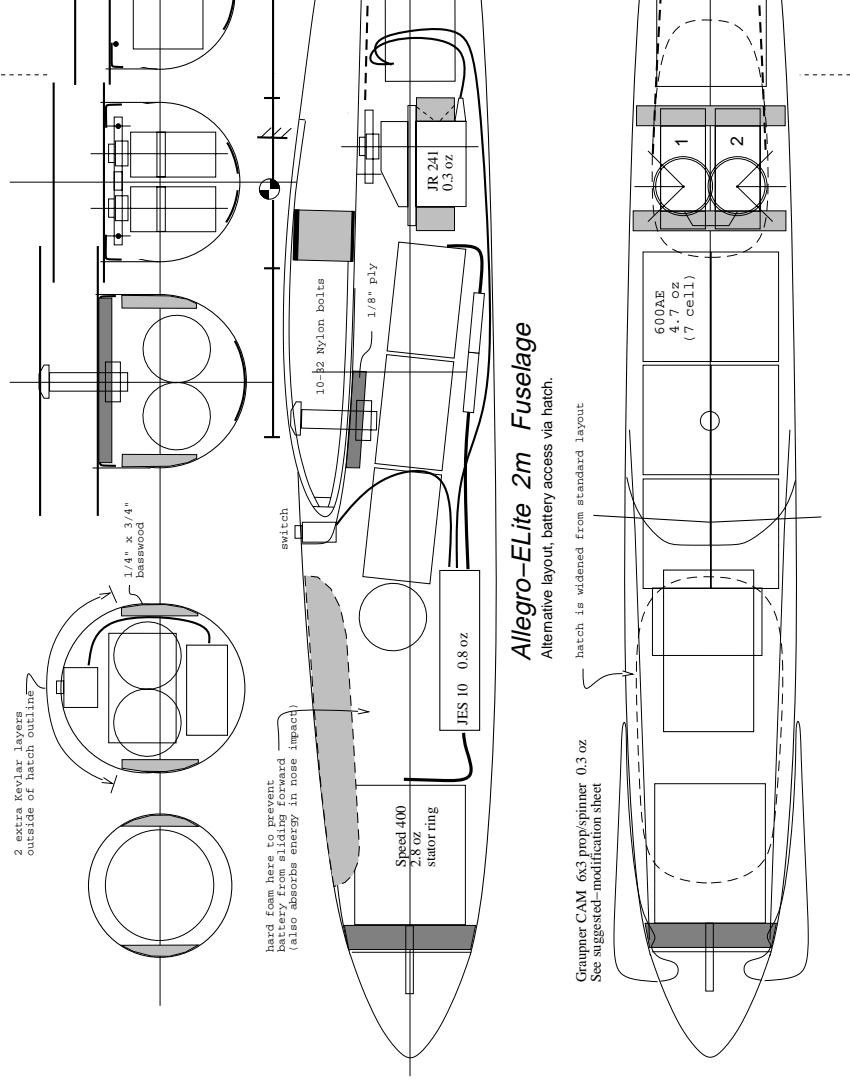
[picture p362: page 1]
10−32 Nylon bolts; JES 10 0.8 oz; (7 cell); Speed 400; stator ring; switch; basswood; 1/8" ply

Allegro−ELite 2m Fuselage

Alternative layout, battery access via hatch.

hatch is widened from standard layout

outside of hatch outline

(also absorbs energy in nose impact)

2 extra Kevlar layers

Graupner CAM 6x3 prop/spinner 0.3 oz

battery from sliding forward

hard foam here to prevent

See suggested−modification sheet
