duanebeck/Allegro-Lite/alt_fuseE2.pdf

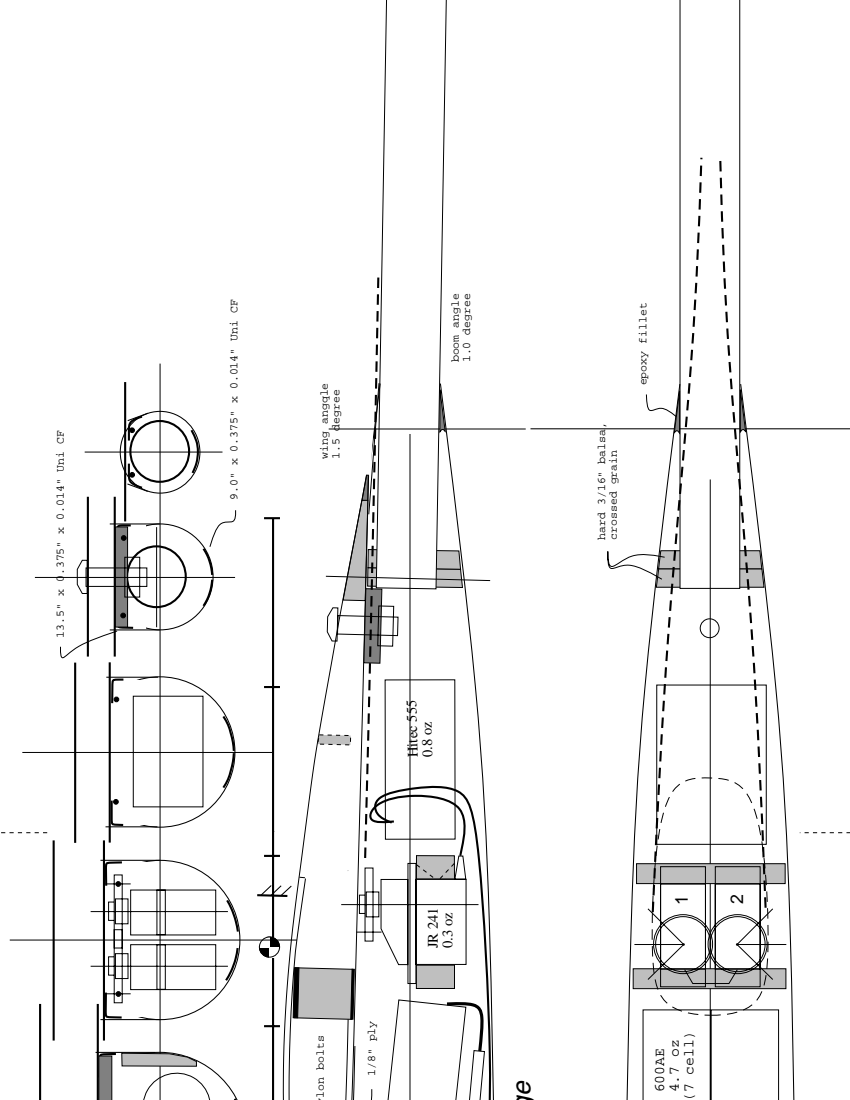
[picture p363: page 1]
9.0" x 0.375" x 0.014" Uni CF; 13.5" x 0.375" x 0.014" Uni CF; boom angle; 1.0 degree; ylon bolts; Hitec 555 0.8 oz; wing angqle 1.5 degree; (7 cell); 1/8" ply; hard 3/16" balsa,; crossed grain; epoxy fillet
