duanebeck/Allegro-Lite/bendload.pdf

l

F

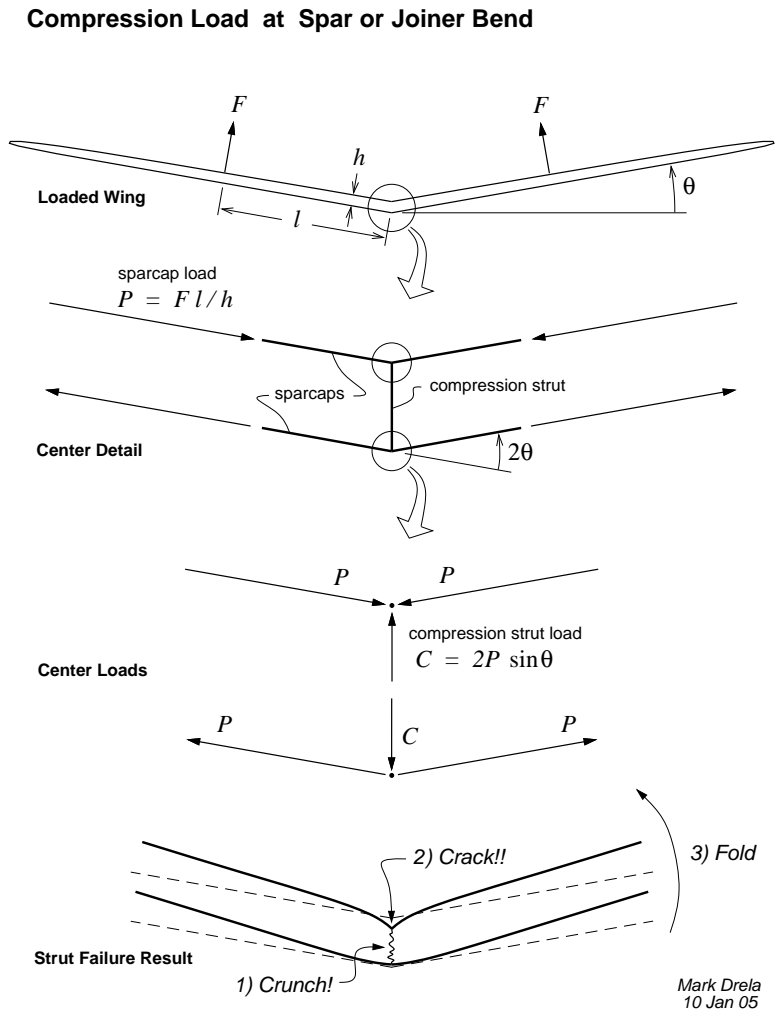
[picture p364: page 1]
sparcaps; compression strut; sparcap load; Loaded Wing; Center Detail; Center Loads; 2) Crack!!; 3) Fold; 1) Crunch!; Mark Drela; 10 Jan 05

Compression Load at Spar or Joiner Bend

compression strut load
C = 2P sinθ

Strut Failure Result
