duanebeck/Allegro-Lite/v_home.pdf

## M.Drela 01.12.01

# Allegro V−mount

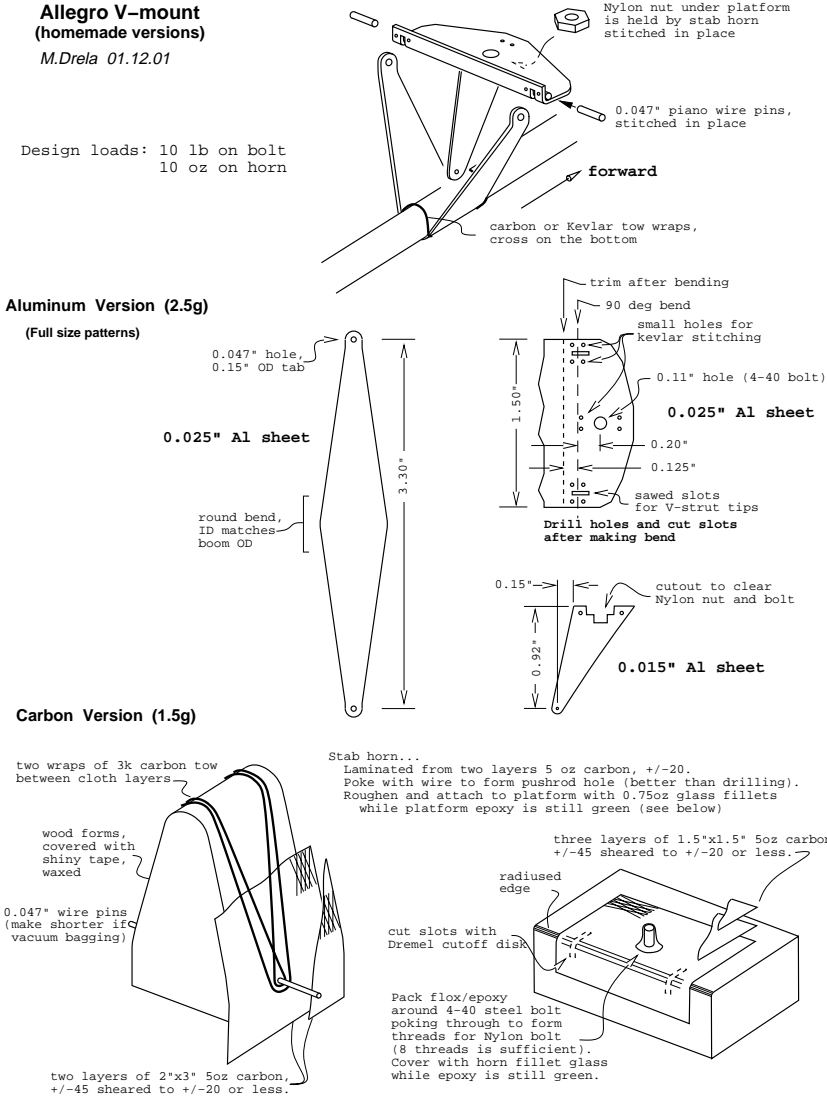
[picture p365: page 1]
round bend, ID matches boom OD; 0.025" Al sheet; 0.015" Al sheet; 0.047" hole, 0.15" OD tab; (homemade versions); forward; wood forms, covered with shiny tape, waxed; Carbon Version (1.5g); Aluminum Version (2.5g); 0.11" hole (4−40 bolt); radiused edge

Nylon nut under platform
is held by stab horn
stitched in place

0.047" piano wire pins,

Design loads: 10 lb on bolt

10 oz on horn

carbon or Kevlar tow wraps,
cross on the bottom

trim after bending
90 deg bend
small holes for
kevlar stitching

(Full size patterns)

sawed slots
for V−strut tips

Drill holes and cut slots
after making bend

cutout to clear
Nylon nut and bolt

Stab horn...
Laminated from two layers 5 oz carbon, +/−20.
Poke with wire to form pushrod hole (better than drilling).
Roughen and attach to platform with 0.75oz glass fillets
while platform epoxy is still green (see below)

two wraps of 3k carbon tow
between cloth layers

three layers of 1.5"x1.5" 5oz carbon
+/−45 sheared to +/−20 or less.

0.047" wire pins
(make shorter if
vacuum bagging)

cut slots with
Dremel cutoff disk

Pack flox/epoxy
around 4−40 steel bolt
poking through to form
threads for Nylon bolt
(8 threads is sufficient).
Cover with horn fillet glass
while epoxy is still green.

two layers of 2"x3" 5oz carbon,
