duanebeck/Allegro-Lite/woodfuse_1.pdf

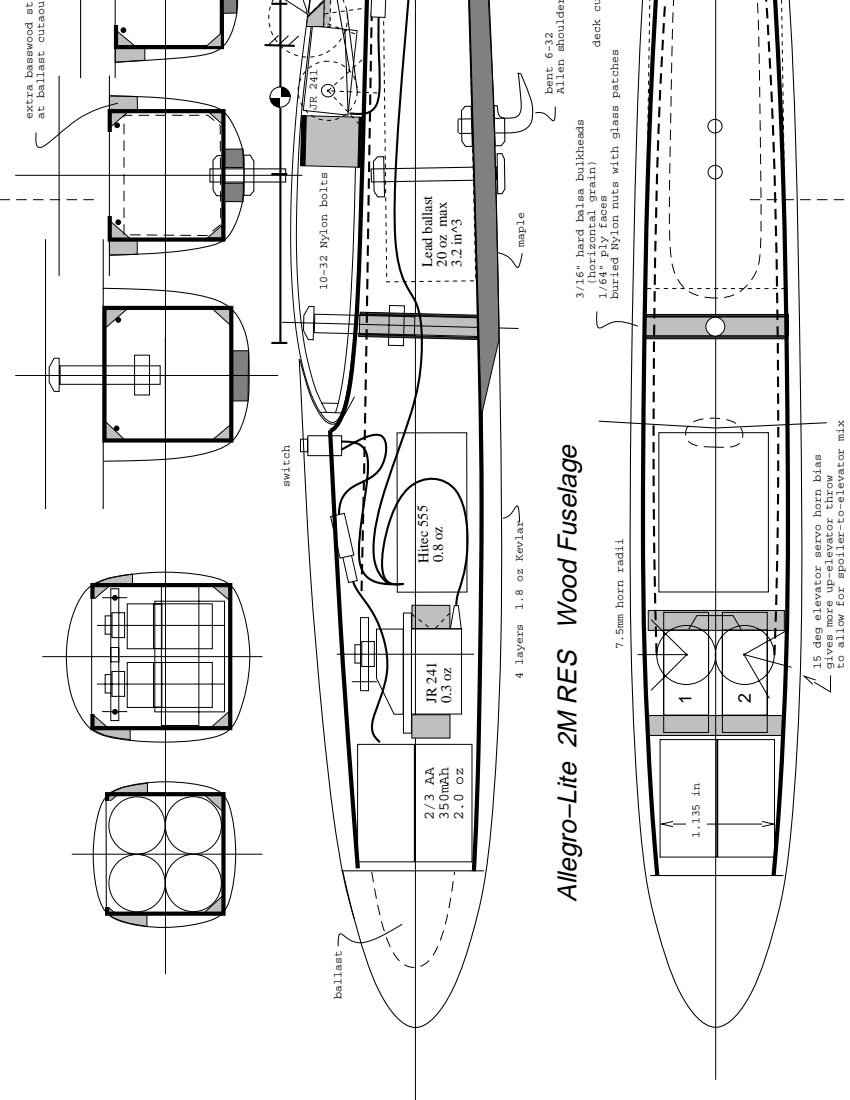
[picture p366: page 1]
Hitec 555 0.8 oz 2/3 AA 350mAh; ballast; 10−32 Nylon bolts; Lead ballast 20 oz max 3.2 in^3; maple; switch; 7.5mm horn radii; deck cu; bent 6−32; Allen shoulder; (horizontal grain); 1/64" ply faces

extra basswood sti

at ballast cutaout

buried Nylon nuts with glass patches

3/16" hard balsa bulkheads

to allow for spoiler−to−elevator mix

Allegro−Lite 2M RES Wood Fuselage

15 deg elevator servo horn bias

gives more up−elevator throw

4 layers 1.8 oz Kevlar
