duanebeck/Allegro-Lite/woodfuse_2.pdf

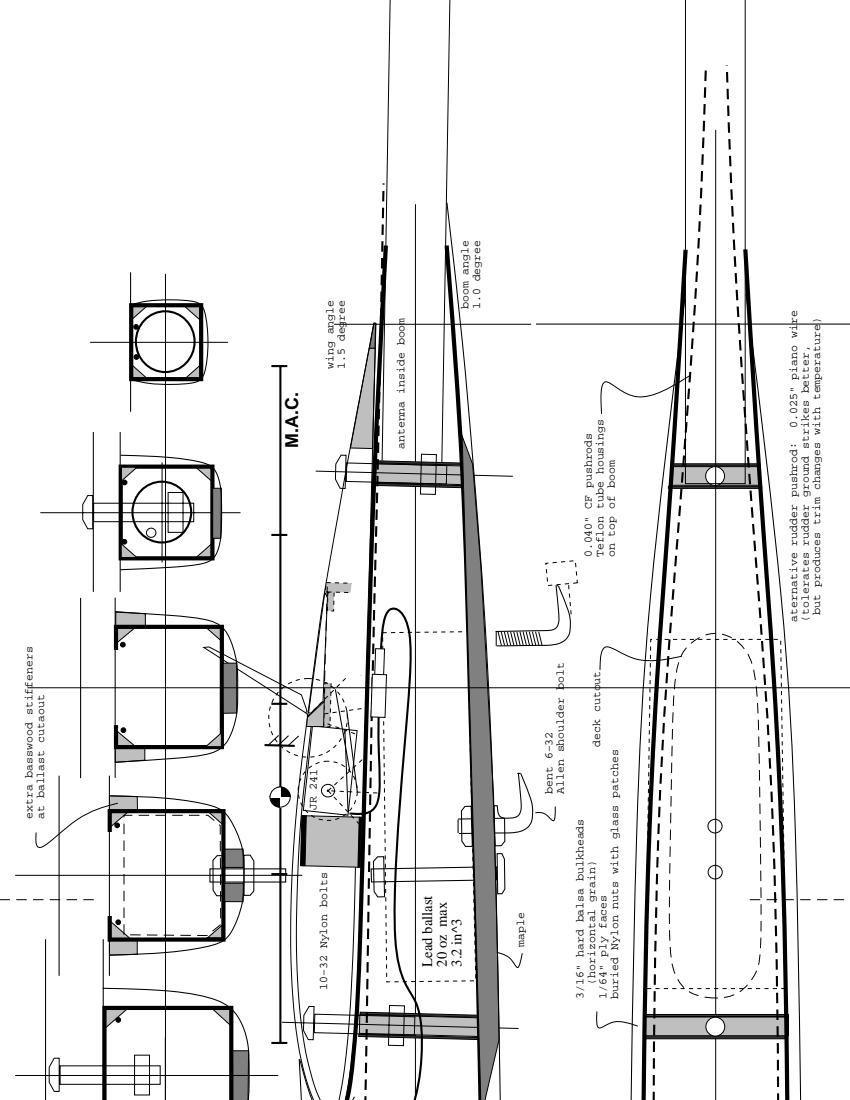
[picture p367: page 1]
boom angle; 1.0 degree; 1.5 degree; Lead ballast 20 oz max 3.2 in^3; 0.040" CF pushrods; maple; deck cutout; bent 6−32; (horizontal grain); 1/64" ply faces

10−32 Nylon bolts wing angle

aternative rudder pushrod: 0.025" piano wire

antenna inside boom

but produces trim changes with temperature)

(tolerates rudder ground strikes better,

Teflon tube housings

on top of boom

extra basswood stiffeners

Allen shoulder bolt

at ballast cutaout

buried Nylon nuts with glass patches

3/16" hard balsa bulkheads
