duanebeck/Allegro-Lite/Aegea-3m/wing1.pdf

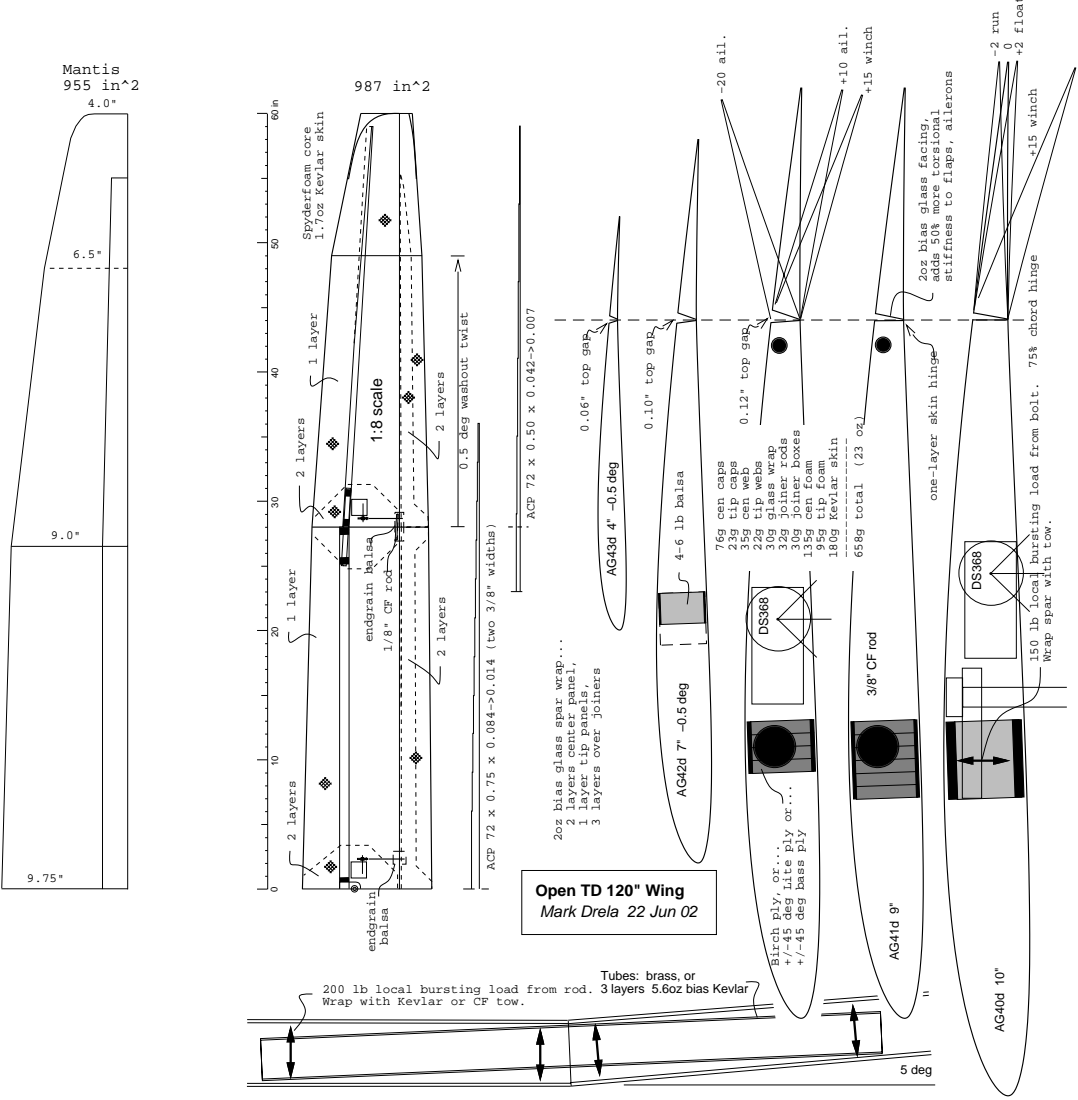
[picture p368: page 1]
ACP 72 x 0.50 x 0.042−>0.007; 75% chord hinge; 0.12" top gap; 0.06" top gap; 0.10" top gap; 2 layers; 1 layer; 2 layers 2 layers; 4−6 lb balsa; endgrain balsa; 5 deg; endgrain; Spyderfoam core; 1.7oz Kevlar skin; 1:8 scale; AG43d 4" −0.5 deg; AG42d 7" −0.5 deg; 2 layers 1 layer; +10 ail.; −20 ail.; +15 winch; −2 run; +2 float; 76g cen caps; 23g tip caps 35g cen web; 22g tip webs; 30g glass wrap; 32g joiner rods; 30g joiner boxes; 135g cen foam; 95g tip foam; 180g Kevlar skin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

stiffness to flaps, ailerons

adds 50% more torsional

2oz bias glass facing,

0.5 deg washout twist

one−layer skin hinge

150 lb local bursting load from bolt.

ACP 72 x 0.75 x 0.084−>0.014 (two 3/8" widths)

Wrap spar with tow.

balsa 1/8" CF rod

2oz bias glass spar wrap...

2 layers center panel,

3 layers over joiners

1 layer tip panels,

+/−45 deg Lite ply or...

+/−45 deg bass ply

Birch ply, or...

Open TD 120" Wing
Mark Drela 22 Jun 02

Tubes: brass, or
3 layers 5.6oz bias Kevlar

200 lb local bursting load from rod.
Wrap with Kevlar or CF tow.
