duanebeck/Allegro-Lite/Aegea-3m/wing2b.pdf

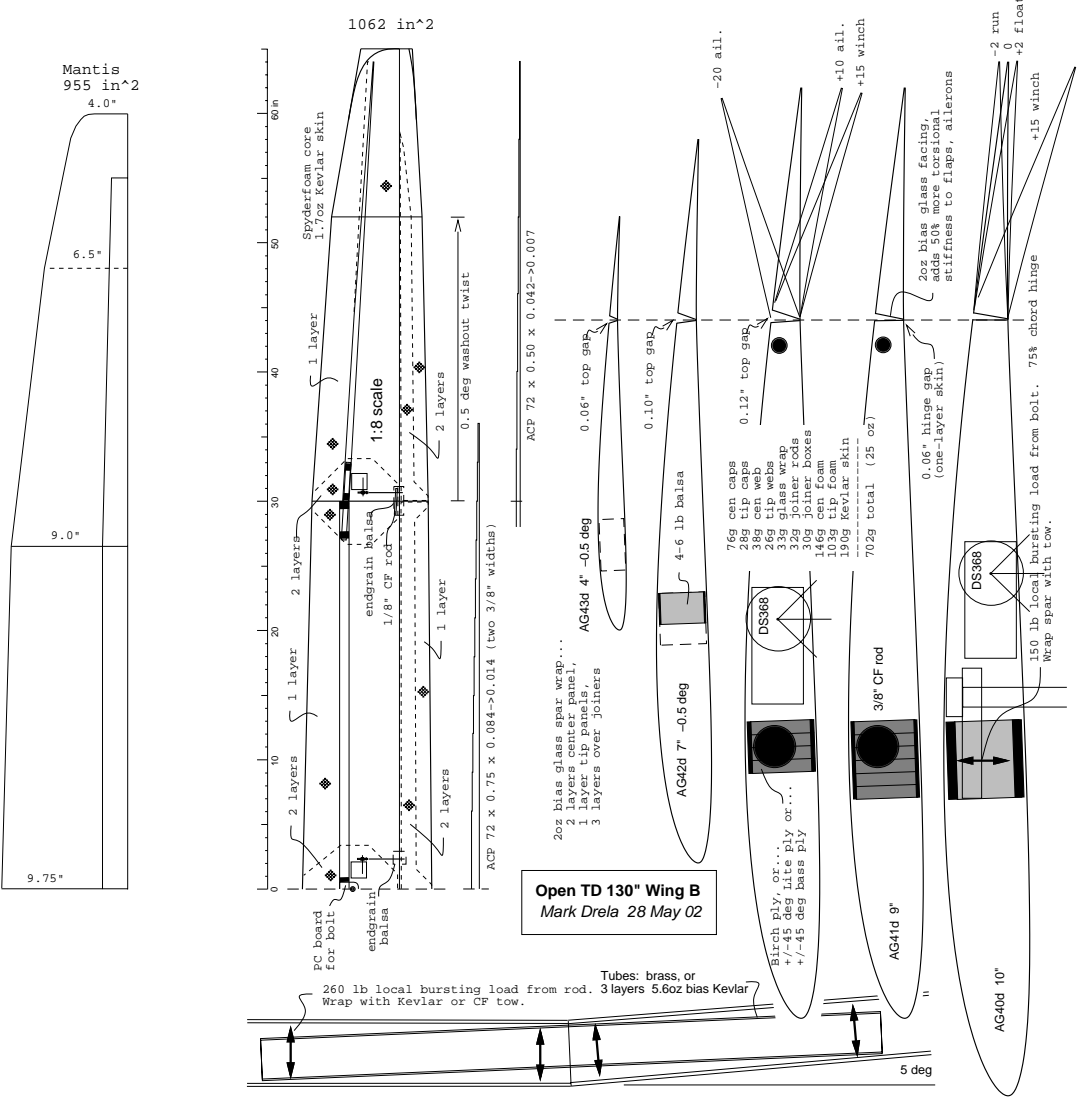
[picture p369: page 1]
ACP 72 x 0.50 x 0.042−>0.007; 75% chord hinge; 0.12" top gap; 0.06" top gap; 0.10" top gap; 2 layers; 1 layer; 4−6 lb balsa; endgrain balsa; 0.06" hinge gap; 5 deg; endgrain; Spyderfoam core; 1.7oz Kevlar skin; 1:8 scale; AG43d 4" −0.5 deg; AG42d 7" −0.5 deg; PC board; for bolt; 2 layers 1 layer; +15 winch; +10 ail.; −20 ail.; −2 run; +2 float; 76g cen caps; 28g tip caps 38g cen web; 26g tip webs; 33g glass wrap; 32g joiner rods; 30g joiner boxes; 146g cen foam; 103g tip foam; 190g Kevlar skin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

stiffness to flaps, ailerons

adds 50% more torsional

2oz bias glass facing,

0.5 deg washout twist

(one−layer skin)

150 lb local bursting load from bolt.

702g total (25 oz) 3/8" CF rod

ACP 72 x 0.75 x 0.084−>0.014 (two 3/8" widths)

Wrap spar with tow.

balsa 1/8" CF rod

2oz bias glass spar wrap...

2 layers center panel,

3 layers over joiners

1 layer tip panels,

+/−45 deg Lite ply or...

+/−45 deg bass ply

Birch ply, or...

Open TD 130" Wing B
Mark Drela 28 May 02

Tubes: brass, or
3 layers 5.6oz bias Kevlar

260 lb local bursting load from rod.
Wrap with Kevlar or CF tow.
