duanebeck/Allegro-Lite/Aegea/aegea.pdf

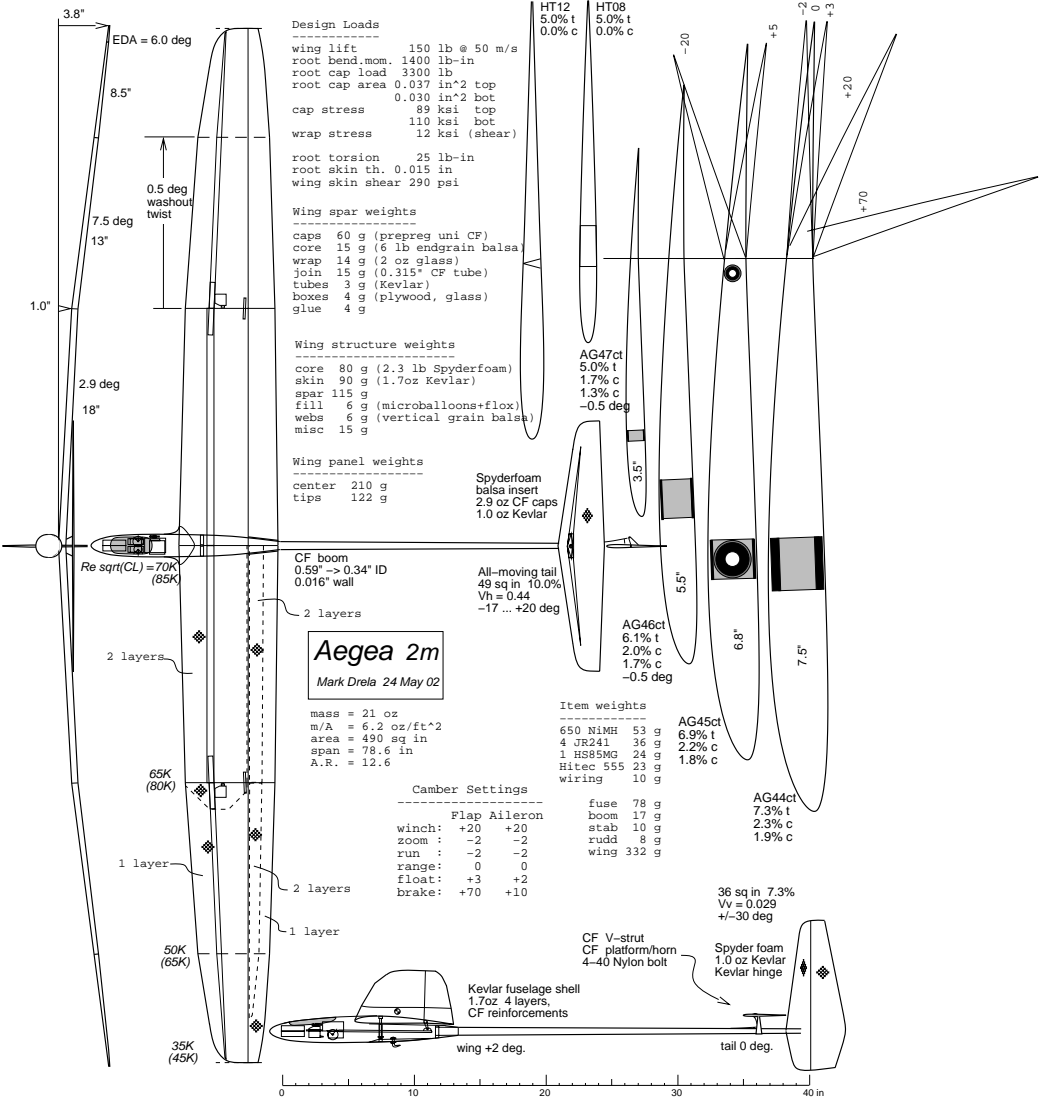
[picture p370: page 1]
tail 0 deg.; Spyder foam 1.0 oz Kevlar Kevlar hinge; wing +2 deg.; wing lift; 0.030 in^2 bot; cap stress; 89 ksi top; 110 ksi bot; wrap stress; 12 ksi (shear); root torsion; 2.9 deg; 7.5 deg; EDA = 6.0 deg; 2 layers; 1 layer; fill; 6 g (microballoons+flox); webs; 6 g (vertical grain balsa); Wing panel weights −−−−−−−−−−−−−−−−−− center 210 g; tips; 36 sq in 7.3% Vv = 0.029 +/−30 deg; Aegea 2m; CF boom 0.59" −> 0.34" ID 0.016" wall; Item weights −−−−−−−−−−−− 650 NiMH 53 g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

Design Loads
root bend.mom. 1400 lb−in
root cap load 3300 lb
root cap area 0.037 in^2 top

root skin th. 0.015 in
wing skin shear 290 psi

Wing spar weights
caps 60 g (prepreg uni CF)
core 15 g (6 lb endgrain balsa)
wrap 14 g (2 oz glass)
join 15 g (0.315" CF tube)
tubes 3 g (Kevlar)
boxes 4 g (plywood, glass)

Wing structure weights
core 80 g (2.3 lb Spyderfoam)
skin 90 g (1.7oz Kevlar)
spar 115 g
misc 15 g

Spyderfoam
balsa insert
2.9 oz CF caps
1.0 oz Kevlar

Re sqrt(CL) =

All−moving tail
−17 ... +20 deg

Mark Drela 24 May 02

mass = 21 oz
area = 490 sq in
span = 78.6 in

CF V−strut
CF platform/horn
4−40 Nylon bolt

Kevlar fuselage shell
1.7oz 4 layers,
CF reinforcements
