duanebeck/Allegro-Lite/Aegea/aegea2.pdf

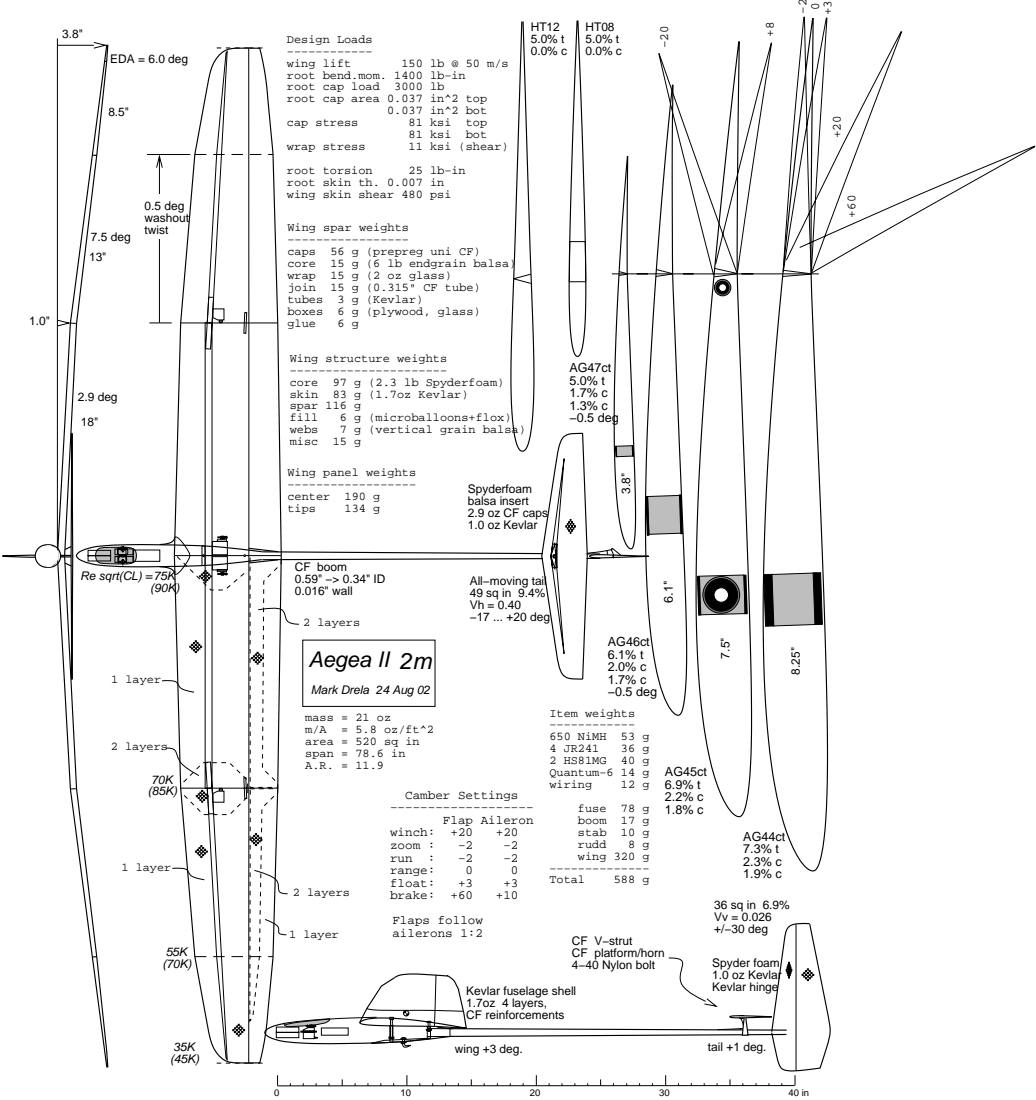
[picture p371: page 1]
Spyder foam 1.0 oz Kevlar Kevlar hinge; 2.9 deg; 7.5 deg; EDA = 6.0 deg; 2 layers; 1 layer; CF boom 0.59" −> 0.34" ID 0.016" wall; Aegea II; All−moving tail 49 sq in 9.4% Vh = 0.40 −17 ... +20 deg; Item weights −−−−−−−−−−−− 650 NiMH 53 g; 2 HS81MG 40 g Quantum−6 14 g; wiring; fuse 78 g boom 17 g stab 10 g; rudd; wing 320 g −−−−−−−−−−−−−−; Total; wing +3 deg.; tail +1 deg.; glue; fill; 6 g (microballoons+flox); webs; 7 g (vertical grain balsa); wing lift; 0.037 in^2 bot; cap stress; 81 ksi top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

root skin th. 0.007 in
wing skin shear 480 psi

Wing spar weights
caps 56 g (prepreg uni CF)
core 15 g (6 lb endgrain balsa)
wrap 15 g (2 oz glass)
join 15 g (0.315" CF tube)
tubes 3 g (Kevlar)
boxes 6 g (plywood, glass)

Wing structure weights
core 97 g (2.3 lb Spyderfoam)
skin 83 g (1.7oz Kevlar)
spar 116 g
misc 15 g

Spyderfoam
balsa insert
2.9 oz CF caps
1.0 oz Kevlar

Re sqrt(CL) =

Mark Drela 24 Aug 02

mass = 21 oz
area = 520 sq in
span = 78.6 in

CF V−strut
CF platform/horn
4−40 Nylon bolt

Kevlar fuselage shell
1.7oz 4 layers,
CF reinforcements
