duanebeck/Allegro-Lite/Aegea/fuse.pdf

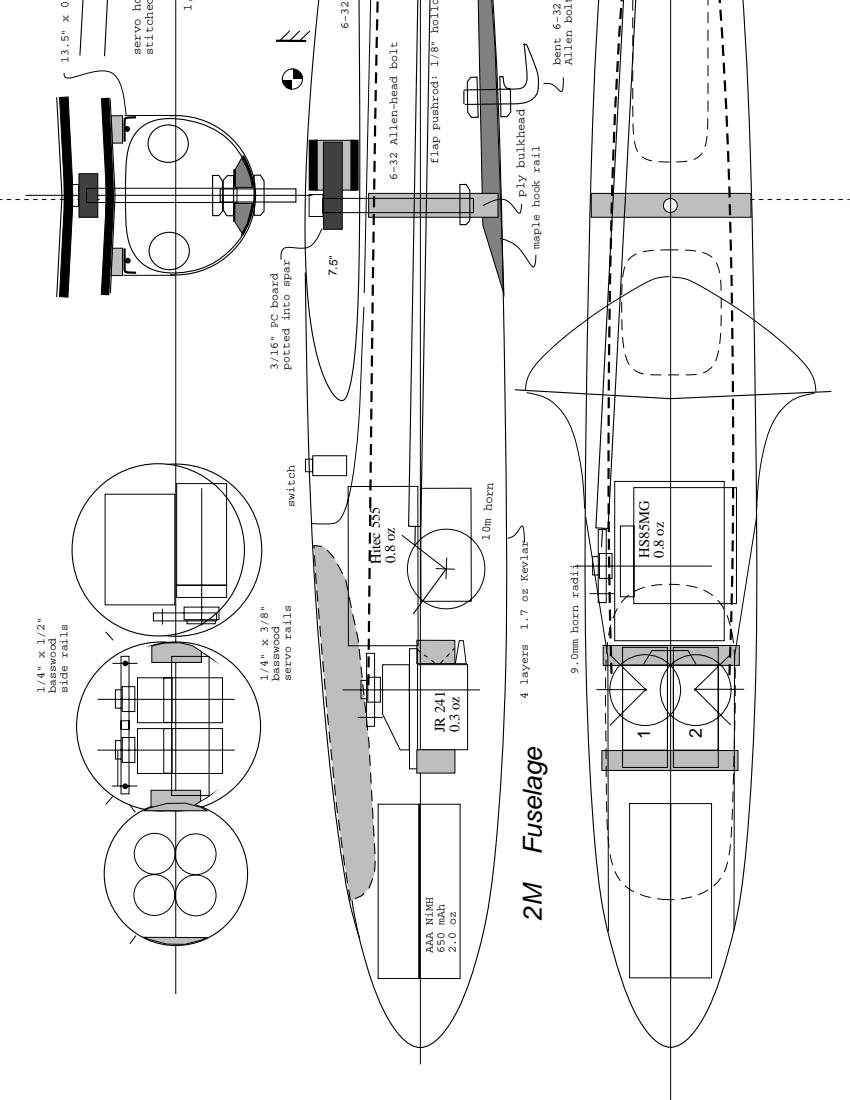
[picture p372: page 1]
basswood; AAA NiMH 650 mAh 2.0 oz; side rails; 2M Fuselage; 3/16" PC board; bent 6−32; Allen bolt; Hitec 555 0.8 oz; 9.0mm horn radii; 10m horn; servo ho; stitched; ply bulkhead

flap pushrod: 1/8" hollo

6−32 Allen−head bolt

maple hook rail

potted into spar

servo rails switch

4 layers 1.7 oz Kevlar

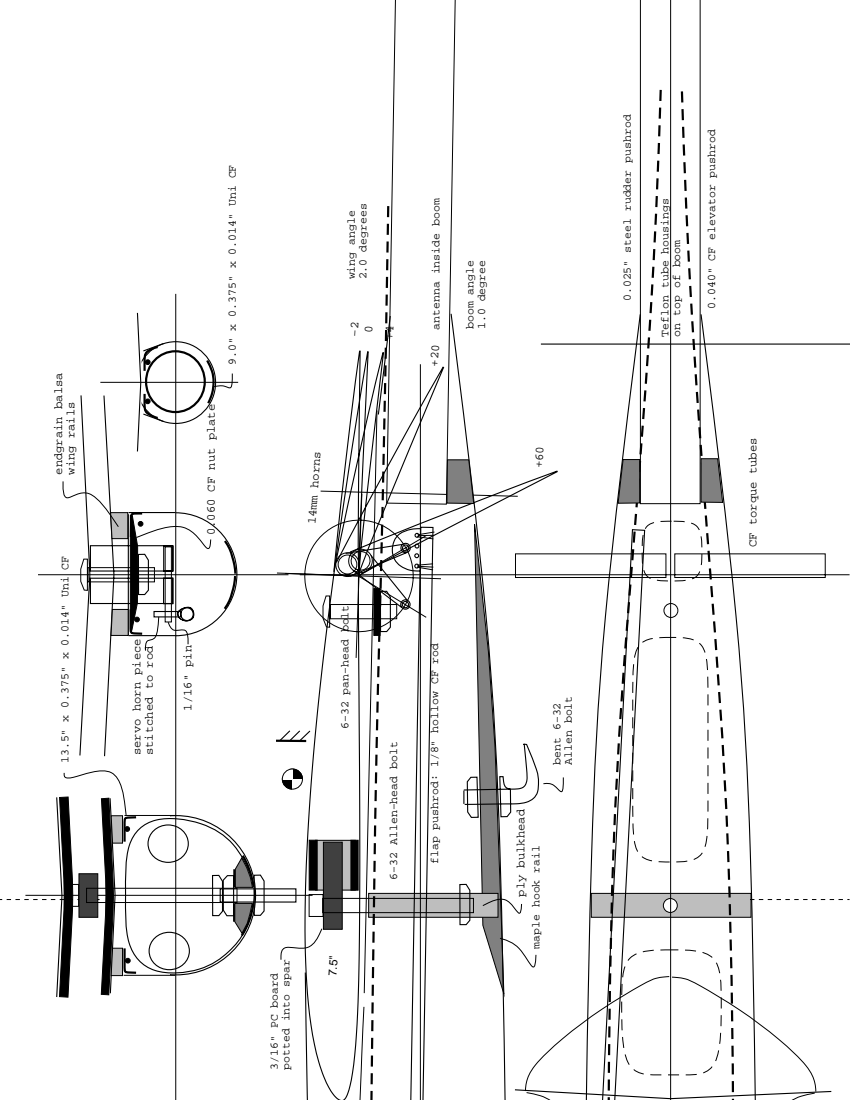
[picture p373: page 2]
9.0" x 0.375" x 0.014" Uni CF; 13.5" x 0.375" x 0.014" Uni CF; boom angle; 1.0 degree; wing angle; 2.0 degrees 0; 3/16" PC board; bent 6−32; Allen bolt; 14mm horns; endgrain balsa; wing rails; 1/16" pin; ply bulkhead

0.025" steel rudder pushrod

0.040" CF elevator pushrod

antenna inside boom

Teflon tube housings

on top of boom

flap pushrod: 1/8" hollow CF rod +20

0.060 CF nut plate

CF torque tubes

6−32 pan−head bolt

servo horn piece

stitched to rod

6−32 Allen−head bolt

maple hook rail

potted into spar
