duanebeck/Allegro-Lite/Aegea/fuse2.pdf

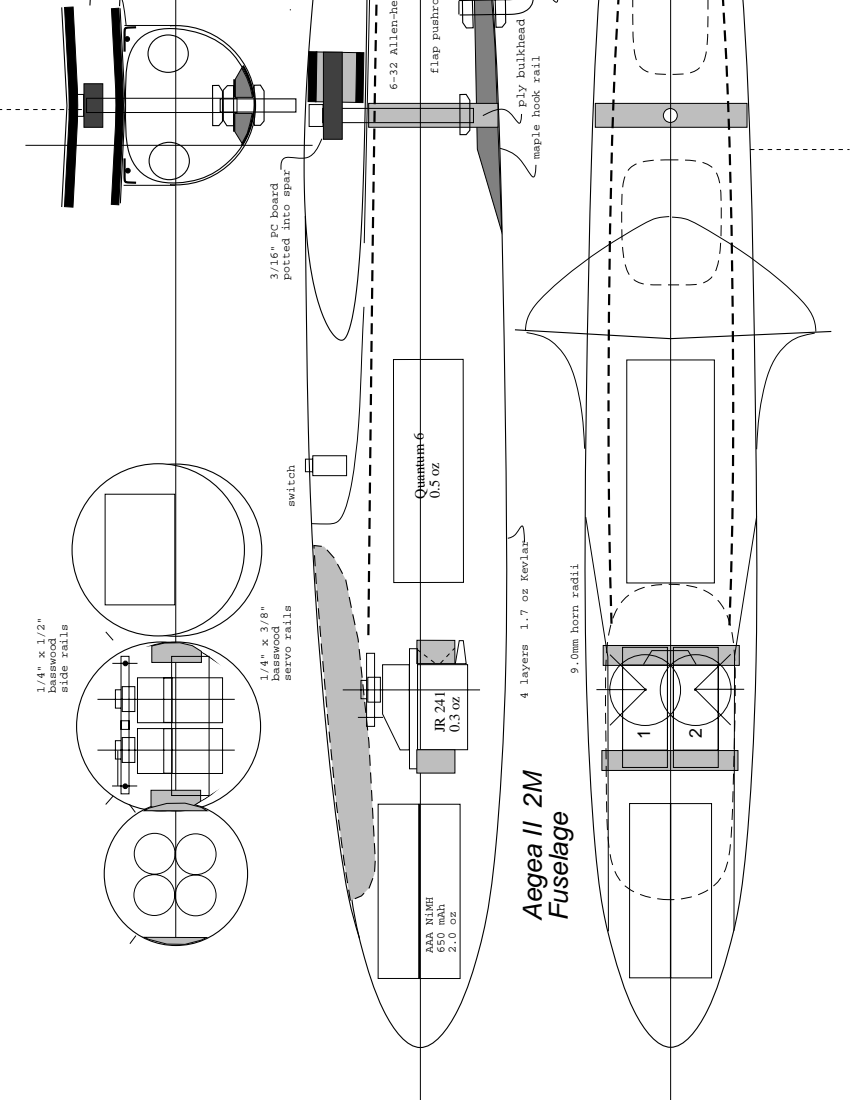
[picture p374: page 1]
basswood; AAA NiMH 650 mAh 2.0 oz; side rails; 3/16" PC board; 9.0mm horn radii; flap pushro; 6−32 Allen−he; ply bulkhead; Fuselage; Quantum 6

maple hook rail Aegea II 2M

potted into spar

servo rails switch

4 layers 1.7 oz Kevlar

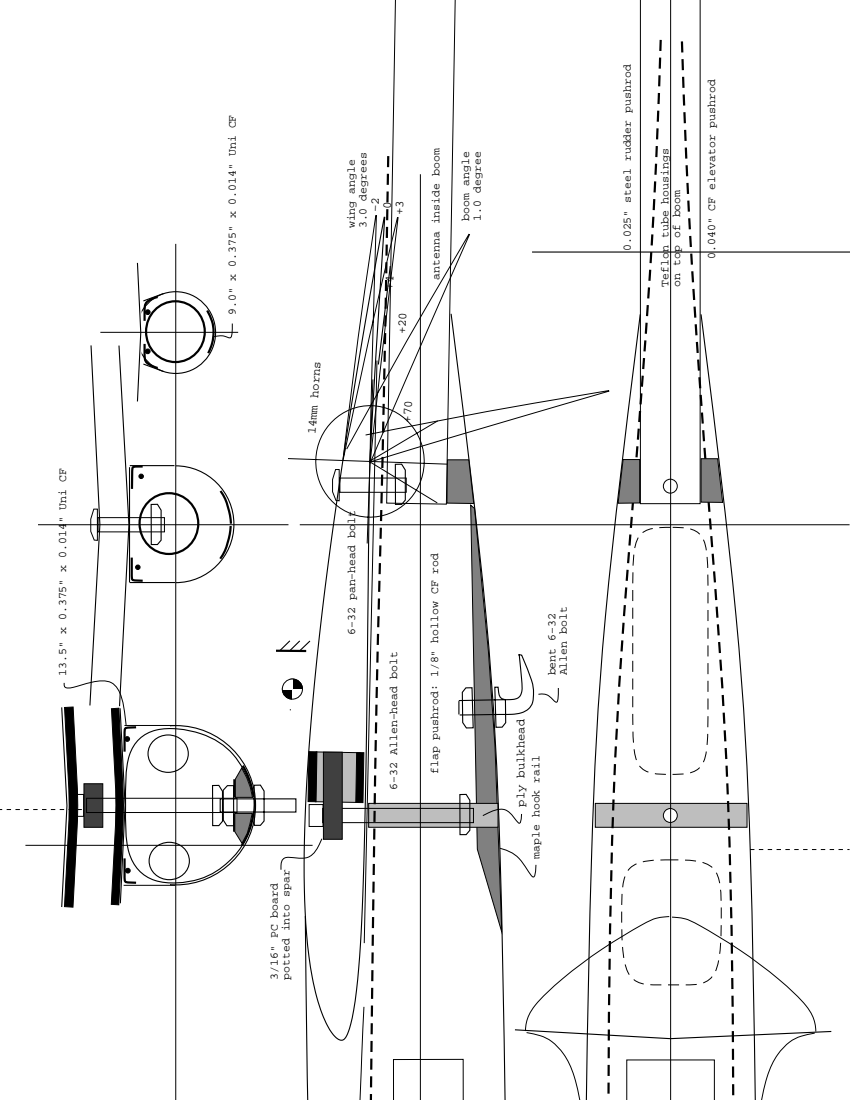
[picture p375: page 2]
9.0" x 0.375" x 0.014" Uni CF; 13.5" x 0.375" x 0.014" Uni CF; boom angle; 1.0 degree; 3/16" PC board; bent 6−32; Allen bolt; 14mm horns; ply bulkhead; wing angle; 3.0 degrees

0.025" steel rudder pushrod

0.040" CF elevator pushrod

antenna inside boom

Teflon tube housings

on top of boom

6−32 pan−head bolt

flap pushrod: 1/8" hollow CF rod

6−32 Allen−head bolt

maple hook rail

potted into spar
