duanebeck/Allegro-Lite/Aegea/joiner.pdf

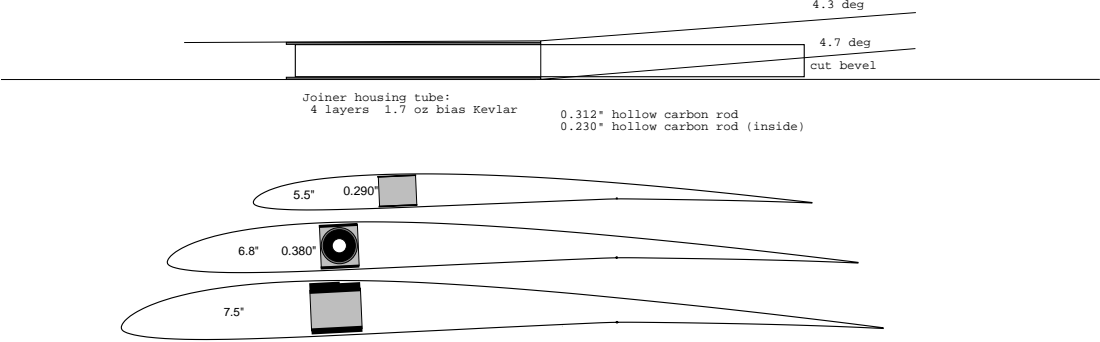
[picture p376: page 1]
4.7 deg; 4.3 deg; cut bevel

Joiner housing tube:
4 layers 1.7 oz bias Kevlar

0.312" hollow carbon rod
0.230" hollow carbon rod (inside)
