duanebeck/Allegro-Lite/Aegea/tail.pdf

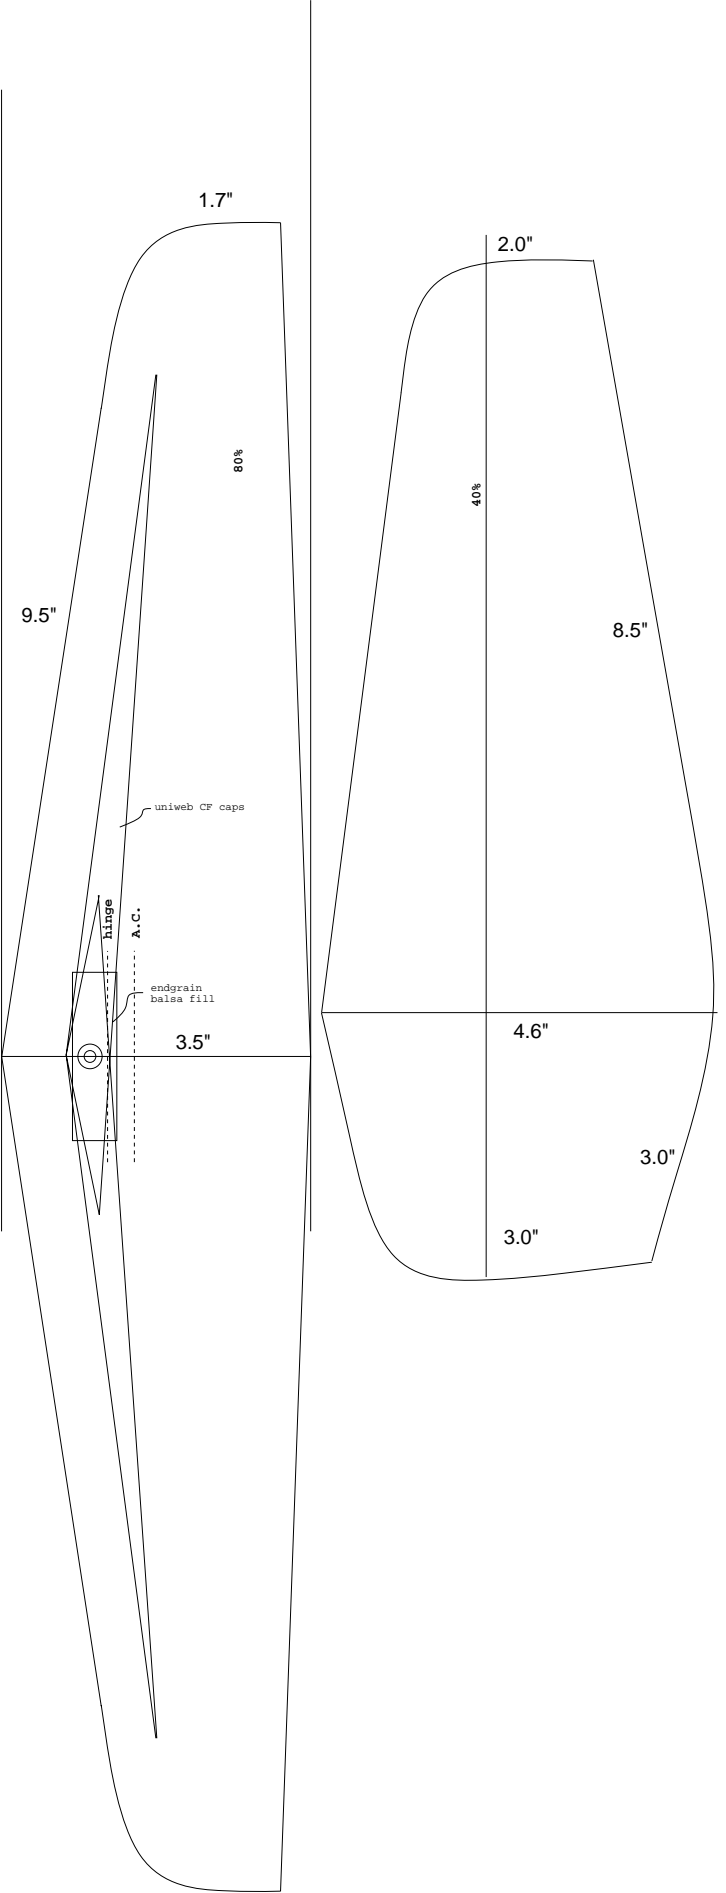
[picture p377: page 1]
hinge; endgrain balsa fill

uniweb CF caps
