duanebeck/Allegro-Lite/Bubble Dancer/bd_V3.pdf

# Bubble Dancer RES 1:12 scale

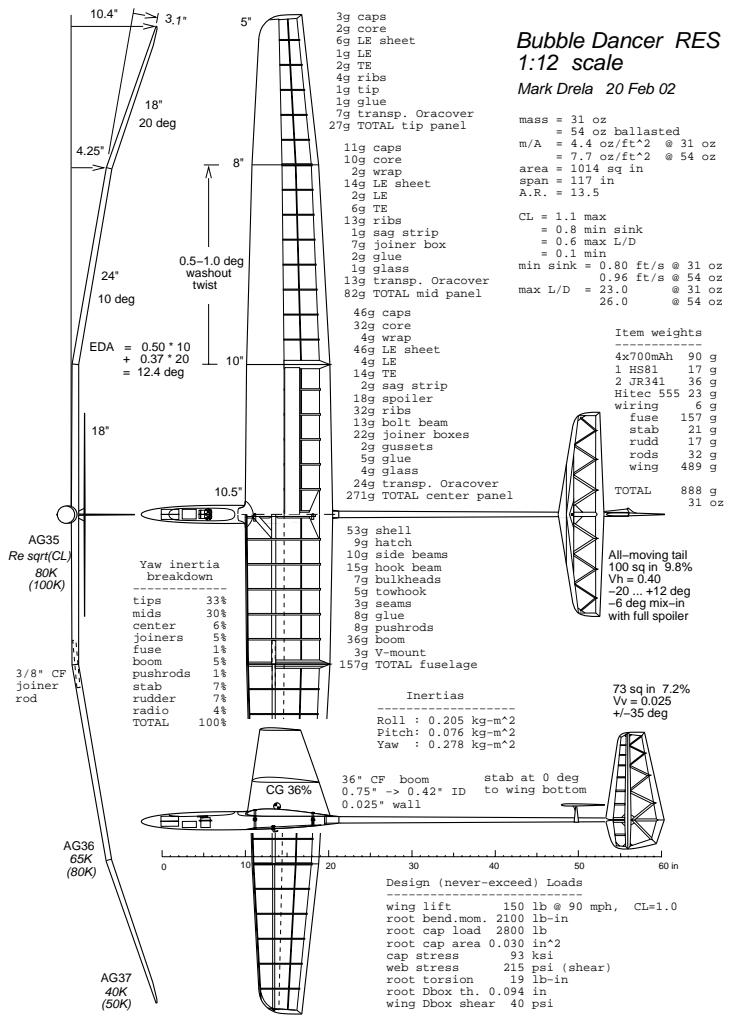
[picture p378: page 1]
10 deg; 20 deg; EDA = 0.50 * 10 + 0.37 * 20 = 12.4 deg; Re sqrt(CL); max L/D = 23.0; 36" CF boom 0.75" −> 0.42" ID 0.025" wall; 3g caps 2g core 6g LE sheet 1g LE 2g TE 4g ribs 1g tip 1g glue 7g transp. Oracover; 27g TOTAL tip panel; mass = 31 oz; 11g caps 10g core 2g wrap 14g LE sheet 2g LE 6g TE 13g ribs 1g sag strip 7g joiner box 2g glue 1g glass 13g transp. Oracover 82g TOTAL mid panel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

Mark Drela 20 Feb 02

= 54 oz ballasted
area = 1014 sq in
span = 117 in

CL = 1.1 max
= 0.8 min sink
= 0.6 max L/D
= 0.1 min
min sink = 0.80 ft/s @ 31 oz

All−moving tail
−20 ... +12 deg
−6 deg mix−in
with full spoiler

stab at 0 deg
to wing bottom

Design (never−exceed) Loads
root bend.mom. 2100 lb−in
root cap load 2800 lb
root cap area 0.030 in^2
root Dbox th. 0.094 in
wing Dbox shear 40 psi
