duanebeck/Allegro-Lite/Bubble Dancer/bd_vmount.pdf

### 3−part platform/horn mold (cartoon, not to scale)

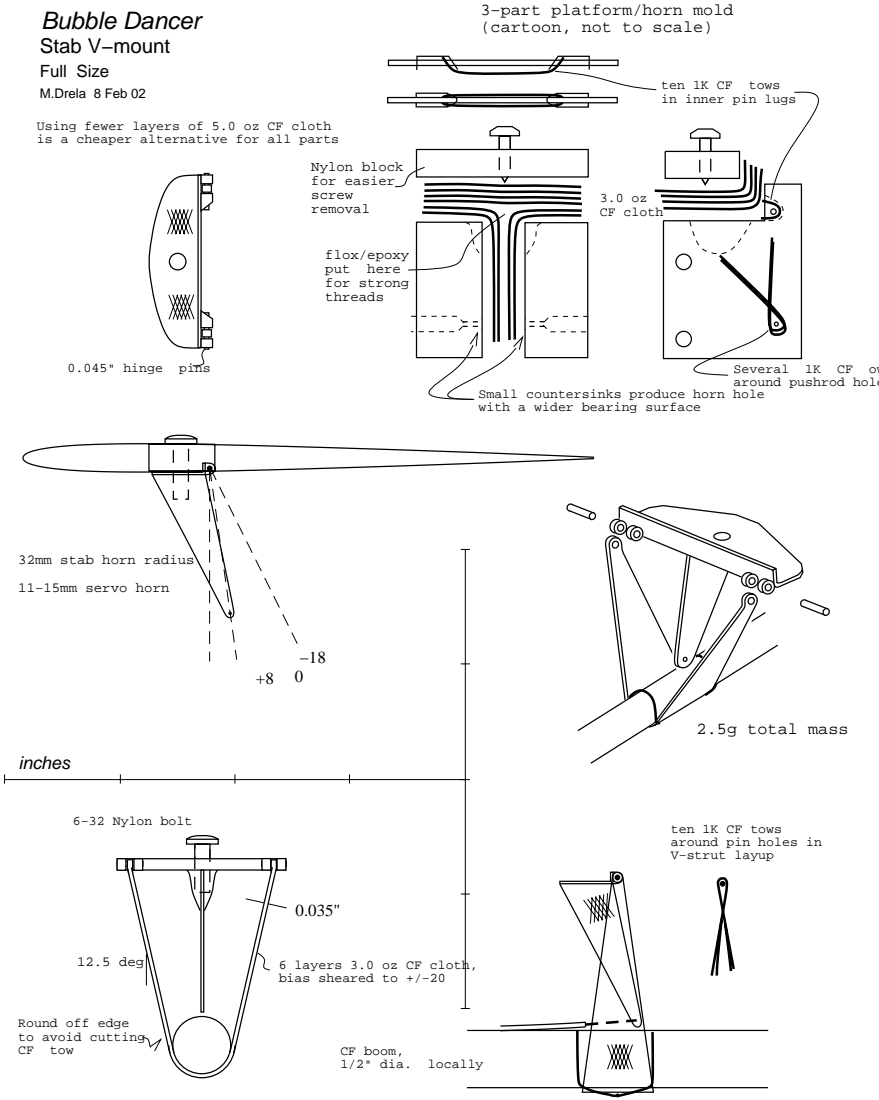
[picture p379: page 1]
Stab V−mount; 3.0 oz CF cloth; 12.5 deg; Bubble Dancer; CF boom, 1/2" dia. locally; 6−32 Nylon bolt; 2.5g total mass; M.Drela 8 Feb 02; flox/epoxy put here for strong threads; Nylon block for easier screw removal; Full Size; 0.045" hinge pins; 11−15mm servo horn; inches

ten 1K CF tows
in inner pin lugs

Using fewer layers of 5.0 oz CF cloth
is a cheaper alternative for all parts

Several 1K CF ow

around pushrod hole Small countersinks produce horn hole
with a wider bearing surface

32mm stab horn radius

around pin holes in
V−strut layup

6 layers 3.0 oz CF cloth,
bias sheared to +/−20

Round off edge
to avoid cutting
CF tow
