duanebeck/Allegro-Lite/Bubble Dancer/fusepod.pdf

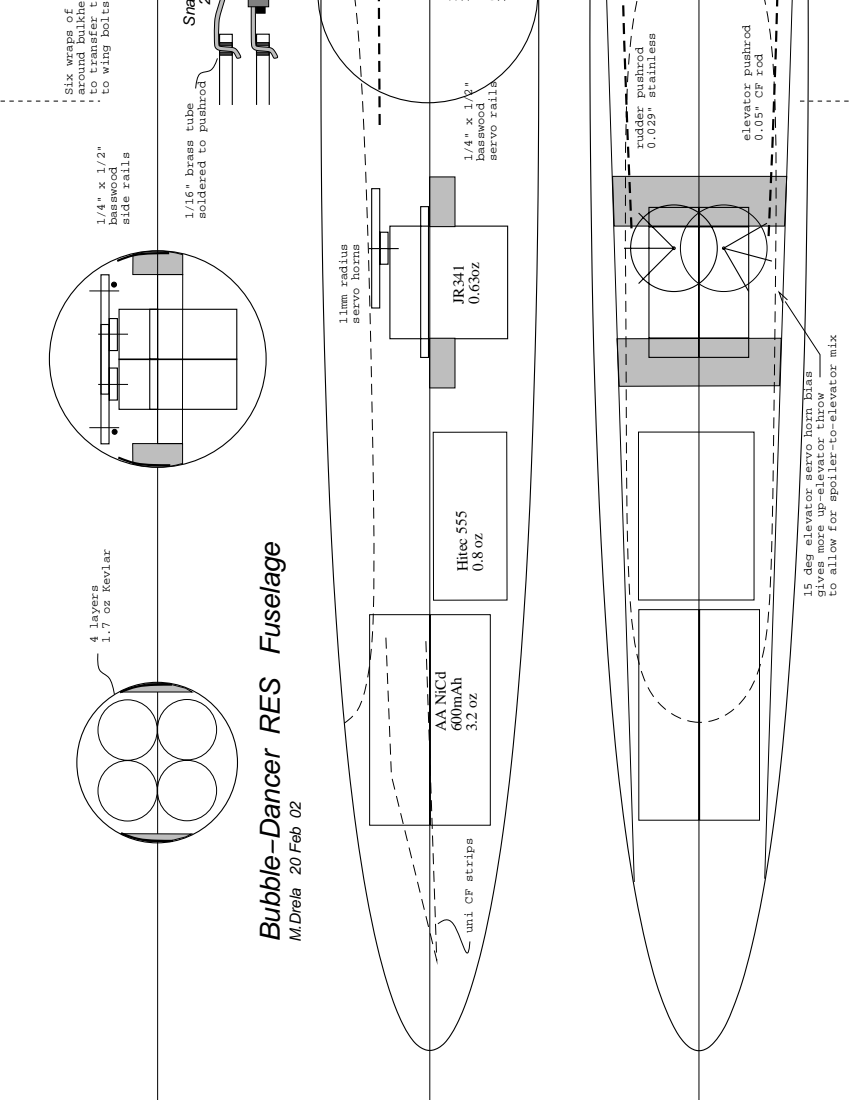
[picture p380: page 1]
Hitec 555 0.8 oz; 1/16" brass tube; Sna; AA NiCd 600mAh 3.2 oz; 4 layers; side rails; basswood; servo rails; rudder pushrod; 0.029" stainless; elevator pushrod; 0.05" CF rod; M.Drela 20 Feb 02; 11mm radius; servo horns; around bulkhe

to transfer to

to wing bolts

Six wraps of

soldered to pushrod

1.7 oz Kevlar 1/4" x 1/2" basswood

to allow for spoiler−to−elevator mix

15 deg elevator servo horn bias

gives more up−elevator throw

Bubble−Dancer RES Fuselage

uni CF strips

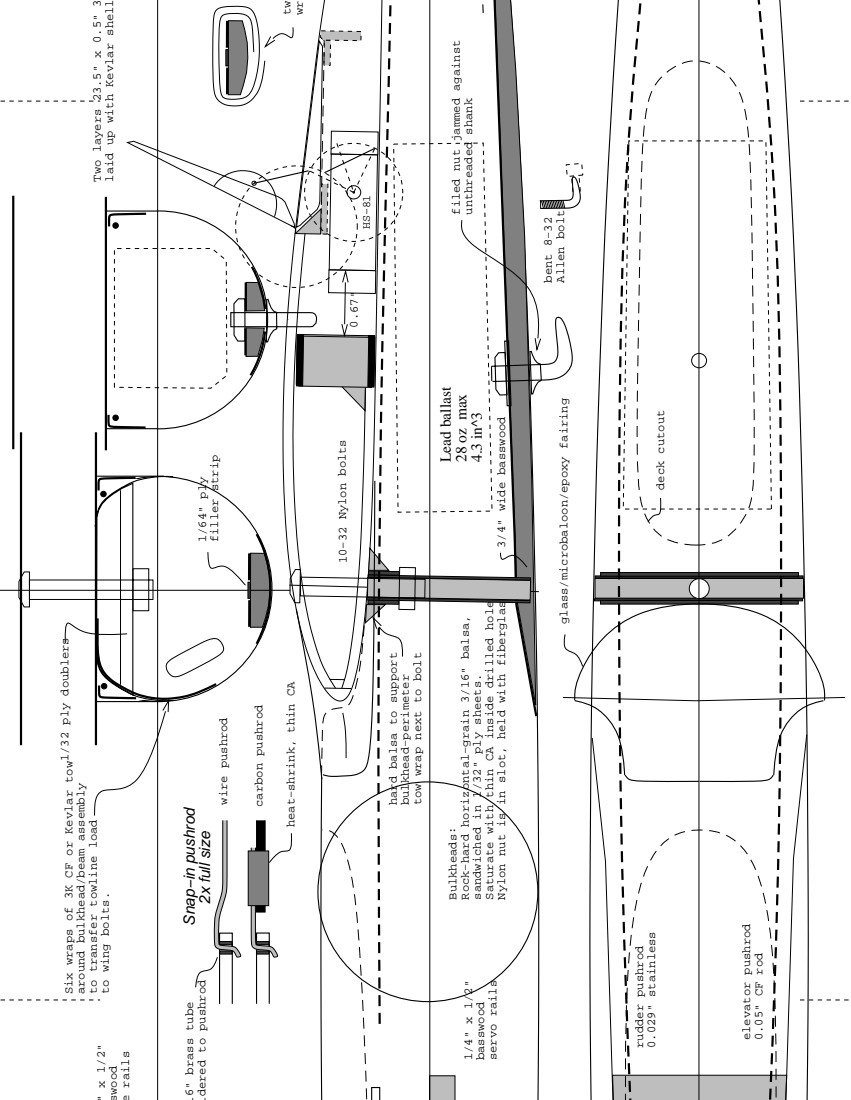
[picture p381: page 2]
wire pushrod; 16" brass tube; deck cutout; 2x full size; bent 8−32; Allen bolt; 10−32 Nylon bolts; Lead ballast 28 oz max 4.3 in^3; swood; e rails; 3/4" wide basswood; basswood; servo rails; Bulkheads:; rudder pushrod; 0.029" stainless; elevator pushrod; 0.05" CF rod; carbon pushrod; bulkhead−perimeter; Two layers 23.5" x 0.5" 3; 1/64" ply; filler strip; unthreaded shank

laid up with Kevlar shell

filed nut jammed against

glass/microbaloon/epoxy fairing

Saturate with thin CA inside drilled hole.

Nylon nut is in slot, held with fiberglass.

Rock−hard horizontal−grain 3/16" balsa,

1/32 ply doublers Six wraps of 3K CF or Kevlar tow

hard balsa to support

tow wrap next to bolt

heat−shrink, thin CA

sandwiched in 1/32" ply sheets.

around bulkhead/beam assembly

Snap−in pushrod

to transfer towline load

to wing bolts.

ldered to pushrod

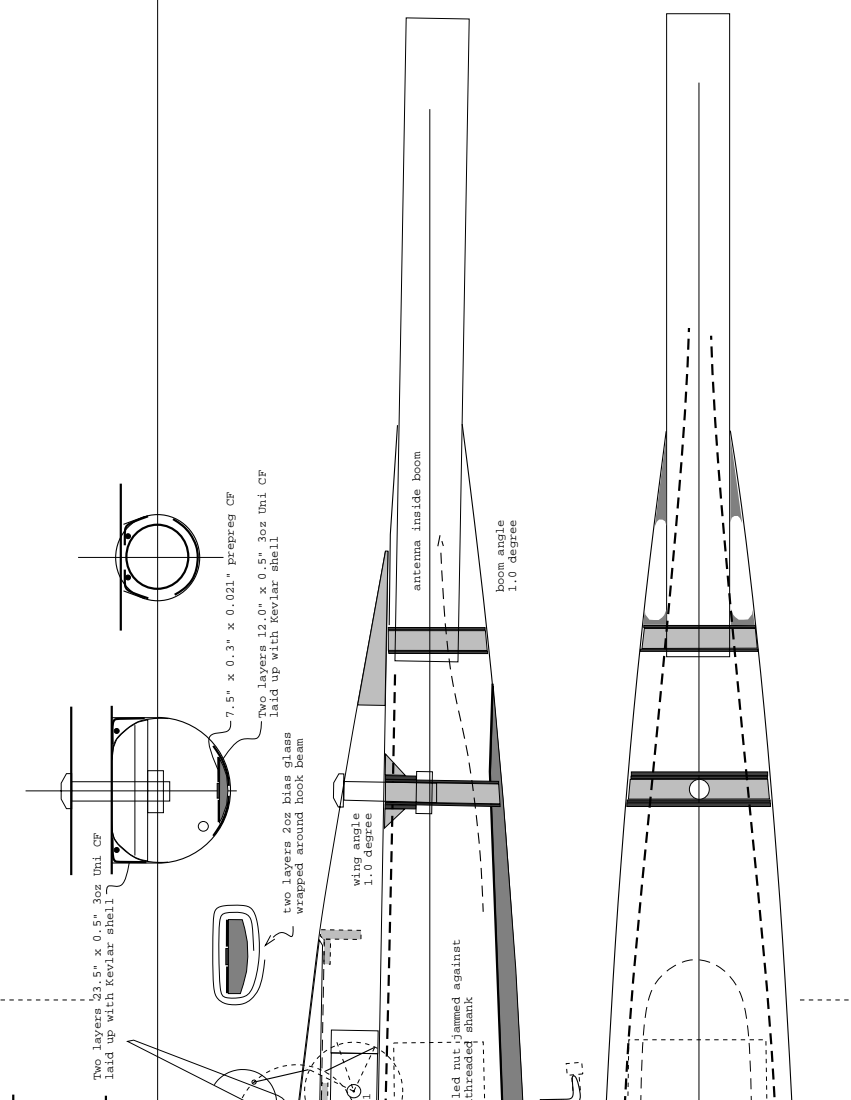
[picture p382: page 3]
boom angle; 1.0 degree; wing angle; 7.5" x 0.3" x 0.021" prepreg CF; threaded shank

antenna inside boom

Two layers 12.0" x 0.5" 3oz Uni CF

laid up with Kevlar shell

two layers 2oz bias glass

wrapped around hook beam

Two layers 23.5" x 0.5" 3oz Uni CF

led nut jammed against
