duanebeck/Allegro-Lite/Bubble Dancer/joiner_V2.pdf

# Bubble Dancer

## Wing Joiner

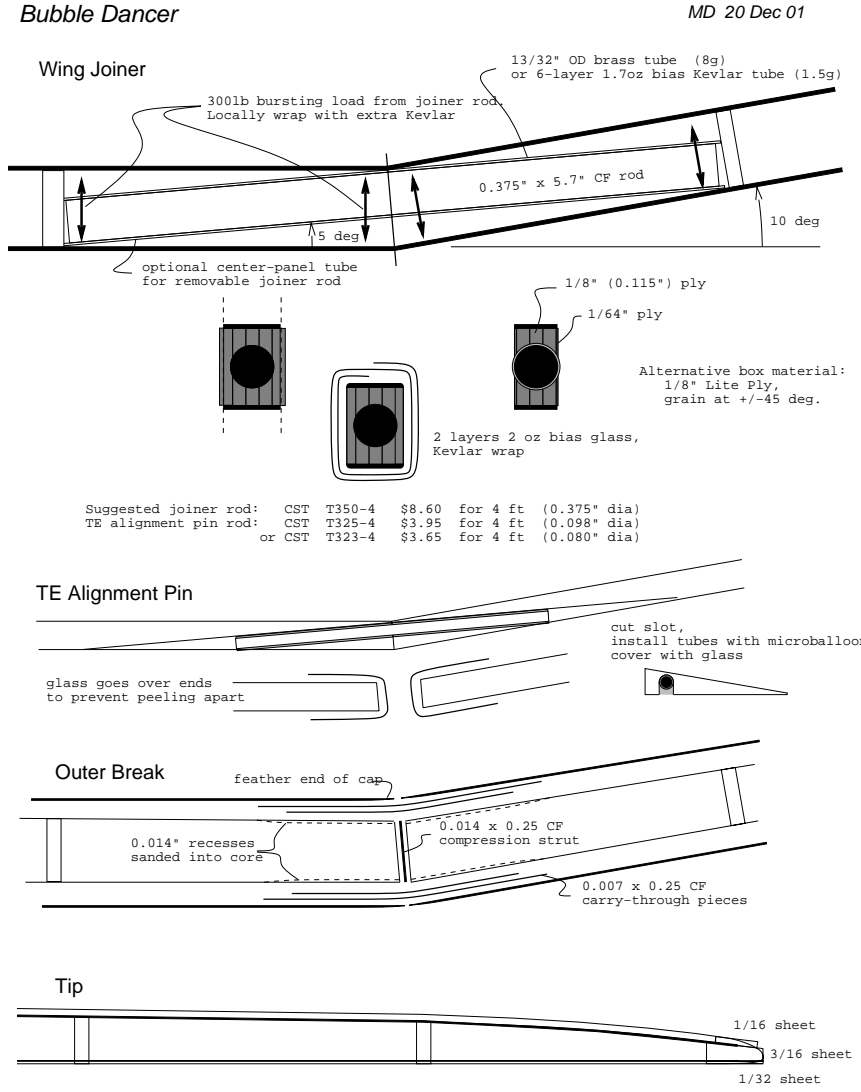
[picture p383: page 1]
10 deg; 5 deg; 1/64" ply; 1/8" (0.115") ply; Outer Break; 0.014 x 0.25 CF compression strut; 1/16 sheet; 3/16 sheet; Tip; 1/32 sheet; 0.375" x 5.7" CF rod; MD 20 Dec 01; Suggested joiner rod:; CST T350−4; $8.60 for 4 ft (0.375" dia); TE alignment pin rod:; CST T325−4; $3.95 for 4 ft (0.098" dia); or CST T323−4; $3.65 for 4 ft (0.080" dia)

13/32" OD brass tube (8g)
or 6−layer 1.7oz bias Kevlar tube (1.5g)

300lb bursting load from joiner rod.
Locally wrap with extra Kevlar

optional center−panel tube
for removable joiner rod

Alternative box material:
1/8" Lite Ply,
grain at +/−45 deg.

2 layers 2 oz bias glass,
Kevlar wrap

TE Alignment Pin

cut slot,
install tubes with microballoon cover with glass

glass goes over ends
to prevent peeling apart

feather end of cap

0.014" recesses
sanded into core

carry−through pieces
