duanebeck/Allegro-Lite/Bubble Dancer/spar_V2.pdf

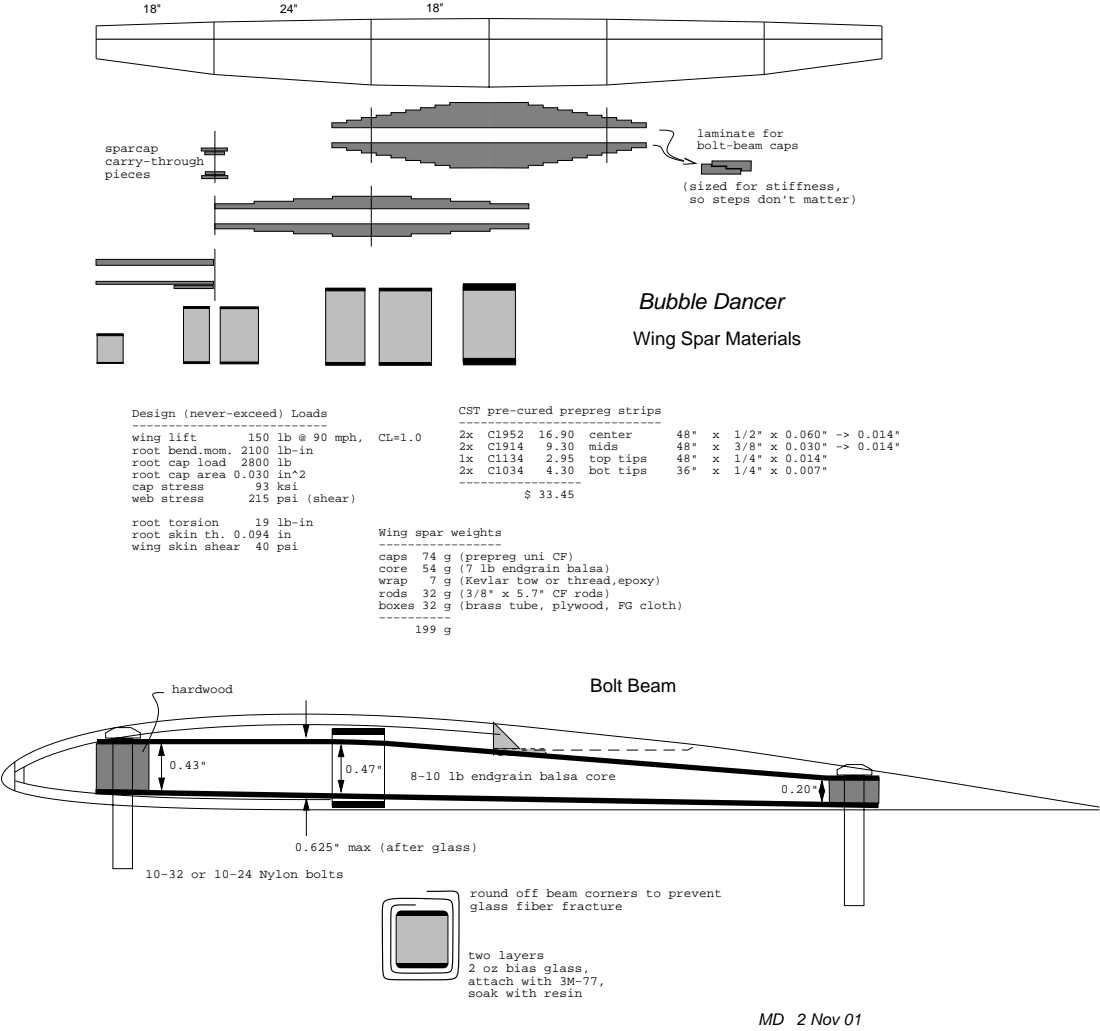
[picture p384: page 1]
wing lift; 150 lb @ 90 mph, CL=1.0; cap stress; 93 ksi; web stress; 215 psi (shear); root torsion; Bolt Beam; MD 2 Nov 01; 2x C1952 16.90 center; 9.30 mids; 2.95 top tips; 4.30 bot tips; sparcap carry−through pieces; hardwood; wrap; 7 g (Kevlar tow or thread,epoxy)

laminate for
bolt−beam caps

(sized for stiffness,
so steps don’t matter)

Bubble Dancer
Wing Spar Materials

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

CST pre−cured prepreg strips

root skin th. 0.094 in
wing skin shear 40 psi

Wing spar weights
caps 74 g (prepreg uni CF)
core 54 g (7 lb endgrain balsa)
rods 32 g (3/8" x 5.7" CF rods)
boxes 32 g (brass tube, plywood, FG cloth)

8−10 lb endgrain balsa core

0.625" max (after glass)

10−32 or 10−24 Nylon bolts

round off beam corners to prevent
glass fiber fracture

two layers
2 oz bias glass,
attach with 3M−77,
soak with resin
