duanebeck/Allegro-Lite/Bubble Dancer/wing_plan_V2b.pdf

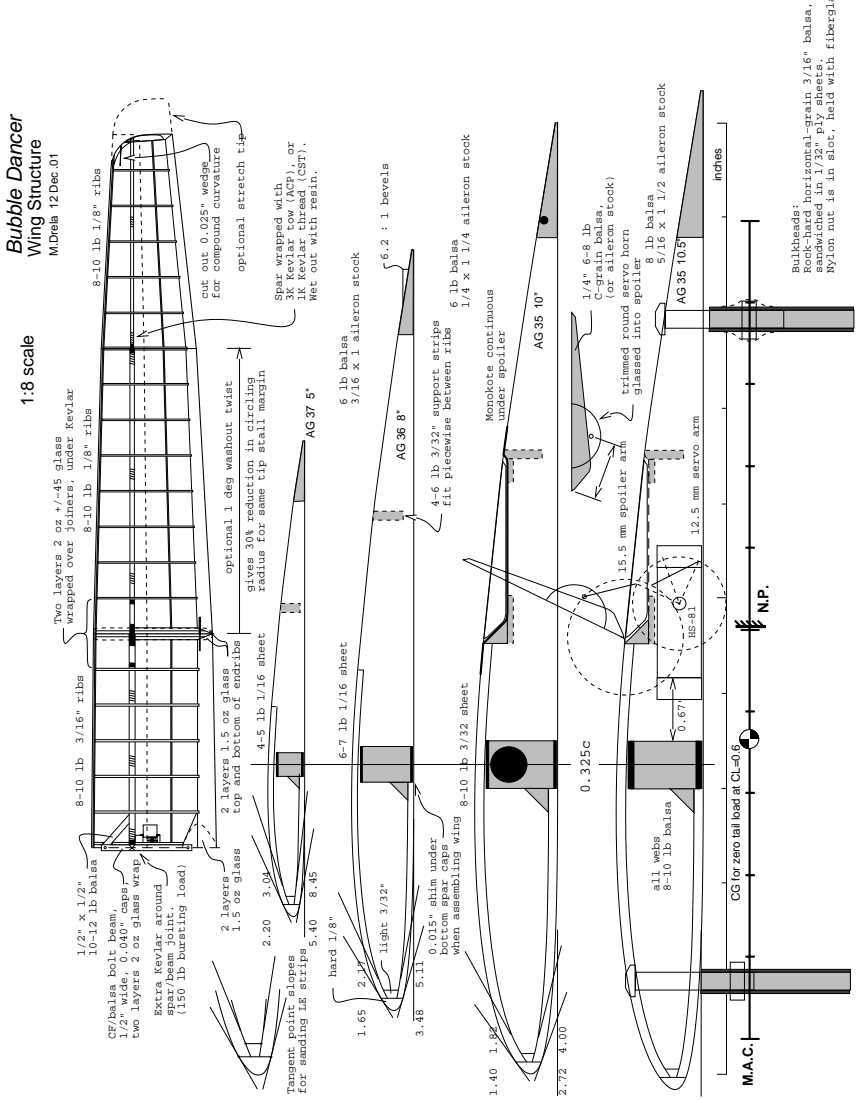
[picture p387: page 1]
1:8 scale; 4−5 lb 1/16 sheet; hard 1/8"; 8−10 lb 1/8" ribs; Bubble Dancer Wing Structure; Bulkheads:; 8 lb balsa; 5/16 x 1 1/2 aileron stock; 8−10 lb 3/32 sheet; 6−7 lb 1/16 sheet; 8−10 lb 3/16" ribs; 6 lb balsa; 1/4 x 1 1/4 aileron stock; 3/16 x 1 aileron stock; 2 layers; 1.5 oz glass; Monokote continuous; under spoiler; inches; M.Drela 12 Dec .01; 1/2" wide, 0.040" caps,; 0.015" shim under; 6.2 : 1 bevels; 10−12 lb balsa; light 3/32"; C−grain balsa,; all webs; 8−10 lb balsa

Rock−hard horizontal−grain 3/16" balsa,

Nylon nut is in slot, held with fibergla

sandwiched in 1/32" ply sheets.

optional stretch tip

3K Kevlar tow (ACP), or

1K Kevlar thread (CST).

for compound curvature

cut out 0.025" wedge

Wet out with resin.

Spar wrapped with

(or aileron stock)

trimmed round servo horn

glassed into spoiler

4−6 lb 3/32" support strips

fit piecewise between ribs

radius for same tip stall margin

optional 1 deg washout twist

gives 30% reduction in circling

wrapped over joiners, under Kevlar

for sanding LE strips AG 37 5"

12.5 mm servo arm

Two layers 2 oz +/−45 glass

15.5 mm spoiler arm

top and bottom of endribs

2 layers 1.5 oz glass

CG for zero tail load at CL=0.6

when assembling wing

bottom spar caps

two layers 2 oz glass wrap

(150 lb bursting load)

Extra Kevlar around

CF/balsa bolt beam,

spar/beam joint.

Tangent point slopes
