duanebeck/Allegro-Lite/Carbon BD Fuselage/BD Fuselage Plan.pdf

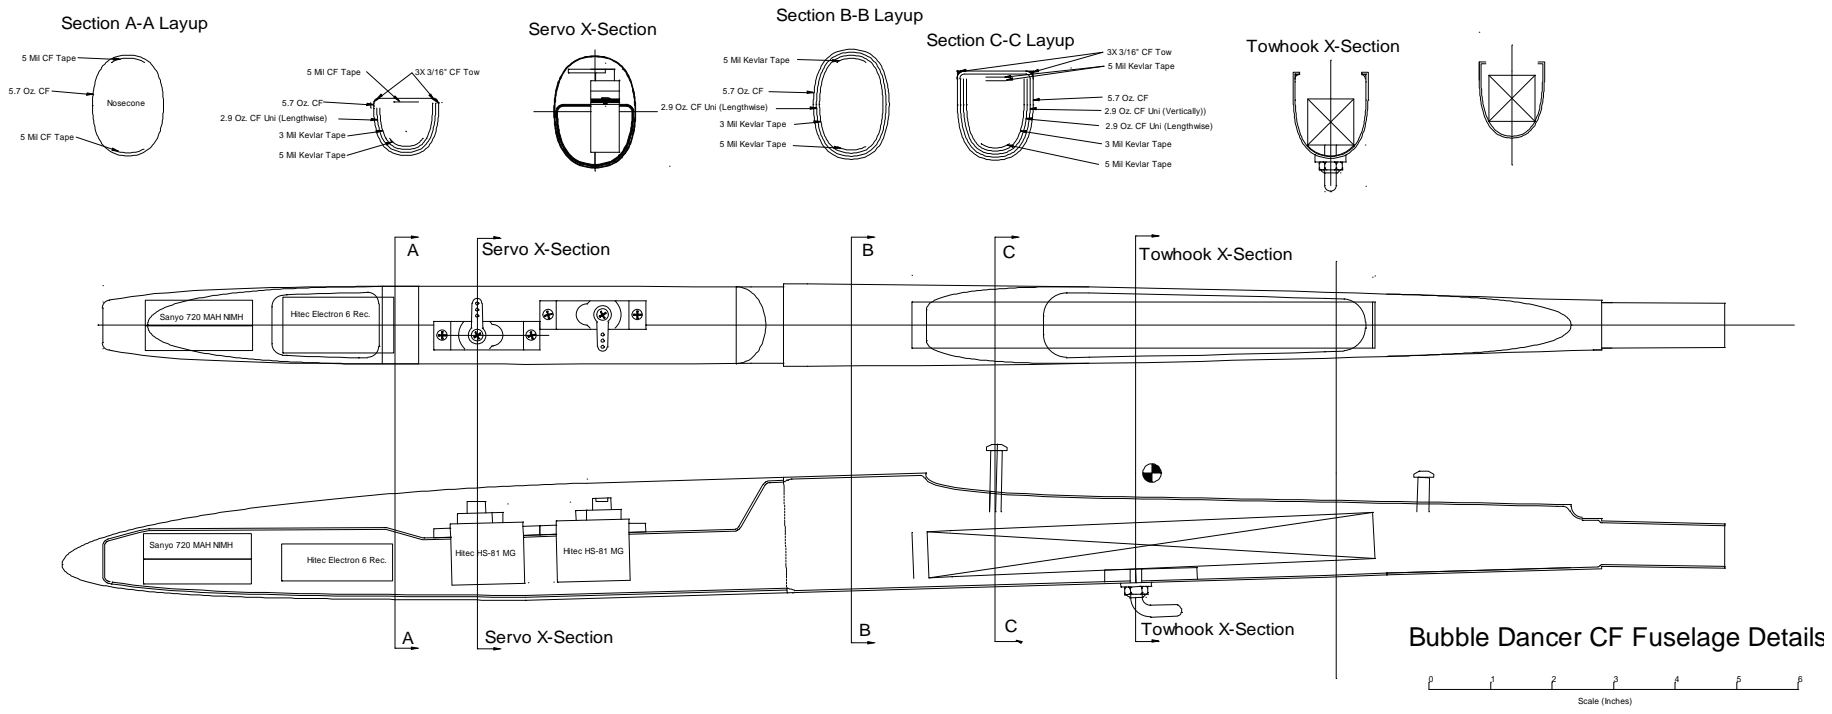
[picture p388: page 1]
Hitec HS-81 MG; 5 Mil CF Tape; 3X 3/16" CF Tow; Section A-A Layup; Nosecone; Section B-B Layup; Section C-C Layup; Sanyo 720 MAH NIMH; Hitec Electron 6 Rec.; Servo X-Section; Towhook X-Section; Scale (Inches)

5 Mil CF Tape

5 Mil Kevlar Tape

3X 3/16" CF Tow

2.9 Oz. CF Uni (Vertically))
2.9 Oz. CF Uni (Lengthwise)
3 Mil Kevlar Tape

Sanyo 720 MAH NIMH

Hitec Electron 6 Rec.

Bubble Dancer CF Fuselage Details
