duanebeck/Allegro-Lite/RDS/rds_equation.pdf

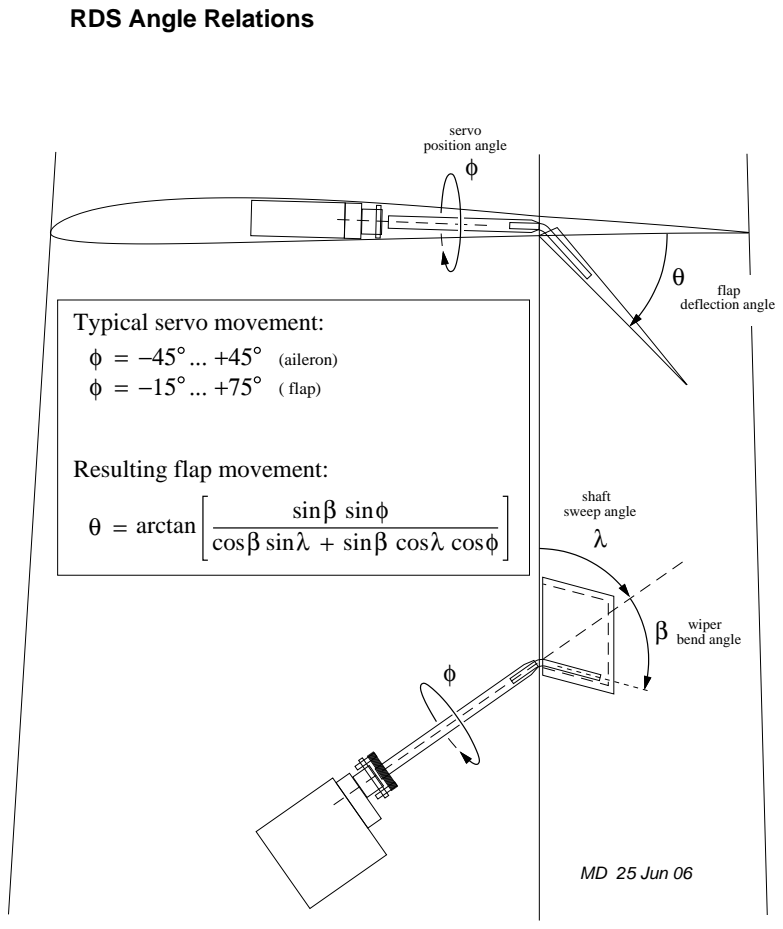
[picture p389: page 1]
shaft sweep angle; servo position angle; flap deflection angle; wiper bend angle; sinβ; sinφ; cosβ sin; sin λ; β cosλ cos; Typical servo movement:; (aileron); ( flap); MD 25 Jun 06

RDS Angle Relations

Resulting flap movement:
arctan
