duanebeck/Allegro-Lite/RDS/rdsa.pdf

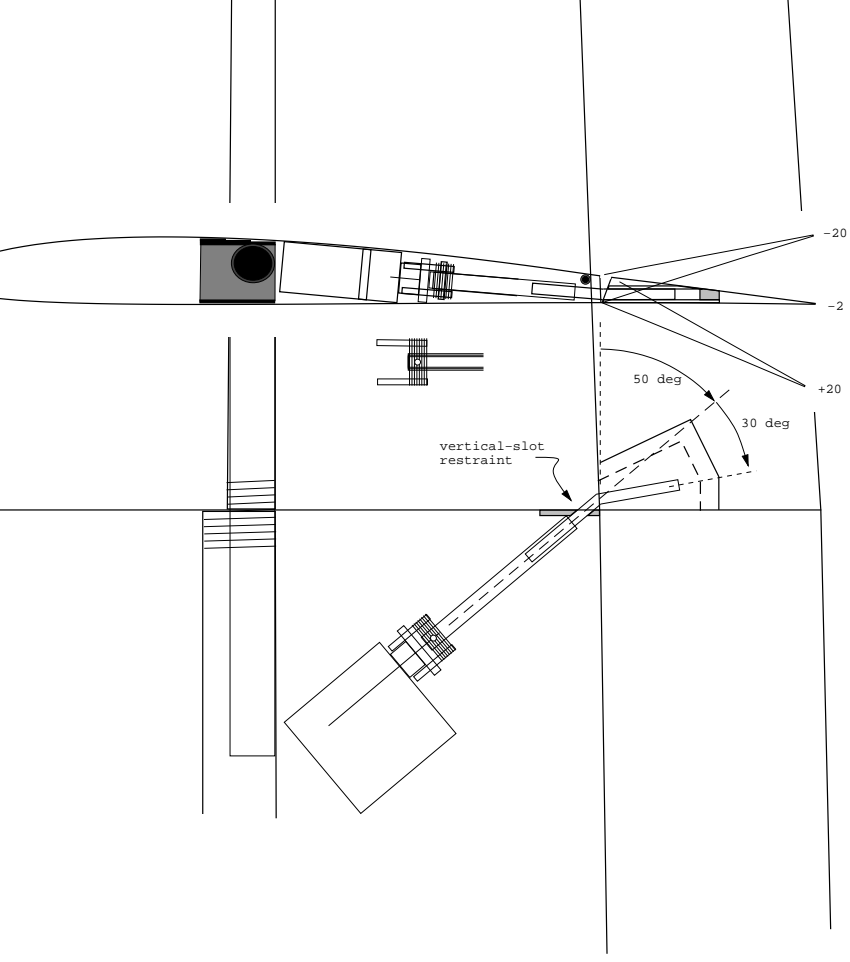
[picture p390: page 1]
50 deg; 30 deg; vertical−slot restraint
