duanebeck/Allegro-Lite/RDS/rdsf.pdf

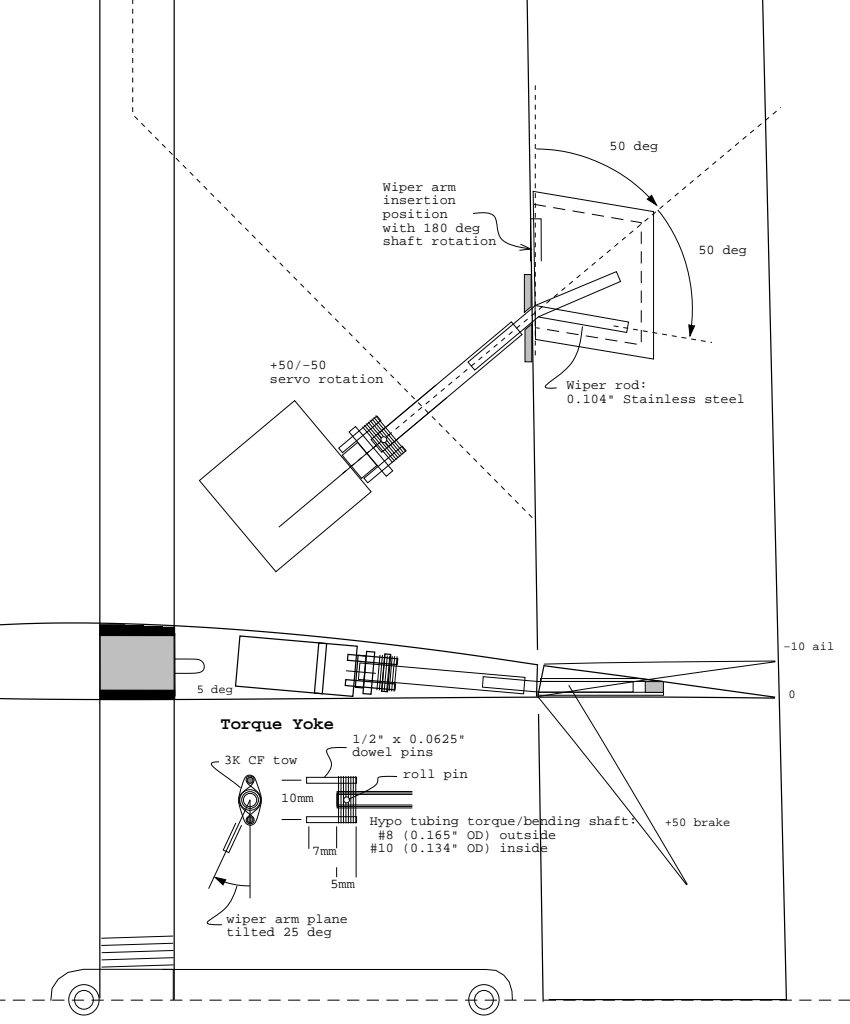
[picture p391: page 1]
50 deg; Wiper arm insertion position with 180 deg shaft rotation; +50/−50 servo rotation; −10 ail; +50 brake; 5 deg; Torque Yoke; 1/2" x 0.0625" dowel pins; 3K CF tow; roll pin; Wiper rod: 0.104" Stainless steel

Hypo tubing torque/bending shaft:
#8 (0.165" OD) outside
#10 (0.134" OD) inside

wiper arm plane
tilted 25 deg
