duanebeck/Allegro-Lite/RDS/rdsf2.pdf

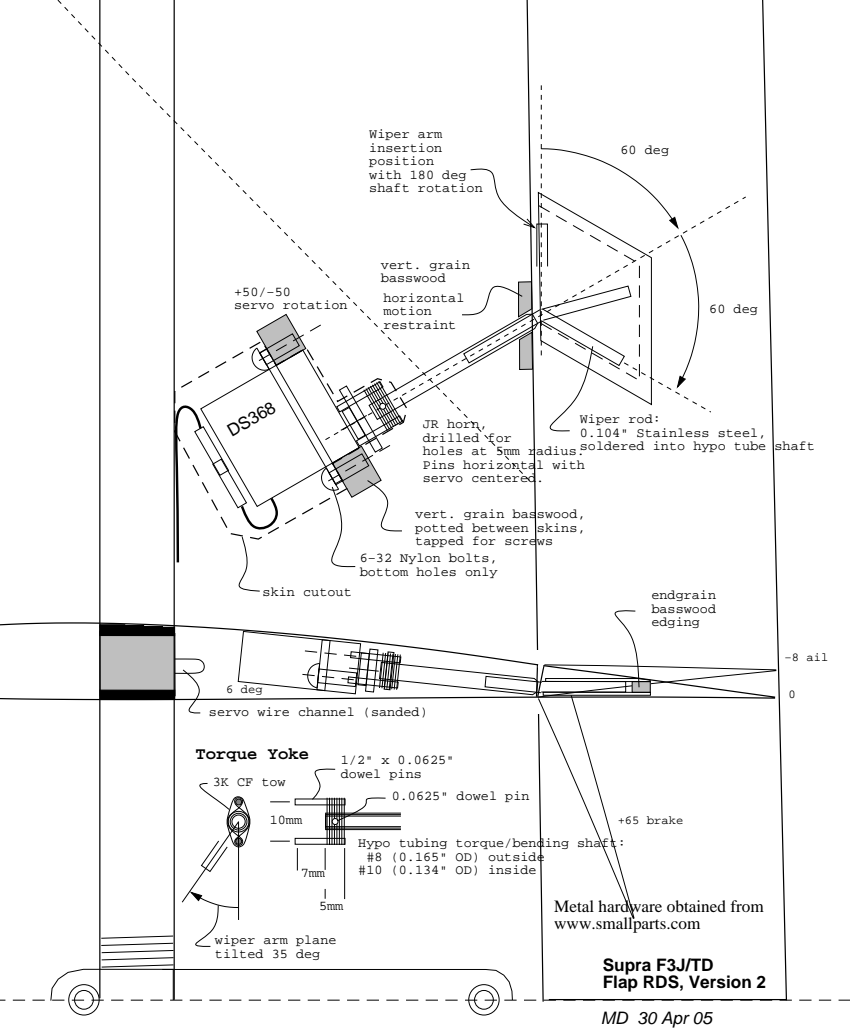
[picture p392: page 1]
Wiper arm insertion position with 180 deg shaft rotation; +50/−50 servo rotation; endgrain basswood edging; horizontal motion restraint; vert. grain basswood; skin cutout; 0.0625" dowel pin; +65 brake; 60 deg; −8 ail

Wiper rod:
0.104" Stainless steel,
soldered into hypo tube shaft

JR horn,
drilled for
holes at 5mm radius.
Pins horizontal with
servo centered.

vert. grain basswood,
potted between skins,
tapped for screws

6−32 Nylon bolts,
bottom holes only

6 deg
servo wire channel (sanded)

Torque Yoke
dowel pins 3K CF tow

Hypo tubing torque/bending shaft:
#8 (0.165" OD) outside
#10 (0.134" OD) inside

Metal hardware obtained from
www.smallparts.com

wiper arm plane
tilted 35 deg

Supra F3J/TD
Flap RDS, Version 2
MD 30 Apr 05
