duanebeck/Allegro-Lite/RDS/rdsf_plot.pdf

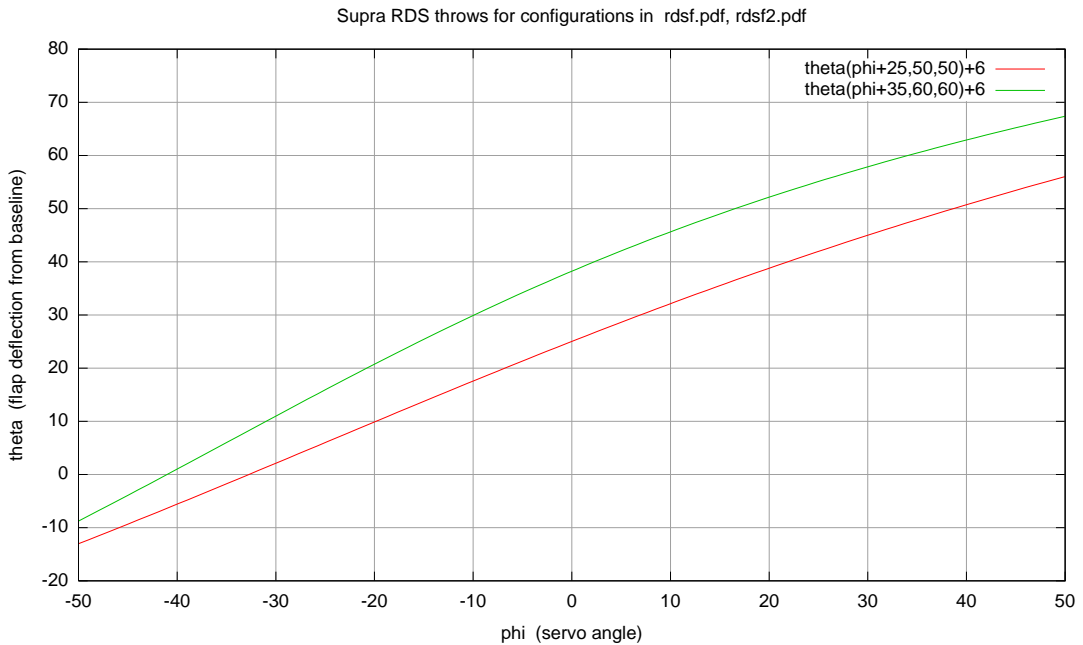
[picture p393: page 1]
50 theta ⁽flap deflection from baseline⁾; theta(phi+25,50,50)+6 theta(phi+35,60,60)+6

Supra RDS throws for configurations in rdsf.pdf, rdsf2.pdf

phi (servo angle)
