duanebeck/Allegro-Lite/SkyDancer drawings/SkyDancer airfoils.pdf

## Wing Structure 1:6

# SkyDancer

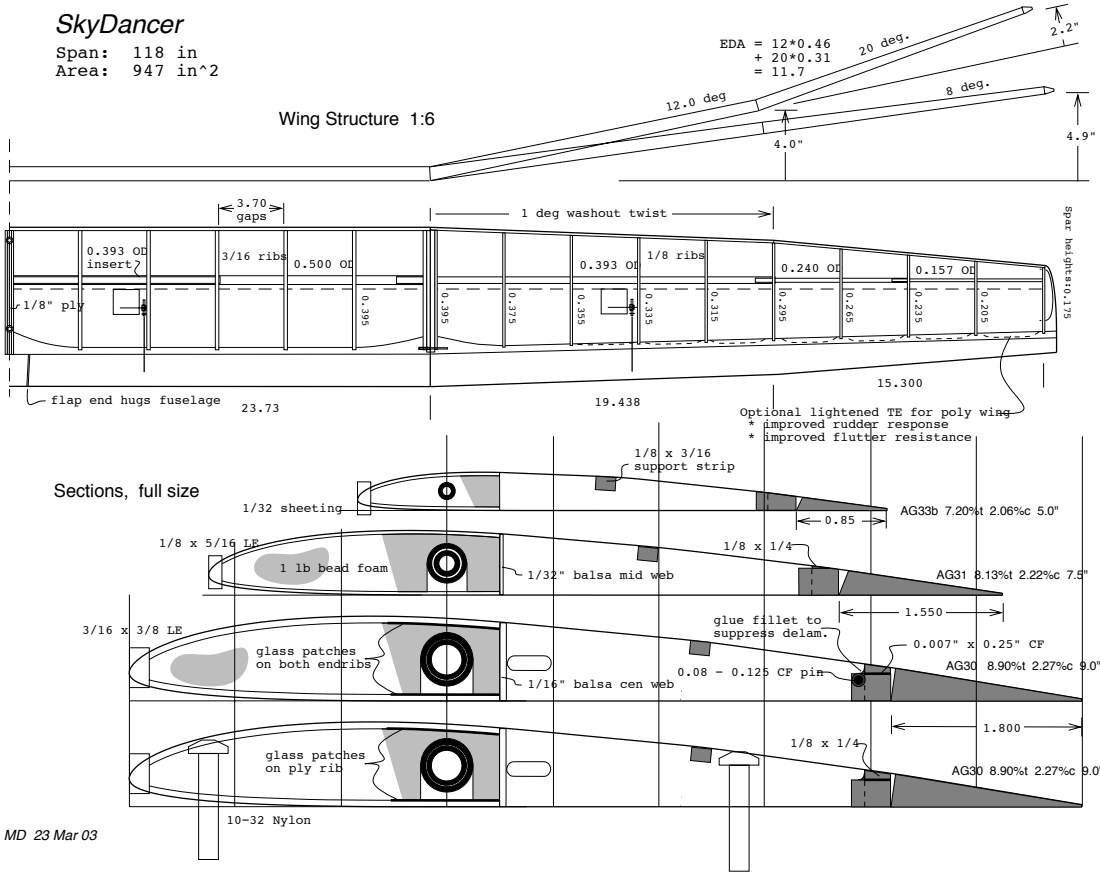
[picture p394: page 1]
1/32 sheeting; support strip; 10−32 Nylon; 20 deg.; 0.393 OD insert; EDA = 12*0.46 + 20*0.31 = 11.7; 12.0 deg; 0.175 Spar heights:; 8 deg.; 3.70 gaps; 3/16 ribs; 1/8 ribs; 1/8" ply; MD 23 Mar 03; Span: 118 in Area: 947 in^2; 0.08 − 0.125 CF pin; improved rudder response; improved flutter resistance

1 deg washout twist

flap end hugs fuselage

Optional lightened TE for poly wing

Sections, full size

AG31 8.13%t 2.22%c 7.5" 1 lb bead foam

1/32" balsa mid web

glue fillet to
suppress delam.

glass patches
on both endribs

1/16" balsa cen web

on ply rib
