duanebeck/Allegro-Lite/Supra/althorns.pdf

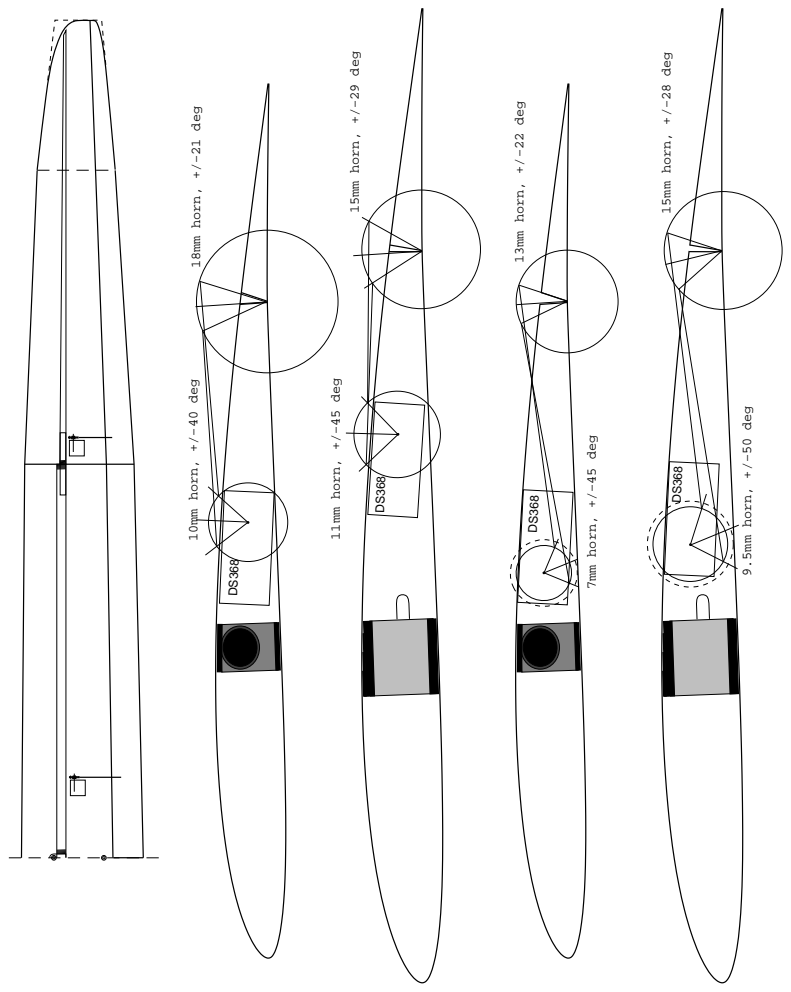
[picture p395: page 1]
15mm horn, +/−28 deg; 7mm horn, +/−45 deg; 13mm horn, +/−22 deg; 9.5mm horn, +/−50 deg; 11mm horn, +/−45 deg; 15mm horn, +/−29 deg

10mm horn, +/−40 deg 18mm horn, +/−21 deg
