duanebeck/Allegro-Lite/Supra/bends.pdf

## top sparcap

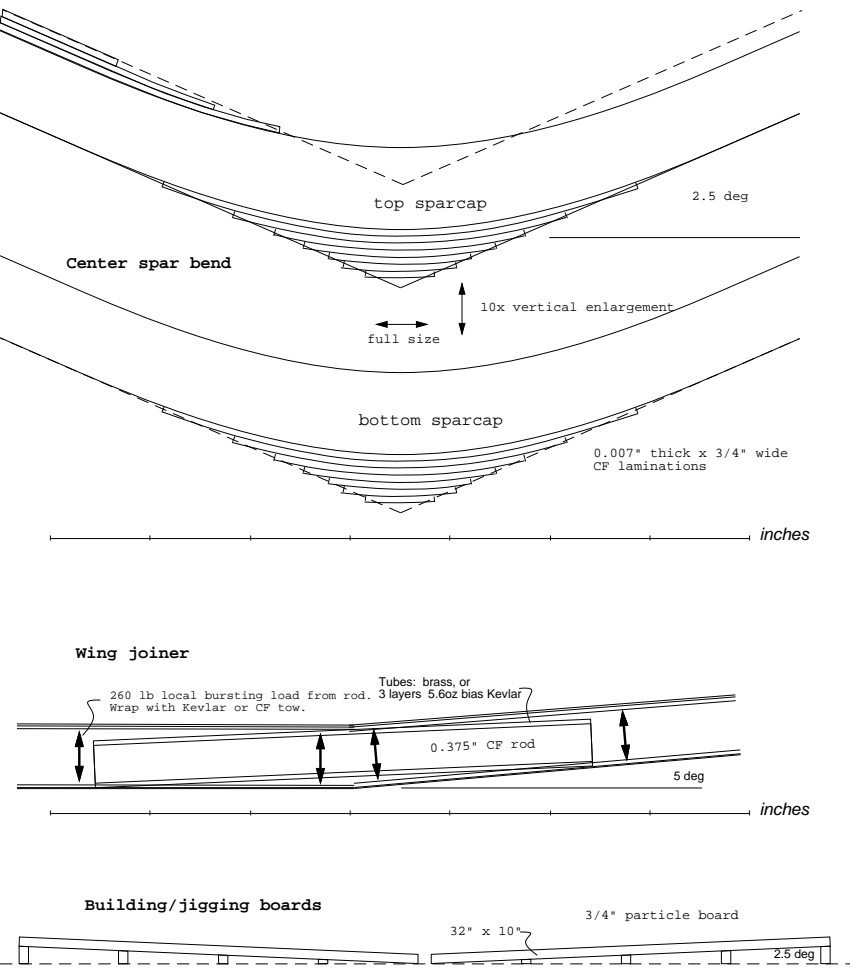
[picture p396: page 1]
5 deg; 0.007" thick x 3/4" wide CF laminations; bottom sparcap; full size; 2.5 deg; inches; Wing joiner; 0.375" CF rod; 3/4" particle board; 10x vertical enlargement

Center spar bend

Tubes: brass, or
3 layers 5.6oz bias Kevlar

260 lb local bursting load from rod.
Wrap with Kevlar or CF tow.

Building/jigging boards
