duanebeck/Allegro-Lite/Supra/hinges.pdf

## Making hinge cuts

Integral Hinges for Bagged Wings | Mark Drela

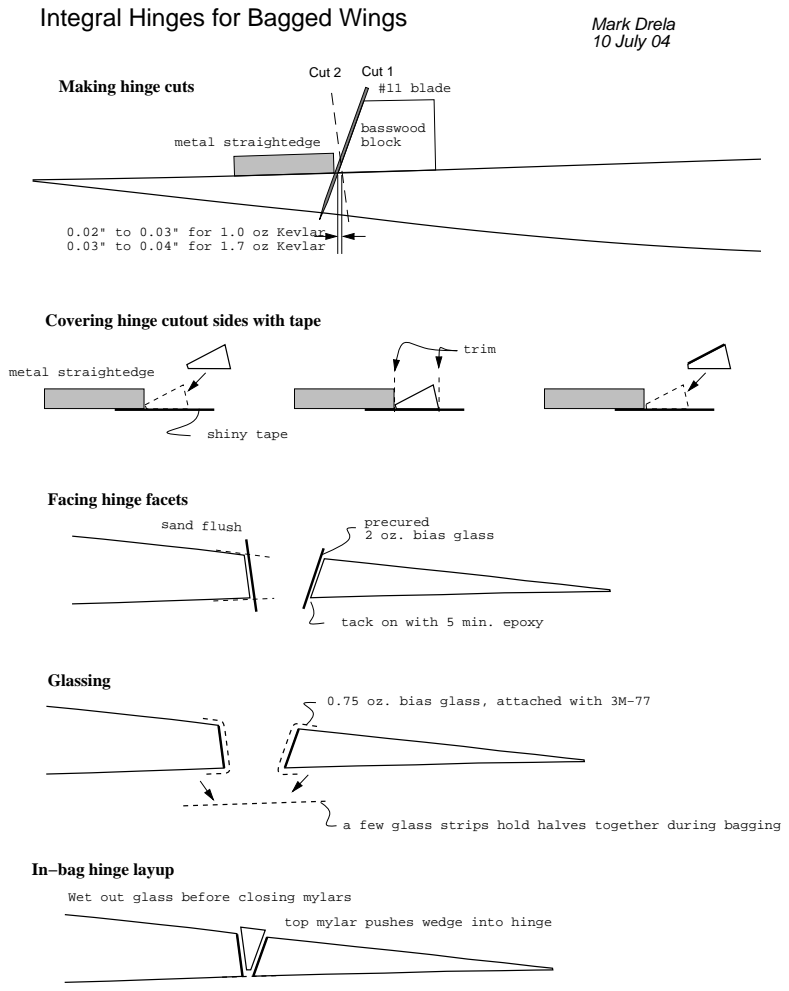
[picture p397: page 1]
basswood block; #11 blade; metal straightedge; sand flush; Cut 2; Cut 1; trim; shiny tape; Glassing; 10 July 04

0.02" to 0.03" for 1.0 oz Kevlar
0.03" to 0.04" for 1.7 oz Kevlar

Covering hinge cutout sides with tape

Facing hinge facets

precured
2 oz. bias glass

tack on with 5 min. epoxy

0.75 oz. bias glass, attached with 3M−77

a few glass strips hold halves together during bagging

In−bag hinge layup

Wet out glass before closing mylars

top mylar pushes wedge into hinge

## Cut hinge gap skin

## Peel out tape and foam

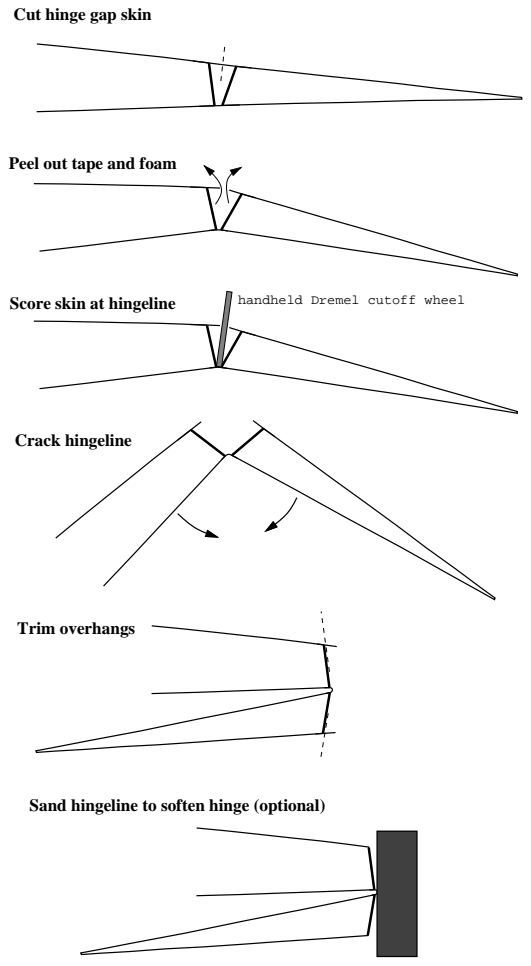
[picture p398: page 2]
Score skin at hingeline; handheld Dremel cutoff wheel; Crack hingeline; Trim overhangs

Sand hingeline to soften hinge (optional)
