duanebeck/Allegro-Lite/Supra/rdsa.pdf

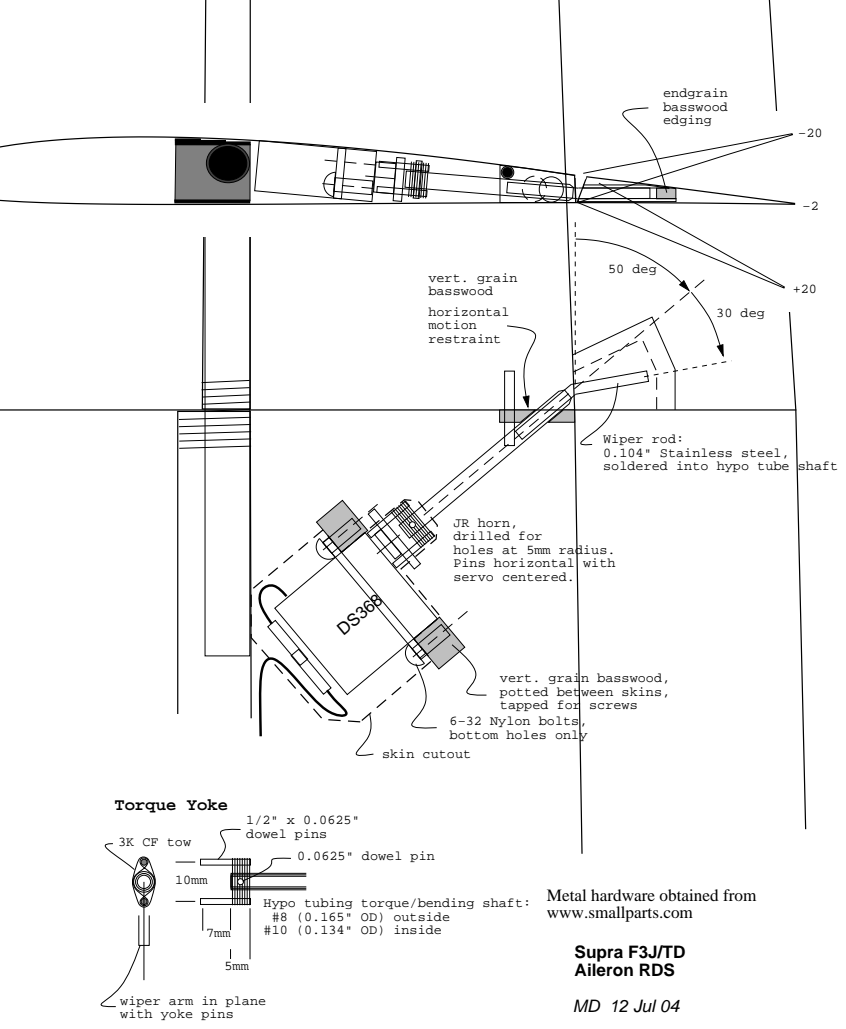
[picture p399: page 1]
skin cutout; 50 deg; 30 deg; horizontal motion restraint; vert. grain basswood; endgrain basswood edging; Torque Yoke; Supra F3J/TD Aileron RDS; 0.0625" dowel pin; MD 12 Jul 04

Wiper rod:
0.104" Stainless steel,
soldered into hypo tube shaft

JR horn,
drilled for
holes at 5mm radius.
Pins horizontal with
servo centered.

vert. grain basswood,
potted between skins,
tapped for screws

6−32 Nylon bolts,
bottom holes only

dowel pins 3K CF tow

Metal hardware obtained from
www.smallparts.com

Hypo tubing torque/bending shaft:
#8 (0.165" OD) outside
#10 (0.134" OD) inside

wiper arm in plane
with yoke pins
