duanebeck/Allegro-Lite/Supra/rdsf.pdf

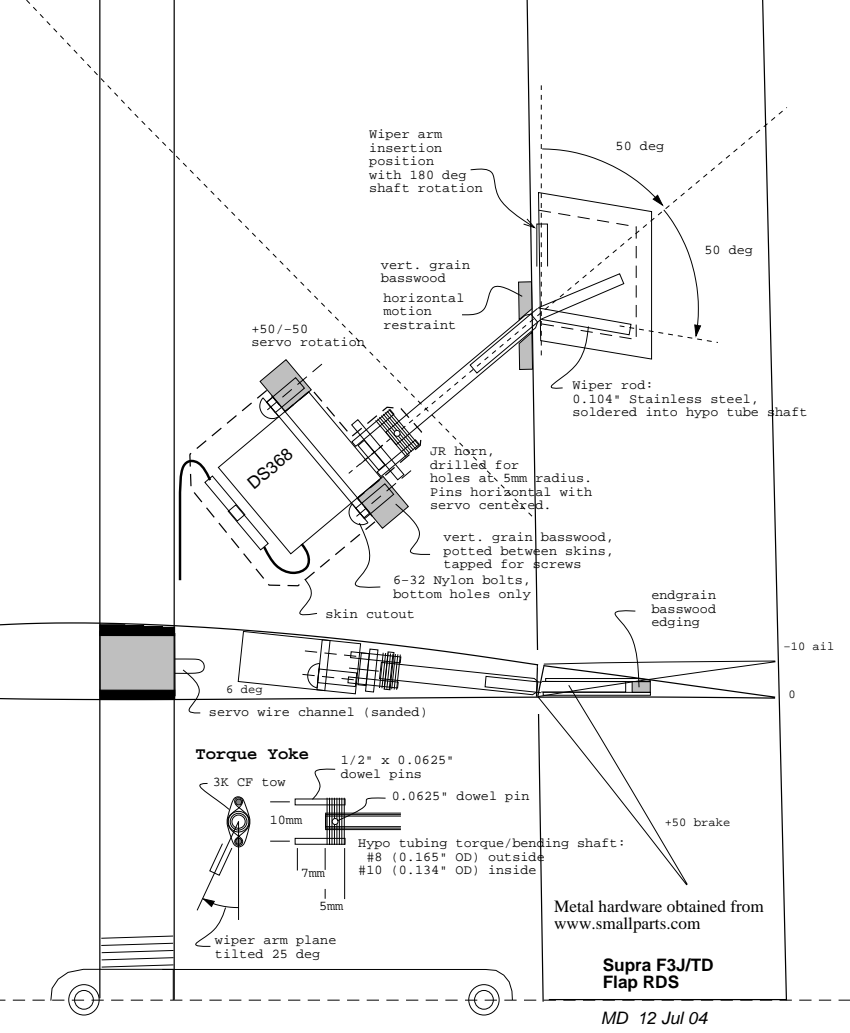
[picture p400: page 1]
50 deg; Wiper arm insertion position with 180 deg shaft rotation; +50/−50 servo rotation; −10 ail; +50 brake; endgrain basswood edging; horizontal motion restraint; vert. grain basswood; Supra F3J/TD Flap RDS; skin cutout; Torque Yoke; 1/2" x 0.0625" dowel pins; 3K CF tow; 0.0625" dowel pin; MD 12 Jul 04

Wiper rod:
0.104" Stainless steel,
soldered into hypo tube shaft

JR horn,
drilled for
holes at 5mm radius.
Pins horizontal with
servo centered.

vert. grain basswood,
potted between skins,
tapped for screws

6−32 Nylon bolts,
bottom holes only

6 deg
servo wire channel (sanded)

Hypo tubing torque/bending shaft:
#8 (0.165" OD) outside
#10 (0.134" OD) inside

Metal hardware obtained from
www.smallparts.com

wiper arm plane
tilted 25 deg
