duanebeck/Allegro-Lite/Supra/supra_3view.pdf

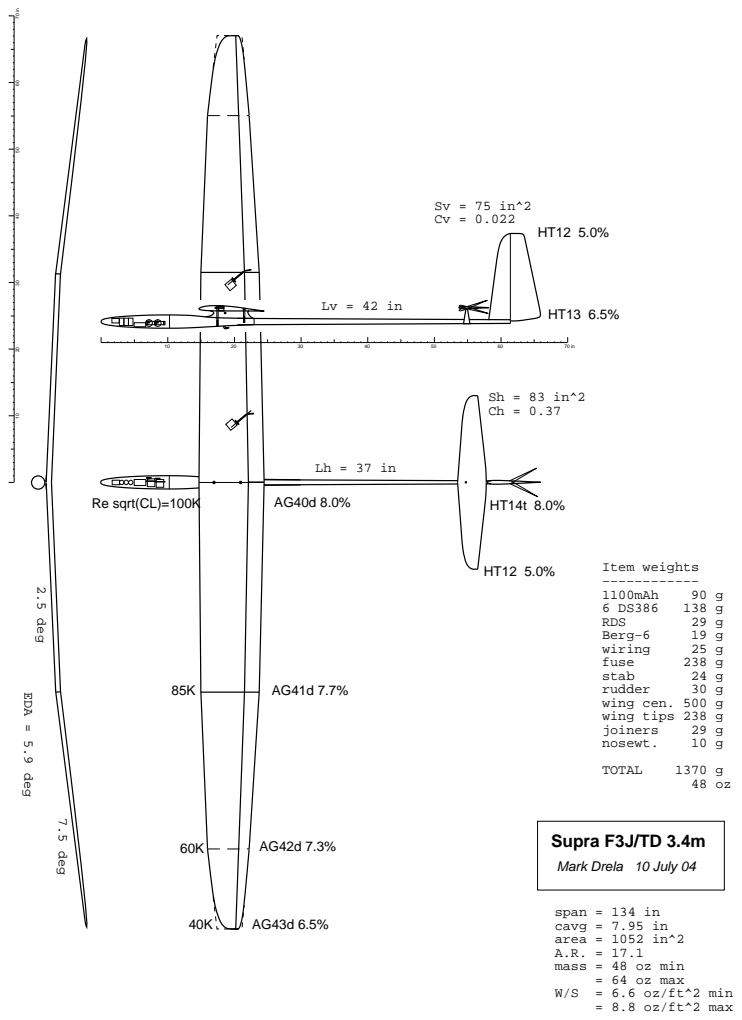
[picture p401: page 1]
2.5 deg; 7.5 deg; EDA = 5.9 deg; Item weights −−−−−−−−−−−−; 1100mAh; RDS; Berg−6; wiring; fuse; stab; rudder; wing cen. 500 g wing tips 238 g; joiners; nosewt.; TOTAL

Re sqrt(CL)=100K

Supra F3J/TD 3.4m
Mark Drela 10 July 04

span = 134 in
cavg = 7.95 in
area = 1052 in^2
mass = 48 oz min
= 64 oz max
W/S = 6.6 oz/ft^2 min
= 8.8 oz/ft^2 max
