duanebeck/Allegro-Lite/Supra/supra_f3jfuse.pdf

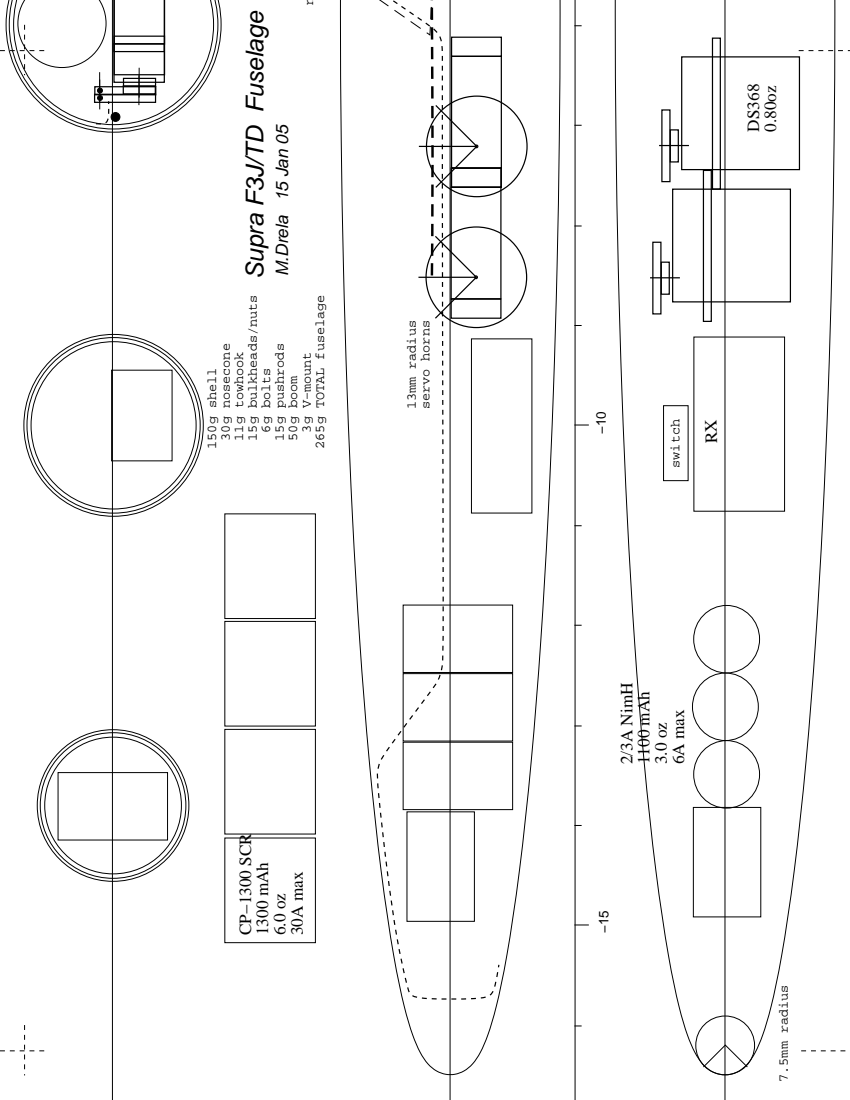
[picture p402: page 1]
13mm radius; servo horns; 7.5mm radius; 2/3A NimH 1100 mAh; 6A max; nosecone; switch; M.Drela 15 Jan 05; CP−1300 SCR 1300 mAh; 30A max; 150g shell; 30g nosecone 11g towhook; 15g bulkheads/nuts; 6g bolts; 15g pushrods; 50g boom; 3g V−mount; 265g TOTAL fuselage

Supra F3J/TD Fuselage

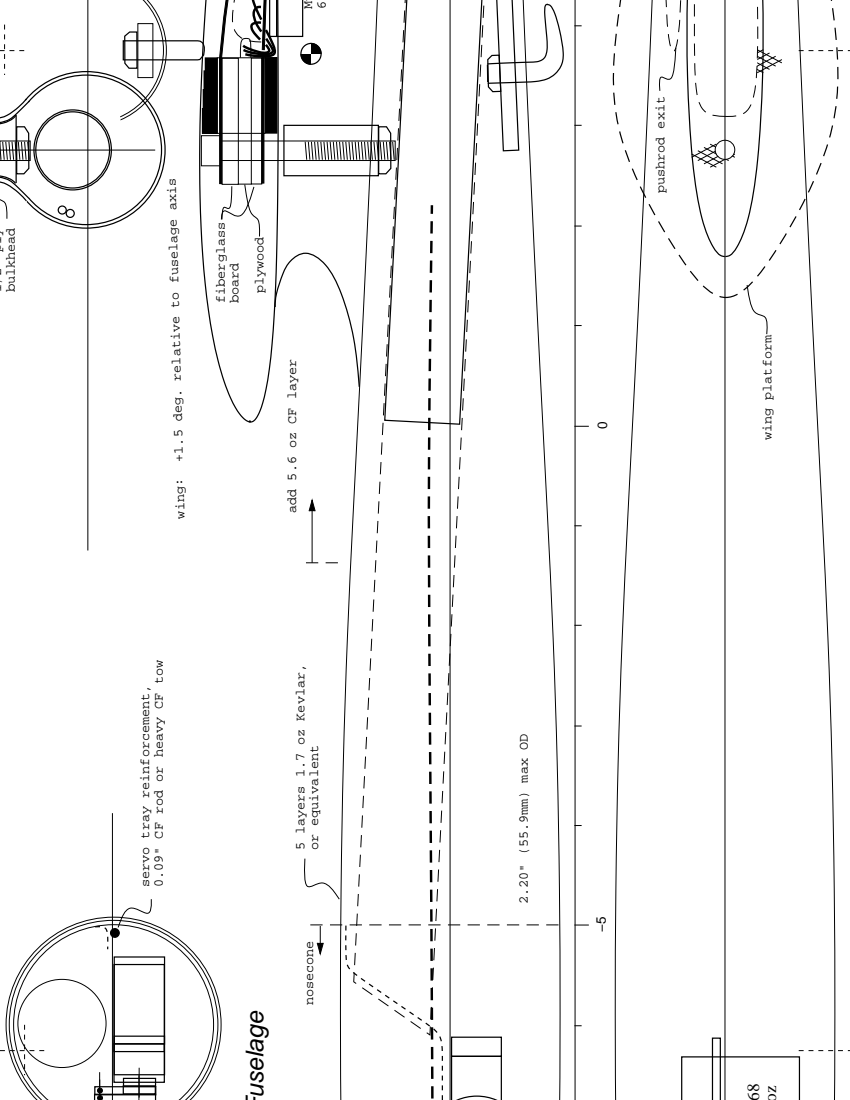
[picture p403: page 2]
fiberglass; board; Multiplex; 6−pin connector; 1/2" ply; bulkhead; nosecone; wing platform; pushrod exit; 2.20" (55.9mm) max OD; or equivalent

wing: +1.5 deg. relative to fuselage axis

Supra F3J/TD Fuselage plywood

add 5.6 oz CF layer

0.09" CF rod or heavy CF tow

5 layers 1.7 oz Kevlar,

servo tray reinforcement,

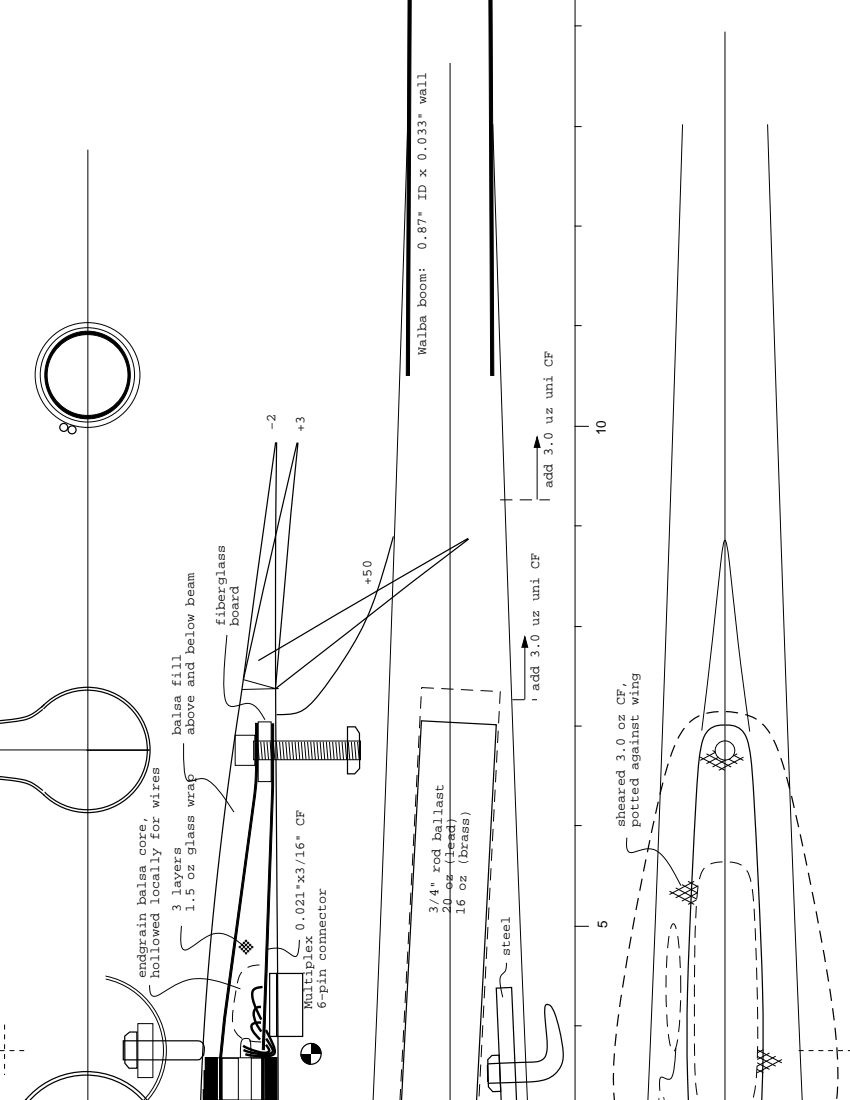
[picture p404: page 3]
Multiplex; 6−pin connector; 3 layers; balsa fill; fiberglass; board; pushrod exit; steel

Walba boom: 0.87" ID x 0.033" wall

add 3.0 uz uni CF

above and below beam

sheared 3.0 oz CF,

potted against wing

hollowed locally for wires

1.5 oz glass wrap

3/4" rod ballast 20 oz (lead) 16 oz (brass)

endgrain balsa core,

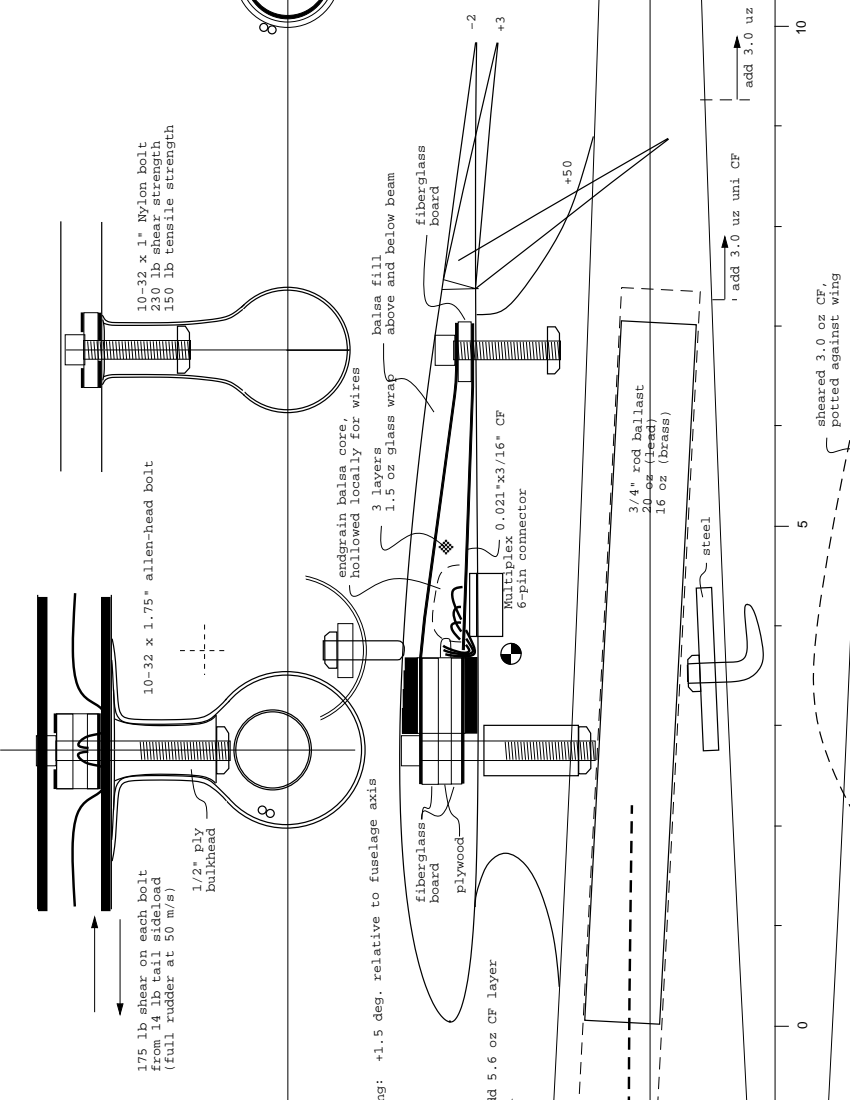
[picture p405: page 4]
fiberglass; board; Multiplex; 6−pin connector; 3 layers; balsa fill; 1/2" ply; bulkhead; plywood; 10−32 x 1" Nylon bolt; steel

add 3.0 uz uni CF

150 lb tensile strength

230 lb shear strength

above and below beam

sheared 3.0 oz CF,

potted against wing

hollowed locally for wires

1.5 oz glass wrap

3/4" rod ballast 20 oz (lead) 16 oz (brass)

endgrain balsa core,

10−32 x 1.75" allen−head bolt

wing: +1.5 deg. relative to fuselage axis

175 lb shear on each bolt

from 14 lb tail sideload

(full rudder at 50 m/s)

add 5.6 oz CF layer
