duanebeck/Allegro-Lite/Supra/supra_fin.pdf

## MD 14 May 04

## Supra F3J/TD Fin

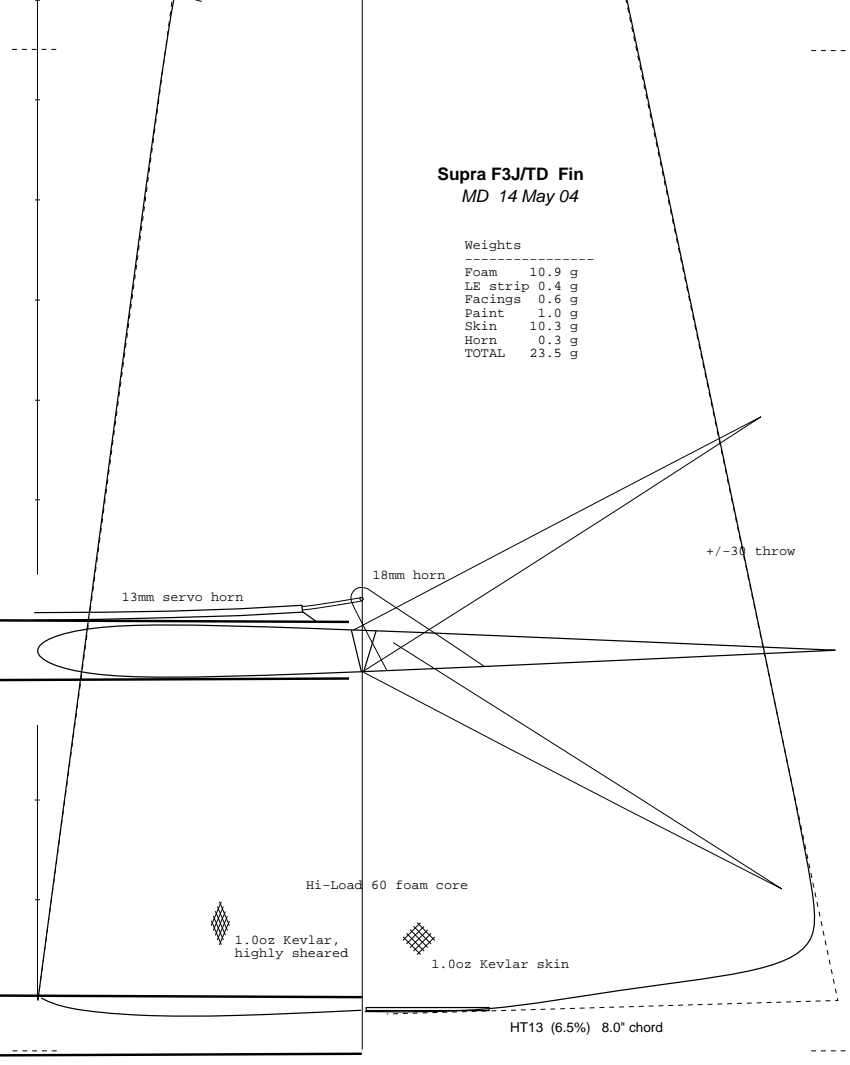
[picture p406: page 1]
18mm horn; 13mm servo horn; 1.0oz Kevlar, highly sheared; Hi−Load; 60 foam core; 1.0oz Kevlar skin; HT13 (6.5%) 8.0" chord; Weights −−−−−−−−−−−−−−−−; Foam; LE strip 0.4 g Facings 0.6 g; Paint; Skin; Horn; TOTAL; +/−30 throw

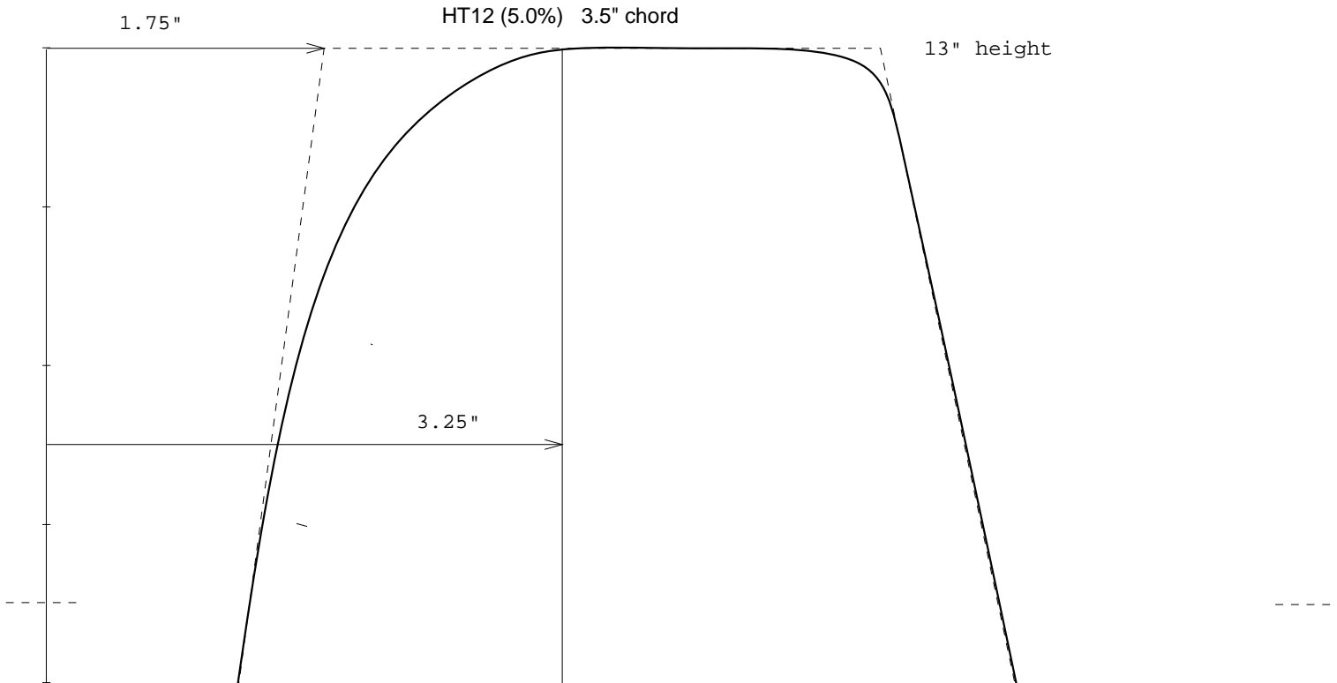
[picture p407: figure]
HT12 (5.0%) 3.5" chord; 13" height
