duanebeck/Allegro-Lite/Supra/supra_fuse.pdf

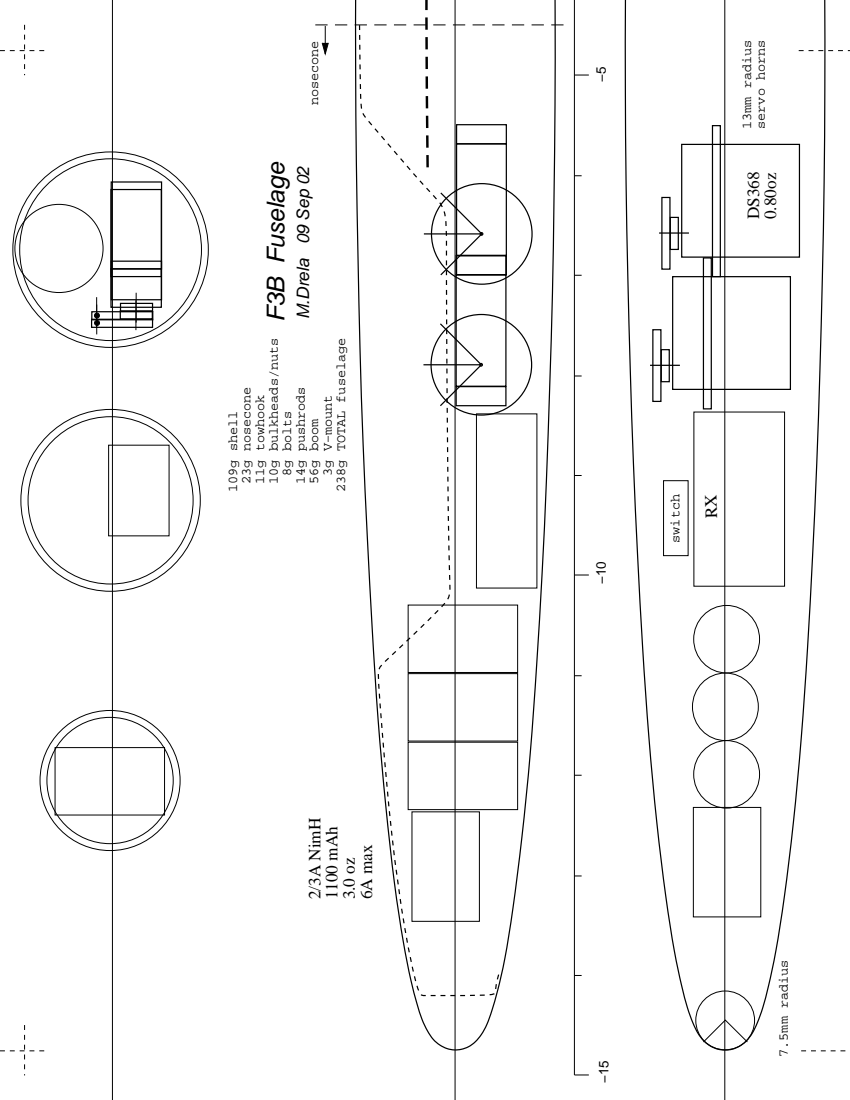
[picture p408: page 1]
13mm radius; servo horns; 7.5mm radius; F3B Fuselage; M.Drela 09 Sep 02; 2/3A NimH 1100 mAh; 6A max; nosecone; switch; 109g shell; 23g nosecone 11g towhook; 10g bulkheads/nuts; 8g bolts; 14g pushrods; 56g boom; 3g V−mount; 238g TOTAL fuselage

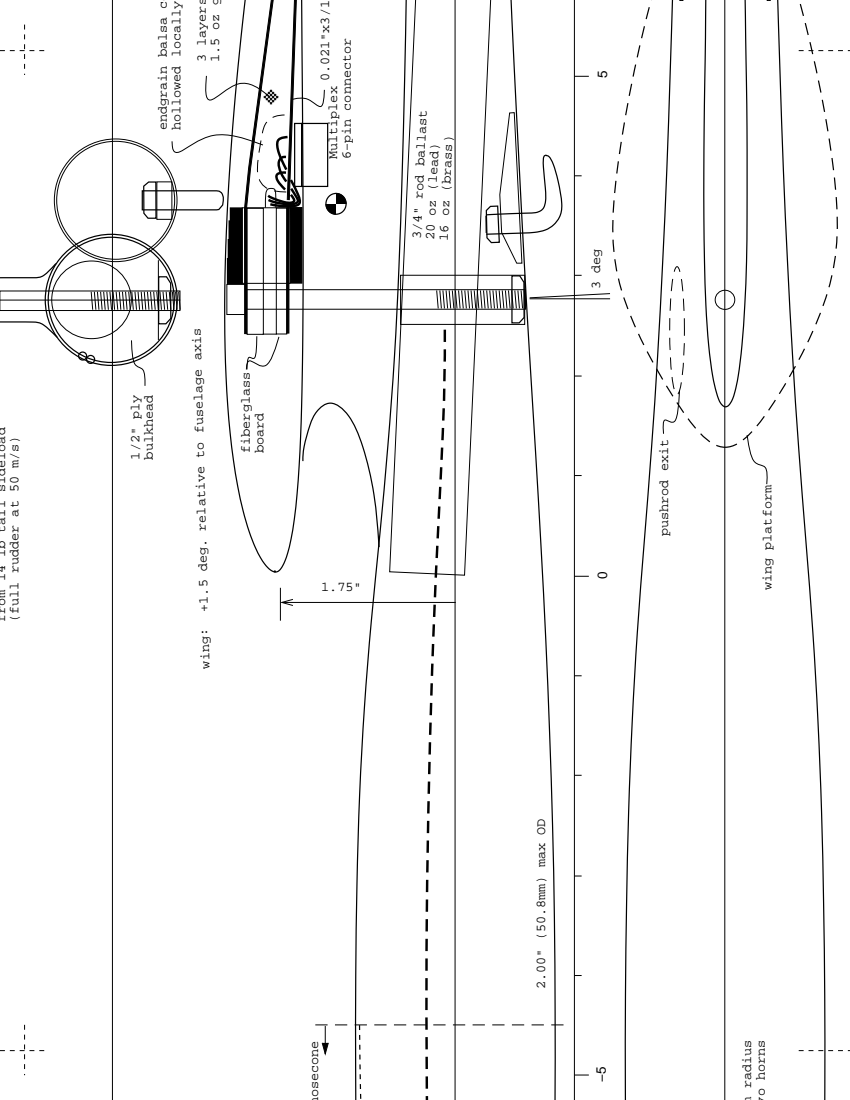
[picture p409: page 2]
13mm radius; servo horns; 2.00" (50.8mm) max OD; fiberglass; board; Multiplex; 6−pin connector; 3 deg; 3 layers; 1/2" ply; bulkhead; nosecone; wing platform; pushrod exit

hollowed locally for wires

1.5 oz glass wrap

endgrain balsa core,

10−32 allen−head bolt from 14 lb tail sideload

3/4" rod ballast 20 oz (lead) 16 oz (brass)

wing: +1.5 deg. relative to fuselage axis

(full rudder at 50 m/s)

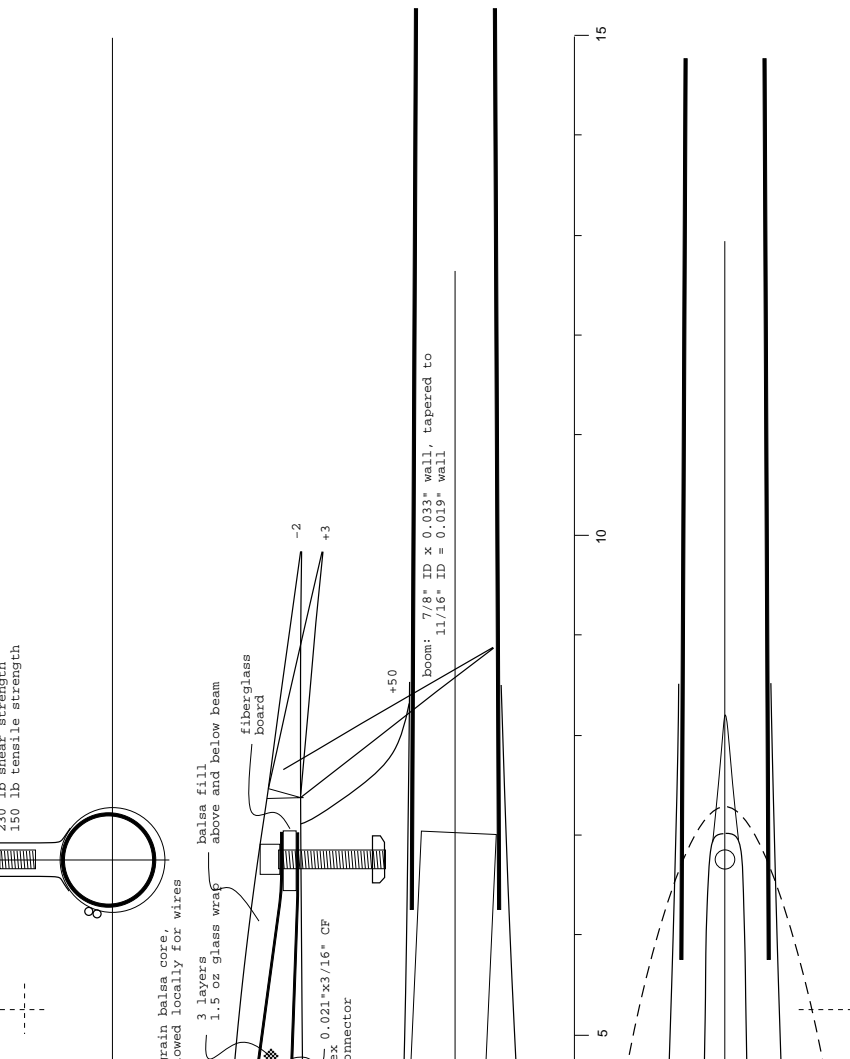
[picture p410: page 3]
Multiplex; 6−pin connector; 11/16" ID = 0.019" wall; 3 layers; balsa fill; fiberglass; board

boom: 7/8" ID x 0.033" wall, tapered to

150 lb tensile strength

230 lb shear strength

above and below beam

hollowed locally for wires

1.5 oz glass wrap

endgrain balsa core,

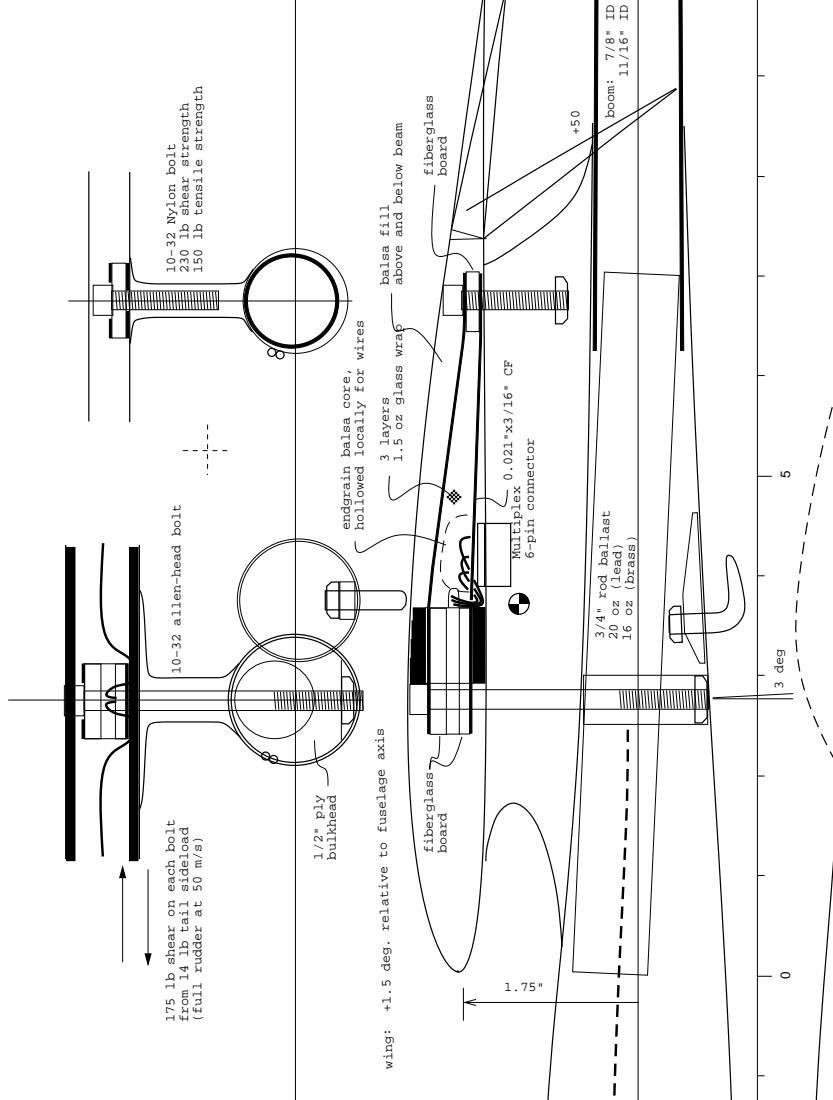
[picture p411: page 4]
10−32 Nylon bolt; fiberglass; board; Multiplex; 6−pin connector; 11/16" ID = 0.019" wall; 3 deg; 3 layers; balsa fill; 1/2" ply; bulkhead

boom: 7/8" ID x 0.033" wall, tapered to

150 lb tensile strength

230 lb shear strength

above and below beam

hollowed locally for wires

1.5 oz glass wrap

endgrain balsa core,

10−32 allen−head bolt 175 lb shear on each bolt from 14 lb tail sideload

3/4" rod ballast 20 oz (lead) 16 oz (brass)

wing: +1.5 deg. relative to fuselage axis

(full rudder at 50 m/s)
