duanebeck/Allegro-Lite/Supra/supra_wing.pdf

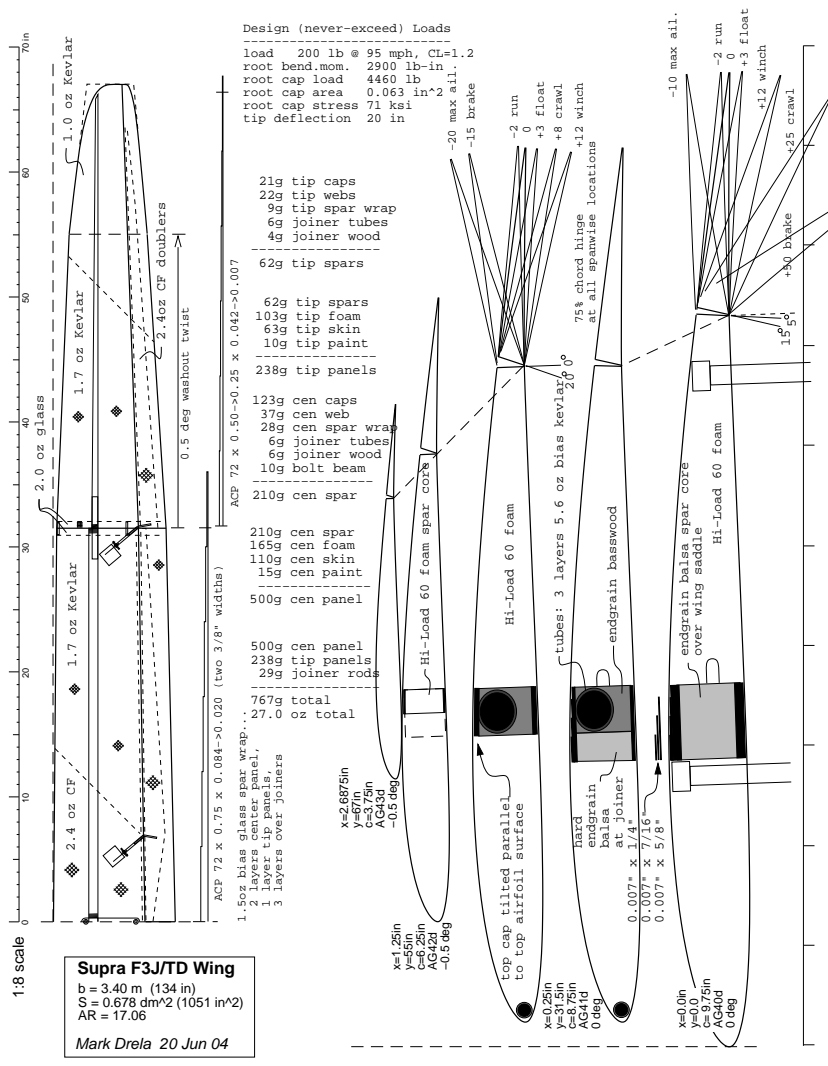
[picture p412: page 1]
40 50 1:8 scale; −2 run; 75% chord hinge; +3 float x=0.25in; c=8.75in AG41d 0 deg; −0.5 deg; +50 brake; endgrain basswood; 1.7 oz Kevlar; 1.0 oz Kevlar; 2.4oz CF doublers; 2.0 oz glass; 62g tip spars 103g tip foam 63g tip skin 10g tip paint −−−−−−−−−−−−−−− 238g tip panels; 210g cen spar 165g cen foam 110g cen skin 15g cen paint −−−−−−−−−−−−−− 500g cen panel; 500g cen panel 238g tip panels 29g joiner rods −−−−−−−−−−−−−−−− 767g total 27.0 oz total; hard; endgrain; balsa; at joiner; +12 winch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

Design (never−exceed) Loads
root bend.mom. 2900 lb−in
root cap stress 71 ksi
tip deflection 20 in

at all spanwise locations

21g tip caps
22g tip webs
9g tip spar wrap
6g joiner tubes
4g joiner wood
62g tip spars

0.5 deg washout twist

tubes: 3 layers 5.6 oz bias kevlar

123g cen caps
37g cen web
28g cen spar wrap
6g joiner wood
10g bolt beam
210g cen spar

Hi−Load 60 foam

Hi−Load 60 foam spar core

endgrain balsa spar core

over wing saddle

1.7 oz Kevlar 2.4 oz CF

ACP 72 x 0.75 x 0.084−>0.020 (two 3/8" widths)

1.5oz bias glass spar wrap...

2 layers center panel,

3 layers over joiners

1 layer tip panels,

top cap tilted parallel

to top airfoil surface

Supra F3J/TD Wing
Mark Drela 20 Jun 04
