duanebeck/Allegro-Lite/templates.pdf

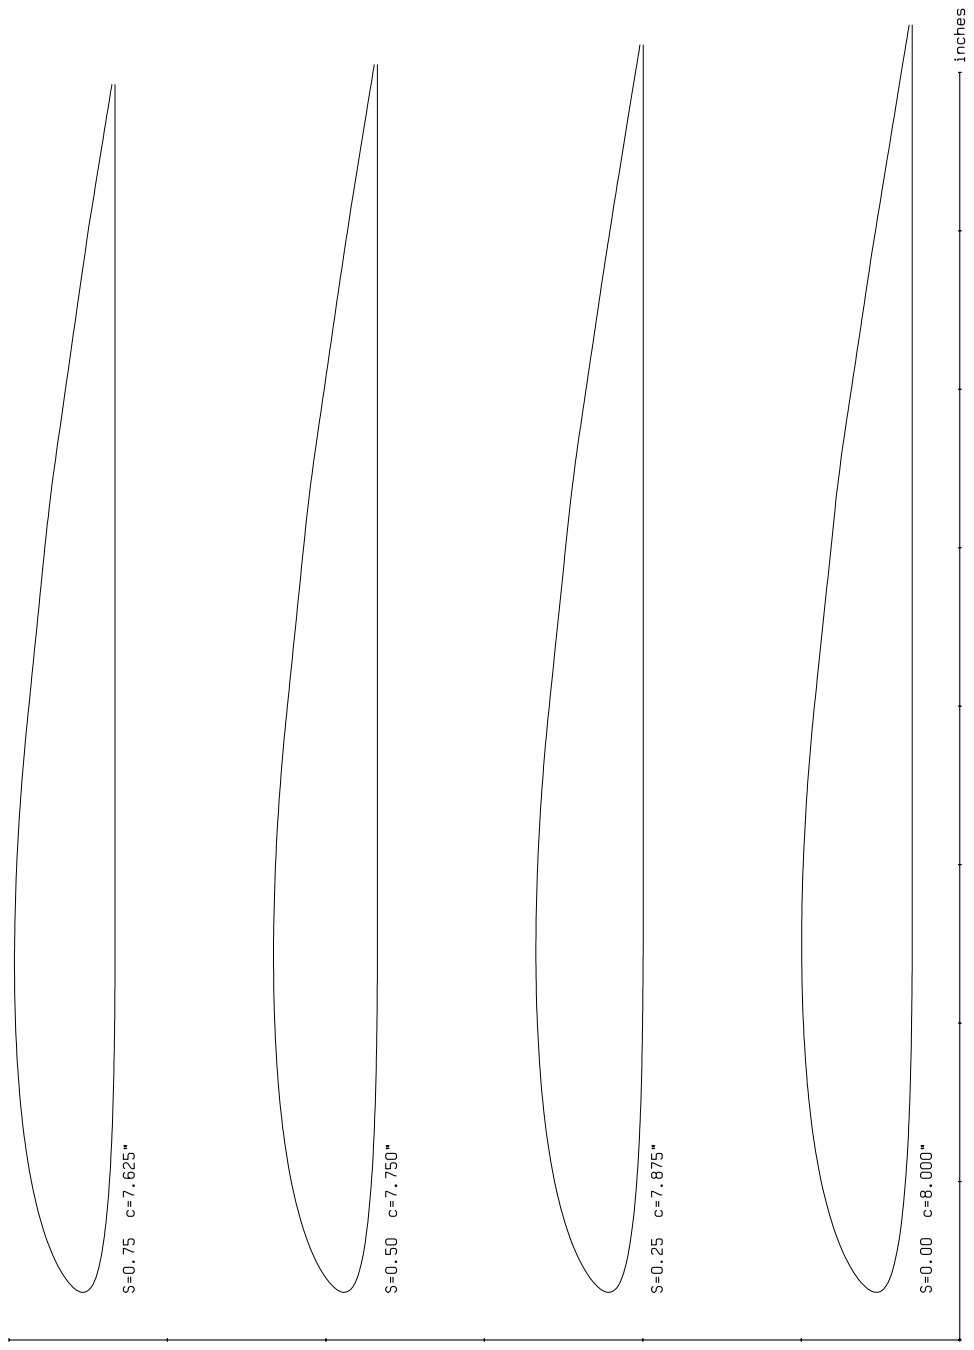
[picture p413: page 1]

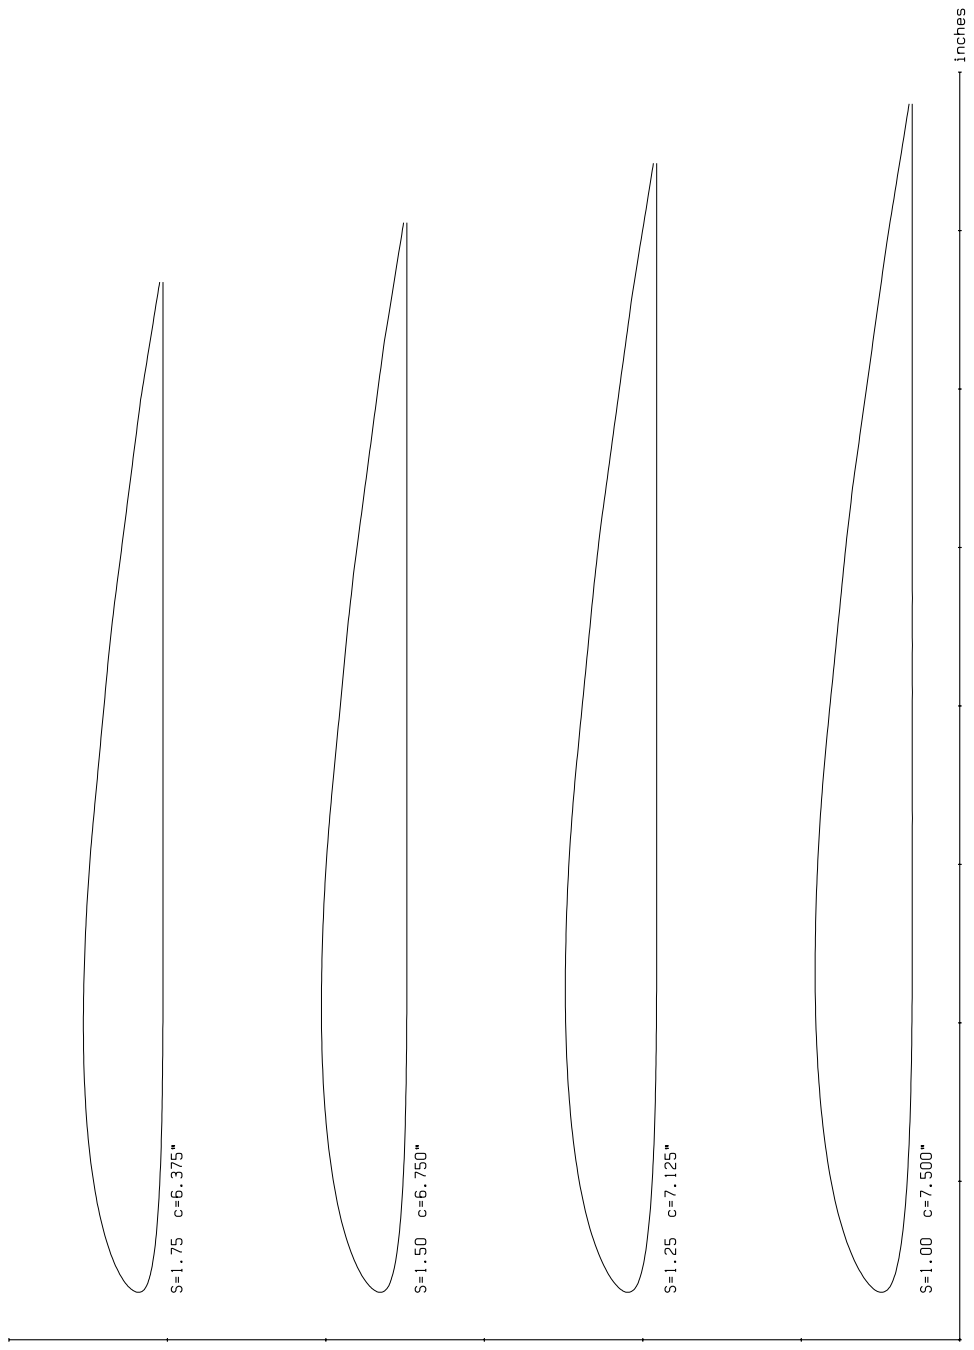
[picture p414: page 2]

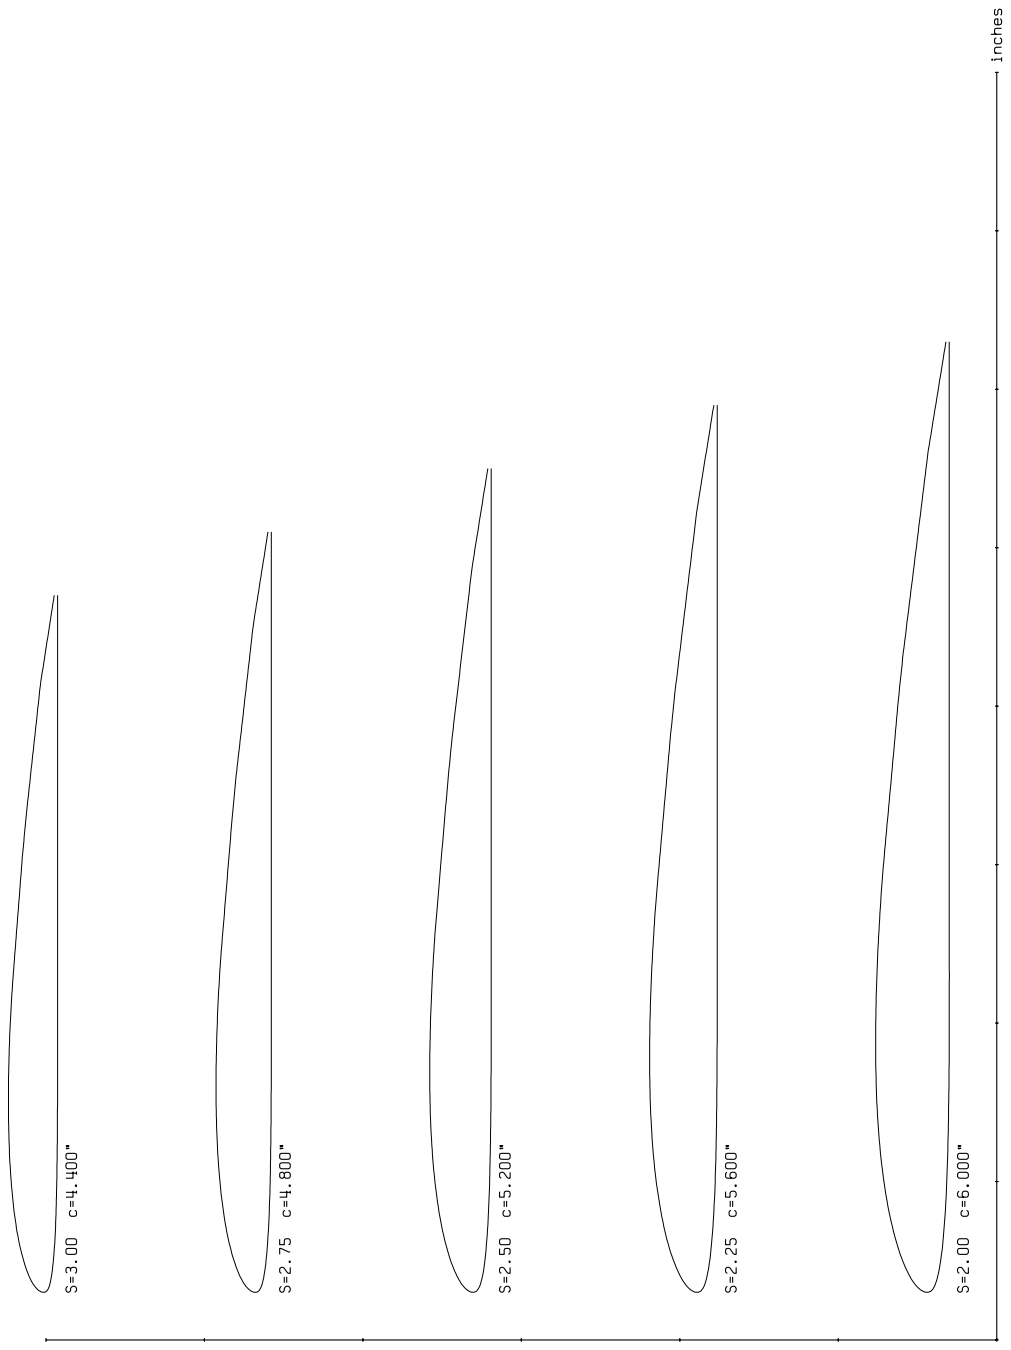
[picture p415: page 3]
