duanebeck/Allegro-Lite/Bubble Dancer/dancer_fig.pdf

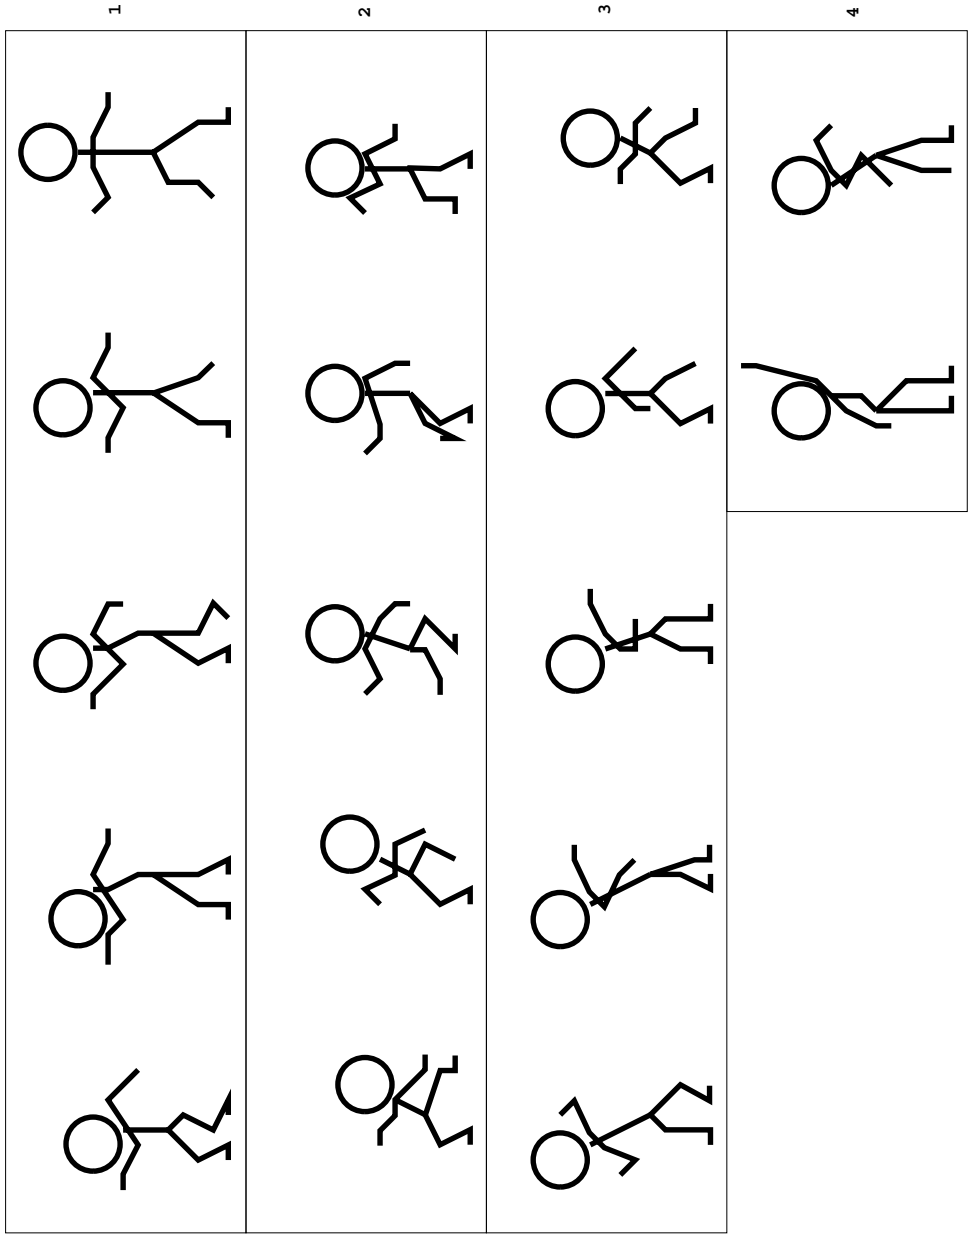
[picture p416: page 1]
