duanebeck/Allegro-Lite/SkyDancer drawings/SkyDancer electric3view.pdf

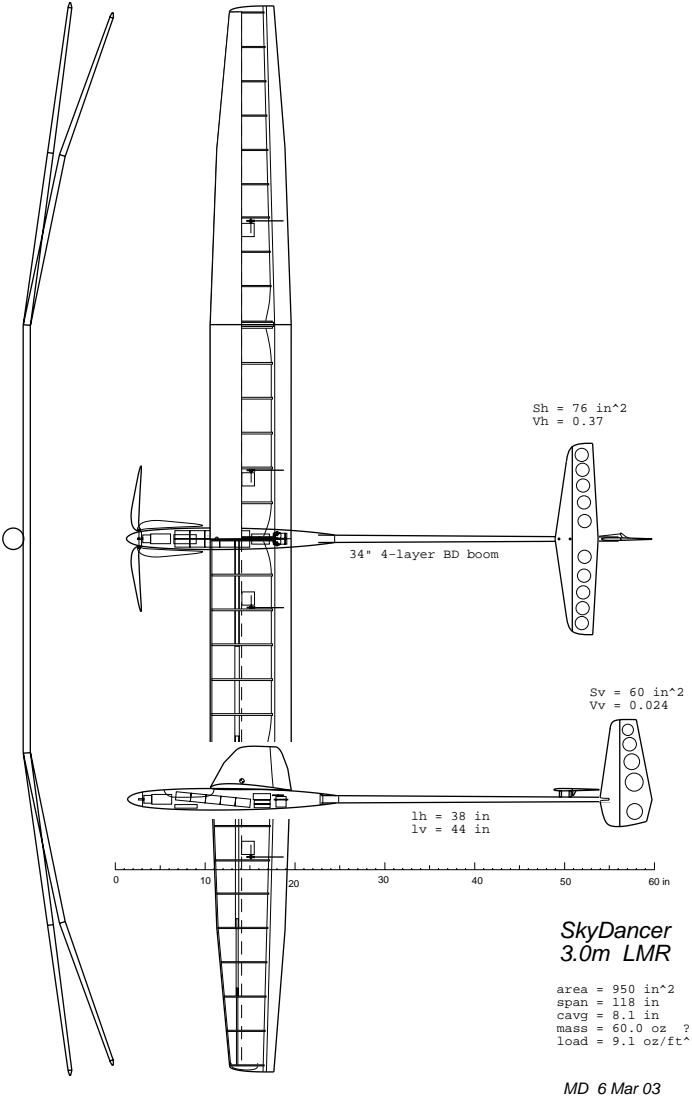
[picture p417: page 1]
MD 6 Mar 03; SkyDancer 3.0m LMR; 8 x CP−2400 SCR 17.0 oz

34" 4−layer BD boom

area = 950 in^2
span = 118 in
cavg = 8.1 in
mass = 60.0 oz ?
load = 9.1 oz/ft^2
