duanebeck/Allegro-Lite/Supra/supra_launch_loads.pdf

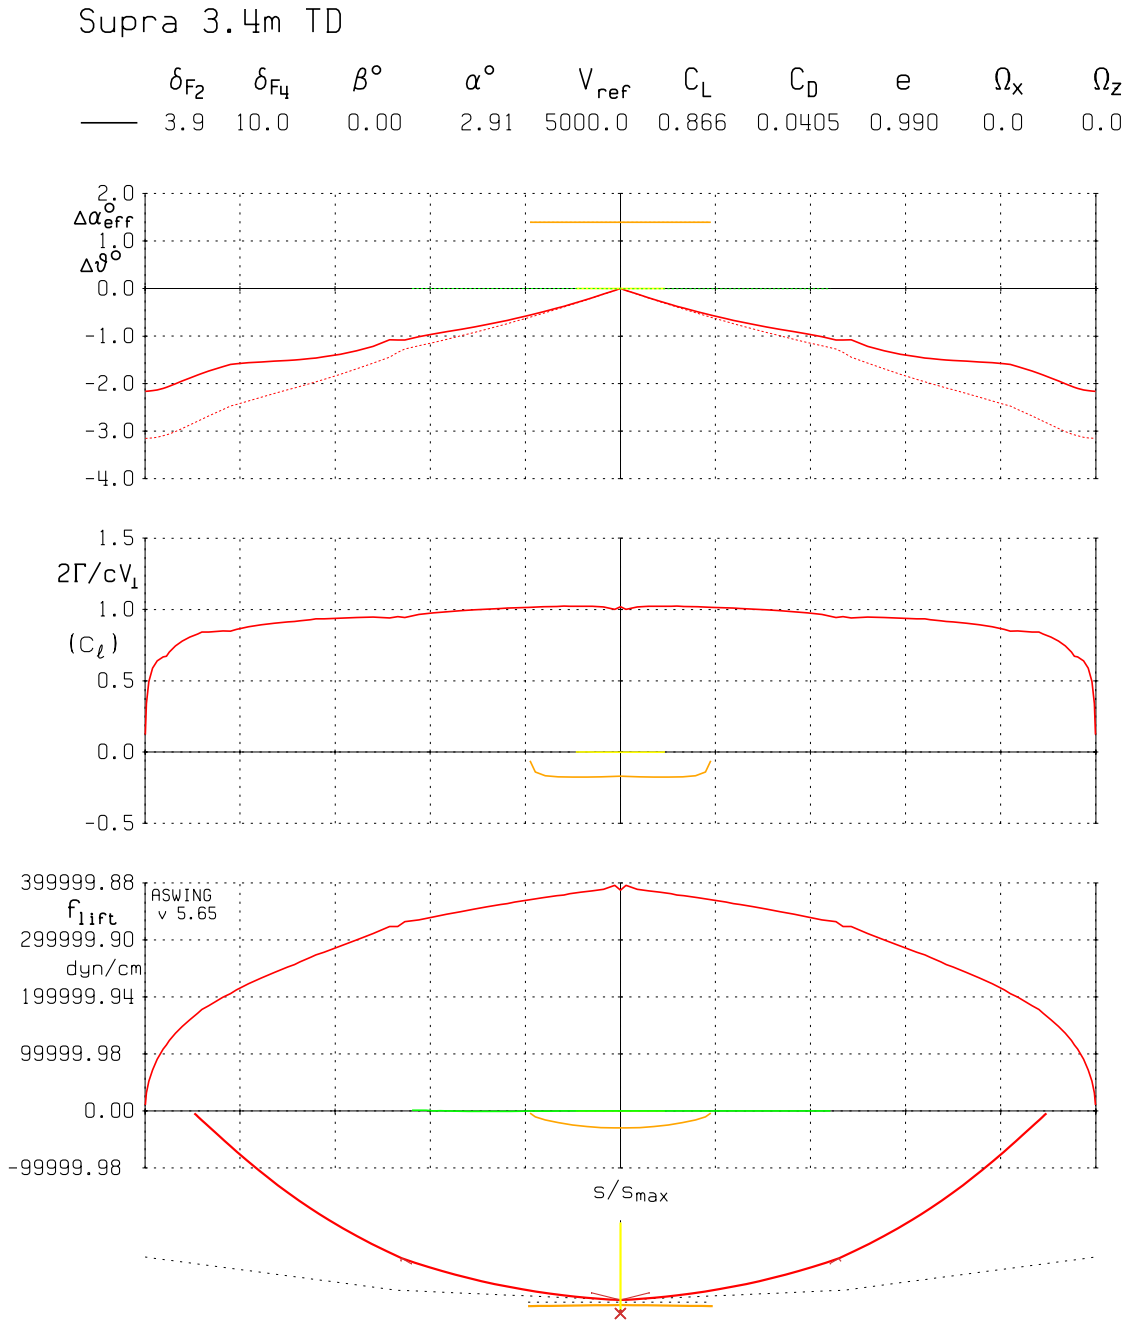
[picture p418: page 1]

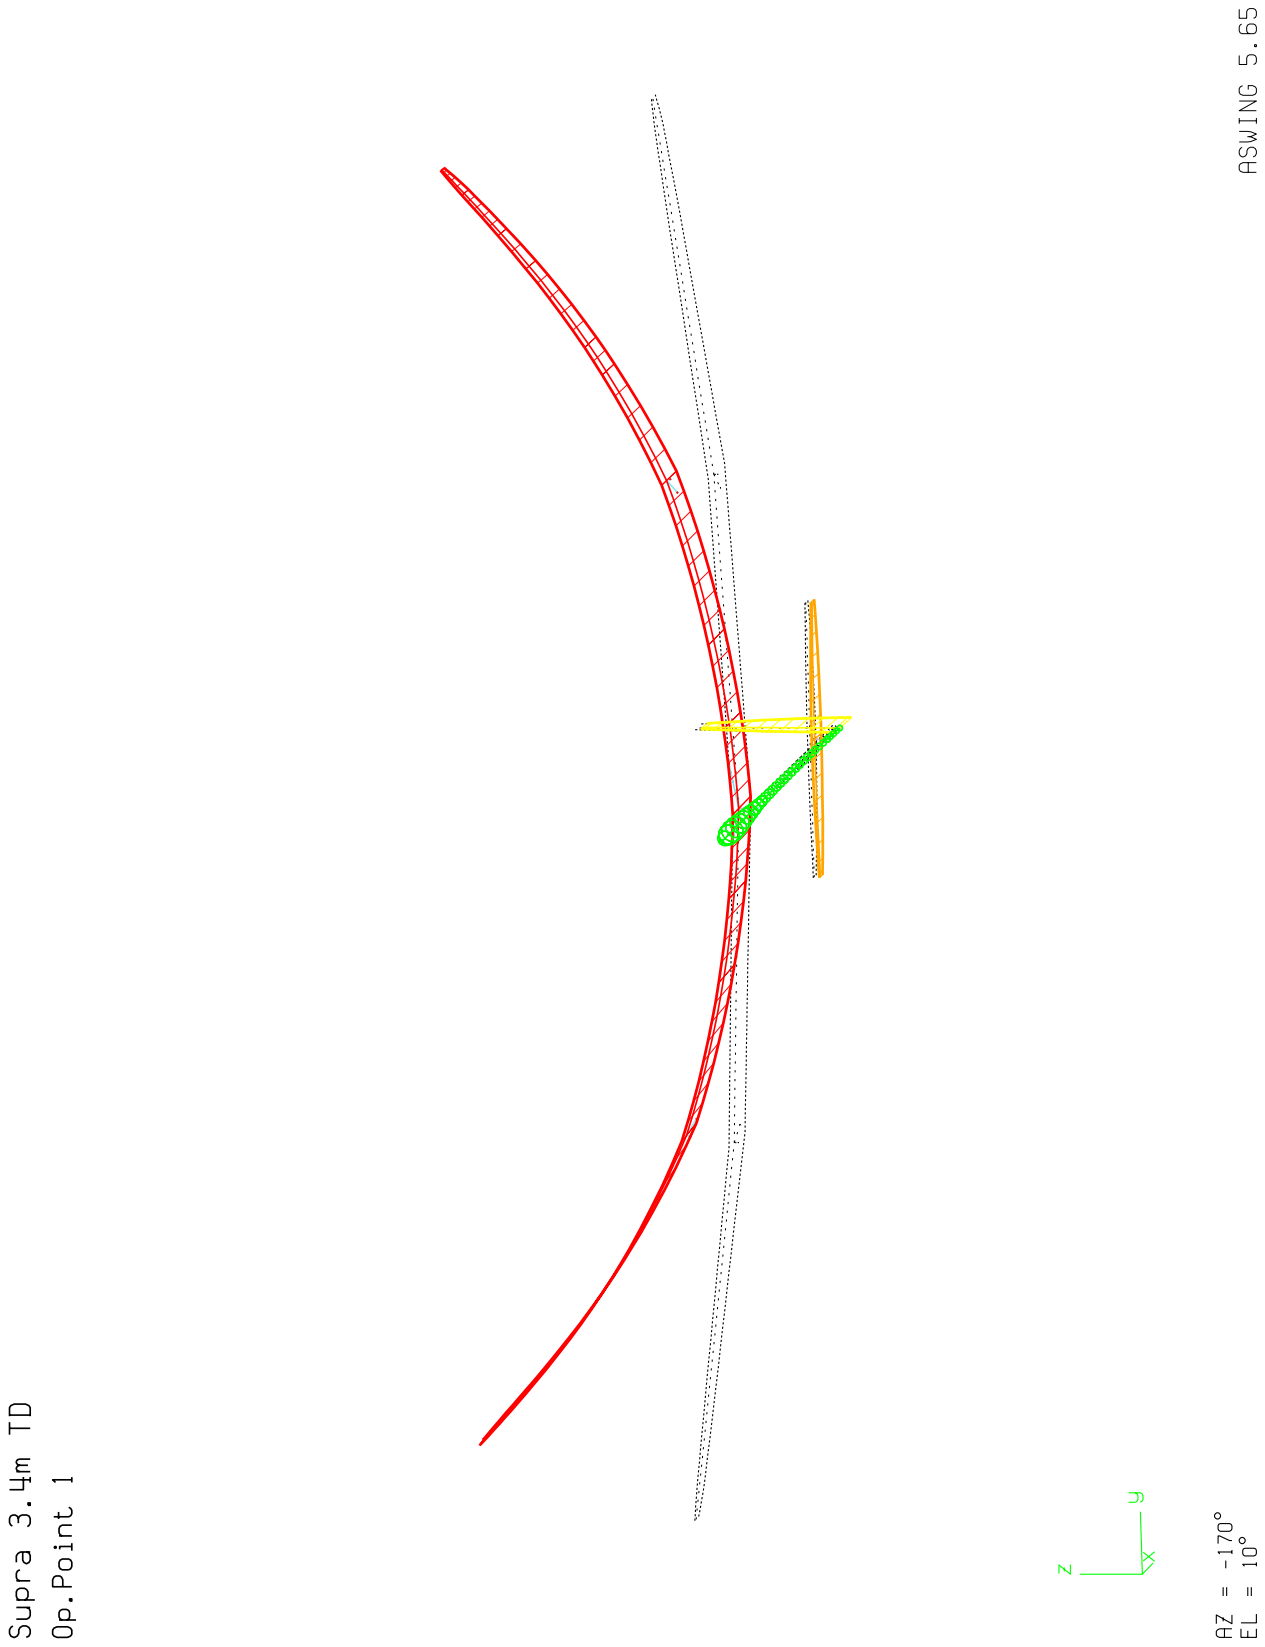
[picture p419: page 2]
