duanebeck/Allegro-Lite/Supra/supra_stab.pdf

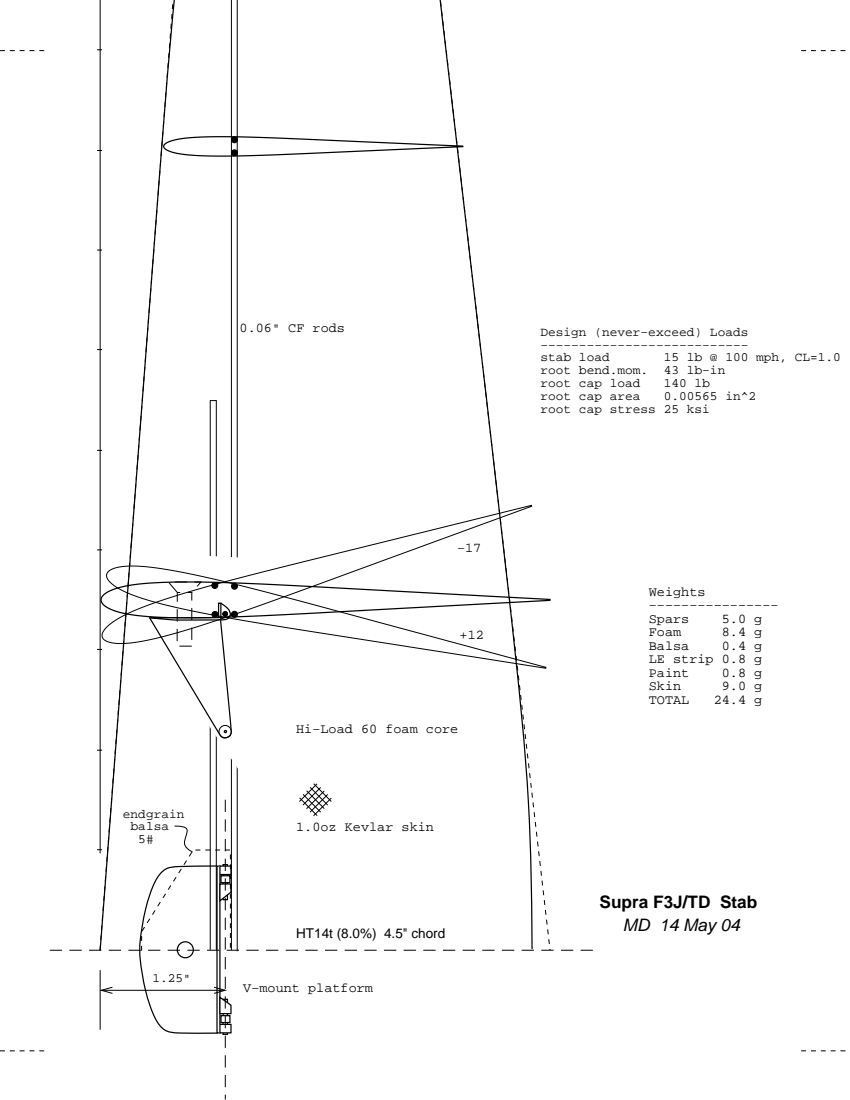
[picture p420: page 1]
HT14t (8.0%) 4.5" chord; endgrain balsa 5#; 1.0oz Kevlar skin; stab load; 15 lb @ 100 mph, CL=1.0; root cap load; root cap area; 0.06" CF rods; Weights −−−−−−−−−−−−−−−−; Spars; Foam; Balsa; LE strip 0.8 g; Paint; Skin; TOTAL; V−mount platform

Design (never−exceed) Loads
root bend.mom. 43 lb−in
root cap stress 25 ksi

Hi−Load 60 foam core

Supra F3J/TD Stab
MD 14 May 04

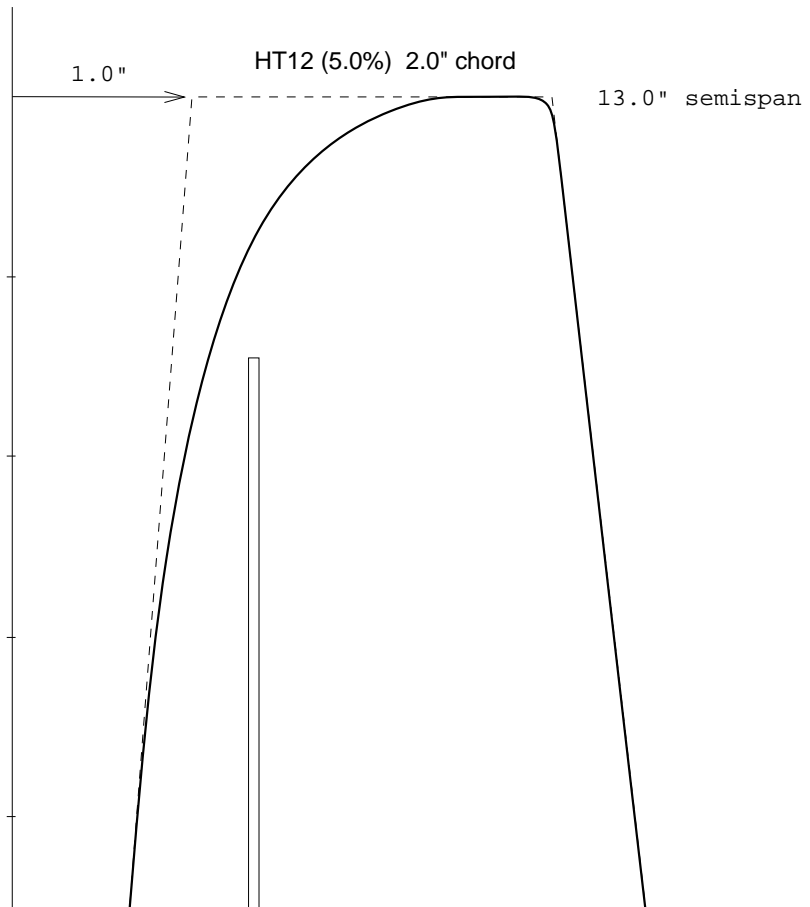
[picture p421: figure]
HT12 (5.0%) 2.0" chord; 13.0" semispan
