duanebeck/Allegro-Lite/Winch_Launch/winchlaunch_sim.pdf

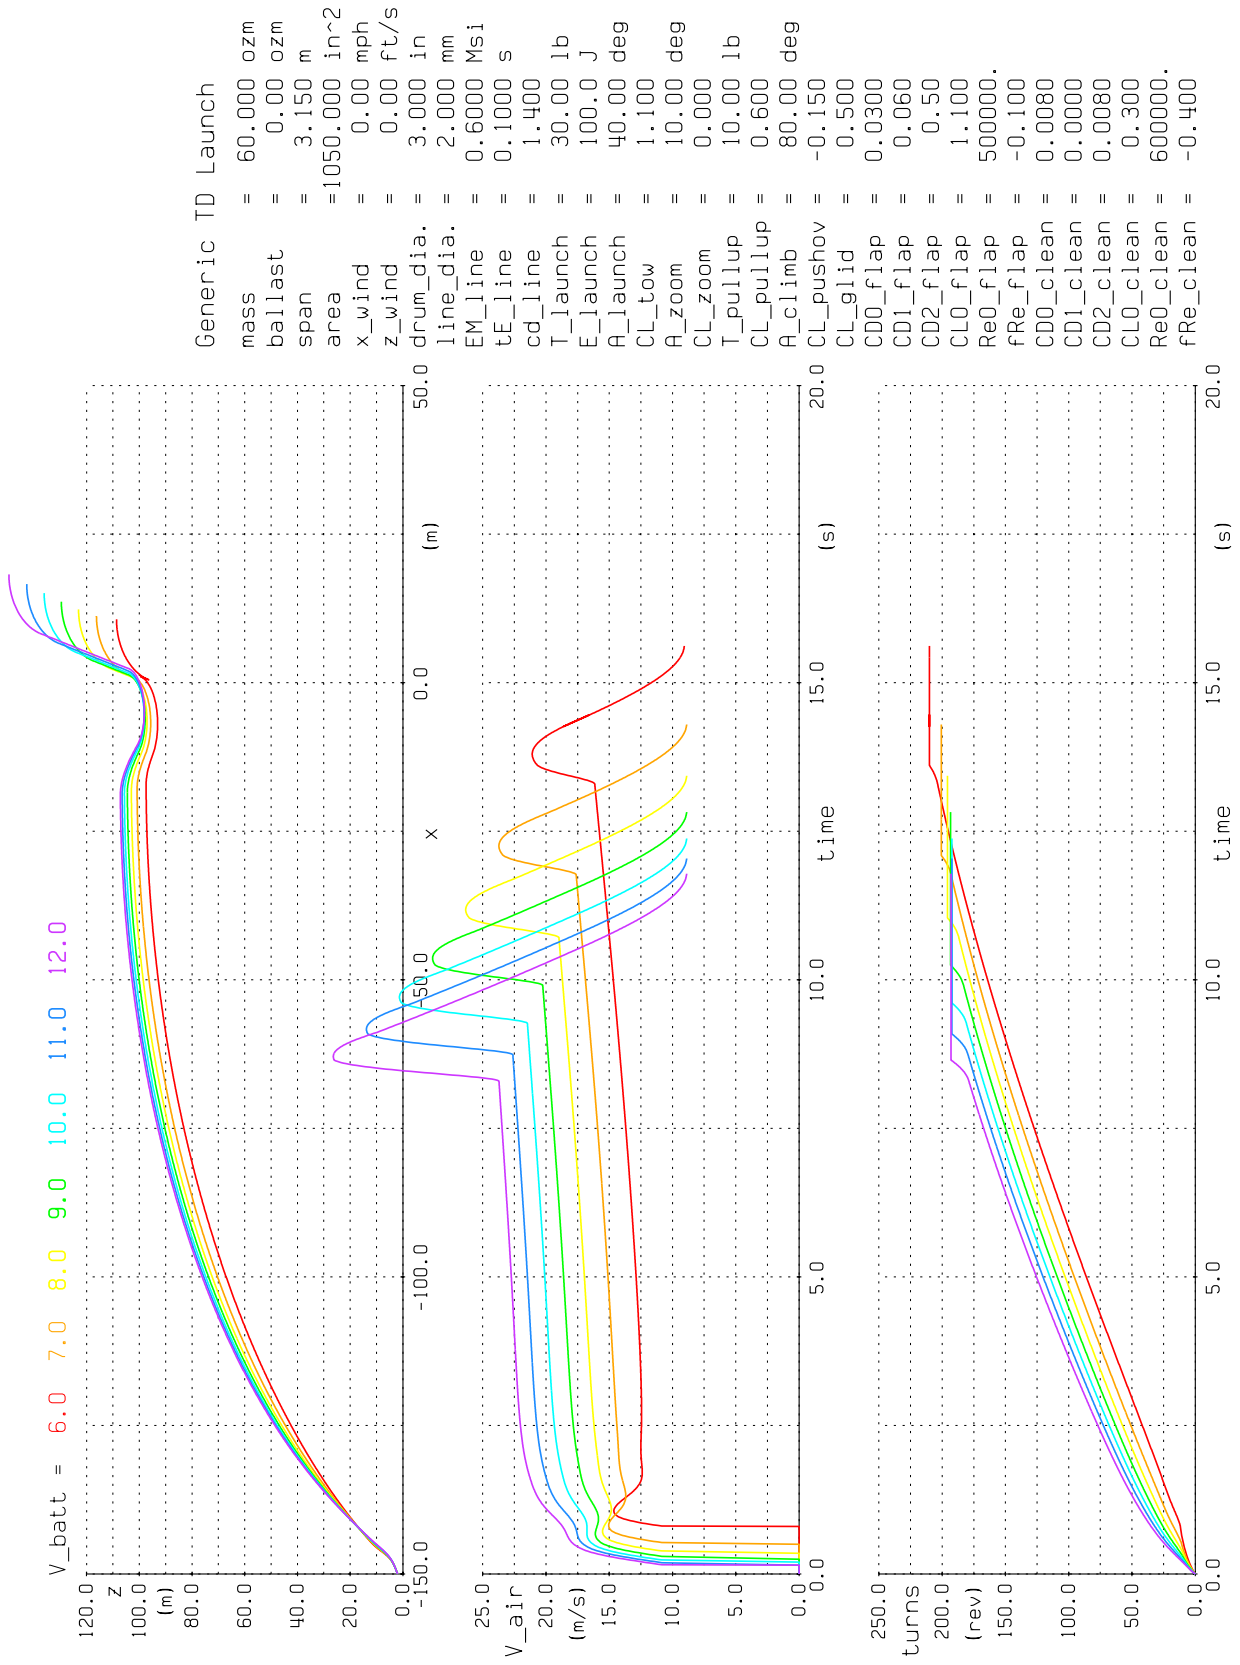
[picture p422: page 1]

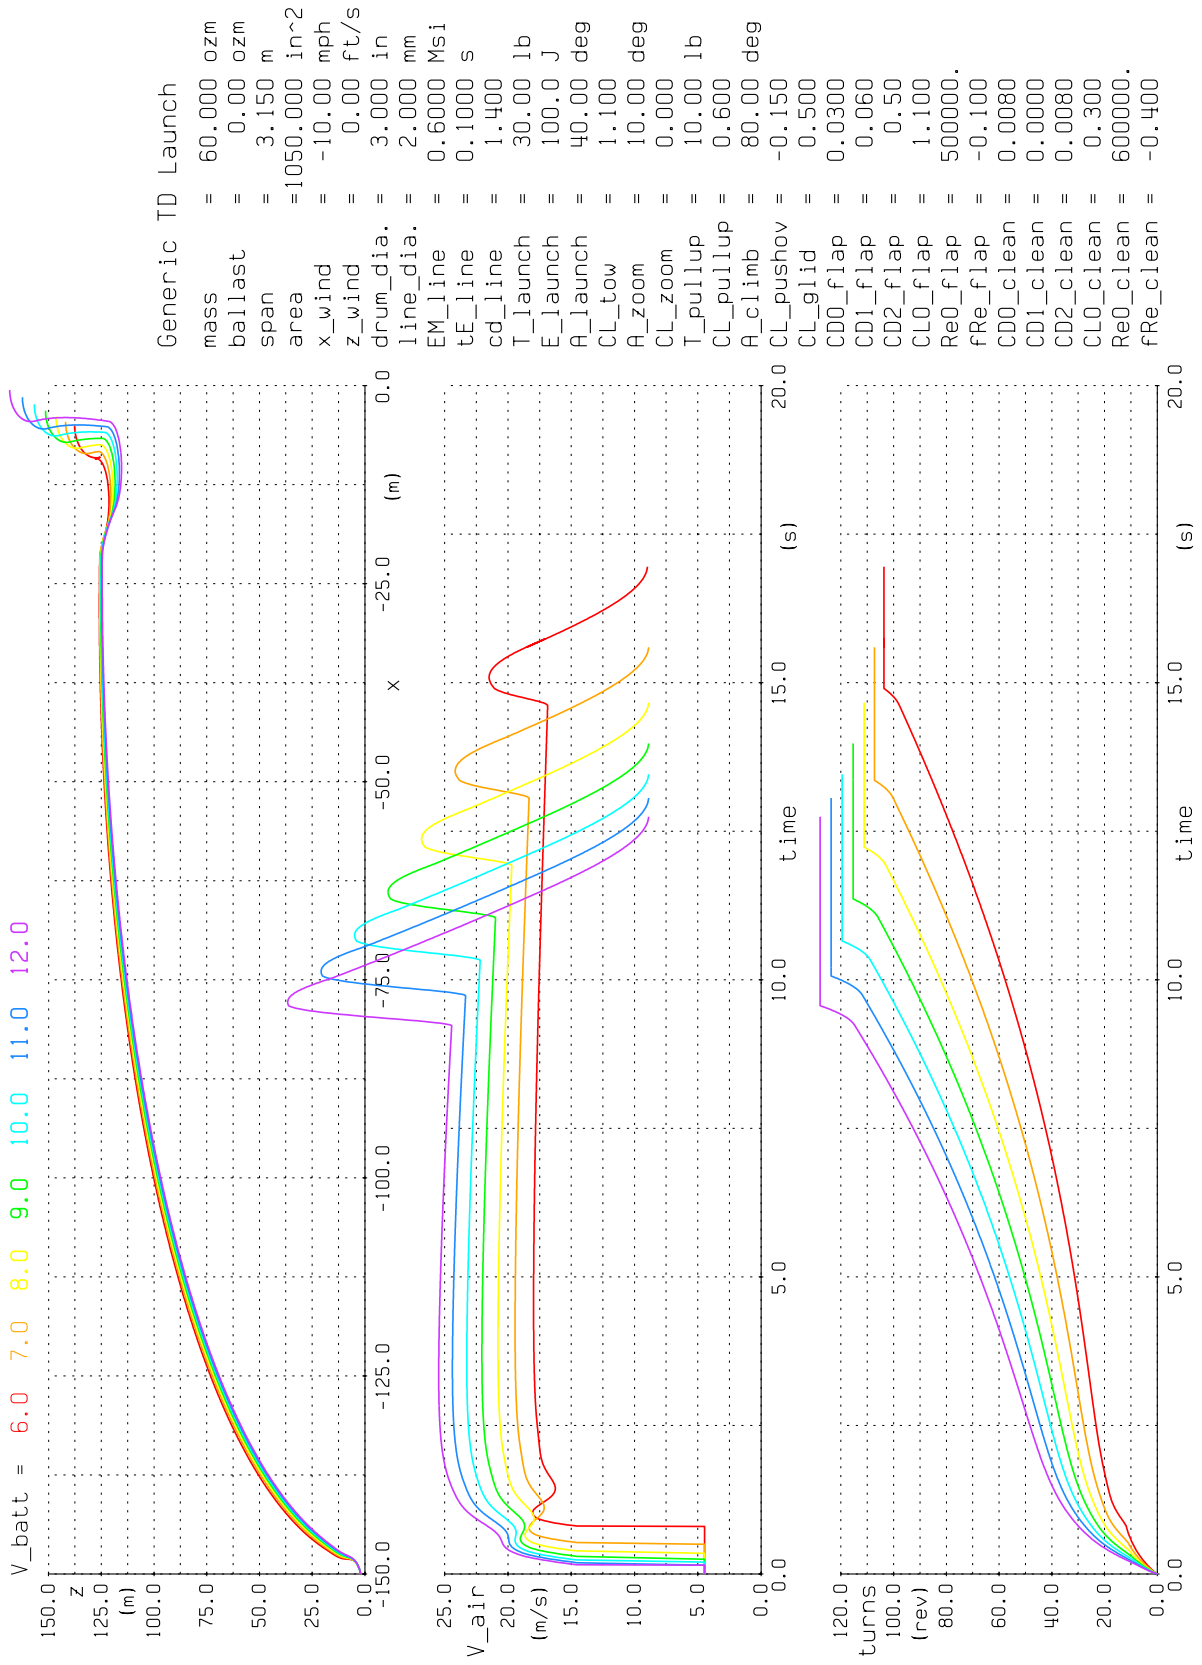
[picture p423: page 2]
