duanebeck/Allegro-Lite/Bubble Dancer/Ribs/brk_ribs.pdf

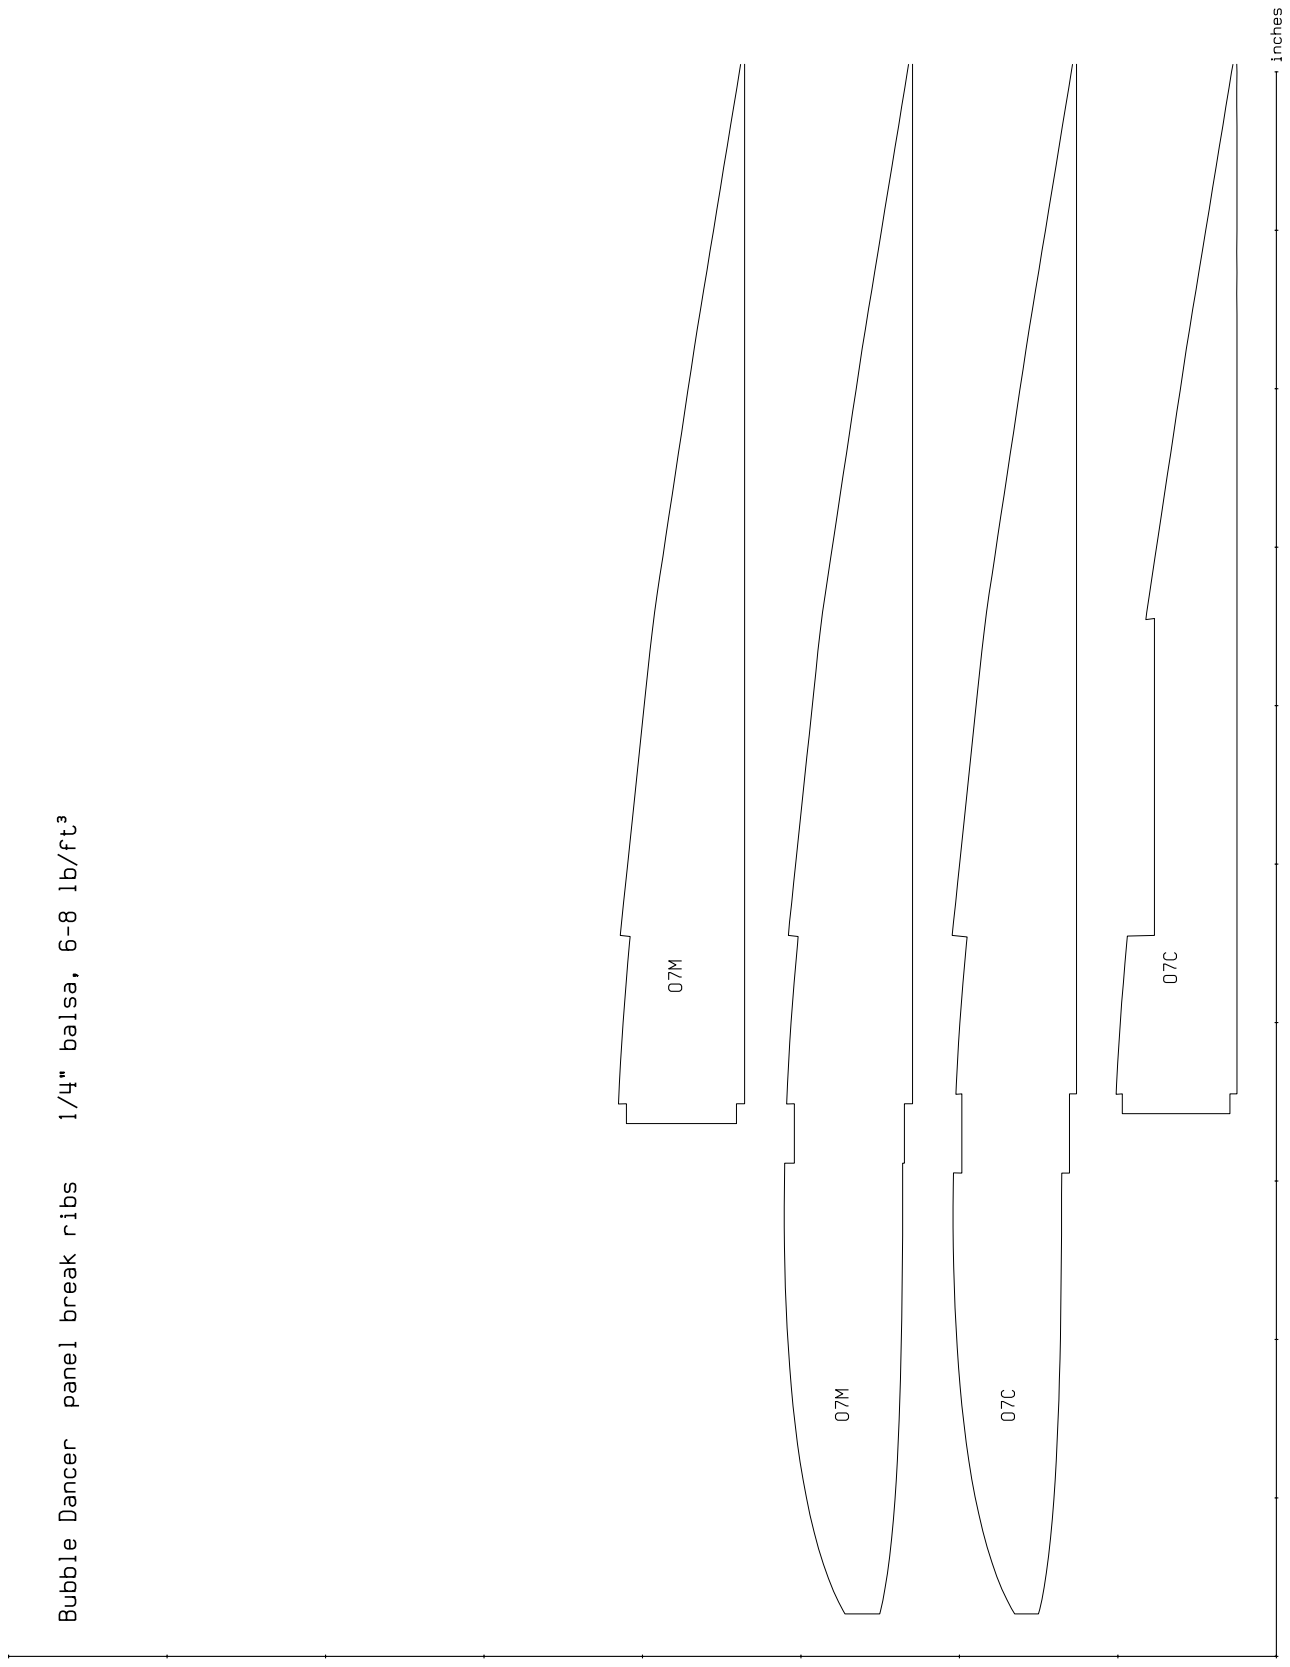
[picture p424: page 1]
