duanebeck/Allegro-Lite/Bubble Dancer/Ribs/cen_ribs.pdf

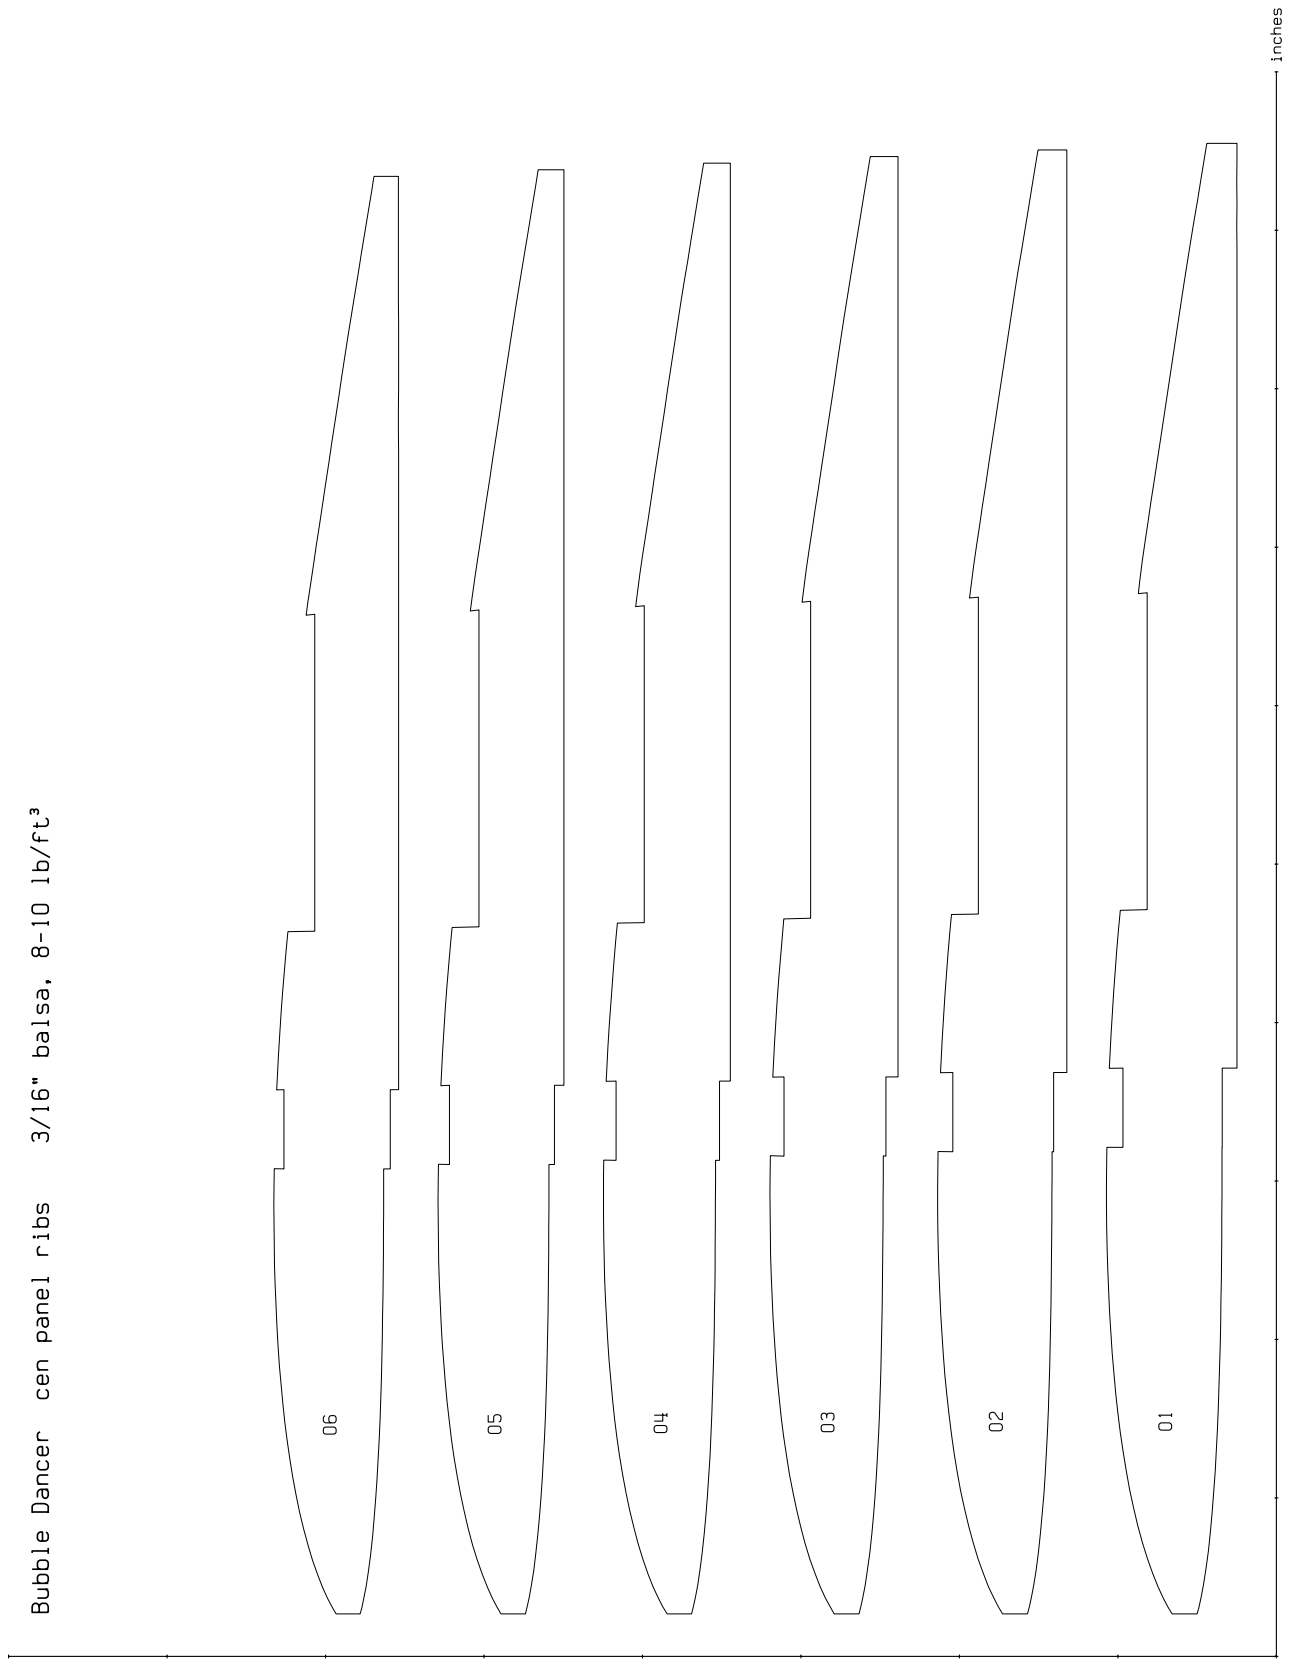
[picture p425: page 1]
