duanebeck/Allegro-Lite/Bubble Dancer/Ribs/cen_temp.pdf

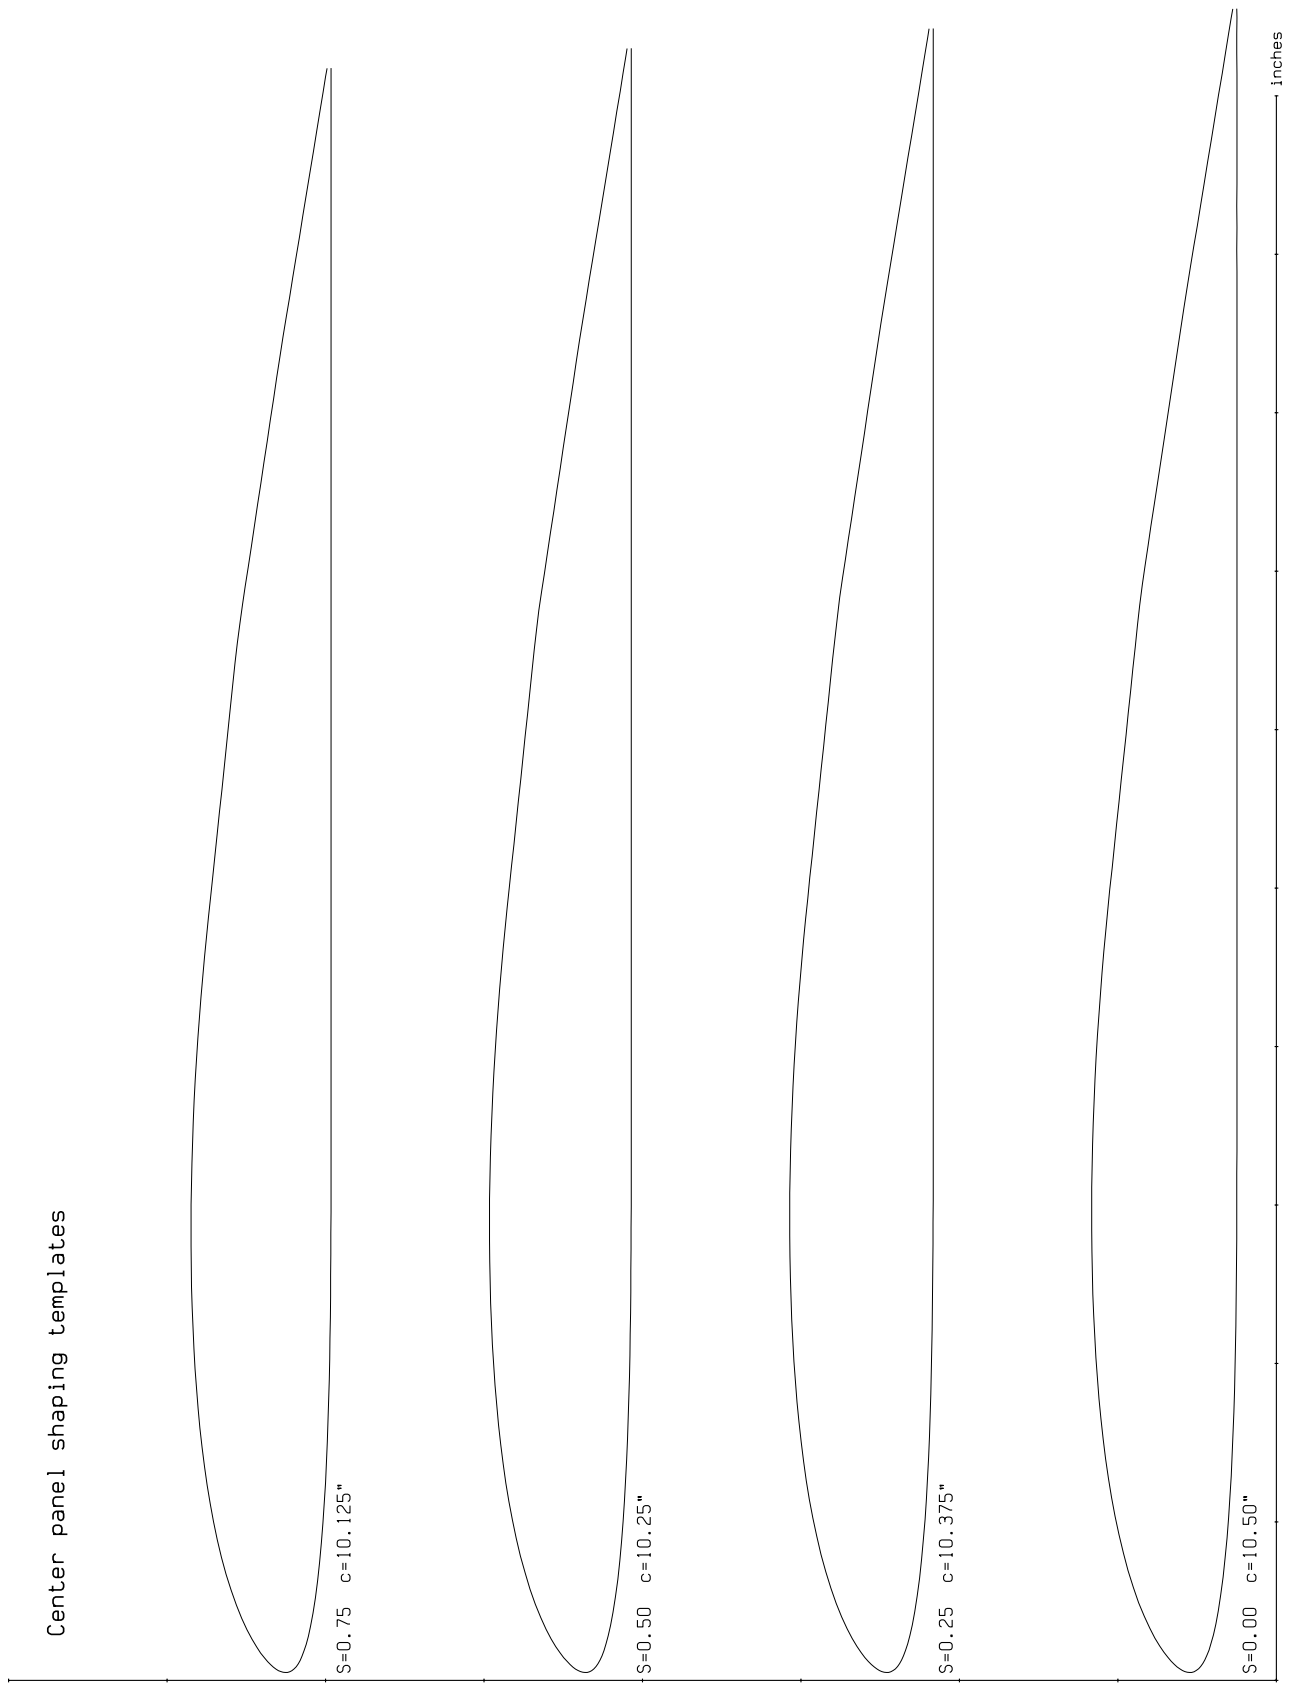
[picture p426: page 1]
