duanebeck/Allegro-Lite/Bubble Dancer/Ribs/mid_ribs.pdf

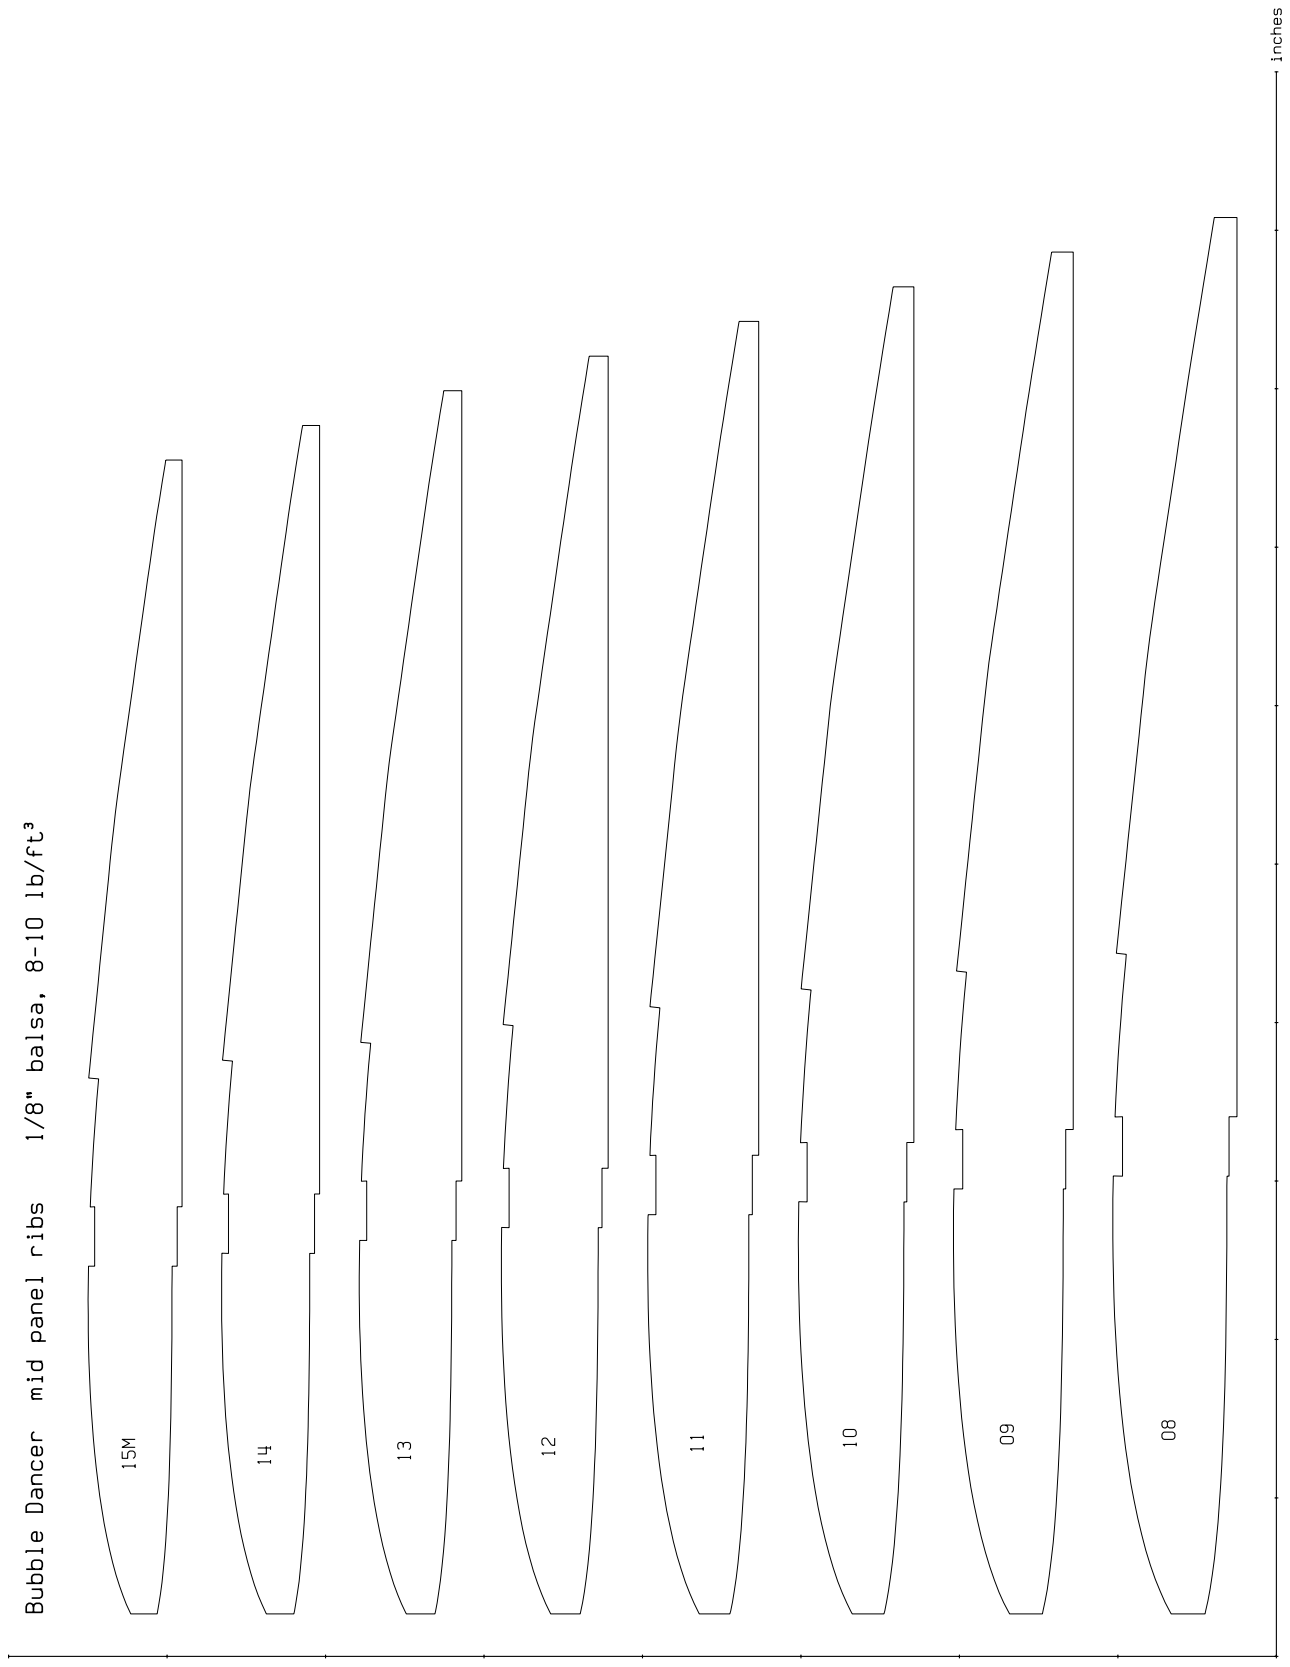
[picture p427: page 1]
