duanebeck/Allegro-Lite/Bubble Dancer/Ribs/mid_temp.pdf

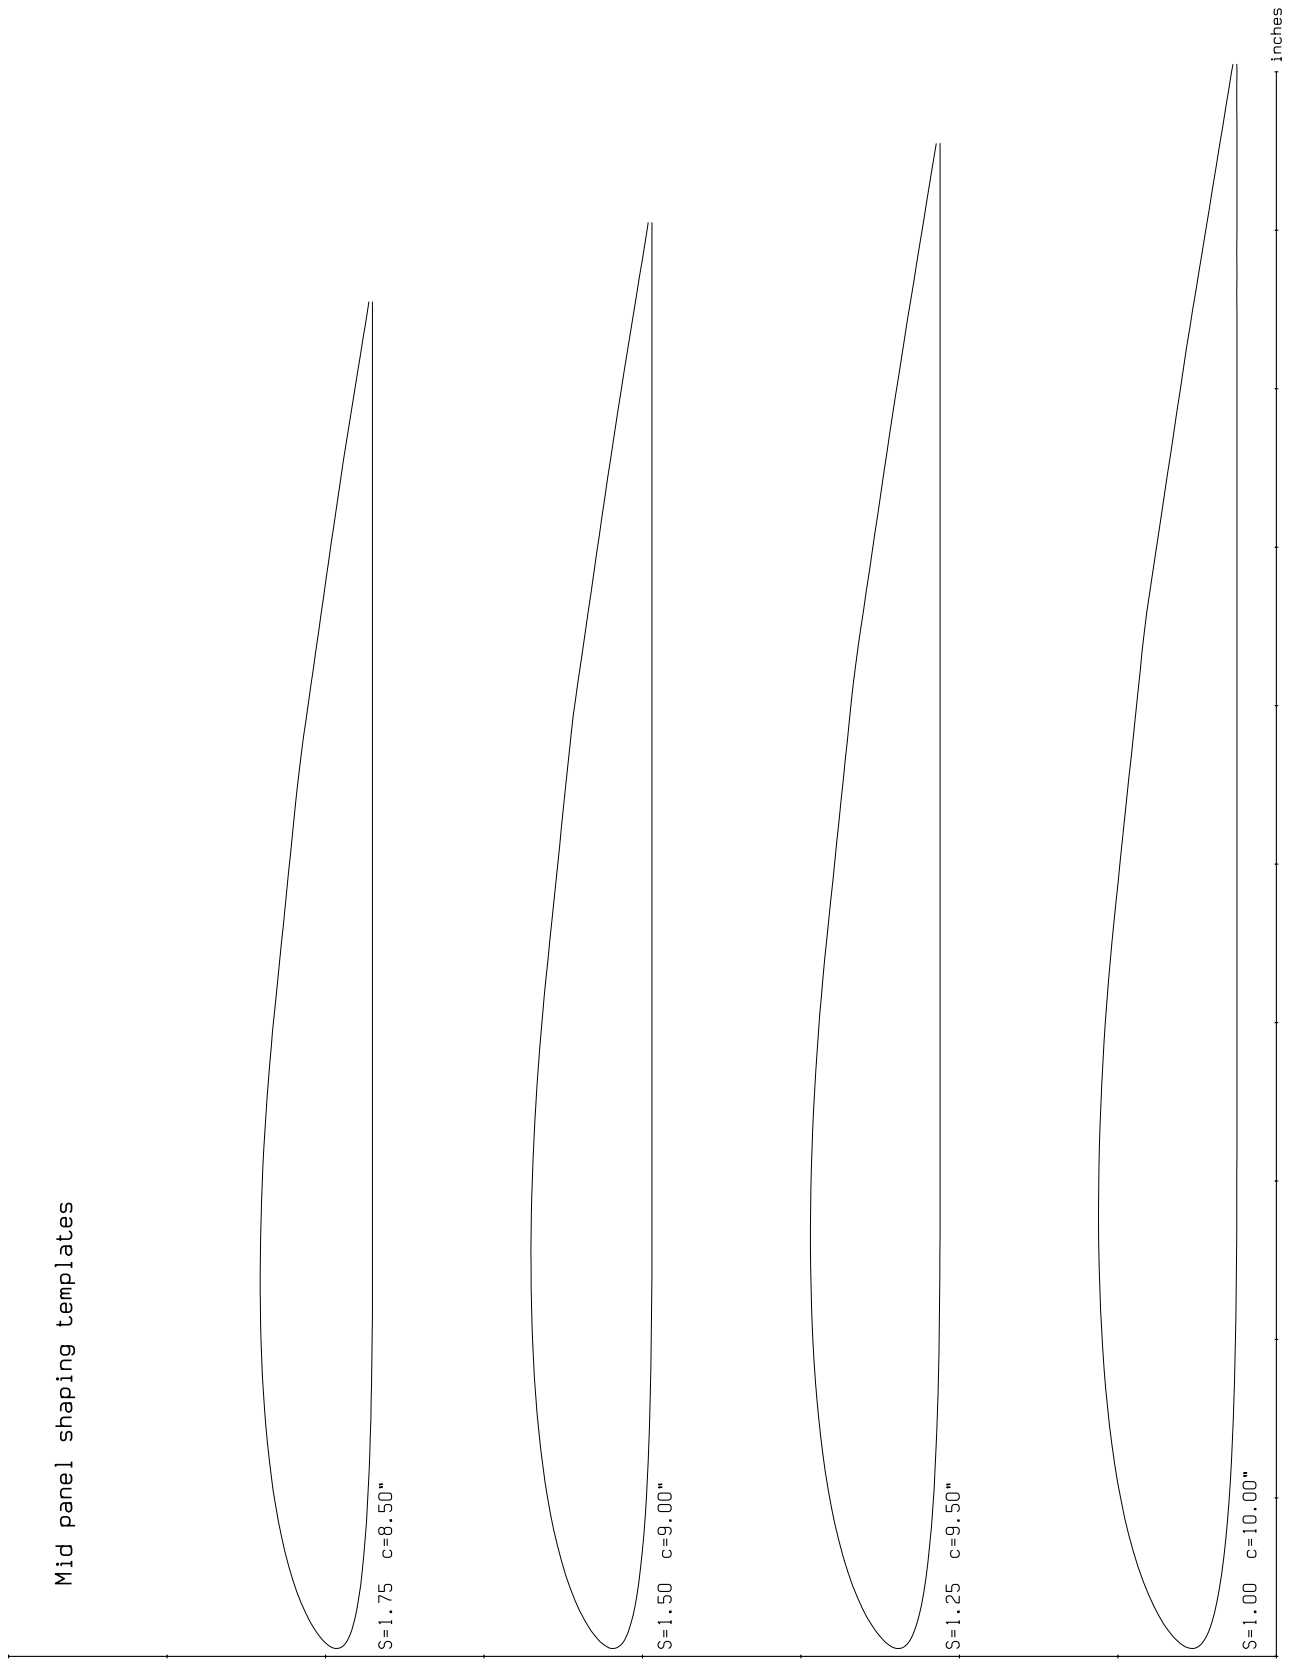
[picture p428: page 1]
