duanebeck/Allegro-Lite/Bubble Dancer/Ribs/tip_ribs.pdf

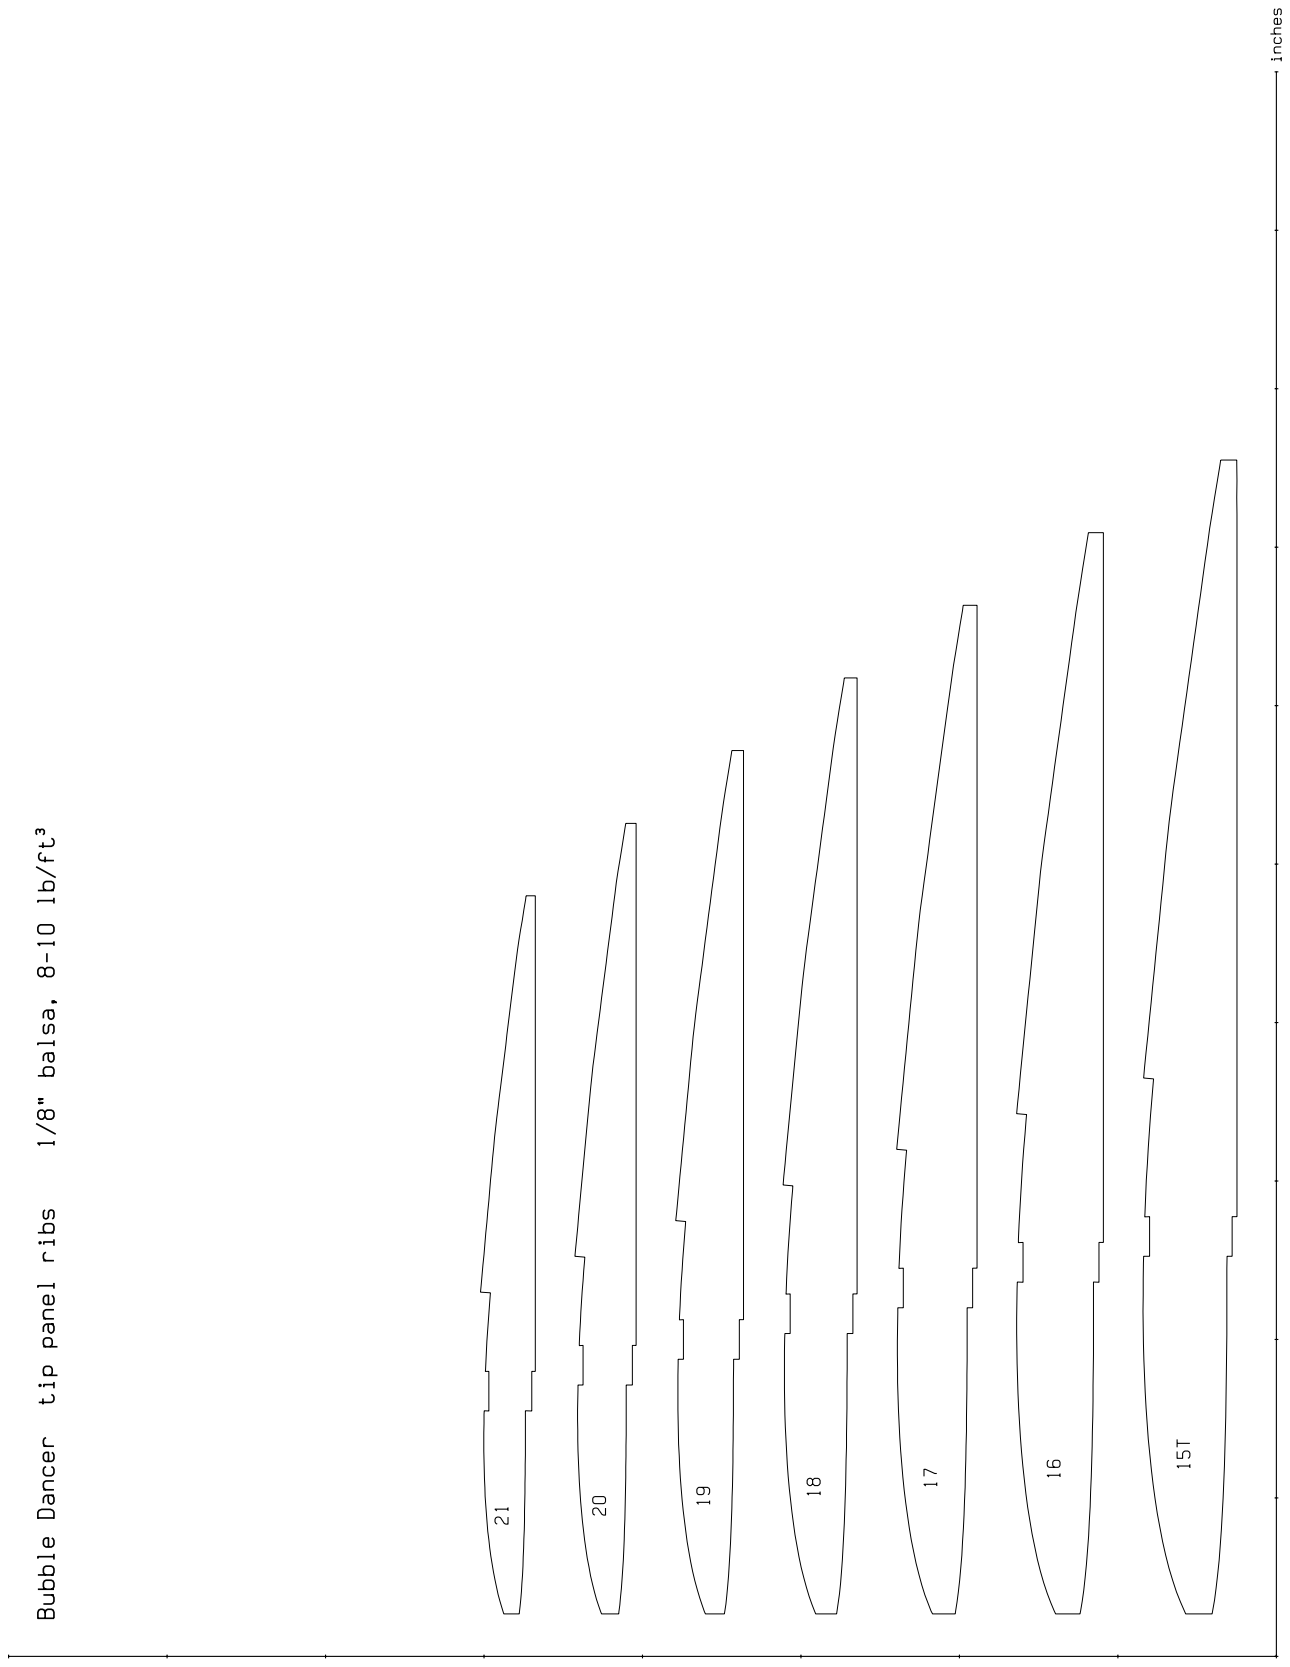
[picture p429: page 1]
