duanebeck/Allegro-Lite/Bubble Dancer/Ribs/tip_temp.pdf

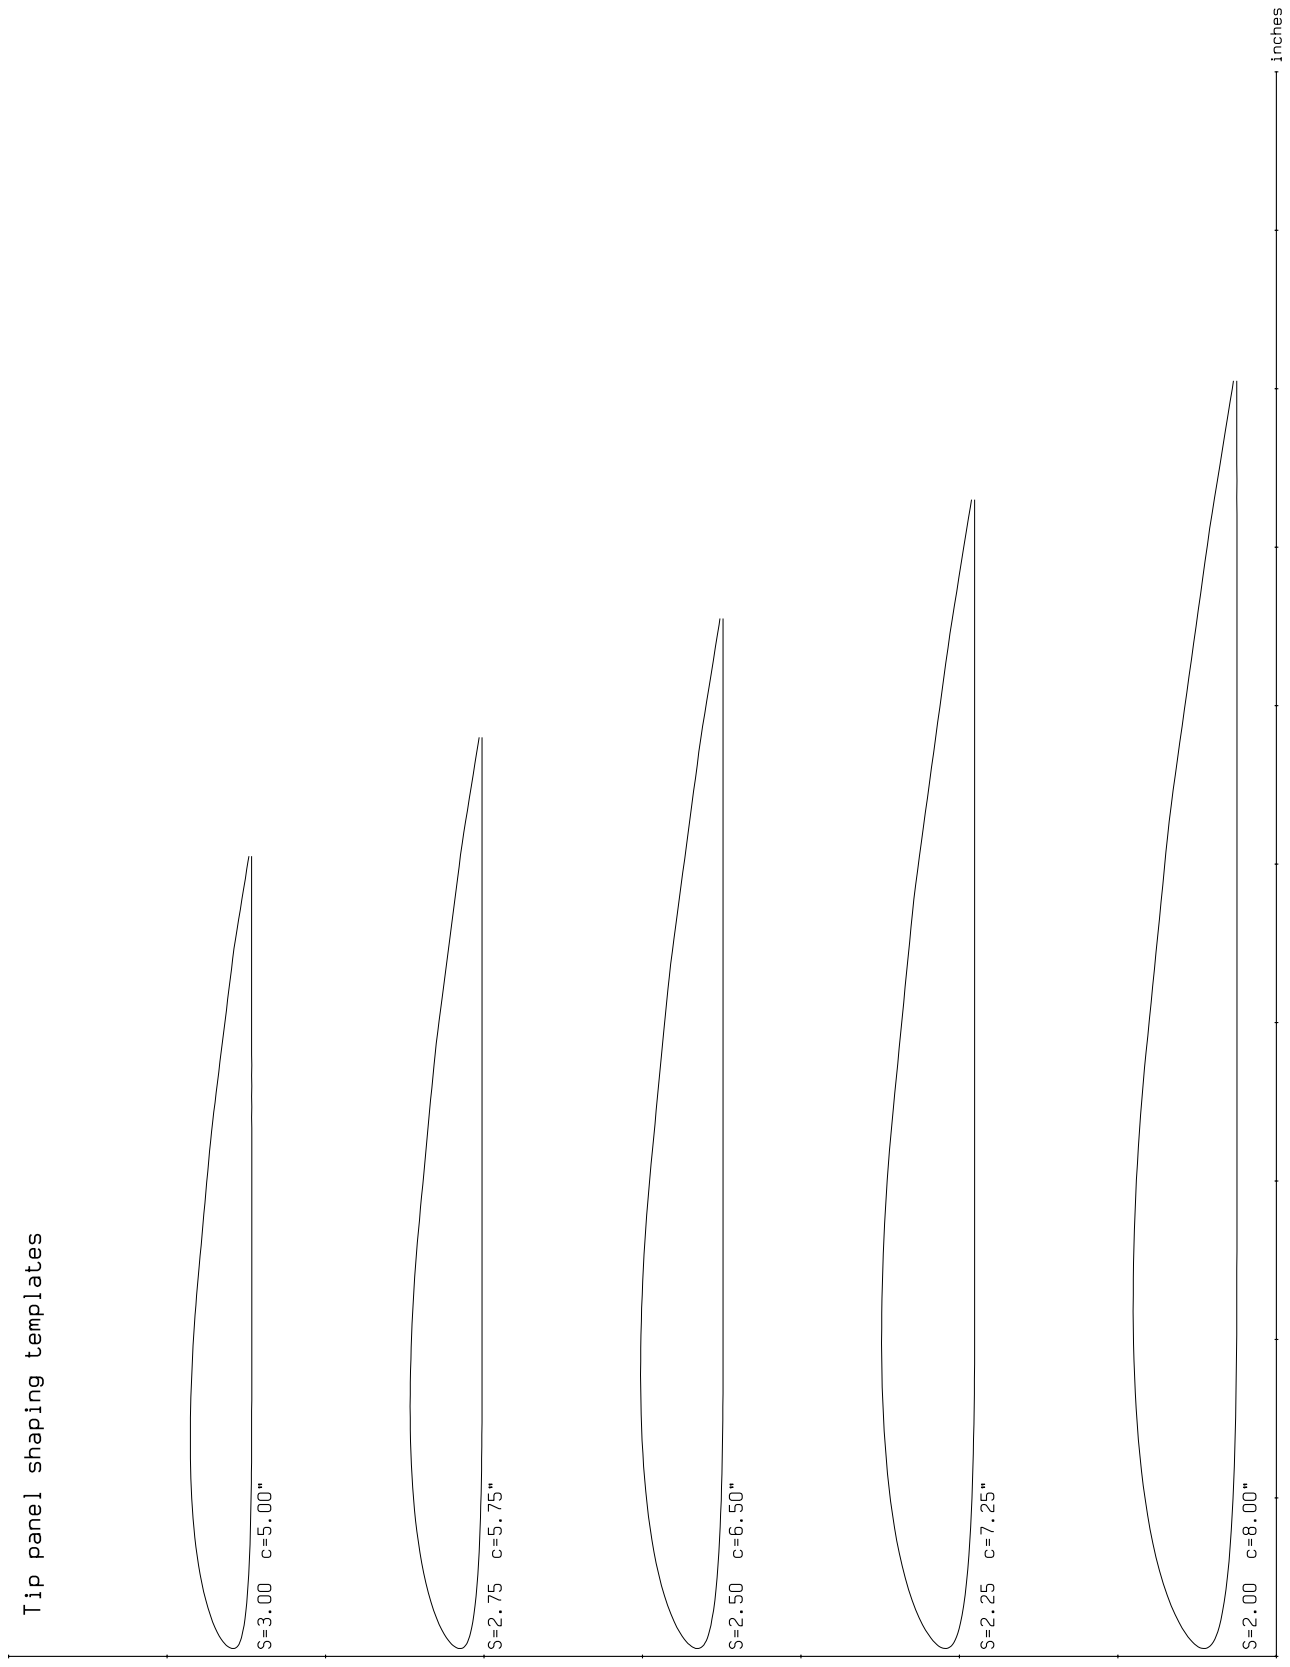
[picture p430: page 1]
