duanebeck/Allegro-Lite/Bubble Dancer/bd_V2.pdf

# Bubble Dancer RES 1:12 scale

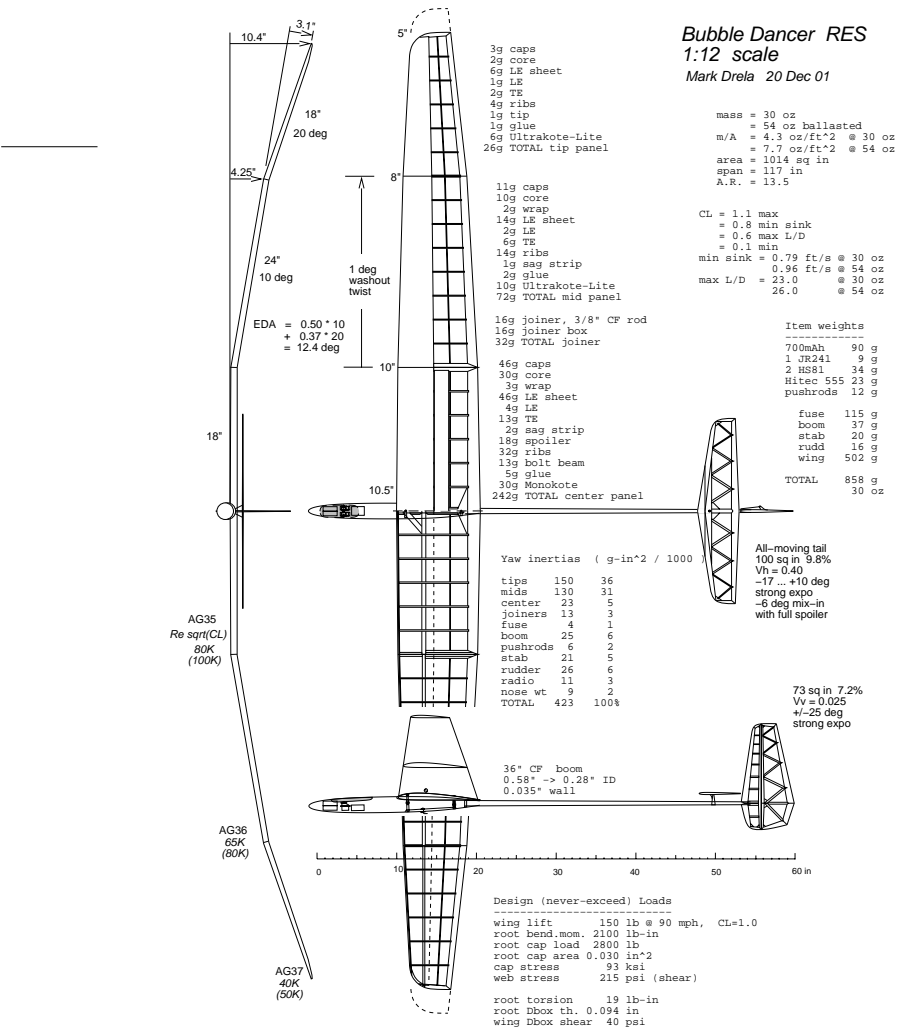
[picture p431: page 1]
10 deg; 20 deg; 73 sq in 7.2% Vv = 0.025 +/−25 deg strong expo; Re sqrt(CL); EDA = 0.50 * 10 + 0.37 * 20 = 12.4 deg; 3g caps 2g core 6g LE sheet 1g LE 2g TE 4g ribs 1g tip 1g glue 6g Ultrakote−Lite 26g TOTAL tip panel; 36" CF boom 0.58" −> 0.28" ID 0.035" wall; 1 deg washout twist; max L/D = 23.0; 11g caps 10g core 2g wrap 14g LE sheet 2g LE 6g TE 14g ribs 1g sag strip 2g glue 10g Ultrakote−Lite 72g TOTAL mid panel; wing lift; 150 lb @ 90 mph, CL=1.0; cap stress; 93 ksi; web stress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

Mark Drela 20 Dec 01

mass = 30 oz
= 54 oz ballasted
area = 1014 sq in
span = 117 in

CL = 1.1 max
= 0.8 min sink
= 0.6 max L/D
= 0.1 min
min sink = 0.79 ft/s @ 30 oz

16g joiner, 3/8" CF rod
16g joiner box
32g TOTAL joiner

All−moving tail
−17 ... +10 deg
strong expo
−6 deg mix−in
with full spoiler

Yaw inertias ( g−in^2 / 1000 )

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

root Dbox th. 0.094 in
wing Dbox shear 40 psi
